thiagopari/fox_rl_model/README.md

# Fox quadruped — RL-ready model

Link-ready model of the Fox quadruped (Fusion design `Fox_Prototype_03_v6`) for reinforcement learning in **MuJoCo** and
**Isaac Sim / Isaac Lab**, with the real leg mechanism: three servos per leg, a 1:1 gear pair, a parallelogram linkage
and a foot four-bar. Generated 2026-10-06 from the design copy `Fox_Prototype_03_v6_RL` (v14). The original design was never
modified. Previous checkpoint (screw-consistent serial model): git tag `checkpoint-screw-links`.

## The leg mechanism (what each servo does)
Per leg, three DS-843MG servos sit in the hip bracket:
* **Hip servo** (servo 3, inboard): turns the whole leg about its own spline axis = abduction. The axes are tilted in the CAD:
  front (0.985, 0, −0.174), rear (0.940, 0, 0.342).
* **Pivot servo** (servo 2, "adjacent"): its spline carries the **femur** (hip axis H); it is not attached to the gear.
* **Gear servo** (servo 1, "outer", the front-most on FL): its spline carries a 12-tooth pinion that drives a 12-tooth gear on the same hip axis H
  (module 1.5 mm, centre distance 18.00 mm, so **1:1, opposite direction**; the CAD names it "15 teeth", the geometry has
  12). The gear's crank arm (H→Q1, 15 mm) moves the **Quad Link** (Q1→Q2, 75 mm) which moves the **tibia** at Q2.
  Hip–crank–Quad Link–knee is an exact **parallelogram** (femur 75.0 mm = Quad Link, crank 15.0 mm = tibia offset), so the
  shin always keeps the crank's angle.
* **Foot**: hangs from the ankle and is steered by a second loop. On the rear legs it is a parallelogram with the
  Calf Link, so the foot stays parallel to the femur. On the front legs, Component77 forms a non-parallel four-bar:
  foot angle relative to the tibia = f(knee) ≈ 0.359·knee − 0.155·knee².

Servo map (pitch angles about +y, zero = CAD stance): **thigh = pivot, knee = −gear − pivot, foot = f(knee)**. So:
* the **gear servo alone** swings the shin (and foot) about the knee, like a pendulum; with the pivot servo unpowered it
  swings the whole leg (that is what Fusion shows when you drag it);
* the **pivot servo alone** turns the femur while the shin keeps its angle: the knee bends, the leg extends/retracts;
* **pivot +a with gear −a** swings the whole leg rigidly about the hip.

| Command (body held, pivot / gear servo) | Femur | Shin | Knee | FL foot: swing / extension | RL foot: swing / extension |
|---|---|---|---|---|---|
| gear servo +0.3 (pivot holds) | -0.00 | -0.30 | -0.30 | -0.183 rad / -15.5 mm | -0.101 rad / +16.1 mm |
| pivot servo +0.3 (gear holds) | +0.30 | -0.00 | -0.30 | +0.117 rad / -15.5 mm | +0.199 rad / +16.1 mm |
| pendulum: pivot +0.3, gear -0.3 | +0.30 | +0.30 | -0.00 | +0.300 rad / -0.0 mm | +0.300 rad / +0.0 mm |

Knee range is limited where a loop would reach a dead point (pins in line, 10° margin): rear knee
[-1.2, 0.74] rad (the rear foot parallelogram folds at +0.92 rad), front ±1.2 rad (placeholder).

## Contents
| Path | What |
|---|---|
| `mjcf/fox.xml`, `mjcf/scene.xml` | **exact mechanism** for MuJoCo: 33 bodies, 32 hinges, the 8 loop pins as `<connect>`, the 4 gear pairs as joint equalities, 12 position servos (`XX_hip`, `XX_pivot`, `XX_gear`), IMU site/sensors; scene with floor |
| `mjcf/fox_reduced.xml`, `scene_reduced.xml` | the same robot as a tree (17 bodies): gear servo on a fixed tendon (−thigh − calf), foot via a four-bar joint equality; matches the exact model |
| `urdf/fox.urdf` | that tree for Isaac (URDF cannot hold loops): 17 links, 16 revolute joints; foot joints are `<mimic>` of the knee |
| `usd/fox.usd` | Isaac Sim 6.0.1 import of the URDF (foot drives zeroed, mimics kept as `NewtonMimicAPI`) |
| `isaaclab/fox_cfg.py` | Isaac Lab `ArticulationCfg` + `FoxServoActuator`: targets on hip/thigh/calf joints are the hip/pivot/gear **servo** angles; `FOX_SERVO_REAL_CFG` adds latency, backlash and the torque-speed line |
| `isaaclab/fox_sim.py` | launches the robots in Isaac Lab (GUI or headless) and drives the servos |
| `isaaclab/fox_tasks.py`, `fox_mdp.py`, `fox_train.py`, `fox_play.py` | RL walking tasks (`Fox-Velocity-Flat`, hardware-ready `Fox-Velocity-Flat-Blind`), PPO training, keyboard driving + eval |
| `deploy/fox_calib.py` | interactive servo calibration over SSH (angles, home, range, direction, channel → `servo_calib.json`) |
| `deploy/fox_pi.py` | runs a policy on the robot: Raspberry Pi + BNO055 + PCA9685, 50 Hz, keyboard over SSH; calibration modes |
| `policies/` | trained policies (`fox_flat_v1`, `fox_flat_blind_v1`…`v4` for the 1:1 robot; `fox_v7_straight_v1` for the 2:1 robot, forward / backward), each with its ONNX export and config (v7: + `policy.json`) |
| `mechanism.json` | servo map, four-bar fits, knee ranges |
| `meshes/visual`, `meshes/collision` | per-part (`XX_femur.stl`…) and per-tree-link (`XX_thigh_reduced.stl`…) meshes, metres |
| `print/FL_gear.stl` | the FL gear (CAD body "Spur Gear (15 teeth):2"), print-ready: mm, crank-arm face flat on the bed, gear centre at x = y = 0 |
| `raw/` | raw Fusion export (per-part STLs + `raw.json` with masses, inertia, 40 joints, motion links) |
| `analysis/` | hole/pin scan of the CAD (`screw_scan.json`) and the part map (`link_map.json`) |
| `tools/` | `screw_graph.py`, `build_robot.py`, MuJoCo + Isaac checks, `check_policy_io.py` (the Pi's policy interface), Fusion add-ins |
| `validation/` | reports + renders |
| `v7/`, `raw_v7/`, `print/v7_*.stl` | the v7 design (see "v7: mechanical improvements"): model folder (URDF, MJCF, meshes, `mechanism.json` with its level stance, validation), raw Fusion export, print-ready new parts |

Fusion documents (cloud, work › Default Project):
* `Fox_Prototype_03_v6` — original, untouched.
* `Fox_Prototype_03_v6_RL` — design copy with the fixes (mirrored front leg, rear gear pair, servos, restored tibias, Component77).
* `Fox_Prototype_03_v6_RL_Mechanism` — **current model**: 33 components (base + per leg hip, pinion, gear, femur, quad,
  tibia, foot, link), 40 as-built revolute joints (per leg `hip_joint`, `femur_joint` = pivot servo, `pinion_joint` = gear
  servo + 7 free pins, two of them closing the loops) and 4 motion links (pinion → gear, 1:1 reversed). Drag `XX_pinion_joint`
  to swing the leg; to see the pivot servo extend the leg, **lock `XX_pinion_joint`** (right-click → Lock) and drag
  `XX_femur_joint` — otherwise Fusion moves both servos together and the leg just swings.
* `Fox_Prototype_03_v7_RL` — **v7 design** (2026-10-08): the `_RL` copy with the mechanical improvements below; awaiting review.
* `Fox_Prototype_03_v7_RL_Mechanism` — v7 jointed model: same 40 joints, motion links pinion → gear **2:1** reversed.
* `Fox_Prototype_03_v6_RL_URDF_v2` — checkpoint: screw-consistent serial model (no gear relation).
* `Fox_Prototype_03_v6_RL_URDF` — first model, superseded; safe to delete.

## Conventions
* Frame: **x forward** (IMU end), **y left**, **z up**; base origin midway between the four hips at hip-axis height.
* Zero = the CAD standing pose for every servo and joint; the base origin is **0.1528 m** above the ground there.
* Legs FL, FR, RL, RR. Total mass **542.6 g** (no battery yet).

## Reduced tree (URDF / Isaac): joints and masses
| Joint | Parent → child | Axis | Origin in parent (m) | Limits (rad) | Effort (N·m) |
|---|---|---|---|---|---|
| FL_hip_joint | base → FL_hip | (0.985, 0, -0.174) | 0.071686 0.024238 0.007390 | -0.50 … 0.50 | 0.470 |
| FL_thigh_joint | FL_hip → FL_thigh | +y | 0.013073 0.017273 -0.002610 | -1.20 … 1.20 | 0.940 |
| FL_calf_joint | FL_thigh → FL_calf | +y | -0.026269 0.000000 -0.070249 | -1.20 … 1.20 | 0.470 |
| FL_foot_joint | FL_calf → FL_foot | +y | 0.005365 0.002750 -0.067459 | -3.14 … 3.14 | 10.000 |
| FR_hip_joint | base → FR_hip | (0.985, 0, -0.174) | 0.071686 -0.024262 0.007390 | -0.50 … 0.50 | 0.470 |
| FR_thigh_joint | FR_hip → FR_thigh | +y | 0.013073 -0.017248 -0.002610 | -1.20 … 1.20 | 0.940 |
| FR_calf_joint | FR_thigh → FR_calf | +y | -0.026269 0.000000 -0.070249 | -1.20 … 1.20 | 0.470 |
| FR_foot_joint | FR_calf → FR_foot | +y | 0.005365 -0.002750 -0.067459 | -3.14 … 3.14 | 10.000 |
| RL_hip_joint | base → RL_hip | (0.940, 0, 0.342) | -0.073606 0.024238 -0.000351 | -0.50 … 0.50 | 0.470 |
| RL_thigh_joint | RL_hip → RL_thigh | +y | -0.012394 0.017273 -0.004429 | -1.20 … 1.20 | 0.940 |
| RL_calf_joint | RL_thigh → RL_calf | +y | 0.038069 0.001750 -0.064620 | -1.20 … 0.74 | 0.470 |
| RL_foot_joint | RL_calf → RL_foot | +y | -0.052566 0.001000 -0.053496 | -3.14 … 3.14 | 10.000 |
| RR_hip_joint | base → RR_hip | (0.940, 0, 0.342) | -0.073382 -0.024238 -0.000188 | -0.50 … 0.50 | 0.470 |
| RR_thigh_joint | RR_hip → RR_thigh | +y | -0.012618 -0.017522 -0.004593 | -1.20 … 1.20 | 0.940 |
| RR_calf_joint | RR_thigh → RR_calf | +y | 0.038069 -0.001500 -0.064620 | -1.20 … 0.74 | 0.470 |
| RR_foot_joint | RR_calf → RR_foot | +y | -0.052566 -0.001000 -0.053496 | -3.14 … 3.14 | 10.000 |

| Link (URDF) | Parts | Mass (g) |
|---|---|---|
| base | base | 330.4 |
| FL_hip | hip, pinion, gear | 34.4 |
| FL_thigh | femur, quad | 7.5 |
| FL_calf | tibia, link | 7.8 |
| FL_foot | foot | 2.5 |
| FR_hip | hip, pinion, gear | 34.4 |
| FR_thigh | femur, quad | 7.5 |
| FR_calf | tibia, link | 8.2 |
| FR_foot | foot | 2.5 |
| RL_hip | hip, pinion, gear | 34.9 |
| RL_thigh | femur, quad | 7.8 |
| RL_calf | tibia, link | 7.4 |
| RL_foot | foot | 3.1 |
| RR_hip | hip, pinion, gear | 36.4 |
| RR_thigh | femur, quad | 7.7 |
| RR_calf | tibia, link | 7.0 |
| RR_foot | foot | 3.0 |

Parts of one leg in the exact model (`mjcf/fox.xml`):

| Part (MJCF body) | Mass (g) |
|---|---|
| base | 330.45 |
| FL_hip | 29.64 |
| FL_pinion | 2.28 |
| FL_gear | 2.52 |
| FL_femur | 4.89 |
| FL_quad | 2.61 |
| FL_tibia | 5.49 |
| FL_foot | 2.52 |
| FL_link | 2.35 |

## How the CAD maps to parts
Membership follows the fasteners (`tools/screw_graph.py` on a scan of every hole, pin and spline): parts that share a
screw line, or sit on a servo's output spline, are one rigid part; leg-linkage pins and spline axes are pivots.
* **base**: both pelvis halves, Pi mount, Raspberry Pi 4, 12-ch PWM board, 2× XL4015, Arduino Nano, BNO055, the bodies of
  the 4 hip servos, and everything screwed to them.
* **XX_hip**: the bracket riding on the hip-servo spline (front `Servo Pelv Upper/Lower(Mirror)`, rear left `Servo Pelv
  Upper`, rear right `Component40/41(Mirror) (1)`), rear caps `Body28`/`Body29` (+ `Body27`, by contact), both servo cases.
* **XX_pinion**: gear-servo spline + `m` gear. **XX_gear**: the 12-tooth gear with its crank arm.
* **XX_femur**: femur + pivot-servo spline + the gear's spacer and washer (clamped by the horn screw `Body4`, rear left).
* **XX_quad**: Quad Link. **XX_tibia**: tibia + knee pin (`Body2` rear left). **XX_foot**: foot + pad.
  **XX_link**: Component77 (front) / Calf Link (rear).
* In the tree model: hip = hip + pinion + gear, thigh = femur + Quad Link, calf = tibia + link, foot = foot.

## Modelling decisions (review)
1. **Abduction axis** = the hip-servo spline axis measured from the CAD (tilted 10° front / 20° rear from +x).
2. **Rear brackets un-joined**: `Combine1`/`Combine2` of `Component41(Mirror) (1)` and `Combine2` of `Servo Pelv Upper` join
   both rear brackets into the pelvis in the design copy; the builders suppress them **in memory only**.
3. **Limits are placeholders**: servos ±1.2 rad (hip ±0.5), knee capped by the loop dead points (above). Measure the real
   servo travel (DS-843MG ~±60°) and mechanical stops.
4. **Actuators**: DS-843MG at 6 V, 0.47 N·m stall, 10.5 rad/s; PD kp 5.0 / kd 0.08 per servo (a hobby servo reaches
   stall within ~5° of error), armature 5e-4 (estimate). The first guess, kp 2.0, was too soft: randomized robots tipped
   over just standing. The robot sags 4.7 mm when standing. Replace with bench-test values (step response) before
   sim-to-real.
5. **Isaac foot mimic** is the linear part of the four-bar: exact on the rear; front error 0.015 rad within ±0.3 rad of
   knee motion, 0.06 rad at ±0.6, 0.27 rad at ±1.2 (the MuJoCo models use the full quartic).
6. **Battery**: hidden in the CAD, not modelled. Add its mass to `base` when known.
7. **No joint damping/friction/armature in the URDF** (Isaac's importer writes URDF damping into the per-degree USD
   field); they live in `isaaclab/fox_cfg.py` and the MJCF defaults. The URDF thigh effort limit is 0.94 N·m (= pivot −
   gear torque) so PhysX does not clip the mapped torque.
8. **Loops in MuJoCo** use near-hard constraints (`solimp 0.999`): with the default the 2–3 g linkage parts let the pins
   gap 2 mm under load.

## Use
* **MuJoCo** (exact): `~/.venvs/fox_rl/bin/python -m mujoco.viewer --mjcf ~/Documents/fox_rl_model/mjcf/scene.xml`.
  Actions = 12 servo targets (`XX_hip`, `XX_pivot`, `XX_gear`), i.e. what the real servos get. Ramp large changes: a
  step on all 12 servos saturates them together and the robot can hop and flip.
* **Isaac Sim** (`~/isaacenv`, 6.0.1): `OMNI_KIT_ACCEPT_EULA=YES ~/isaacenv/bin/python tools/isaacsim_import.py`, then
  `tools/isaacsim_stand_test.py` (servo PD applied with `set_dof_efforts`, two robots: standing + bolted in the air).
* **Isaac Lab** (installed: `~/IsaacLab`, tag `v3.0.0-beta2.patch1` = the release for Isaac Sim 6.0.1, pip-installed
  into `~/isaacenv` with torch 2.11+cu130 kept): `~/isaacenv/bin/python isaaclab/fox_sim.py --viz kit` opens the viewer
  with 4 robots, one servo motion each (crouch, sway, pendulum swing, shin swing); `--headless --duration 10` for a quick
  check. In your own tasks: `from fox_cfg import FOX_CFG`; joint position actions on `.*_hip_joint`, `.*_thigh_joint`,
  `.*_calf_joint` are servo targets (hip, pivot, gear); `FoxServoActuator.servo_angles()` gives the servo angles from
  joint angles for observations. Velocity task: base `base`, feet `.*_foot`, undesired contacts `.*_thigh|.*_calf`,
  small commands (≈0.3 m/s), target height ~0.14 m. Notes for this laptop (8 GB GPU): Isaac Lab 3.0 runs headless
  unless `--viz kit` is given; keep the Kit window small (full screen at 3200x2000 renders ~1.7 s/frame — the script
  defaults to 1280x800); the first GUI launch compiles shaders for minutes; close other GPU apps (Fusion) if RTX runs
  out of memory; PhysX GPU buffers are shrunk in `fox_sim.py` (the defaults reserve ~1 GB); don't switch "Simulation
  Output" to USD in the GUI (deadlocks Isaac Sim 6.0.1).
* Hardware: send pivot = thigh, gear = −thigh − knee (radians from the stance, then your servo's zero/scale/direction).

## RL walking + keyboard teleop (Isaac Lab)
* Task `Fox-Velocity-Flat` (`isaaclab/fox_tasks.py`): Isaac Lab's quadruped velocity task (Go1 recipe) on flat ground,
  re-scaled for this robot: actions = the 12 servo targets (±0.25 rad around the stance), commands vx ±0.3 m/s,
  vy ±0.2 m/s, yaw ±1 rad/s, 50 Hz policy / 200 Hz physics, mass +0.2 kg / COM / friction / push randomization.
  Changes that made it learn: a fall penalty + small alive bonus, a 10× smaller joint-acceleration penalty (the 2–3 g
  links accelerate a lot), initial action noise 0.5 (1.0 knocks the robot over in 0.5 s), stiffer servos (above).
* Train (headless, ~15 min for 1000 iterations on this laptop, 2048 robots):
  `cd ~/Documents/fox_rl_model && ~/isaacenv/bin/python isaaclab/fox_train.py --task Fox-Velocity-Flat --headless`
  → `logs/rsl_rl/fox_flat/<date>/model_*.pt` (TensorBoard: `logs/rsl_rl/fox_flat`).
* Hardware-ready task `Fox-Velocity-Flat-Blind`: the policy sees only what the robot has (IMU gyro + gravity direction,
  the remote's command, its own last servo commands, 5-step history); the critic sees the full state (training only).
  Gait rewards: action-rate penalty, diagonal trot (Spot's `GaitReward`), Spot's `air_time_reward` (each foot phase
  ~0.15 s; zero command = all feet down, even when drifting). `fox_train.py --task Fox-Velocity-Flat-Blind --headless`, ~30 min.
* Since v3 the blind task (training, play and eval) uses realistic servos, `FOX_SERVO_REAL_CFG`, each drawn at random
  per robot and episode:
  * 5–25 ms command latency (Pi → PCA9685 at 50 Hz → servo, sensor lag included);
  * backlash up to 0.02 rad on the hip and pivot servos, and 0.15 rad on the gear servo. On RR, measured 2026-10-08 with
    `deploy/fox_leg_modes.py`, the gear servo turns 10–15° before the shin moves (about ±6° of play, from the gear pair,
    horn and linkage pins). Policies trained before then (v1–v4) saw only 0.04 rad;
  * torque that falls linearly from the stall torque at rest to zero at the no-load speed (DS-843MG: 0.47 N·m, 10.5 rad/s);
  * servo gains off by up to ±20 % (kp) and ±30 % (kd).

  These are estimates: put bench-test values into `fox_cfg.py`. The ideal servo (`FOX_SERVO_CFG`) stays in `Fox-Velocity-Flat`.
* Since v4, forward / backward / standing commands (no sideways, no turning) leave the hips alone: the hip servo targets
  are held at the stance (`fox_mdp.FoxServoAction`; `deploy/fox_pi.py` applies the same rule), and the policy observes
  them as sent. 30 % of training commands are straight (`fox_mdp.FoxVelocityCommand`; uniform sampling never gives
  exact zeros). v4 = v3 fine-tuned under this rule for 1000 iterations (plateaued after ~300).
* Drive: `~/isaacenv/bin/python isaaclab/fox_play.py --checkpoint policies/fox_flat_blind_v4/model_2998.pt` → click the
  viewport, hold W/S (forward/back), A/D (sideways), Q/E (turn), L = stop; the camera follows the robot. For v1 add
  `--task Fox-Velocity-Flat-Play`. `--eval --headless --num_envs 16` prints commanded vs achieved velocities instead.
  It also exports `exported/policy.onnx` next to the checkpoint (for the Pi).
* Policies (`policies/*`: `model_*.pt`, `policy.onnx` for the Pi, `params/` = exact env + agent config), `--eval` results
  (16 robots, 7 commands × 4 s, mean |error| over the last 2 s of each):

  | Policy | Policy sees | Eval servos | Error vx / vy / yaw | Servo-command change | Swing | At zero command |
  |---|---|---|---|---|---|---|
  | `fox_flat_v1` | joint encoders + body velocity | ideal | 0.008 / 0.008 m/s / 0.014 rad/s | 0.082 rad/step | 0.072 s | steps 3.4/s, holds position |
  | `fox_flat_blind_v1` | IMU only | ideal | 0.011 / 0.019 / 0.027 | 0.067 | 0.075 s | marches 7.4/s, drifts 8 cm/s |
  | `fox_flat_blind_v2` | IMU only | ideal | 0.006 / 0.007 / 0.037 (under-turns 12 %) | 0.059 | 0.107 s | stands (1.4 steps/s, 0.2 cm/s) |
  | `fox_flat_blind_v2` | IMU only | realistic | 0.016 / 0.010 / 0.042 (0.3 → 0.26 m/s, 0.8 → 0.68 rad/s) | 0.059 | 0.104 s | stands (2.3 steps/s) |
  | `fox_flat_blind_v3` | IMU only | realistic | 0.008 / 0.006 / 0.025 (0.3 → 0.27 m/s, 0.8 → 0.83 rad/s) | 0.042 | 0.132 s | stands (0.5 steps/s, 0.2 cm/s) |
  | **`fox_flat_blind_v4`** | IMU only | realistic, hips held when straight | 0.023 / 0.006 / 0.026 (0.2 → 0.16, 0.3 → 0.23 m/s; 0.8 → 0.79 rad/s) | 0.040 | 0.137 s | stands (0.7 steps/s) |
  | **`fox_v7_home_v1`** (2:1 robot, around home) | IMU only | realistic, hips always held | 0.020 m/s / – / 0.042 (forward / backward only: 0.2 → 0.203, 0.3 → 0.247, −0.2 → −0.218 m/s) | 0.094 | 0.112 s | shuffles in place (3.1 steps/s) |
  | `fox_v7_straight_v1` (2:1 robot) | IMU only | realistic, hips always held | 0.025 m/s / – / 0.019 (forward / backward only: 0.2 → 0.175, 0.3 → 0.247, −0.2 → −0.219 m/s) | 0.069 | 0.100 s | shuffles in place (2.4 steps/s, 6 mm lifts, ≤ 2 cm drift in 4 s) |

  No policy fell in any eval. `fox_v7_straight_v1` is scored on its four straight commands (`fox_play.py --eval` skips
  what a task does not train). Why each version changed:
  * Blind v1 trotted at 7 Hz. The trot term's timing error is in seconds, so short phases score best, and its
    step-length term was mostly silent (bug below).
  * v2's first try drifted at 0.13 m/s at zero command, just above the 0.1 m/s "moving" threshold, to keep the
    walking rewards. The threshold is now 1.0 m/s.
  * v3 was trained on realistic servos with a tighter yaw term (weight 1.0, std 0.3), for 2000 iterations.
  * v4: when walking straight, the hip target is exactly 0 and the hip joint moves ≤ 0.043 rad (gear play and the
    servo yielding under load). The cost: forward is ~20 % slower than v3. v3 with the hips simply locked made only
    0.09 m/s at 0.2 and fell 9 times.
  * The top speed of about 0.27 m/s is the speed-limited servos: v2 loses 15 % of its speed on them.
* Running a blind policy on the Pi (`policy.onnx`, 105 inputs → 12 outputs, no input normalization):
  * Observation: for each term, its last 5 readings, oldest first, terms in this order:
    * `[0:15]` gyro (rad/s);
    * `[15:30]` gravity direction as a unit vector, (0, 0, −1) standing level. An accelerometer or the BNO055 gravity
      output reads +z when level, so negate and normalise it;
    * `[30:45]` command (vx, vy m/s, yaw rate rad/s);
    * `[45:105]` the policy's own previous 12 outputs.
  * Frames are body frame: x forward, y left, z up (rotate the IMU's axes into it). At start, fill the history with
    the first reading 5 times.
  * Outputs: servo target = 0.25 × output (rad from the CAD stance), in this order: hip FL, FR, RL, RR, then pivot
    FL…RR, then gear FL…RR. Then apply each servo's zero, direction and µs/rad.
  * When the command has no sideways or turn part, the hip outputs are set to 0 (v4 on). That applies both to what is
    sent and to what goes into the observation history.
  * `deploy/fox_pi.py`'s `FoxPolicy` implements exactly this. `tools/check_policy_io.py <model.pt>` runs it closed
    loop in Isaac Lab: the sim supplies the readings and FoxPolicy's outputs drive the robot. For v4: identical
    observation, ONNX = PyTorch within 3.6e-7, and it walks 0.17 m/s (cmd 0.2) and turns 0.59 rad/s (cmd 0.6).
* Isaac Lab 3.0-beta2 bug: `ContactSensor.compute_first_contact` never fires 2–16 s into an episode (float32 sensor time
  vs a 1e-8 tolerance), so the stock `feet_air_time` reward (still in `Fox-Velocity-Flat`) is silent most of each
  episode. The blind task uses `air_time_reward` instead, and `--eval` counts touchdowns from contact-state changes.
* Body names: feet `.*_foot`, undesired contacts `.*_thigh|.*_calf`; the USD's bodies are flattened (Isaac Lab's
  contact sensor only sees direct children of one parent; the Isaac Sim 6 importer nests them).

## On the robot (Raspberry Pi)
Status: verified only against the simulator (`tools/check_policy_io.py`); it has not run on the Pi or the servos yet.
0. **Setup, once:**
   * **OS:** 64-bit Raspberry Pi OS (`uname -m` prints `aarch64`), which has onnxruntime wheels. Without
     onnxruntime the script falls back to `onnx`'s slower reference evaluator.
   * **I2C:** enable it (`sudo raspi-config` → Interface Options → I2C). `i2cdetect -y 1` must show `28` (BNO055)
     and `40` (PCA9685).
   * **Python:** the environment `~/robofox_leg_imu_calibration.py` ran in (Blinka, `adafruit-circuitpython-pca9685`,
     `-bno055`, `-motor`), plus `pip install numpy onnxruntime`. On Bookworm, use a venv:
     `python3 -m venv --system-site-packages ~/fox`.
   * **Power:** the servos get their own 6 V supply into the PCA9685's V+ terminal, never the Pi's 5 V pin. Budget
     about 1 A per servo at peak, and share ground with the Pi. The policy was trained on the 6 V torque and speed;
     brown-outs reset the Pi and the PCA9685.
   * **Copy:** `scp deploy/fox_pi.py policies/fox_flat_blind_v4/policy.onnx policies/fox_flat_blind_v4/policy.onnx.data
     pi@<pi>:~/fox/`. The `.data` file must sit next to the `.onnx`, and so must `policy.json` for policies that have
     one. Give each policy its own folder.
   * **policy.json** (written by `isaaclab/fox_play.py` with the ONNX) is the policy's contract:
     * servo target = offset + scale × output, per servo;
     * the gear ratio it was trained for: `fox_pi.py` refuses to run it on a robot whose `servo_calib.json` says
       otherwise;
     * its command ranges: the keyboard stays inside them, so the forward / backward policy only takes W/S.

     Policies without one (v1–v4) mean 0.25 × output around home, 1:1 gears.
   * **Smoke test:** `python3 fox_pi.py policy.onnx --dry-run` (no hardware) must report 0 steps over the 20 ms budget.
     On the robot it prints the same count. If the servo writes push the loop over budget, the I2C bus is too slow.
   * **v7 (2:1 robot):** `scp policies/fox_v7_home_v1/{policy.onnx,policy.onnx.data,policy.json} fox-wifi:fox/v7_home/` (the
     home-centred policy; `fox_v7_straight_v1` is in `~/fox/v7_straight/`). Re-level the IMU after rebuilding the casing
     (`fox_pi.py <policy> --level-imu 5`, body level and still). A 15° stale reference made the first ground run read
     8.8° nose-up, and the policy then held instead of stepping.
     Run `fox_calib.py --gear-ratio 2` once (done 2026-10-09). Then hold the robot and run
     `ssh -t fox-wifi 'cd ~/fox && venv/bin/python fox_pi.py v7_straight/policy.onnx'`:
     * W / S step the forward command by 0.05 m/s (±0.3), space stops, Ctrl-C goes limp. In the sim, 0.05 / 0.1 /
       0.15 give 0.038 / 0.093 / 0.137 m/s; backward overshoots at low speed (−0.05 gives −0.095). The legs step about 5
       times a second at any speed;
     * at start it waits for steady IMU readings, ramps the servos from home to the v7 stance over 1 s (rear legs ~25°
       back), and waits again;
     * IMU glitches are filtered: a reading that rotates faster than 15 rad/s, or turns gravity more than 30° in one
       step, is replaced by the last good one, at most twice in a row. On the stand the BNO055 gave single 35.6 rad/s
       and upside-down readings amid level ones, likely servo current spikes resetting its fusion. The run's last line
       counts them;
     * `fox_pi.py` refuses a stance a servo can't reach, and warns when a training range runs past 0 / 180°;
     * add `--seconds 20 --log run.csv` for a timed, logged run.
1. **Calibrate** with `fox_calib.py`, an interactive tool: `ssh -t fox-wifi 'cd ~/fox && venv/bin/python fox_calib.py'`.
   * **Moving:** select a servo, then arrows move it ±1° (A/D ±5°) and `g` types an exact angle.
   * **Recording:** `h` sets home (the CAD stance), `<` and `>` the safe range, `r` the direction, `#` the channel.
   * **Saving:** everything goes to `servo_calib.json` next to `fox_pi.py`, which loads it at start.
   * **Safety:** all servos are limp at start and on quit, and a servo's first move goes to its saved home.

   Hips: don't assume 90°. The RL hip's 90° was past its outward stop. The steps below fill in the same values:
   * `--check-imu`: fix `IMU_TO_BODY` until level reads gravity (0, 0, −1), nose down gives x > 0, left side down
     gives y > 0, and turning left gives gyro z > 0. The default assumes the January script's upside-down mount.
     The gyro must read rad/s: about one turn per second by hand should show ~6, not ~360 (old adafruit_bno055
     releases used deg/s). Frequent "no IMU reading" errors mean the BNO055's clock stretching is failing: lower the
     bus speed (`dtparam=i2c_arm_baudrate=50000` in `/boot/firmware/config.txt`).
   * `--wiggle FL_hip` (and the other 11), with the robot held in the air: if the wrong servo moves, fix `CHANNEL`
     (the hip/pivot/gear order inside each leg's block is a guess); if it moves the wrong way, fix `DIRECTION`. The
     script prints which way + should go.
   * `NEUTRAL_DEG`: the servo angle that puts each joint at the CAD stance. Legs in vertical planes; femur (hip pivot
     → knee) −20.5° front / +30.5° rear from straight down (+ = knee forward); shin (knee → ankle) +4.5° front /
     −44.5° rear. Check `DEG_PER_RAD` (servo travel per µs) and `LIMIT_DEG` (safe travel).
2. **Walk**: hold the robot (the servos jump to the stance at start), run `python3 fox_pi.py policy.onnx`, put it
   down. W/S, A/D, Q/E step the command by 0.1 m/s / 0.1 m/s / 0.5 rad/s; space = stop; Ctrl-C = limp. It also
   stops (limp) if tilted past 60°. It prints how many 50 Hz steps ran over budget.
3. **Bench values for the simulator** (then retrain with `fox_train.py --task Fox-Velocity-Flat-Blind --headless`):
   * speed: film `--wiggle FL_gear --amplitude 1.0` at 240 fps; 1 rad ÷ the travel time → `velocity_limit`;
   * backlash: servos holding the stance, rock each leg by hand; play at the knee or foot ÷ 75 mm → `backlash`;
   * latency: keep 5–25 ms unless measured;
   * all three go in `isaaclab/fox_cfg.py` (`FOX_SERVO_CFG` / `FOX_SERVO_REAL_CFG`).

## v7: mechanical improvements (review before use)
The servos stalled when the robot readjusted on the ground. v7 (`Fox_Prototype_03_v7_RL`, made by
`tools/fusion/FoxMakeV7`, which never saves the source) changes three things:
* **2:1 gear-servo drive.** The 12T m1.5 pinion / 12T gear pair becomes a **12T pinion → 24T crank gear**:
  * module 1.0, 20°, profile shift +0.3 / −0.3, so the 12T pinion does not undercut;
  * same 18.00 mm centres, face width 6.7 mm;
  * teeth 0.1 mm thin for print backlash (0.2 mm total), contact ratio 1.46.

  Outlines come from `tools/gear_profile.py` (rack-generated, checked by rolling the pair at 2:1). The crank arm, bores
  and hub are unchanged; the gear teeth start 0.3 mm above the gear plate, like the pinion's, to clear the pinion hub.
  The gear servo now needs 2× the angle for the same shin motion. Its torque on the crank doubles, while the shin's speed
  and range halve: ±90° of servo → ±45° of shin.
* **Rear hips 18.8 mm higher.** The rear module moves 20 mm up the two rear pelvis screws, which are 20° from vertical
  (+18.8 mm up, 6.8 mm back). It sits on a printed **spacer** between the pelvis flange and the plate tab:
  * 25 × 8.9 × 20.2 mm, two Ø3.2 holes;
  * the two screws need to be **20 mm longer**;
  * the rear module is the rear pelvis, rear legs and servos, and the PWM board and XL4015 that sit on it.

  The rear legs reach down to stand level, which shortens their lever arms.
* **Rear hip brackets un-fused.** Three Combine features (the same ones the mechanism build always suppressed in memory)
  are suppressed, because the brackets turn with the hip servos. The rear pinions are turned 14.9° about their own axis
  so the rear gear pairs mesh too.

* **The crank gear turns only with its pinion** (design version 2, `tools/fusion/FoxV7FreeGear`). Each gear runs on a
  **623ZZ ball bearing** (3 × 10 × 4 mm), the "disk" in the gear's centre, now named `623ZZ bearing L/R`. The horn screw
  and washer clamp the bearing's inner ring to the femur hub, so the femur can only drag the gear if that bearing locks or
  is a plain printed disk. v6 allowed both:
  * the hub's Ø6 end face is wider than the inner ring (≈Ø5.2), so tightening the screw also pressed the shield/outer
    ring. v7 keeps a Ø4.4 boss and relieves the ring around it by 0.3 mm (all 4 femurs);
  * the gear's seat was Ø10.2, loose on the Ø10 outer ring. v7 has a Ø10.0 press fit.

  Fusion checks: every gear sits on its bearing without overlap, and no gear comes within 0.7 mm of its femur.

  **Retrofit on the current robot:** fit a real 623ZZ, not a printed disk. Shave the femur hub's end to a Ø4–4.5 boss,
  about 0.3 mm proud, or reprint `print/v7_femur_*.stl`. Press the bearing into the gear.

  In Fusion's mechanism document, dragging a femur still turns the gear unless `XX_pinion_joint` is locked. That is
  Fusion's solver closing the leg loop (a back-drivable, unpowered gear servo), not friction. The models apply servo
  torques only, with no friction coupling.

  The mechanism document and the v7 URDF/MJCF come from design version 1. This change moves no joint and changes masses
  by under 0.02 g, so they stay valid. Re-run `FoxScrewScan` before rebuilding the mechanism: the bearing bodies were
  renamed.

**The sim model `v7/` is the robot as it will be built: without the rear spacer** (no longer screws).
* It is the v6 export (base, legs, every joint) with the 8 v7 gear and pinion parts, the 2:1 motion links and the v7
  pinion range, derived by `tools/raw_v7_without_spacer.py` into `raw_v7_nospacer/`.
* The design `Fox_Prototype_03_v7_RL` has the spacer (its renders are in `v7/validation/cad/`).
* **The as-built CAD is `Fox_Prototype_03_v7b_RL` + `Fox_Prototype_03_v7b_RL_Mechanism`.** It was made by `FoxMakeV7`
  with `tools/fusion/v7b/make.json`: v6 geometry (no spacer), the 2:1 gears, the printed-bushing gear seat (Ø10.4) and
  the femur hub relief, plus the M4 casing holes. The bushings are named `printed bushing L/R` and move with the femur.
  * Checks in `v7/validation/cad_v7b/`: all 43 CAD checks pass, with tooth overlap 0 mm³ and every edit's volume
    exact; 40 joints + 4 motion links.
  * Drive tests: gear = −pinion / 2 and both parallelograms hold (worst 5.5e-5 rad). The model is 543.9 g, against
    544.5 g for the derived sim model.
  * To try it in Fusion, drive `XX_pinion_joint` to see the 2:1 drive. Lock `XX_pinion_joint`, then drive
    `XX_femur_joint`: the gear holds still and the knee bends.
* `tools/build_robot.py --raw raw_v7 --out <dir>` rebuilds the spacer version.

**Stance:** base level, each foot where its worst pitch servo's static load is lowest, with the force where the foot
really stands. A tilted sole stands on its lower edge, a flat one on its whole length (`build_robot.sole_contact`). The
rear foot stays parallel to the femur, so it tilts with the rear pivot servo.

| Leg | foot vs hip | sole | pivot servo | gear servo |
|---|---|---|---|---|
| front | 22.0 mm ahead | heel edge, tilted 6.0° | −9.7° | +13.8° |
| rear | 35.1 mm behind | toe edge, tilted 25.7° | +25.7° | −49.6° |

Set in `v7/mechanism.json`. The servo angles are from the CAD pose (the homes); they are the policy's zero action.
`MAX_FOOT_TILT` (`tools/build_robot.py`) caps the tilt. It costs servo margin: a 25 / 20 / 15° cap gives a worst servo
of 43 / 55 / 66 % (41 % uncapped), so it is left at a sanity bound of 30°.

Servo load (`tools/servo_load.py`; trot: 0.75 kg on 2 feet × 1.5), as a share of the 0.47 N·m stall torque:

| | Worst servo | Front pivot / gear | Rear pivot / gear |
|---|---|---|---|
| v6, CAD pose | 90 % | 43 % / 51 % | 90 % / 62 % |
| v6, best level stance | 75 % | 39 % / 41 % | 75 % / 75 % |
| **v7 without the spacer (the sim model), its stance** | **41 %** | 26 % / 26 % | 41 % / 41 % |
| v7 with the spacer, its stance | 36 % | 26 % / 26 % | 36 % / 36 % |

(Before 2026-10-09 the force sat at the sole's centre fixed in its CAD position, which a tilted foot doesn't stand on:
72 / 40 / 34 %.) Standing still in MuJoCo (0.54 kg, 4 feet), the worst servo goes from 23 % (v6) to 10 % (v7).

**Checks:**
* Fusion, the CAD design with the spacer (`v7/validation/cad/`):
  * tooth overlap 0.0 mm³ on all 4 legs;
  * every rear body moved by exactly the lift and nothing else moved, with no new interference;
  * the spacer is seated on both faces;
  * 40 joints + 4 motion links healthy; the drive tests give gear = −pinion / 2 and keep both parallelograms (worst
    5.5e-5 rad).

  `rear_stack_section.png` shows pelvis, spacer and plate on the screw axis; `v7_*.png` are Fusion renders.
* MuJoCo, the sim model without the spacer (`v7/validation/`):
  * stands level at its stance (upright 1.0000, all feet down);
  * servo roles at 2:1;
  * the reduced tree matches the exact mechanism within 7 µm;
  * pose test and 20 s of random actions pass.

**In Isaac Lab** (approved 2026-10-09):
* `FOX_MODEL=v7 OMNI_KIT_ACCEPT_EULA=YES ~/isaacenv/bin/python tools/isaacsim_import.py` wrote `v7/usd/fox.usd`.
* `Fox-V7-Velocity-Flat-Blind` and `Fox-V7-Velocity-Flat-Blind-Straight` use it (`isaaclab/fox_cfg.py`
  `fox_model_cfg()`): ratio 2, the stance as reset pose, and its servo angles as action offsets.
* The gear servos' actions are scaled 0.5 rad (0.25 × the ratio), so an action moves the shin as much as at 1:1.
* The gear servo's reflected rotor inertia scales with the ratio, as its damping does (`fox_cfg.geared`: thigh
  (1 + N²)·I, calf N²·I).
  * Without that, the explicit servo damping outran the 200 Hz physics: the 2:1 gear servo chattered at 100 Hz, and
    the first v7 training run blew up at iteration 1100.
  * `tools/check_servo_chatter.py` checks it.
  * This is a diagonal approximation: exact for the pendulum and for the gear servo alone, 9× too heavy for the pivot
    servo alone.
* `-Straight` is forward / backward only (vx ±0.3 m/s, no sideways or turning), so the hips always hold the stance. It
  is for the first runs without hip servos.
* `-Home` (2026-10-10) is `-Straight` around home, the CAD pose, instead of the v7 stance. It resets at home, its zero
  output is home, and the stance penalty pulls toward home. On the robot home stands steadier, and the v7 stance did not
  hold under the weight.
  * `fox_v7_home_v1` stands within 3–5° of home on the pivots (body 0.140 m, home 0.152).
  * From a dead-still, level IMU it steps at once: at 0.05 m/s, pivots swing 15–20° and gears 25–59°.
    `fox_v7_straight_v1` commanded only 1–4° on the robot when its IMU read 8.8° nose-up.
* Servo targets are clamped where the robot can follow (`actions.joint_pos.clip`, rad from home): hips ±0.5, pivots
  ±50° (`fox_pi.py`'s default range), gear servos ±90° (their travel with home at 90°). `policy.json` carries the limits
  to the Pi.
* Spot's joint position penalty holds the stance (weight −0.2, 5× when commanded to stand). Without it, the policy
  stood crouched 33 mm low with the rear gear servos parked on their −90° clamp.
* `fox_play.py --eval` reports the standing posture (body height, targets vs the stance) and how often a target sits
  on its clamp. `fox_v7_straight_v1`:
  * stands at 0.143 m (stance 0.151);
  * targets within 2–6° of the stance at the front and 9–15° at the rear;
  * 0.0 % of servo-steps on a clamp.

On the robot:
* print `print/v7_crank_gear_24T.stl` (4) and `v7_rear_hip_spacer.stl` (1). The spacer has M4 clearance holes (Ø4.6);
* print `print/v7_middle_casing.stl`, the Pi casing (`raspberry_pi_mount`). Its 4 pelvis screw holes are M4 clearance
  holes (Ø4.6, along the tilted screw axes: 10° at the front, 20° at the rear). It prints with the Pi deck on the bed.
  * Screw stacks: front 13.5 mm (casing tab, pelvis flange), so M4×16 fits; rear 33.2 mm with the spacer, so M4×35.
  * Both thread into the pelvis flange. Its CAD holes are Ø2.8: open them to ~Ø3.4 for an M4 self-tap, or Ø4.6 for a
    through-bolt with a nut (rear M4×40).
  * `Fox_Prototype_03_v7b_RL` has these holes. The spacer design `Fox_Prototype_03_v7_RL` still has the old Ø2.8 ones.
* print `v7_pinion_12T.stl` (4). It carries Thiago's servo-horn interface (4 hooks and the cross-horn pocket under a 0.3 mm
  plate, from `~/Downloads/Gear modified (1).stl`), so the servo's own cross horn drives it instead of a printed spline. The
  teeth are the new 12T m1.0 ones, with his Ø2 hole and Ø6.4 counterbore. It prints teeth-down;
* print the femurs: `v7_femur_front_1/_2.stl` and `v7_femur_back.stl`, plus `v7_femur_back_mirrored.stl` for the other
  side. These are his modified femurs (horn pocket at the hip, `~/Downloads/Femur modified 1/2.stl`,
  `Femur Back Modified.stl`), unchanged except the 0.3 mm bearing relief on the hip hub. They print pocket face down;
* the gear runs on a 623ZZ (buy 4) or on a printed bushing (no bearings):
  * **623ZZ:** `v7_crank_gear_24T.stl`, whose Ø10.0 seat is a press fit on the bearing's outer ring.
  * **Printed bushing:** `v7_crank_gear_24T_printed_bushing.stl` + `v7_bushing_10x3x4.stl` (4 each).
    * The gear's seat is a Ø10.4 running fit on the Ø10.0 bushing.
    * Its inner lip ends 0.3 mm below the clamped bushing, so the horn screw clamps only the bushing to the femur and can
      never pinch the gear.
    * Print the bushing upright, solid, in PETG/nylon if possible (PLA works).
    * Grease it or use PTFE dry lube. With the screw tight, the gear must spin freely by hand; if not, sand the bushing.
    * A plain bushing still drags a little: about 5 % of a servo's stall torque at full load.
  * Never put a printed bushing in the press-fit gear: that locks the gear to the femur.
* the rear spacer needs M4×35 screws (M4×16 is too short for its 33 mm stack). Without it: v6 geometry + 2:1 gears + the
  min-load stance gives a worst servo of 40 % of stall, against 34 % with the spacer and 72 % for v6 today
  (`tools/servo_load.py`).
* after fitting the 2:1 gears:
  * record them with `fox_calib.py --gear-ratio 2`. `fox_pi.py` refuses a policy trained for another ratio, widens the
    gear servos' default range to ±100°, and its `--stand` / `--balance` leg IK uses the ratio;
  * recalibrate the homes to the CAD pose (`h`). At the v7 stance the rear gear servos sit 49.6° from home, so mesh
    the teeth with that in mind: a gear servo whose home is at 90° stands at 40° / 140°;
  * save a new stand pose (`S`) if `--stand` / `--balance` should use one.

## Regenerate
Each `tools/fusion/*` folder is a one-shot add-in: copy it into Fusion's `API/AddIns`, start Fusion, wait for its result
in `C:\fusion_jobs` (`drive_c/fusion_jobs` in the Wine prefix), then remove the folder again (it runs at every start).
`tools/fusion/run_addin.sh <add-in folder> <result file> [document to wait for]` does all of that. It never closes a Fusion
that has unsaved changes or that someone used in the last 2 minutes.
1. After editing the design copy: `FoxScrewScan` → copy `screw_scan.json` to `analysis/`, run
   `~/.venvs/fox_rl/bin/python tools/screw_graph.py` (fails on a fastener conflict or a non-parallelogram leg) and copy
   `analysis/link_map.json` into `tools/fusion/FoxBuildLinkModel/`.
2. `FoxBuildLinkModel` writes a new `…_RL_Mechanism` document (timestamped if the name exists) and saves it only if the
   drive tests pass. Wait for `Uploaded document` in the Fusion log before closing Fusion.
3. `FoxExportRaw` → copy `C:\fusion_jobs\export` to `raw/`.
4. `~/.venvs/fox_rl/bin/python tools/build_robot.py`, then the checks below.

v7 the same way, with the configs in `tools/fusion/v7/` (`scan.json`, `build.json`, `export.json`) placed next to each
add-in, and `tools/screw_graph.py analysis/screw_scan_v7.json analysis/link_map_v7.json`. The export is `raw_v7/`, which
includes the spacer. Then:
* the sim model (no spacer): `tools/raw_v7_without_spacer.py && tools/build_robot.py --raw raw_v7_nospacer --out v7`;
* the MuJoCo checks with `FOX_MODEL=v7`. `FoxMakeV7` runs once per variant: it refuses to overwrite the name given
  in its `make.json`. Without a `make.json` it builds `Fox_Prototype_03_v7_RL`.

The as-built v7b works the same way. Use `tools/fusion/v7b/make.json` for `FoxMakeV7`, then the `v7b/` scan and build
configs, with `tools/screw_graph.py analysis/screw_scan_v7b.json analysis/link_map_v7b.json`.

## Validation
All checks pass (reports in `validation/`):

| Check | Result |
|---|---|
| Fasteners: every part sharing a screw line or a spline is in the same part | 380 rigid joins, 0 conflicts, 12/12 splines matched |
| Fusion mechanism: 40 joints + 4 motion links healthy; each hip joint turns its leg rigidly | rigid-rotation error 0.0 cm |
| Fusion drive tests (gear servo, held femur, held pinion, knee ±0.3): gear = −pinion, shin ∥ crank, Quad Link ∥ femur, rear foot ∥ femur | worst 7 µrad |
| Four-bar model (`build_robot.py`) vs Fusion's solver, front foot | 0.093 / −0.078 rad at knee +0.3 / −0.2 in both |
| MuJoCo exact model: structure, feet touch at the zero pose | 39 qpos, 12 servos, 12 equalities; all feet at +2 mm |
| MuJoCo exact model: stands 4 s | base 0.1528 → 0.1450 m, upright 0.999, loop gap ≤ 0.03 mm, gear error ≤ 0.0003 rad |
| MuJoCo: servo roles (table above) | gear → shin, pivot → femur/knee, pivot + gear(−) → rigid pendulum |
| MuJoCo: reduced tree vs exact mechanism (6 random servo poses, held) | feet within 0.04 mm; standing heights 0.14501 / 0.14555 m |
| MuJoCo: ramped crouch / abduction | body lowers, stays upright |
| MuJoCo: 20 s random servo targets | always finite |
| Isaac Sim 6.0.1 import → `usd/fox.usd` | 17 bodies, 16 DOFs, 4 foot mimics |
| Isaac Sim: stands 4 s with the servo map (GPU PhysX, 200 Hz) | base 0.155 → 0.14684 m, upright 0.999514 |
| Isaac Sim: servo map in PhysX (held robot) + foot mimics | gear → shin −0.30, pivot → femur +0.30, pendulum; mimic error 0.0015 rad |
| `FoxServoActuator.compute()` vs the servo map | 1e-8 N·m, power balance holds |
| Servo chatter while standing (`tools/check_servo_chatter.py`, 200 Hz physics) | v7: torque sign flips on 2.3 % of steps, mean step change 0.019 N·m (25 % / 0.63 N·m before `fox_cfg.geared`); v6: 0.2 % / 0.008 N·m |
| `FOX_SERVO_REAL_CFG`: latency, backlash, torque-speed line (`tools/test_fox_actuator.py`) | target delayed exactly N steps, no torque within the play, half the stall torque at half the no-load speed |
| Pi code in the loop (`tools/check_policy_io.py`, v4 incl. the hip rule): `deploy/fox_pi.py`'s FoxPolicy + ONNX drive the sim | observation = Isaac Lab's (0 error), actions = PyTorch (3.6e-7), output order = servo joints; walks 0.17 m/s (cmd 0.2), turns 0.59 rad/s (cmd 0.6) |
| Pi code in the loop, `fox_v7_straight_v1` (`--task Fox-V7-Velocity-Flat-Blind-Straight-Play`): FoxPolicy with `policy.json` | observation 0 error, actions 4.8e-7, servo targets = the env's processed actions (6e-8 rad), contract (order, 2:1) matches; walks +0.225 / −0.221 m/s (cmd ±0.2) |
| `fox_v7_straight_v1` on the Pi (`--dry-run`, Thiago's calibration, 2:1) | 150 steps, 0 over budget; servos settle within 10–15° of the planned stance; a 1:1 calibration is refused |
| v4 hips while walking straight (`fox_play.py --eval`) | hip target 0.0000 rad; hip joint ≤ 0.043 rad (play + compliance) |
| `deploy/fox_pi.py --dry-run` (fake hardware, 150 steps at 50 Hz) | 0 steps over the 20 ms budget (ONNX via onnx's reference evaluator) |
| Isaac Lab 3.0.0-beta2 (`isaaclab/fox_sim.py`, 4 robots, servo motions) | runs headless and in the Kit viewer; all upright (≥ 0.945) |

Renders: `validation/mujoco_servo_roles.png` (rows: gear servo, pivot servo, pendulum), `mujoco_hip_abduction.png`,
`mujoco_front_left.png`, `mujoco_poses.png`, `isaacsim_stand.png`.
Re-run: `~/.venvs/fox_rl/bin/python tools/validate_mujoco.py`, `tools/mechanism_mujoco.py`, `tools/pose_test_mujoco.py`,
`tools/random_actions_mujoco.py`; `~/isaacenv/bin/python tools/test_fox_actuator.py`; Isaac Sim as above;
`OMNI_KIT_ACCEPT_EULA=YES ~/isaacenv/bin/python tools/check_policy_io.py policies/fox_flat_blind_v4/model_2998.pt`;
`~/.venvs/fox_rl/bin/python tools/test_fox_pi.py`; `tools/check_servo_chatter.py --task <a -Play task>` (Isaac Lab)
(add `--device cpu` when the GPU is busy); `~/isaacenv/bin/python deploy/fox_pi.py policies/fox_flat_blind_v4/policy.onnx --dry-run`.
