thiagopari/fox_rl_model/print/v7_crank_gear_24T_printed_bushing.stl

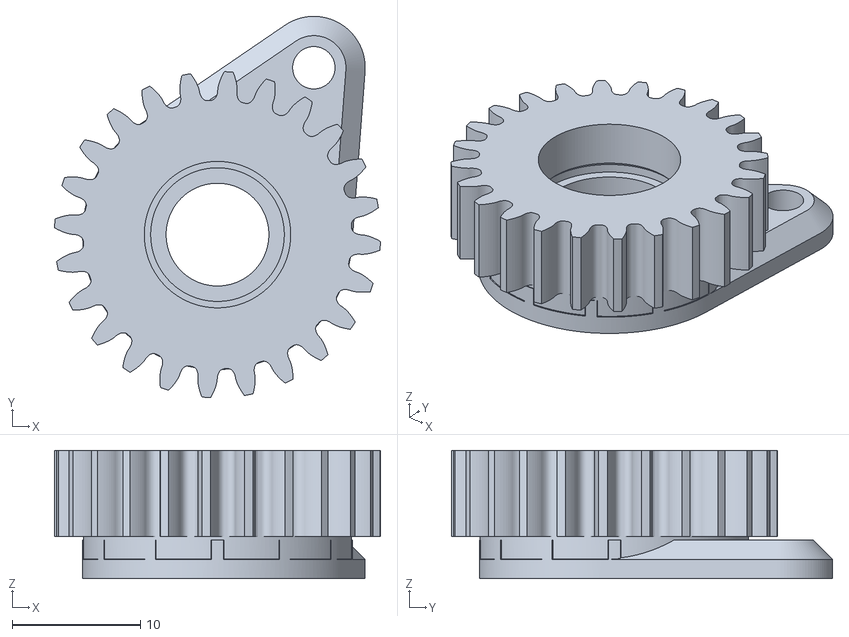
[picture p5: CAD file, 2026-10-08]
print/v7_crank_gear_24T_printed_bushing.stl
25.4 x 29.7 x 10.0
