thiagopari/fox_rl_model/raw_v7_nospacer/meshes/FR_pinion.stl

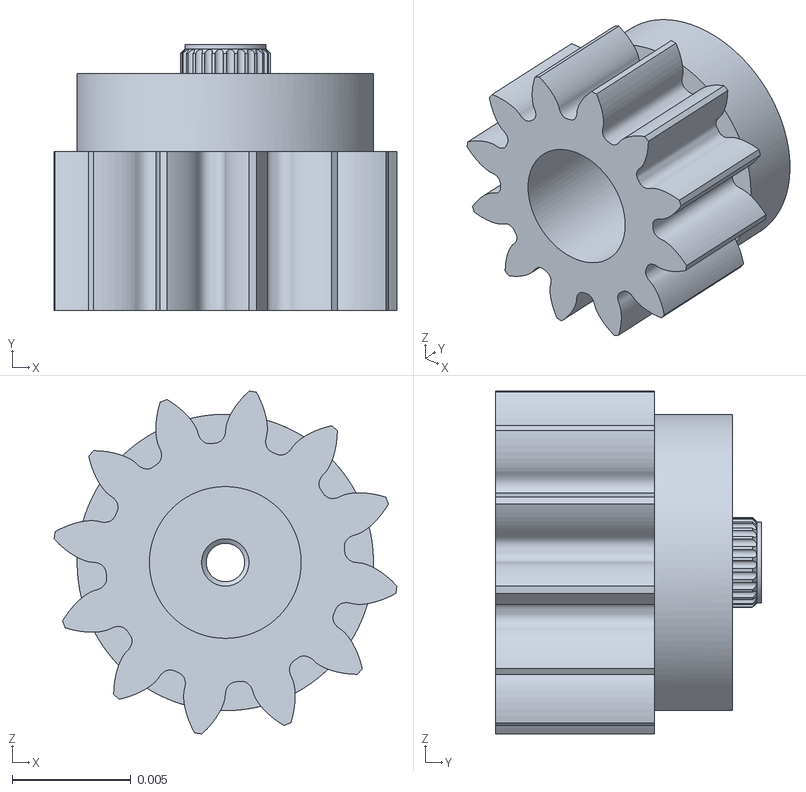
[picture p6: CAD file, 2026-10-08]
raw_v7_nospacer/meshes/FR_pinion.stl
0.0145 x 0.0112 x 0.0145
