thiagopari/fox_rl_model/v7/meshes/collision/FL_hip_reduced.stl

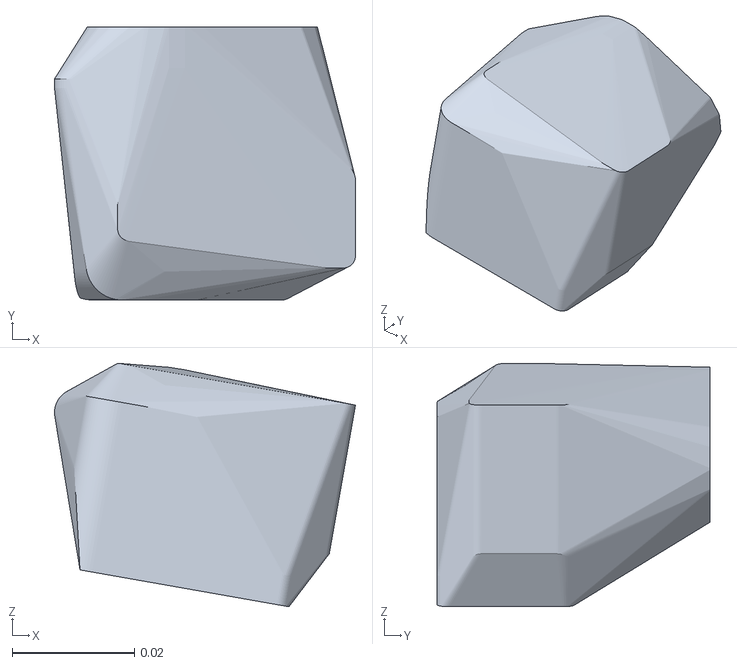
[picture p7: CAD file, 2026-10-08]
v7/meshes/collision/FL_hip_reduced.stl
0.0493 x 0.0447 x 0.0399
