thiagopari/fox_rl_model/v7/meshes/visual/FL_gear.stl

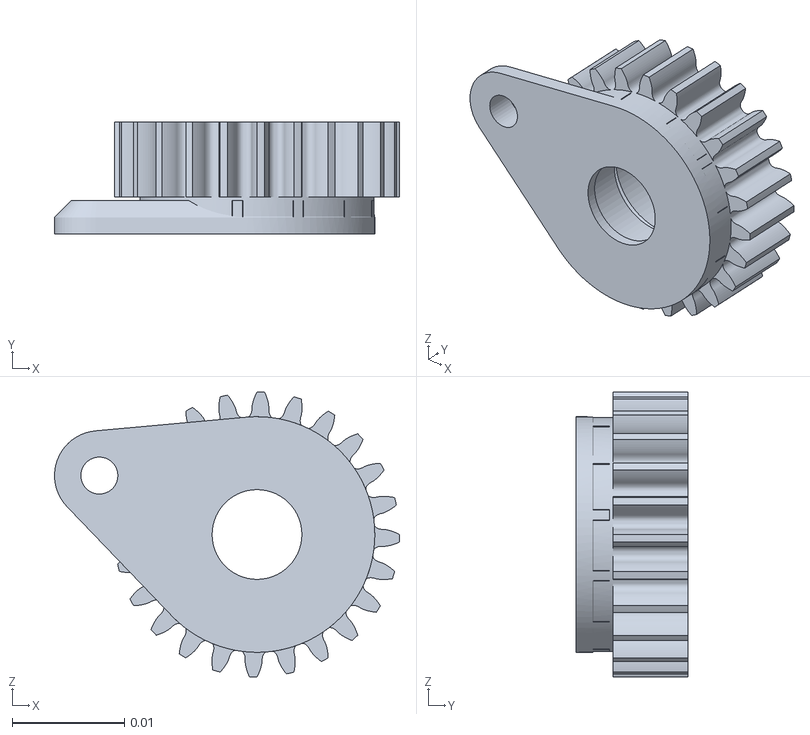
[picture p8: CAD file, 2026-10-08]
v7/meshes/visual/FL_gear.stl
0.0307 x 0.01 x 0.0254
