thiagopari/fox_rl_model/print/v7_bushing_10x3x4.stl

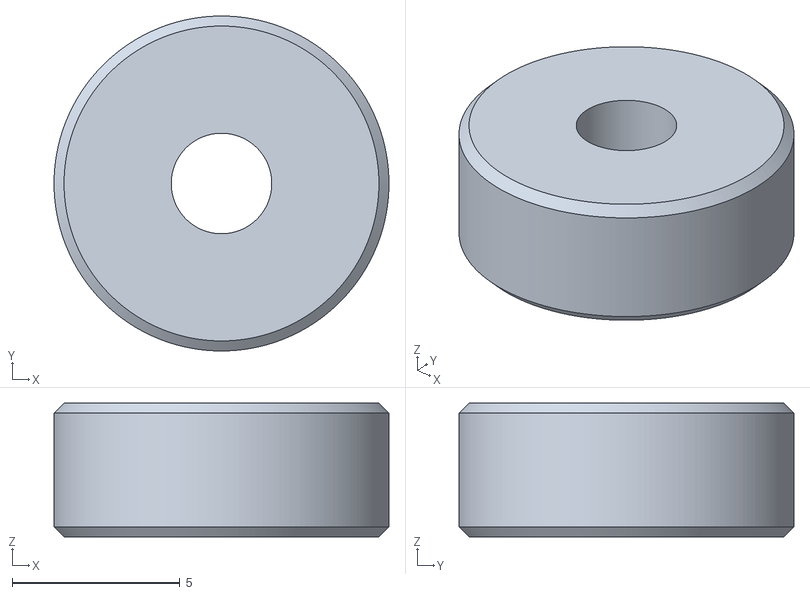
[picture p9: CAD file, 2026-10-08]
print/v7_bushing_10x3x4.stl
10.0 x 10.0 x 4.00
