thiagopari/fox_rl_model/raw_v7_nospacer/meshes/RL_pinion.stl

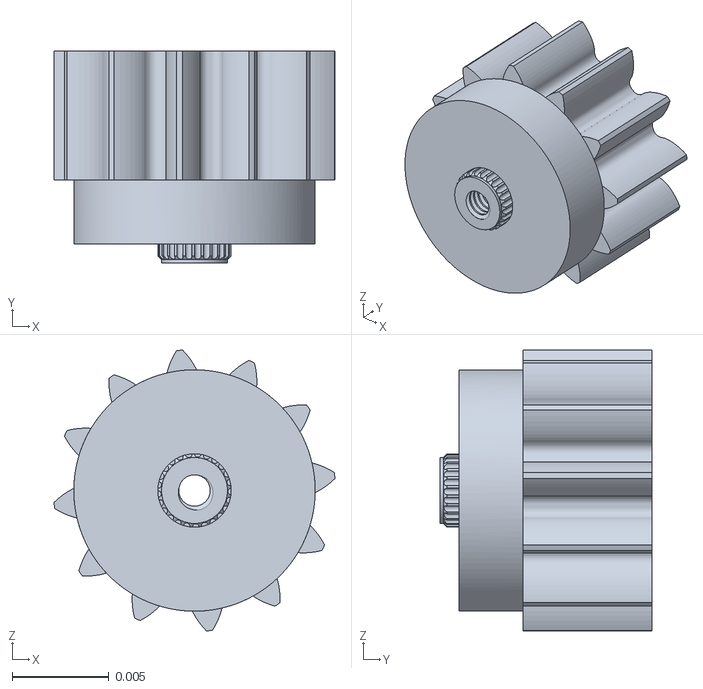
[picture p10: CAD file, 2026-10-08]
raw_v7_nospacer/meshes/RL_pinion.stl
0.0145 x 0.011 x 0.0145
