thiagopari/fox_rl_model/print/v7_middle_casing.stl

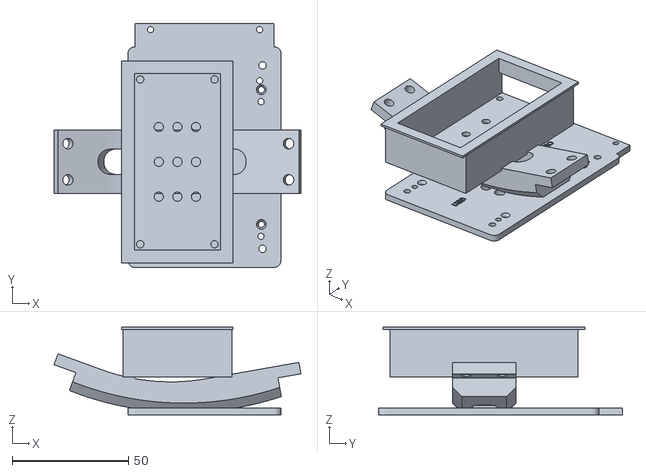
[picture p11: CAD file, 2026-10-08]
print/v7_middle_casing.stl
106.4 x 105.0 x 37.8
