thiagopari/fox_rl_model/raw_v7_nospacer/meshes/RR_gear.stl

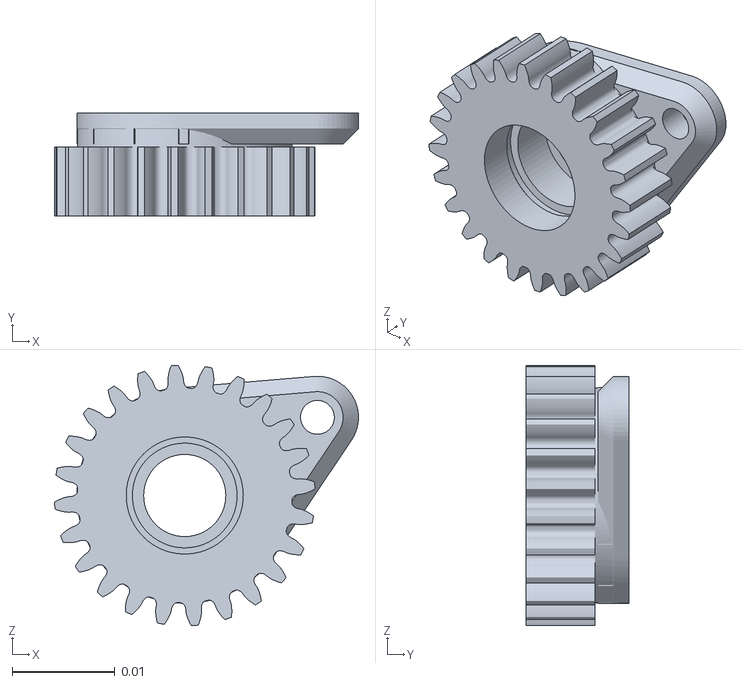
[picture p12: CAD file, 2026-10-08]
raw_v7_nospacer/meshes/RR_gear.stl
0.0296 x 0.01 x 0.0254
