thiagopari/fox_rl_model/print/v7_rear_hip_spacer.stl

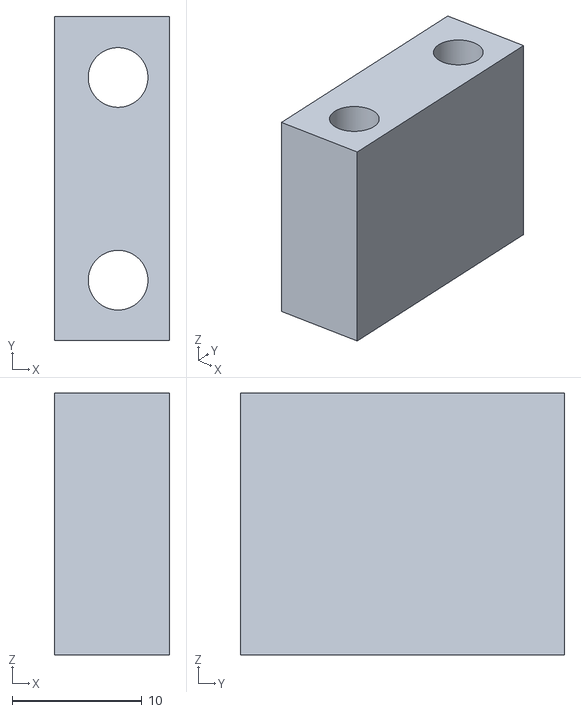
[picture p14: CAD file, 2026-10-08]
print/v7_rear_hip_spacer.stl
8.90 x 25.0 x 20.2
