thiagopari/fox_rl_model/v7/meshes/collision/RR_gear.stl

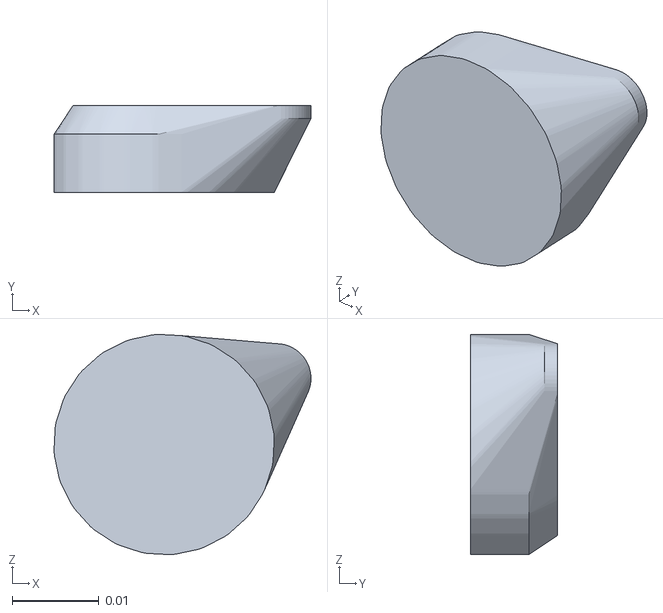
[picture p15: CAD file, 2026-10-08]
v7/meshes/collision/RR_gear.stl
0.0296 x 0.01 x 0.0254
