thiagopari/fox_rl_model/print/v7_pinion_12T.stl

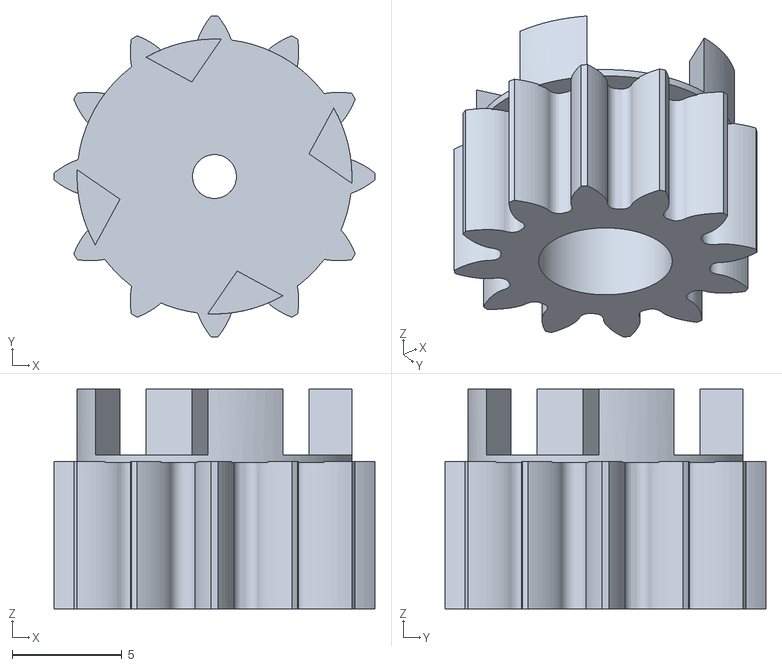
[picture p16: CAD file, 2026-10-08]
print/v7_pinion_12T.stl
14.6 x 14.6 x 10.0
