thiagopari/fox_rl_model/v7/meshes/collision/FR_gear.stl

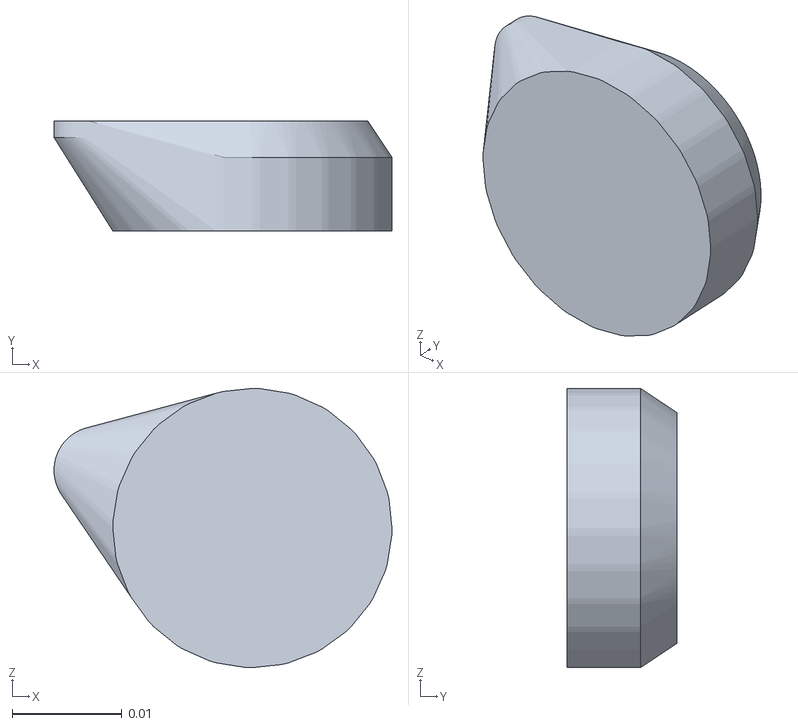
[picture p17: CAD file, 2026-10-08]
v7/meshes/collision/FR_gear.stl
0.0307 x 0.01 x 0.0254
