thiagopari/fox_rl_model/print/v7_femur_front_2.stl

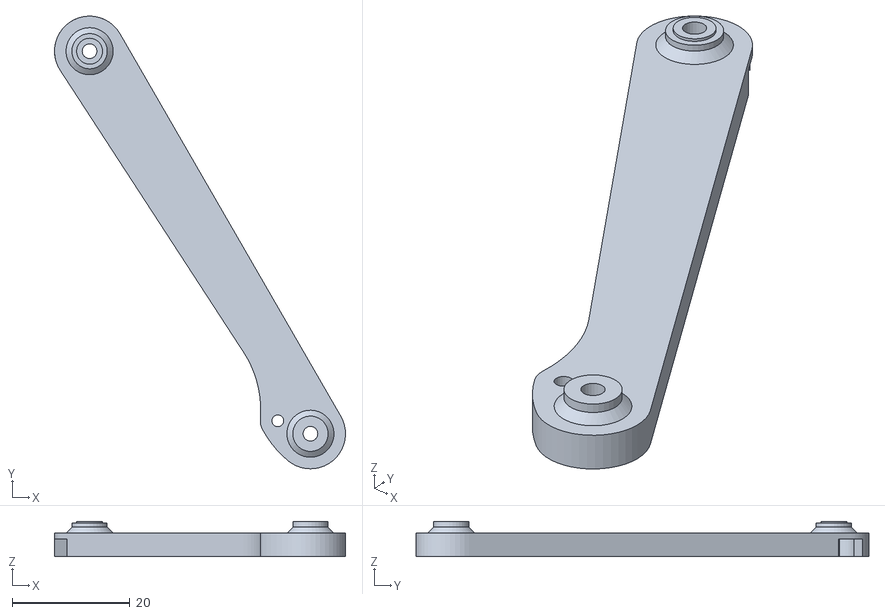
[picture p18: CAD file, 2026-10-08]
print/v7_femur_front_2.stl
49.4 x 76.9 x 6.00
