thiagopari/fox_rl_model/v7/meshes/collision/FL_pinion.stl

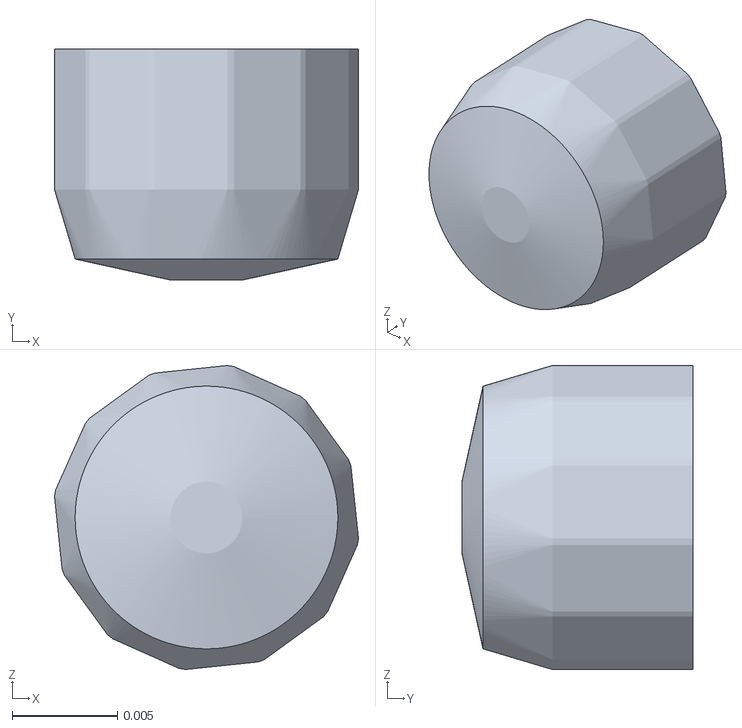
[picture p19: CAD file, 2026-10-08]
v7/meshes/collision/FL_pinion.stl
0.0145 x 0.011 x 0.0145
