thiagopari/fox_rl_model/v7/meshes/visual/FR_hip_reduced.stl

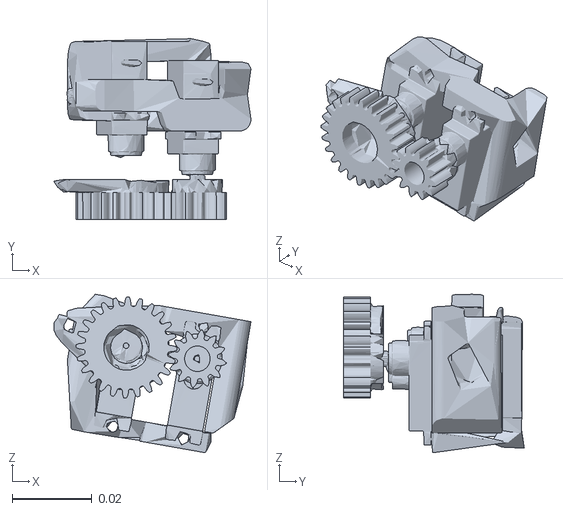
[picture p20: CAD file, 2026-10-08]
v7/meshes/visual/FR_hip_reduced.stl
0.0495 x 0.0454 x 0.0398
