thiagopari/fox_rl_model/print/v7_femur_back.stl

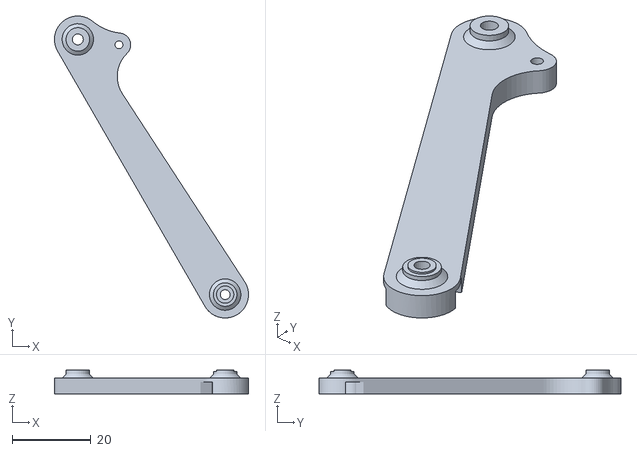
[picture p21: CAD file, 2026-10-08]
print/v7_femur_back.stl
49.4 x 76.9 x 6.00
