thiagopari/fox_rl_model/v7/meshes/visual/FL_hip_reduced.stl

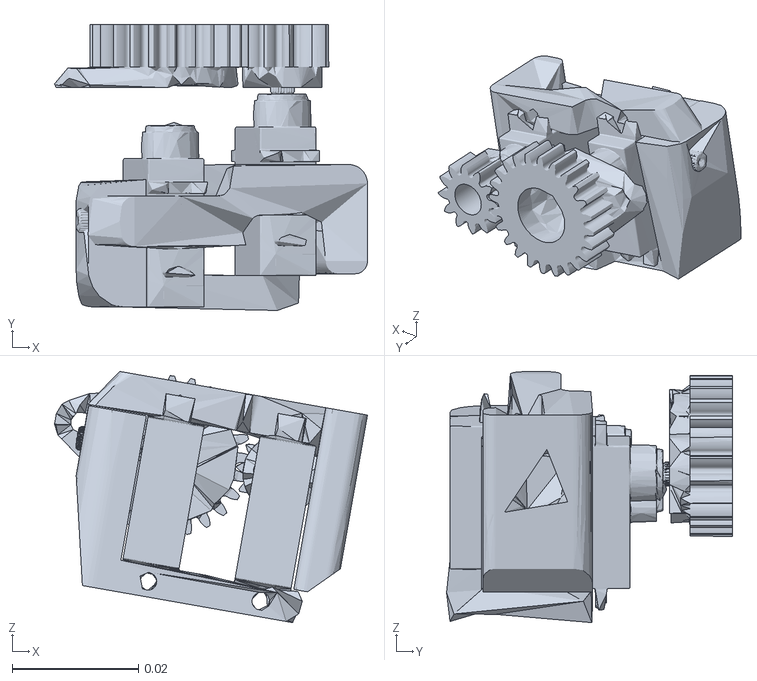
[picture p22: CAD file, 2026-10-08]
v7/meshes/visual/FL_hip_reduced.stl
0.0495 x 0.0452 x 0.0398
