thiagopari/fox_rl_model/v7/meshes/collision/RL_hip_reduced.stl

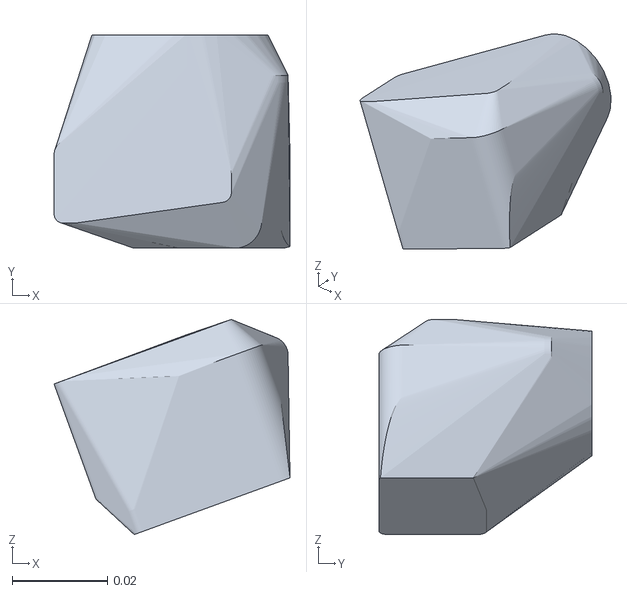
[picture p23: CAD file, 2026-10-08]
v7/meshes/collision/RL_hip_reduced.stl
0.0495 x 0.0447 x 0.0451
