thiagopari/fox_rl_model/v7/meshes/visual/RL_hip_reduced.stl

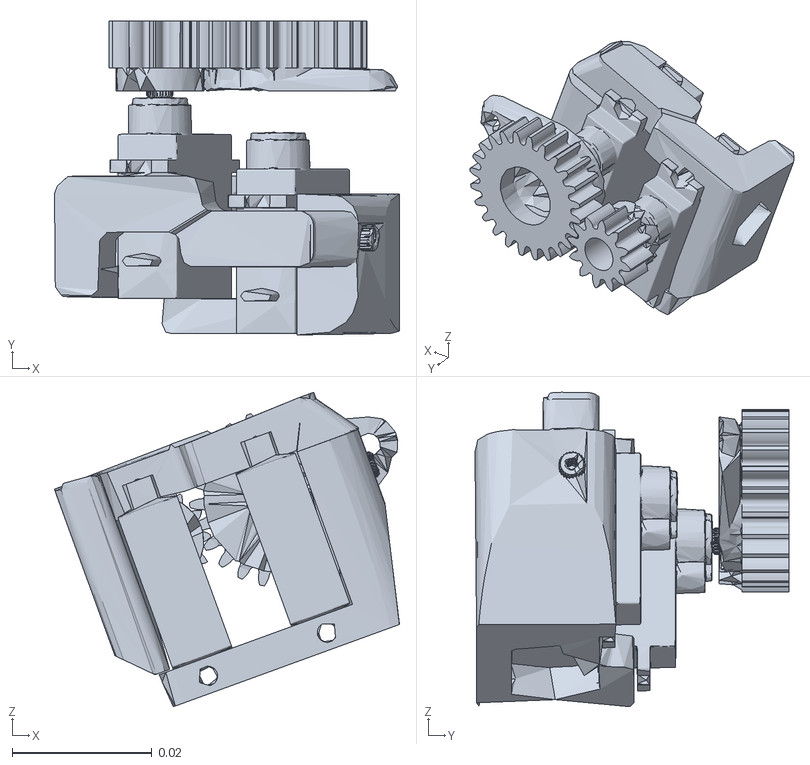
[picture p24: CAD file, 2026-10-08]
v7/meshes/visual/RL_hip_reduced.stl
0.0493 x 0.0449 x 0.045
