thiagopari/fox_rl_model/raw_v7_nospacer/meshes/FR_foot.stl

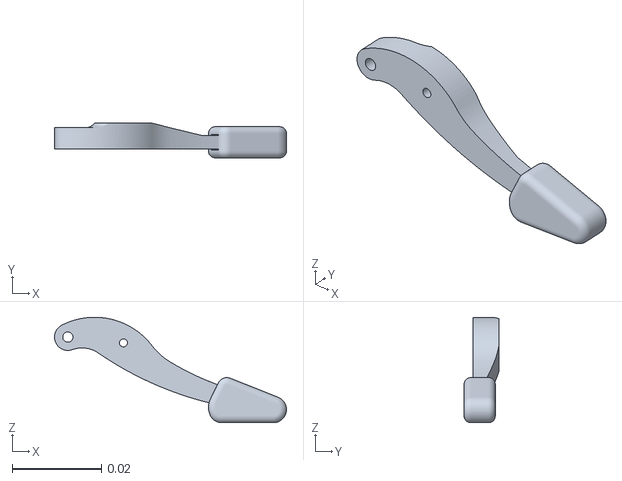
[picture p25: CAD file, 2026-10-06]
raw_v7_nospacer/meshes/FR_foot.stl
0.0521 x 0.0078 x 0.0237
