thiagopari/fox_rl_model/raw_v7_nospacer/meshes/RL_quad.stl

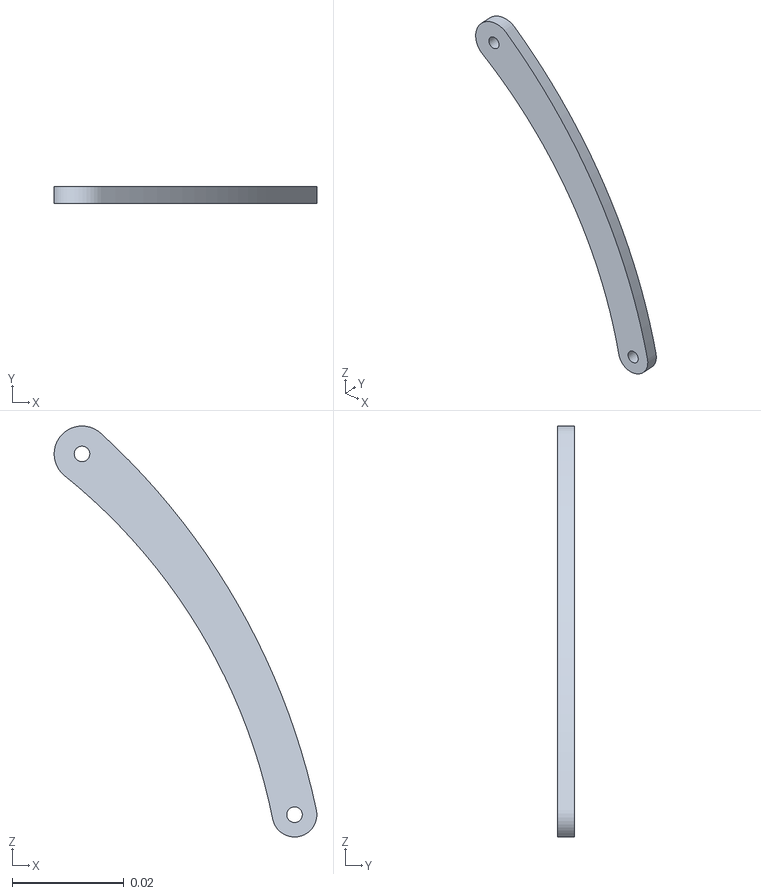
[picture p26: CAD file, 2026-10-06]
raw_v7_nospacer/meshes/RL_quad.stl
0.0471 x 0.003 x 0.0736
