thiagopari/fox_rl_model/v7/meshes/visual/RR_hip_reduced.stl

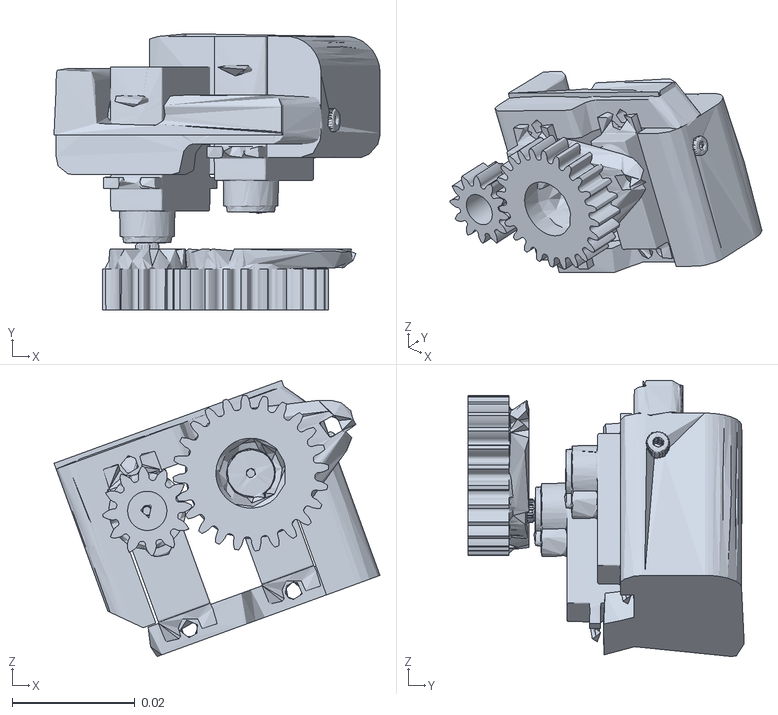
[picture p27: CAD file, 2026-10-08]
v7/meshes/visual/RR_hip_reduced.stl
0.0532 x 0.0451 x 0.0451
