thiagopari/fox_rl_model/print/FL_gear.stl

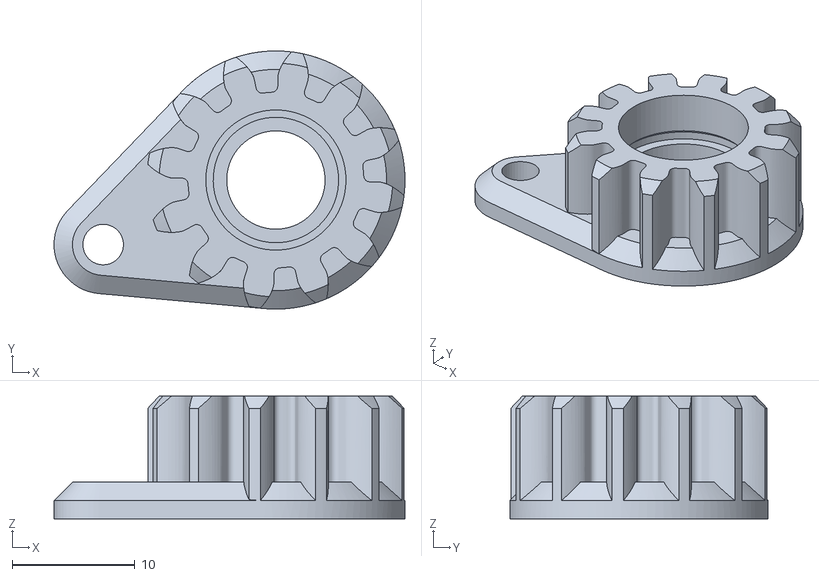
[picture p28: CAD file, 2026-10-06]
print/FL_gear.stl
28.5 x 21.0 x 10.00
