thiagopari/fox_rl_model/raw_v7_nospacer/meshes/RR_femur.stl

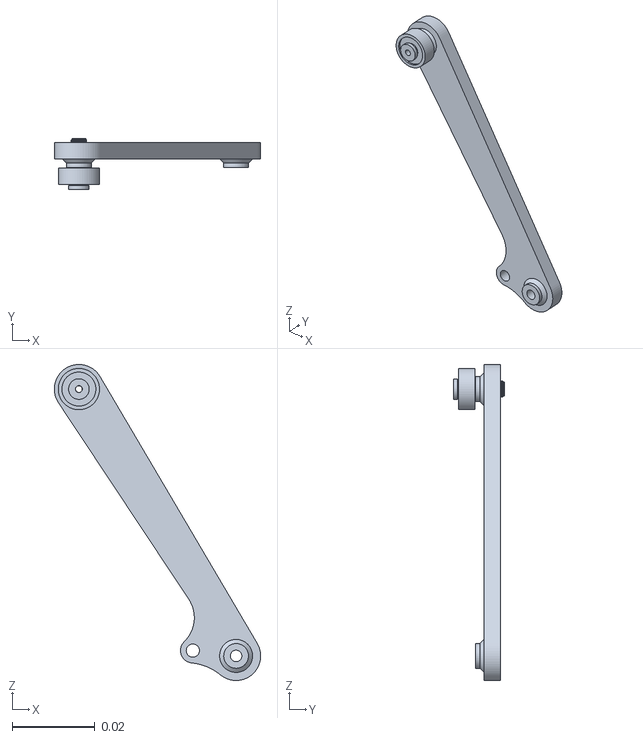
[picture p29: CAD file, 2026-10-06]
raw_v7_nospacer/meshes/RR_femur.stl
0.05 x 0.0124 x 0.0765
