thiagopari/fox_rl_model/v7/meshes/collision/RR_hip_reduced.stl

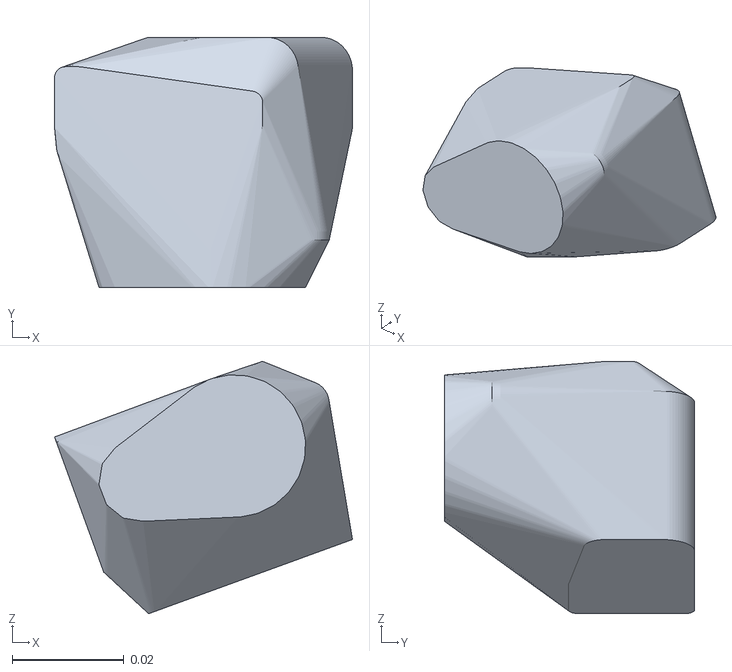
[picture p30: CAD file, 2026-10-08]
v7/meshes/collision/RR_hip_reduced.stl
0.0532 x 0.0447 x 0.0451
