thiagopari/fox_rl_model/raw_v7_nospacer/meshes/FL_hip.stl

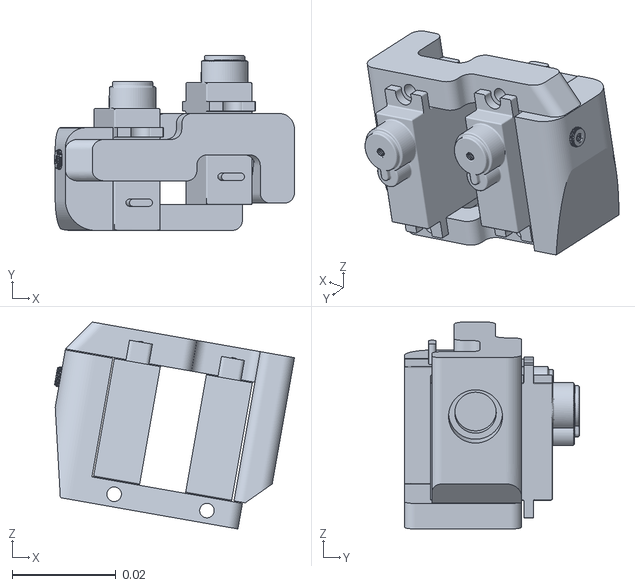
[picture p31: CAD file, 2026-10-06]
raw_v7_nospacer/meshes/FL_hip.stl
0.0462 x 0.0337 x 0.0399
