thiagopari/fox_rl_model/raw_v7_nospacer/meshes/FR_link.stl

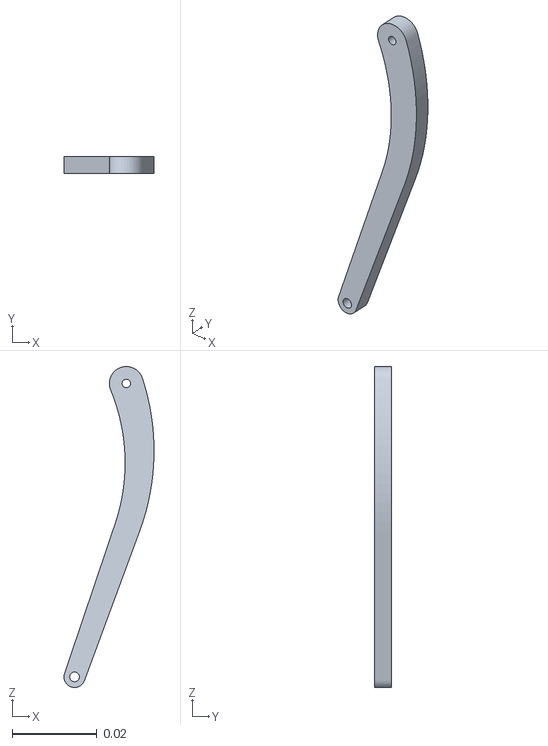
[picture p32: CAD file, 2026-10-06]
raw_v7_nospacer/meshes/FR_link.stl
0.0212 x 0.004 x 0.0757
