thiagopari/fox_rl_model/v7/meshes/collision/RR_tibia.stl

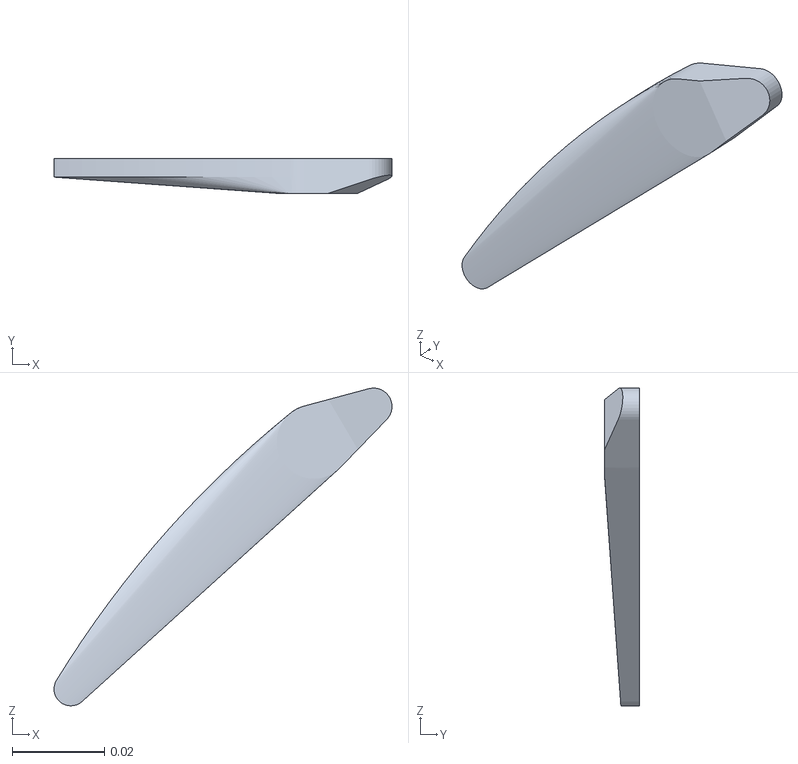
[picture p33: CAD file, 2026-10-06]
v7/meshes/collision/RR_tibia.stl
0.0731 x 0.0075 x 0.0687
