thiagopari/fox_rl_model/raw_v7_nospacer/meshes/RL_foot.stl

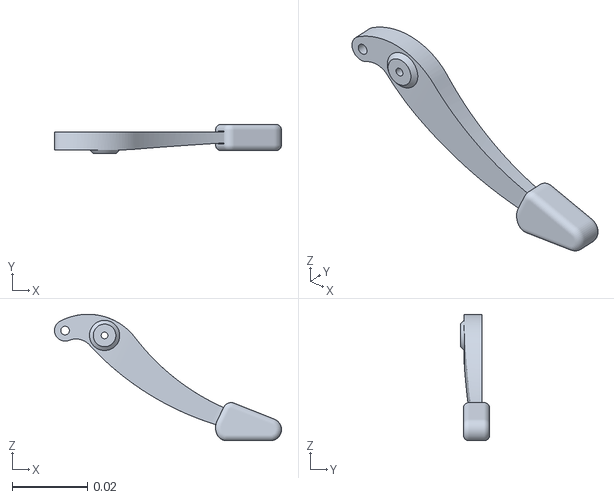
[picture p35: CAD file, 2026-10-06]
raw_v7_nospacer/meshes/RL_foot.stl
0.0602 x 0.0078 x 0.0335
