thiagopari/fox_rl_model/v7/meshes/collision/base.stl

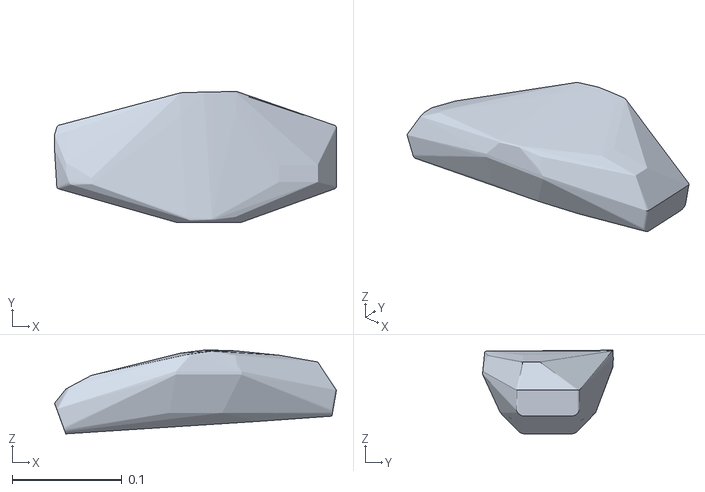
[picture p36: CAD file, 2026-10-06]
v7/meshes/collision/base.stl
0.257 x 0.119 x 0.0764
