thiagopari/fox_rl_model/v7/meshes/collision/FL_foot_reduced.stl

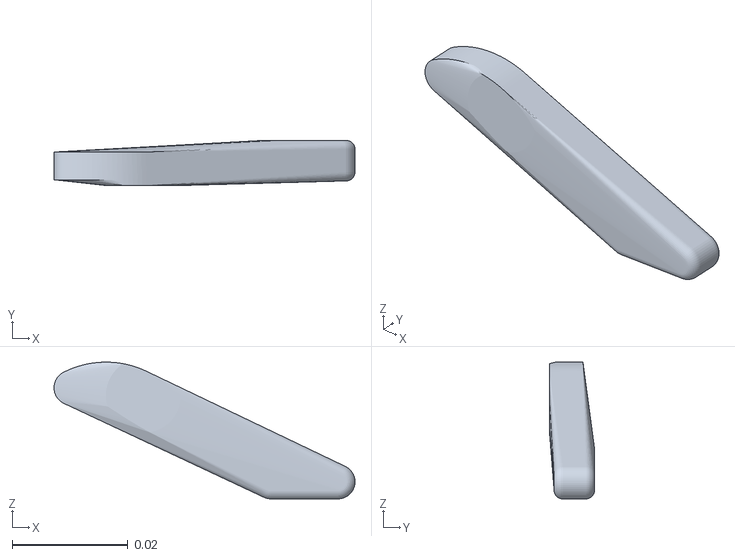
[picture p38: CAD file, 2026-10-06]
v7/meshes/collision/FL_foot_reduced.stl
0.0521 x 0.0078 x 0.0237
