thiagopari/fox_rl_model/v7/meshes/visual/RL_hip.stl

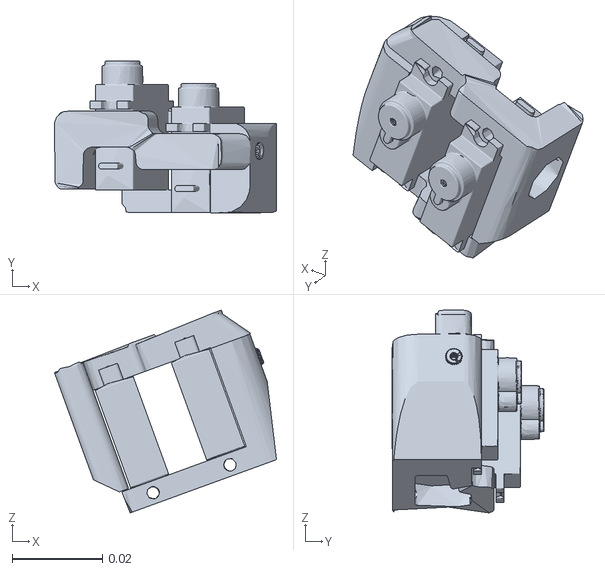
[picture p39: CAD file, 2026-10-06]
v7/meshes/visual/RL_hip.stl
0.0493 x 0.0338 x 0.045
