thiagopari/fox_rl_model/raw_v7_nospacer/meshes/FR_tibia.stl

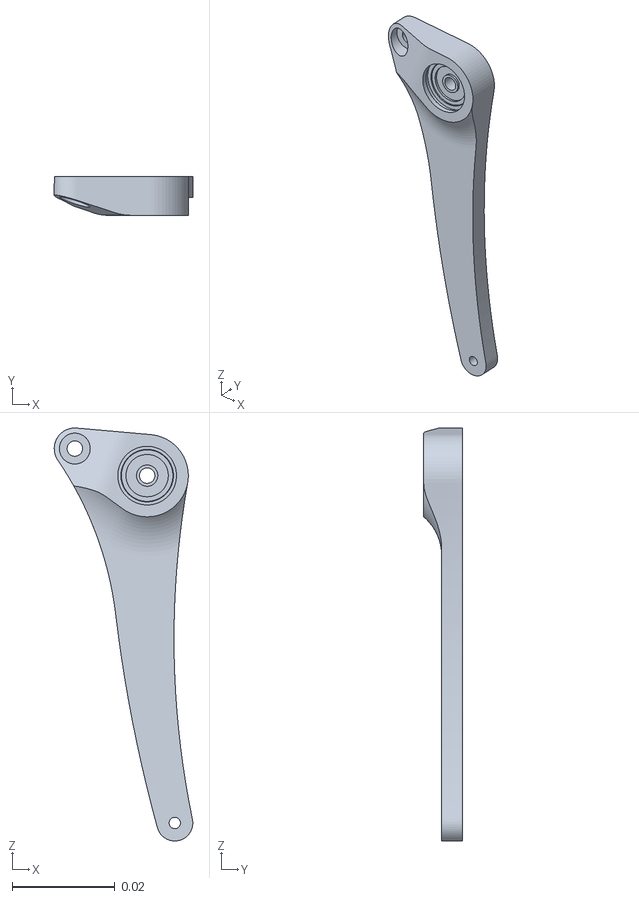
[picture p41: CAD file, 2026-10-06]
raw_v7_nospacer/meshes/FR_tibia.stl
0.0269 x 0.0075 x 0.0802
