thiagopari/fox_rl_model/v7/meshes/collision/RL_link.stl

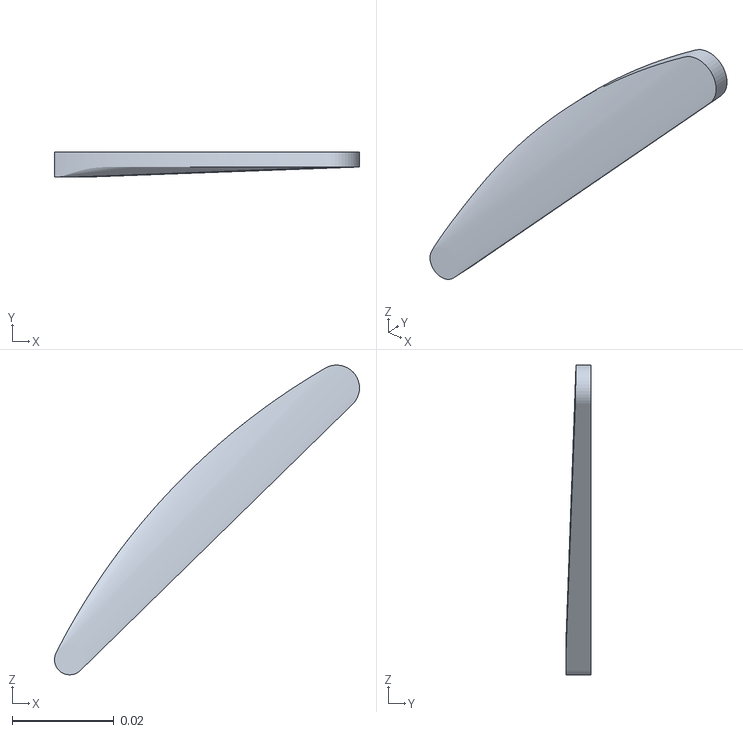
[picture p42: CAD file, 2026-10-06]
v7/meshes/collision/RL_link.stl
0.0601 x 0.005 x 0.061
