thiagopari/fox_rl_model/v7/meshes/collision/RR_calf_reduced.stl

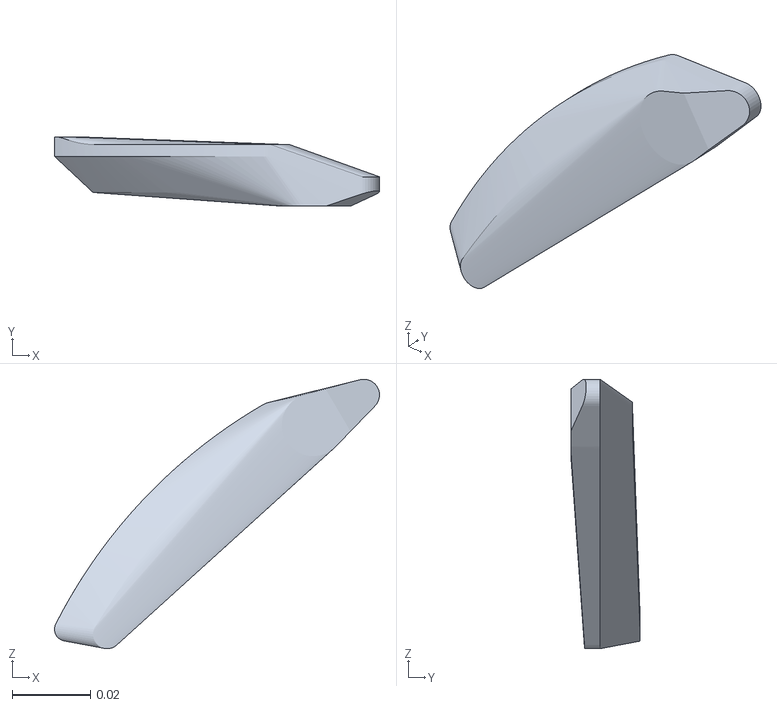
[picture p43: CAD file, 2026-10-06]
v7/meshes/collision/RR_calf_reduced.stl
0.0829 x 0.0177 x 0.0687
