thiagopari/fox_rl_model/v7/meshes/collision/FR_calf_reduced.stl

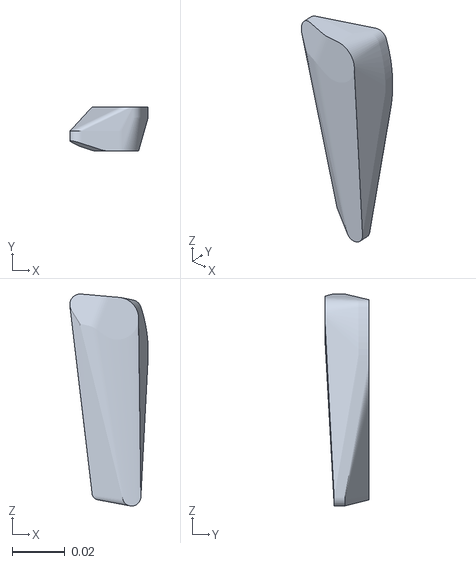
[picture p44: CAD file, 2026-10-06]
v7/meshes/collision/FR_calf_reduced.stl
0.0297 x 0.0167 x 0.0802
