thiagopari/fox_rl_model/v7/meshes/visual/FR_femur.stl

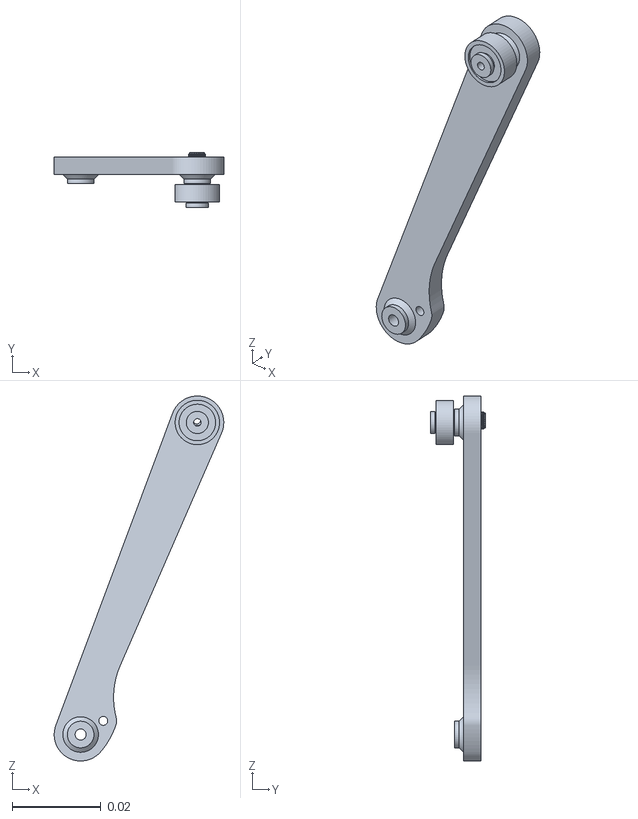
[picture p45: CAD file, 2026-10-06]
v7/meshes/visual/FR_femur.stl
0.0382 x 0.0124 x 0.0822
