thiagopari/fox_rl_model/raw_v7_nospacer/meshes/FR_quad.stl

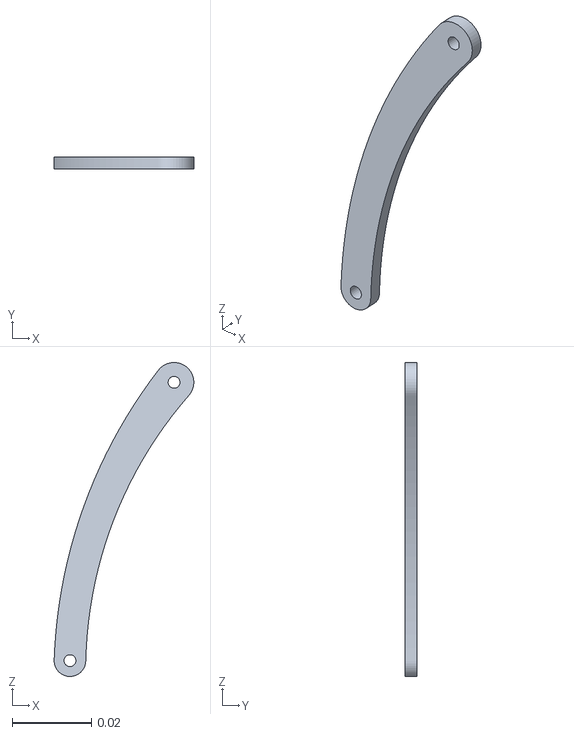
[picture p46: CAD file, 2026-10-06]
raw_v7_nospacer/meshes/FR_quad.stl
0.0353 x 0.003 x 0.0792
