thiagopari/fox_rl_model/v7/meshes/collision/FR_thigh_reduced.stl

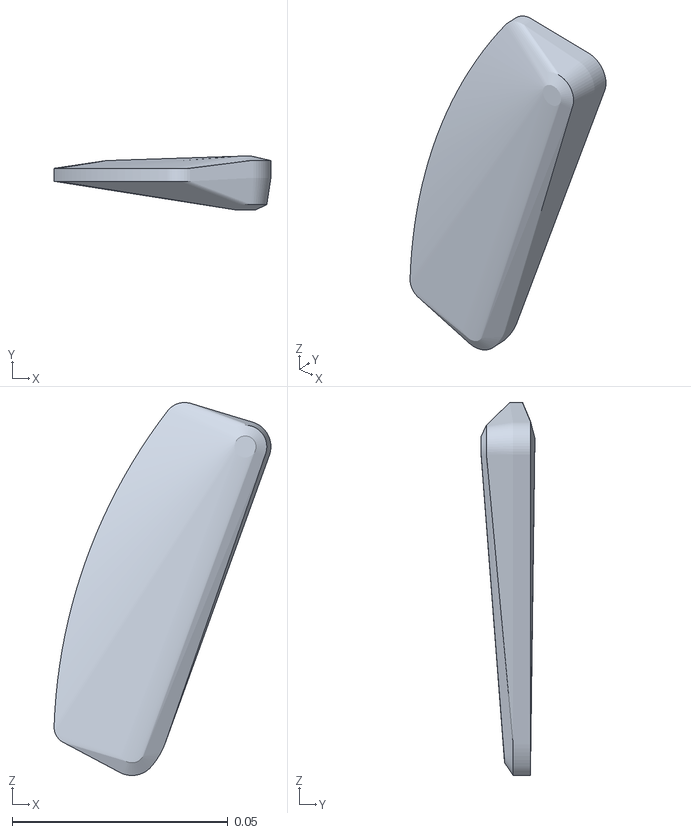
[picture p47: CAD file, 2026-10-06]
v7/meshes/collision/FR_thigh_reduced.stl
0.0503 x 0.0124 x 0.0865
