thiagopari/fox_rl_model/raw_v7_nospacer/meshes/RL_femur.stl

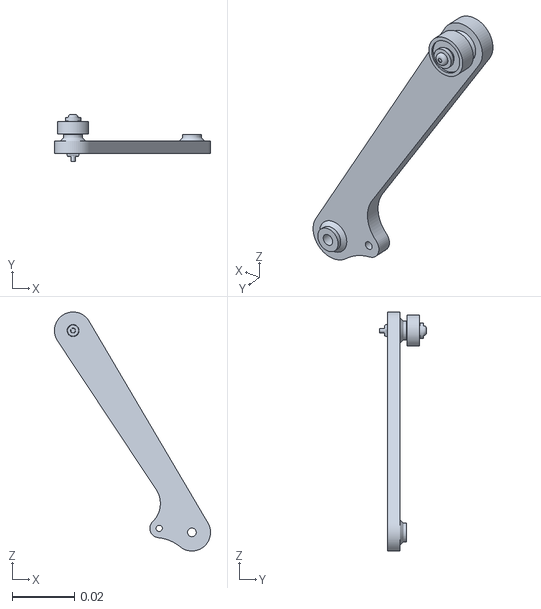
[picture p48: CAD file, 2026-10-06]
raw_v7_nospacer/meshes/RL_femur.stl
0.05 x 0.015 x 0.0765
