thiagopari/fox_rl_model/v7/meshes/collision/RR_quad.stl

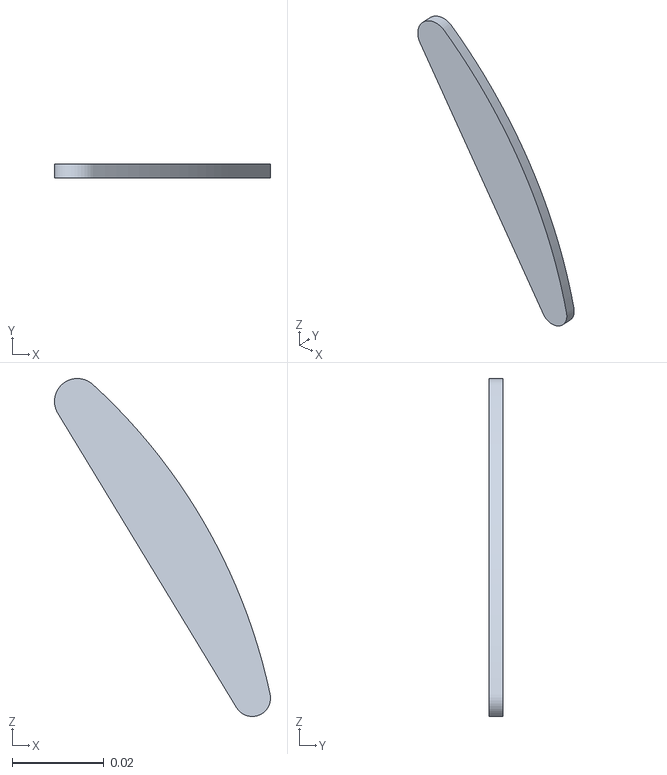
[picture p49: CAD file, 2026-10-06]
v7/meshes/collision/RR_quad.stl
0.0471 x 0.003 x 0.0736
