thiagopari/fox_rl_model/v7/meshes/collision/FR_quad.stl

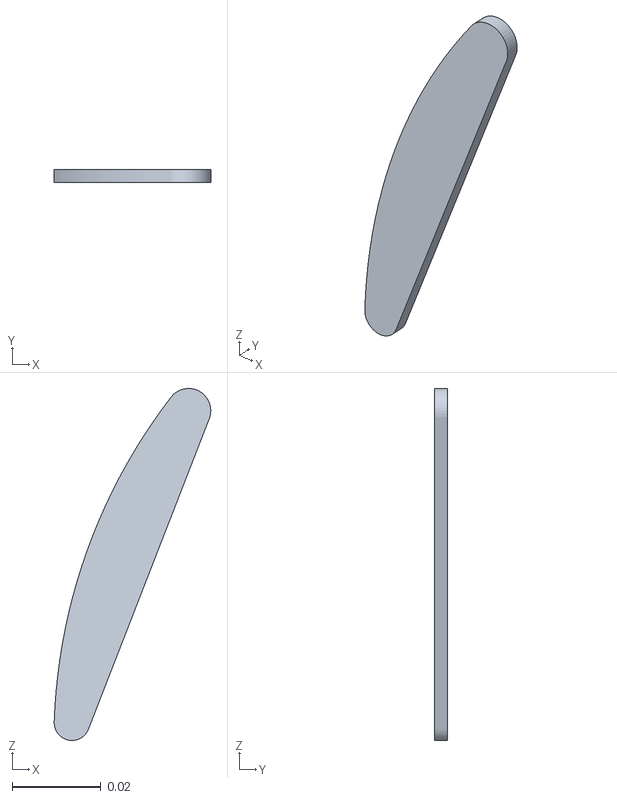
[picture p51: CAD file, 2026-10-06]
v7/meshes/collision/FR_quad.stl
0.0353 x 0.003 x 0.0792
