thiagopari/fox_rl_model/v7/meshes/visual/RR_thigh_reduced.stl

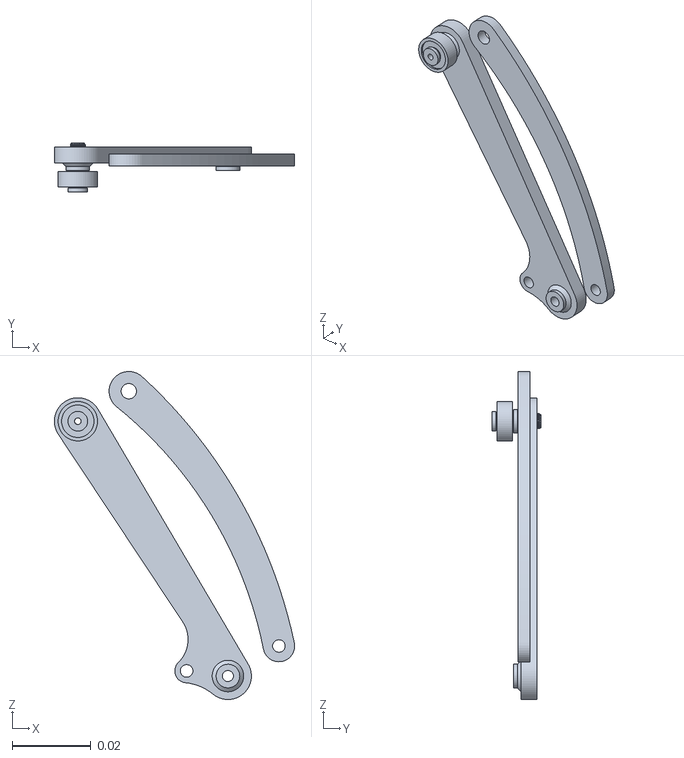
[picture p52: CAD file, 2026-10-06]
v7/meshes/visual/RR_thigh_reduced.stl
0.0609 x 0.0124 x 0.0832
