thiagopari/fox_rl_model/raw_v7_nospacer/meshes/FR_hip.stl

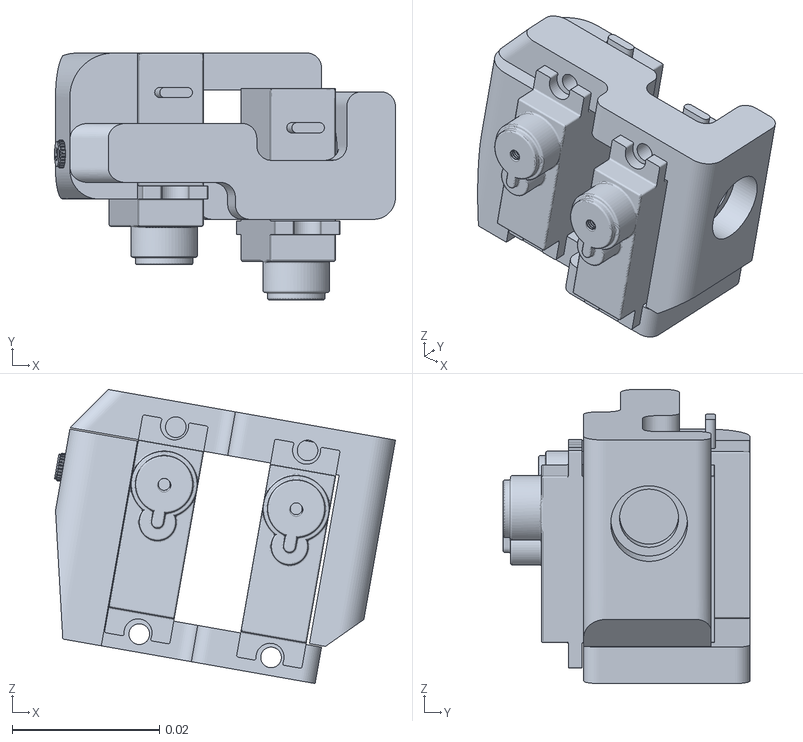
[picture p53: CAD file, 2026-10-06]
raw_v7_nospacer/meshes/FR_hip.stl
0.0462 x 0.0335 x 0.0399
