thiagopari/fox_rl_model/raw_v7_nospacer/meshes/RR_link.stl

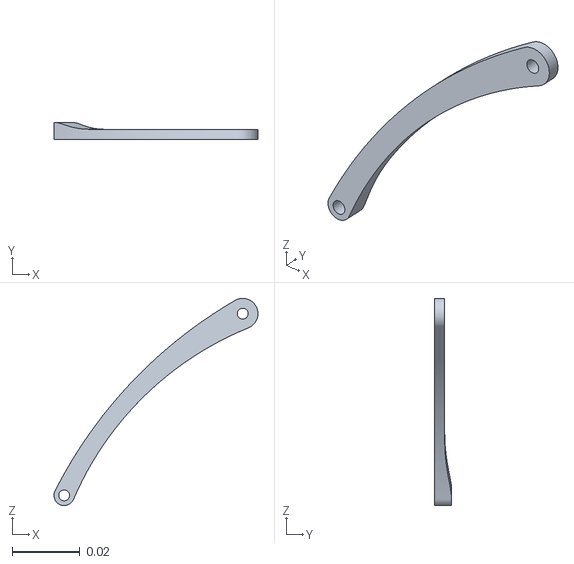
[picture p55: CAD file, 2026-10-06]
raw_v7_nospacer/meshes/RR_link.stl
0.0601 x 0.005 x 0.061
