thiagopari/fox_rl_model/v7/meshes/collision/RL_calf_reduced.stl

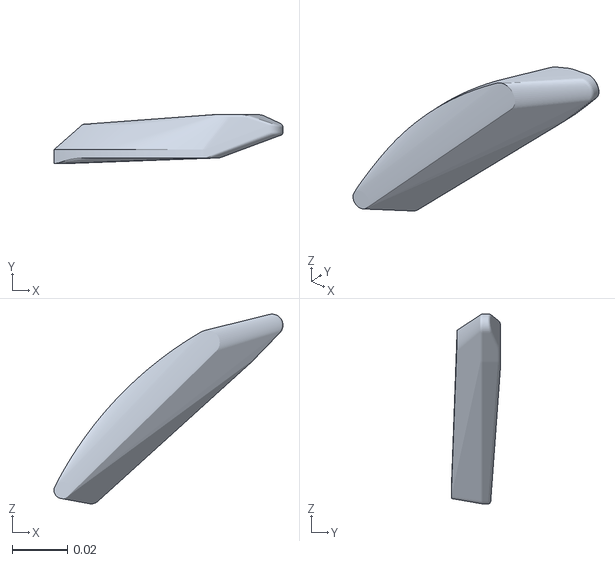
[picture p56: CAD file, 2026-10-06]
v7/meshes/collision/RL_calf_reduced.stl
0.083 x 0.0177 x 0.0687
