thiagopari/fox_rl_model/raw_v7_nospacer/meshes/RR_hip.stl

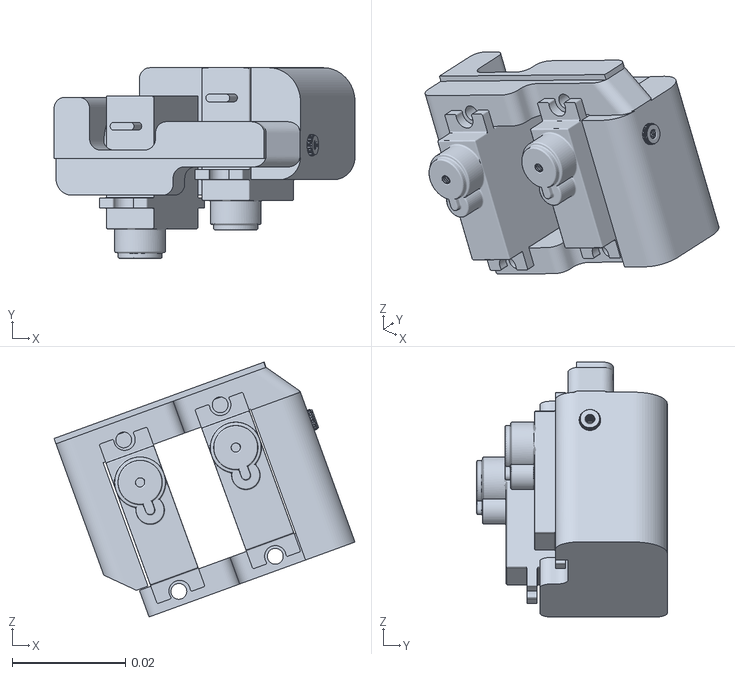
[picture p57: CAD file, 2026-10-06]
raw_v7_nospacer/meshes/RR_hip.stl
0.0532 x 0.0337 x 0.0451
