thiagopari/fox_rl_model/v7/meshes/collision/FL_hip.stl

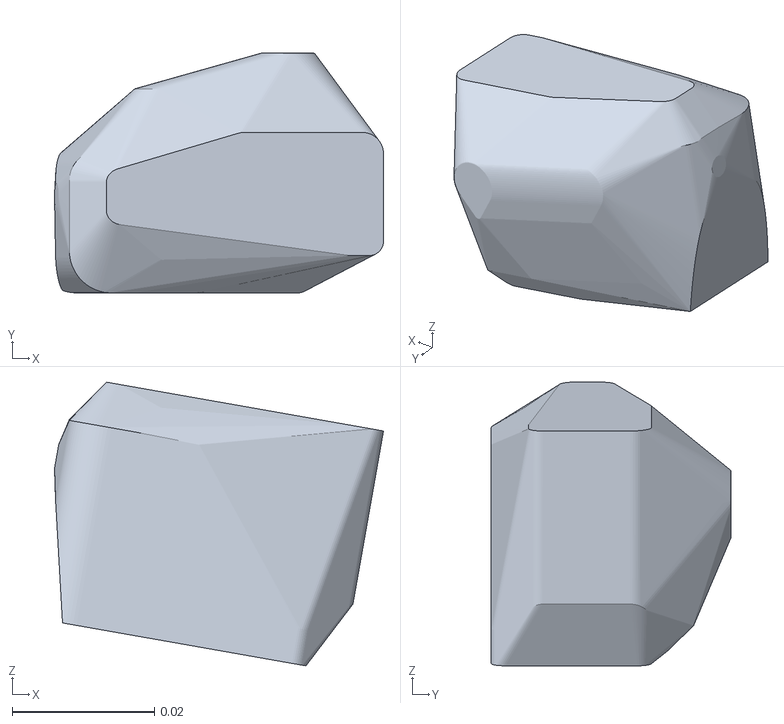
[picture p58: CAD file, 2026-10-06]
v7/meshes/collision/FL_hip.stl
0.0462 x 0.0337 x 0.0399
