thiagopari/fox_rl_model/v7/meshes/collision/FL_link.stl

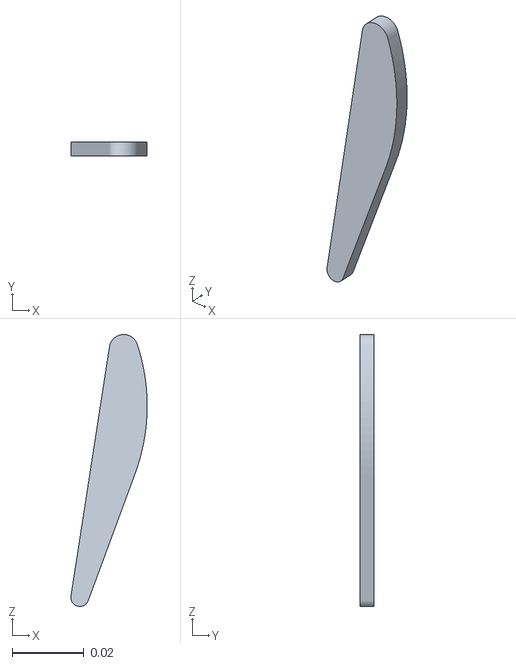
[picture p59: CAD file, 2026-10-06]
v7/meshes/collision/FL_link.stl
0.0212 x 0.004 x 0.0757
