thiagopari/fox_rl_model/v7/meshes/collision/RR_femur.stl

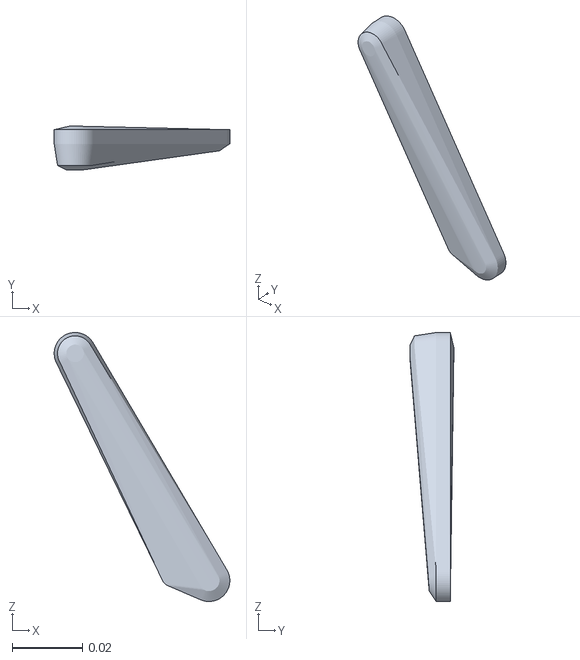
[picture p60: CAD file, 2026-10-06]
v7/meshes/collision/RR_femur.stl
0.05 x 0.0124 x 0.0765
