thiagopari/fox_rl_model/v7/meshes/collision/RL_hip.stl

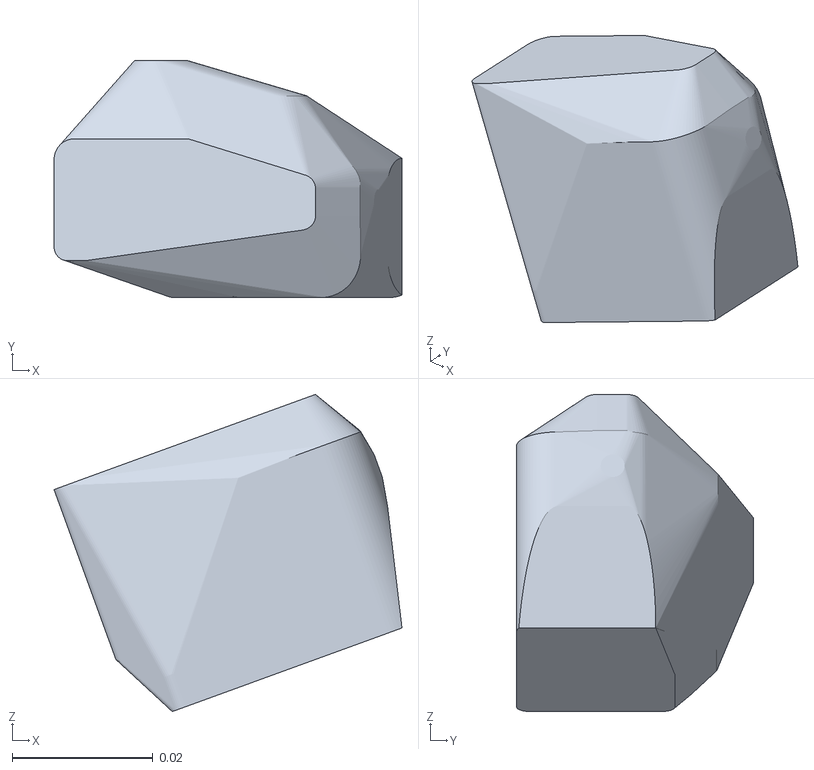
[picture p61: CAD file, 2026-10-06]
v7/meshes/collision/RL_hip.stl
0.0495 x 0.0337 x 0.0451
