thiagopari/fox_rl_model/v7/meshes/collision/FR_hip.stl

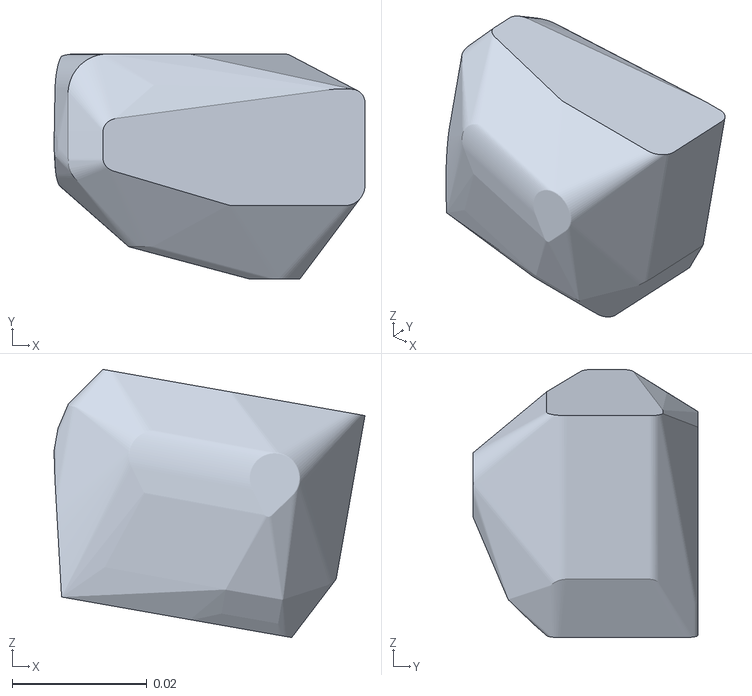
[picture p62: CAD file, 2026-10-06]
v7/meshes/collision/FR_hip.stl
0.0462 x 0.0335 x 0.0399
