thiagopari/fox_rl_model/v7/meshes/visual/base.stl

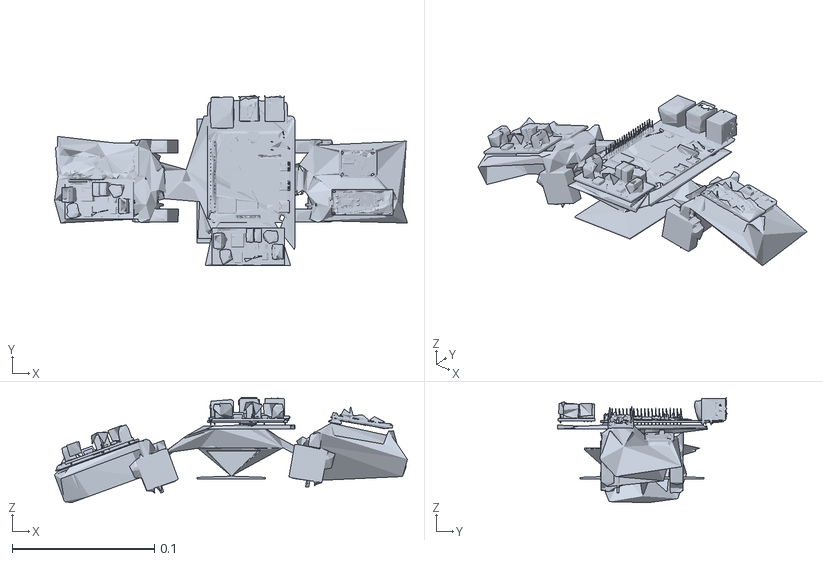
[picture p63: CAD file, 2026-10-06]
v7/meshes/visual/base.stl
0.248 x 0.12 x 0.0739
