thiagopari/fox_rl_model/v7/meshes/collision/FL_tibia.stl

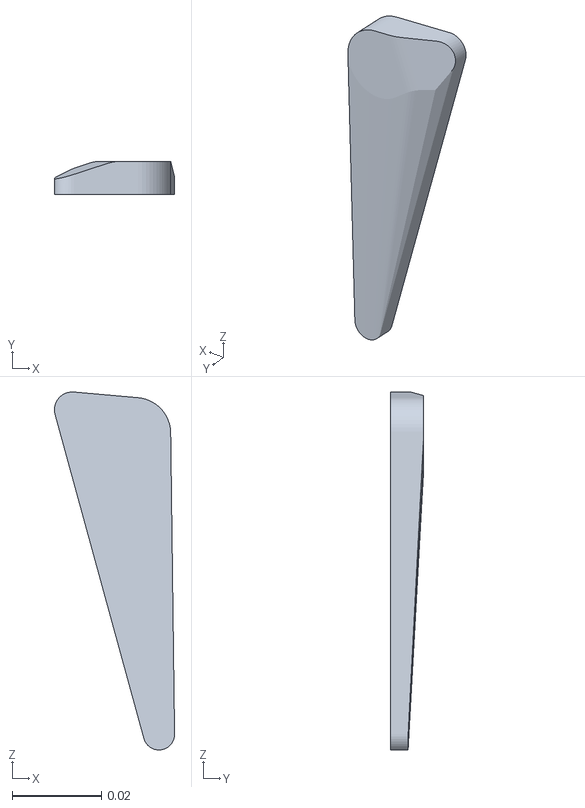
[picture p65: CAD file, 2026-10-06]
v7/meshes/collision/FL_tibia.stl
0.0269 x 0.0075 x 0.0802
