thiagopari/fox_rl_model/v7/meshes/collision/RL_femur.stl

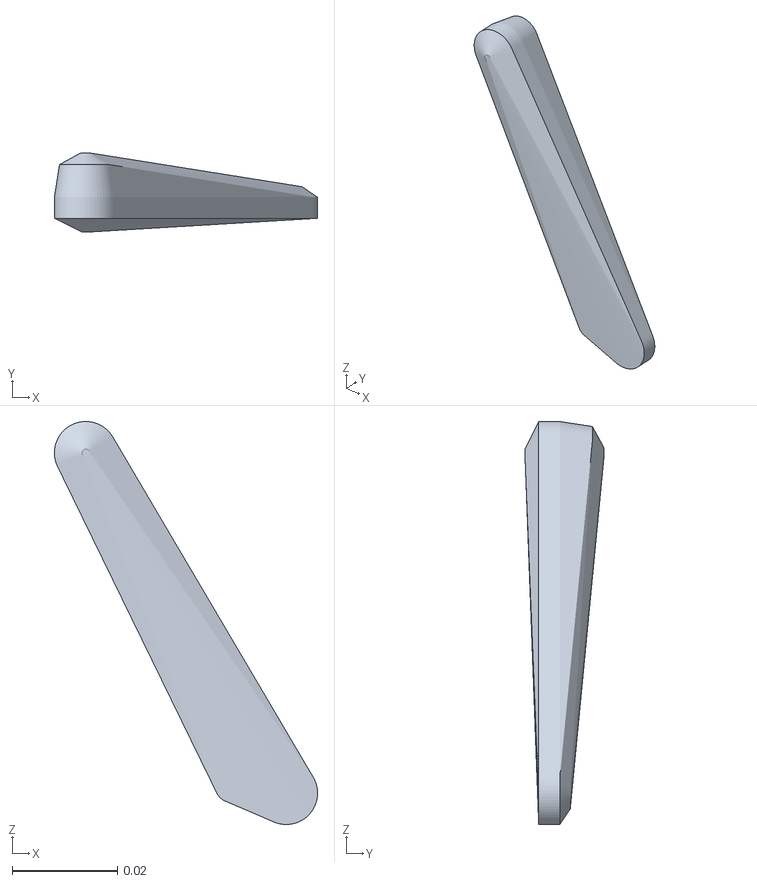
[picture p68: CAD file, 2026-10-06]
v7/meshes/collision/RL_femur.stl
0.05 x 0.015 x 0.0765
