thiagopari/fox_rl_model/v7/meshes/collision/FR_femur.stl

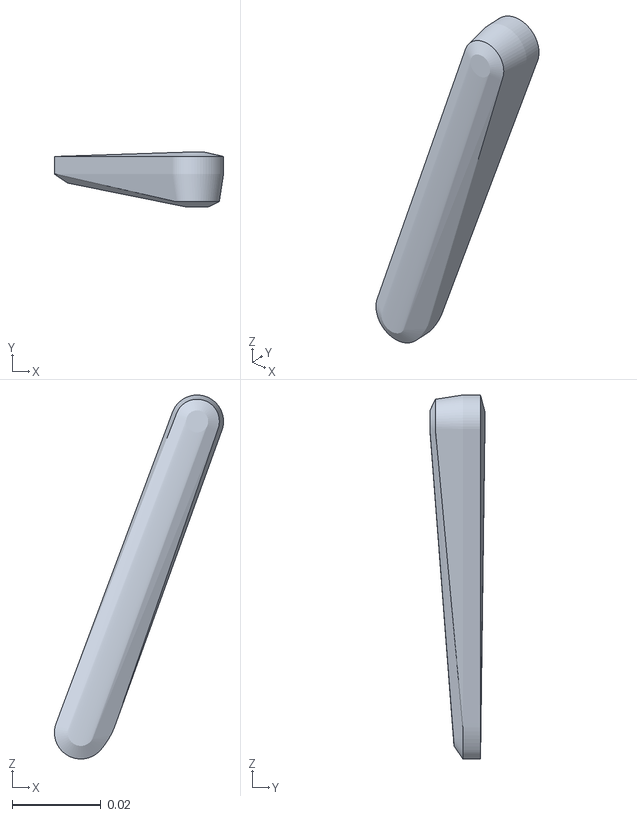
[picture p69: CAD file, 2026-10-06]
v7/meshes/collision/FR_femur.stl
0.0382 x 0.0124 x 0.0822
