thiagopari/fox_rl_model/v7/meshes/collision/RR_hip.stl

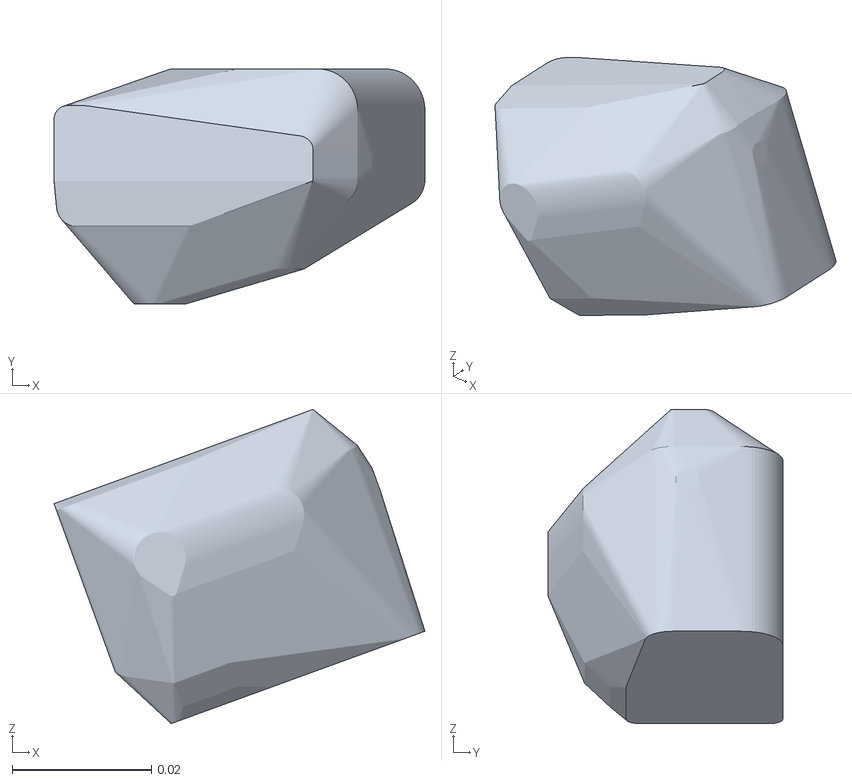
[picture p70: CAD file, 2026-10-06]
v7/meshes/collision/RR_hip.stl
0.0532 x 0.0337 x 0.0451
