thiagopari/fox_rl_model/(list of files, cad)

Other CAD files:
v7/meshes/collision/FR_hip_reduced.stl
v7/meshes/visual/RL_pinion.stl
v7/meshes/visual/RR_gear.stl
raw_v7_nospacer/meshes/FL_pinion.stl
v7/meshes/visual/FR_pinion.stl
raw_v7_nospacer/meshes/FL_gear.stl
v7/meshes/visual/FR_gear.stl
raw_v7_nospacer/meshes/RR_pinion.stl
raw_v7_nospacer/meshes/RL_gear.stl
v7/meshes/collision/RL_gear.stl
print/v7_femur_back_mirrored.stl
raw_v7_nospacer/meshes/FR_gear.stl
print/v7_femur_front_1.stl
v7/meshes/collision/FL_gear.stl
v7/meshes/visual/RR_pinion.stl
print/v7_crank_gear_24T.stl
v7/meshes/collision/RR_pinion.stl
v7/meshes/visual/FL_pinion.stl
v7/meshes/collision/FR_pinion.stl
v7/meshes/visual/RL_gear.stl
raw_v7_nospacer/meshes/RR_foot.stl
raw_v7_nospacer/meshes/FL_link.stl
v7/meshes/collision/RL_foot_reduced.stl
v7/meshes/visual/RL_foot.stl
raw_v7_nospacer/meshes/RR_tibia.stl
v7/meshes/visual/RR_foot.stl
raw_v7_nospacer/meshes/RL_hip.stl
v7/meshes/visual/FL_foot.stl
v7/meshes/visual/FL_femur.stl
v7/meshes/collision/RR_foot_reduced.stl
v7/meshes/visual/FR_link.stl
raw_v7_nospacer/meshes/FR_femur.stl
v7/meshes/visual/FR_foot_reduced.stl
v7/meshes/visual/FL_tibia.stl
v7/meshes/visual/FR_tibia.stl
raw_v7_nospacer/meshes/RR_quad.stl
v7/meshes/visual/RR_quad.stl
raw_v7_nospacer/meshes/RL_link.stl
v7/meshes/visual/RL_femur.stl
raw_v7_nospacer/meshes/FL_foot.stl
v7/meshes/visual/FR_foot.stl
raw_v7_nospacer/meshes/FL_femur.stl
raw_v7_nospacer/meshes/RL_tibia.stl
v7/meshes/collision/RL_foot.stl
raw_v7_nospacer/meshes/FL_quad.stl
v7/meshes/visual/FL_link.stl
v7/meshes/collision/FR_link.stl
v7/meshes/visual/FR_thigh_reduced.stl
v7/meshes/collision/FL_thigh_reduced.stl
v7/meshes/visual/FL_foot_reduced.stl
v7/meshes/collision/FR_tibia.stl
v7/meshes/collision/RR_link.stl
v7/meshes/visual/FR_hip.stl
v7/meshes/visual/RL_tibia.stl
v7/meshes/collision/FL_calf_reduced.stl
v7/meshes/visual/RL_calf_reduced.stl
v7/meshes/visual/RL_foot_reduced.stl
v7/meshes/visual/RR_femur.stl
v7/meshes/collision/FR_foot.stl
v7/meshes/visual/RR_link.stl
v7/meshes/collision/FL_femur.stl
v7/meshes/visual/RR_hip.stl
v7/meshes/collision/FR_foot_reduced.stl
v7/meshes/visual/FR_quad.stl
v7/meshes/collision/FL_quad.stl
v7/meshes/visual/RR_foot_reduced.stl
v7/meshes/collision/RR_foot.stl
v7/meshes/visual/RL_link.stl
v7/meshes/visual/RL_quad.stl
v7/meshes/collision/RL_quad.stl
v7/meshes/visual/FL_quad.stl
v7/meshes/visual/FL_hip.stl
meshes/collision/FL_calf_reduced.stl
meshes/collision/FL_femur.stl
meshes/collision/FL_gear.stl
meshes/collision/FL_hip_reduced.stl
meshes/collision/FL_pinion.stl
meshes/collision/FL_quad.stl
meshes/collision/FL_thigh_reduced.stl
meshes/collision/FR_foot.stl
meshes/collision/FR_foot_reduced.stl
meshes/collision/FR_gear.stl
meshes/collision/FR_hip_reduced.stl
meshes/collision/FR_link.stl
meshes/collision/FR_pinion.stl
meshes/collision/FR_tibia.stl
meshes/collision/RL_foot.stl
meshes/collision/RL_foot_reduced.stl
meshes/collision/RL_gear.stl
meshes/collision/RL_hip_reduced.stl
meshes/collision/RL_pinion.stl
meshes/collision/RL_quad.stl
meshes/collision/RR_foot.stl
meshes/collision/RR_foot_reduced.stl
meshes/collision/RR_gear.stl
meshes/collision/RR_hip_reduced.stl
meshes/collision/RR_link.stl
meshes/collision/RR_pinion.stl
meshes/visual/FL_femur.stl
meshes/visual/FL_foot.stl
meshes/visual/FL_foot_reduced.stl
meshes/visual/FL_gear.stl
meshes/visual/FL_hip.stl
meshes/visual/FL_hip_reduced.stl
meshes/visual/FL_link.stl
meshes/visual/FL_pinion.stl
meshes/visual/FL_quad.stl
meshes/visual/FL_tibia.stl
meshes/visual/FR_foot.stl
meshes/visual/FR_foot_reduced.stl
meshes/visual/FR_gear.stl
meshes/visual/FR_hip.stl
meshes/visual/FR_hip_reduced.stl
meshes/visual/FR_link.stl
meshes/visual/FR_pinion.stl
meshes/visual/FR_quad.stl
meshes/visual/FR_thigh_reduced.stl
meshes/visual/FR_tibia.stl
meshes/visual/RL_calf_reduced.stl
meshes/visual/RL_femur.stl
meshes/visual/RL_foot.stl
meshes/visual/RL_foot_reduced.stl
meshes/visual/RL_gear.stl
meshes/visual/RL_hip_reduced.stl
meshes/visual/RL_link.stl
meshes/visual/RL_pinion.stl
meshes/visual/RL_quad.stl
meshes/visual/RL_tibia.stl
meshes/visual/RR_femur.stl
meshes/visual/RR_foot.stl
meshes/visual/RR_foot_reduced.stl
meshes/visual/RR_gear.stl
meshes/visual/RR_hip.stl
meshes/visual/RR_hip_reduced.stl
meshes/visual/RR_link.stl
meshes/visual/RR_pinion.stl
meshes/visual/RR_quad.stl
raw_v7/meshes/FL_femur.stl
raw_v7/meshes/FL_foot.stl
raw_v7/meshes/FL_gear.stl
raw_v7/meshes/FL_hip.stl
raw_v7/meshes/FL_link.stl
raw_v7/meshes/FL_pinion.stl
raw_v7/meshes/FL_quad.stl
raw_v7/meshes/FL_tibia.stl
raw_v7/meshes/FR_femur.stl
raw_v7/meshes/FR_foot.stl
raw_v7/meshes/FR_gear.stl
raw_v7/meshes/FR_hip.stl
raw_v7/meshes/FR_link.stl
raw_v7/meshes/FR_pinion.stl
raw_v7/meshes/FR_quad.stl
raw_v7/meshes/FR_tibia.stl
raw_v7/meshes/RL_femur.stl
raw_v7/meshes/RL_foot.stl
raw_v7/meshes/RL_gear.stl
raw_v7/meshes/RL_hip.stl
raw_v7/meshes/RL_link.stl
raw_v7/meshes/RL_pinion.stl
raw_v7/meshes/RL_quad.stl
raw_v7/meshes/RL_tibia.stl
raw_v7/meshes/RR_femur.stl
raw_v7/meshes/RR_foot.stl
raw_v7/meshes/RR_gear.stl
raw_v7/meshes/RR_hip.stl
raw_v7/meshes/RR_link.stl
raw_v7/meshes/RR_pinion.stl
raw_v7/meshes/RR_quad.stl
raw_v7/meshes/RR_tibia.stl
