thiagopari/fox_rl_model/vio/results/sweep.csv

panel | level | ate | ate_max | scale | poses | first | vo_ate
baseline | 0 | 0.0152 | 0.0414 | 0.9938 | 1537 | 5.7667
time_offset | 5 | 0.2928 | 0.3897 | 0.8562 | 1537 | 5.7717
time_offset | 10 | 0.5890 | 0.7778 | 0.7474 | 1537 | 5.7767
time_offset | 20 | 1006.8356 | 2255.3388 | 0.0013 | 1538 | 5.7533
time_offset | 40 | 3325.0124 | 7232.6509 | 0.0004 | 1537 | 5.7733
time_offset+calib | 40 | 0.0618 | 0.2971 | 0.9767 | 1538 | 5.7608
extrinsic | 1 | 0.0140 | 0.0422 | 0.9968 | 1537 | 5.7667
extrinsic | 2 | 0.0170 | 0.0399 | 1.0031 | 1537 | 5.7667
extrinsic | 5 | 0.0730 | 0.1186 | 1.0391 | 1537 | 5.7667
extrinsic+calib | 5 | 0.0276 | 0.0556 | 0.9858 | 1537 | 5.7667
vibration | 2 | 0.0250 | 0.0410 | 0.9881 | 1537 | 5.7667
vibration | 5 | 5.6721 | 24.8903 | 0.1708 | 1537 | 5.7667
vibration | 10 | 720.1647 | 1671.5672 | 0.0018 | 1537 | 5.7667
bias_rw | 10 | 0.0205 | 0.0577 | 0.9928 | 1537 | 5.7667
noise | 0.2500 | 0.0199 | 0.0558 | 0.9996 | 1537 | 5.7667 | 0.0280
noise | 1 | 0.0289 | 0.0876 | 1.0027 | 1537 | 5.7667 | 0.0290
noise | 4 | 0.0285 | 0.0433 | 0.9908 | 1535 | 5.8333 | 0.0390
blur | 5 | 0.0160 | 0.0383 | 0.9941 | 1537 | 5.7667 | 0.0290
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
