thiagopari/fox_rl_model/v7/validation/cad/rear_stack_section.png

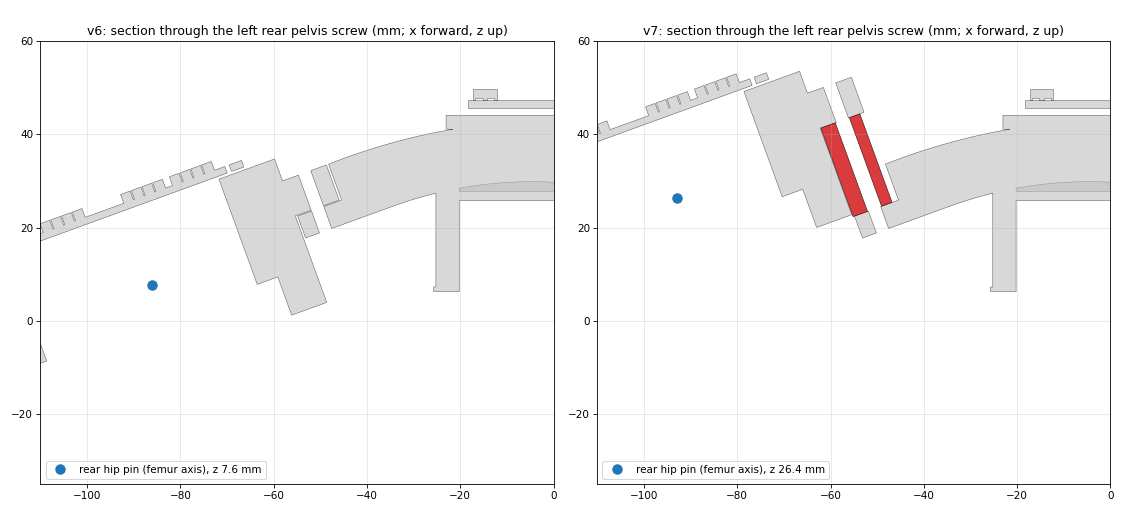
v7/validation/cad/rear_stack_section.png
