thiagopari/fox_rl_model/v7/validation/cad/v7_FL_gears.png

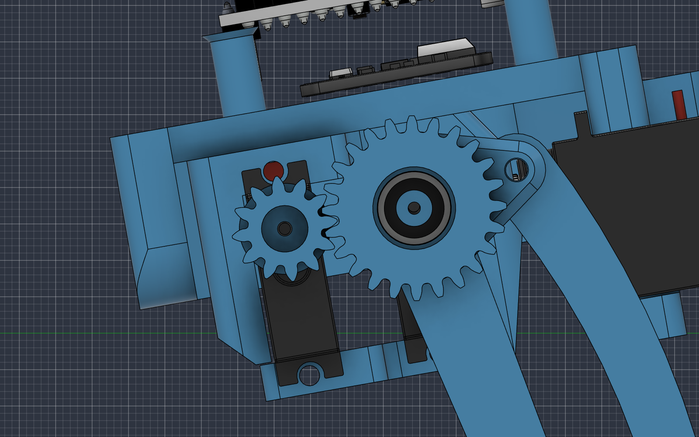
v7/validation/cad/v7_FL_gears.png
