thiagopari/fox_rl_model/v7/validation/cad/v7_iso.png

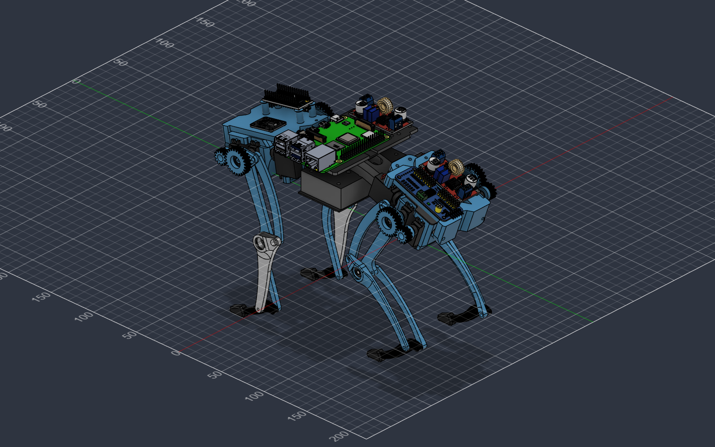
v7/validation/cad/v7_iso.png
