thiagopari/fox_rl_model/v7/validation/cad/v7_left.png

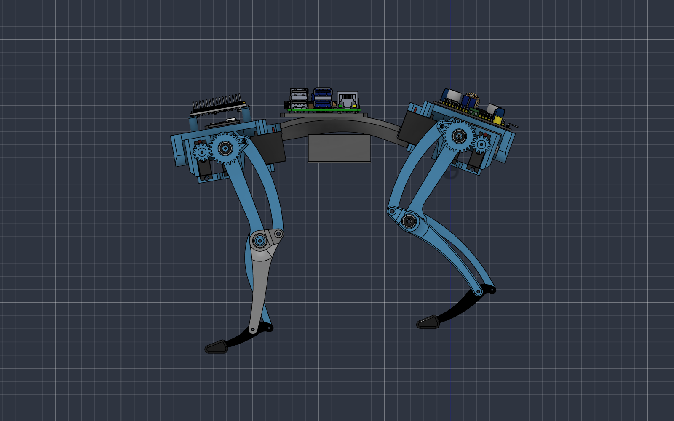
v7/validation/cad/v7_left.png
