thiagopari/fox_rl_model/v7/validation/cad/v7_rear_side.png

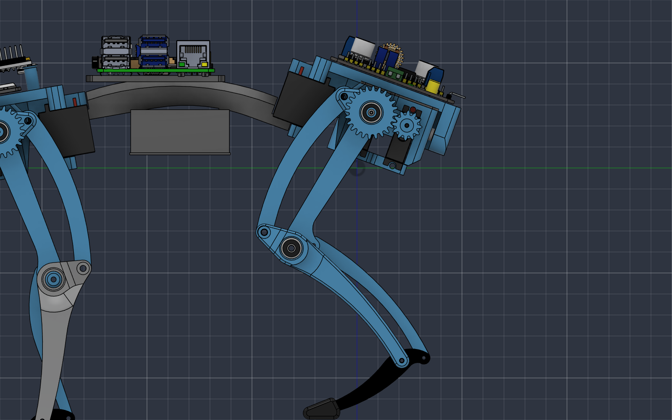
v7/validation/cad/v7_rear_side.png
