thiagopari/fox_rl_model/v7/validation/cad/v7_spacer.png

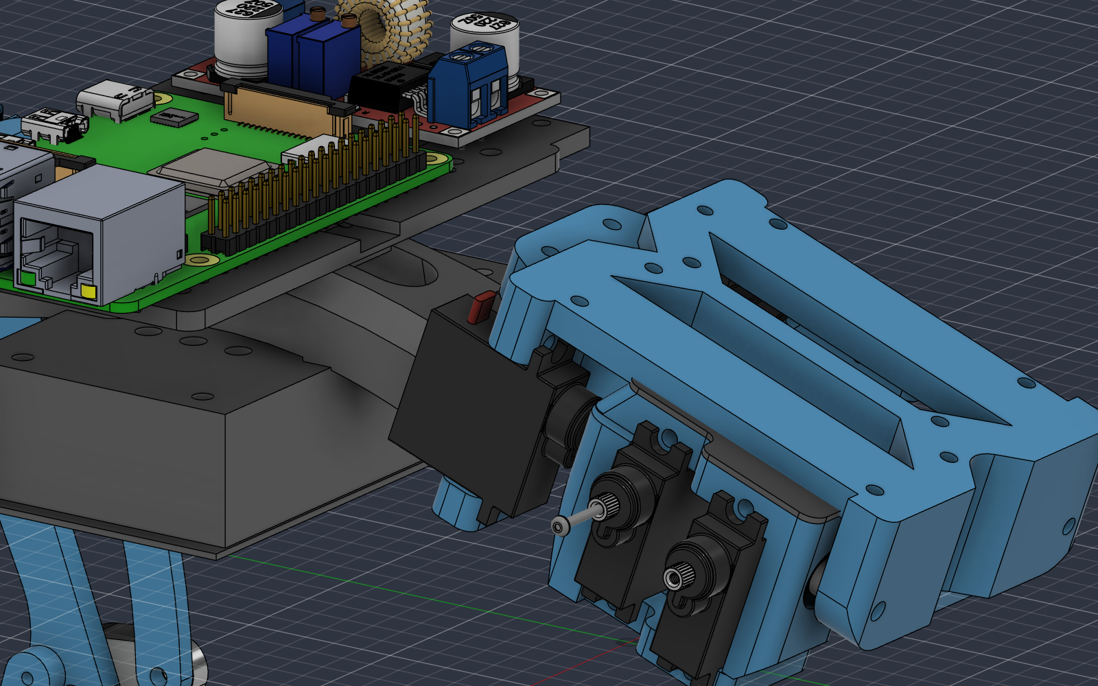
v7/validation/cad/v7_spacer.png
