thiagopari/fox_rl_model/v7/validation/cad_v7b/v7b_left.png

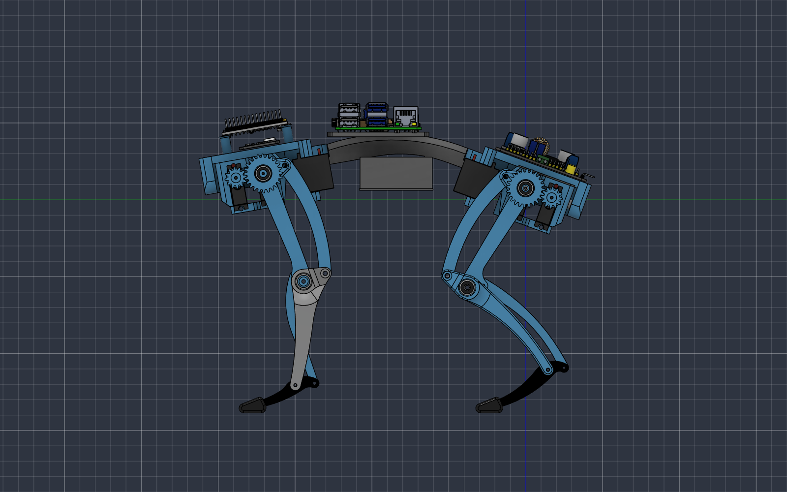
v7/validation/cad_v7b/v7b_left.png
