thiagopari/fox_rl_model/v7/validation/cad_v7b/v7b_rear_side.png

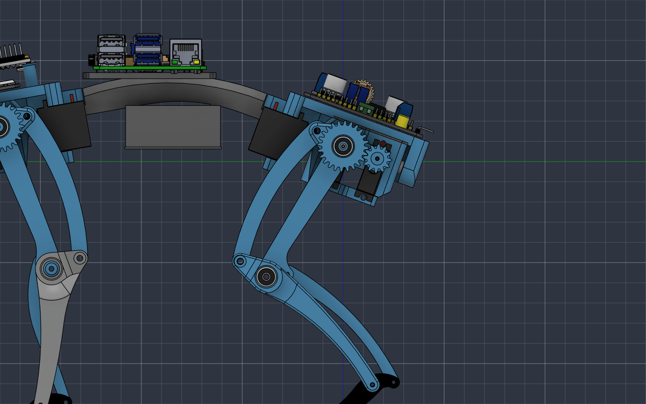
v7/validation/cad_v7b/v7b_rear_side.png
