thiagopari/fox_rl_model/v7/validation/mujoco_front_left.png

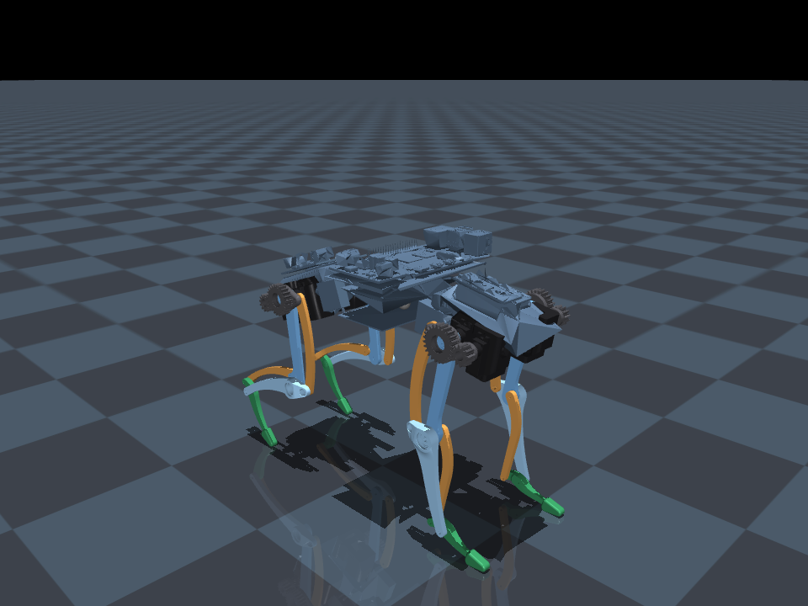
v7/validation/mujoco_front_left.png
