thiagopari/fox_rl_model/v7/validation/mujoco_poses.png

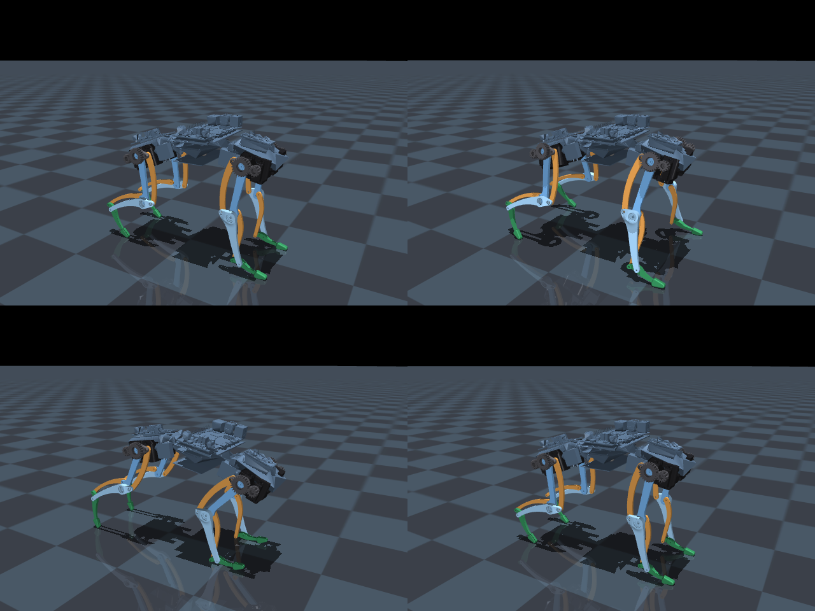
v7/validation/mujoco_poses.png
