thiagopari/fox_rl_model/v7/validation/mujoco_rear_right.png

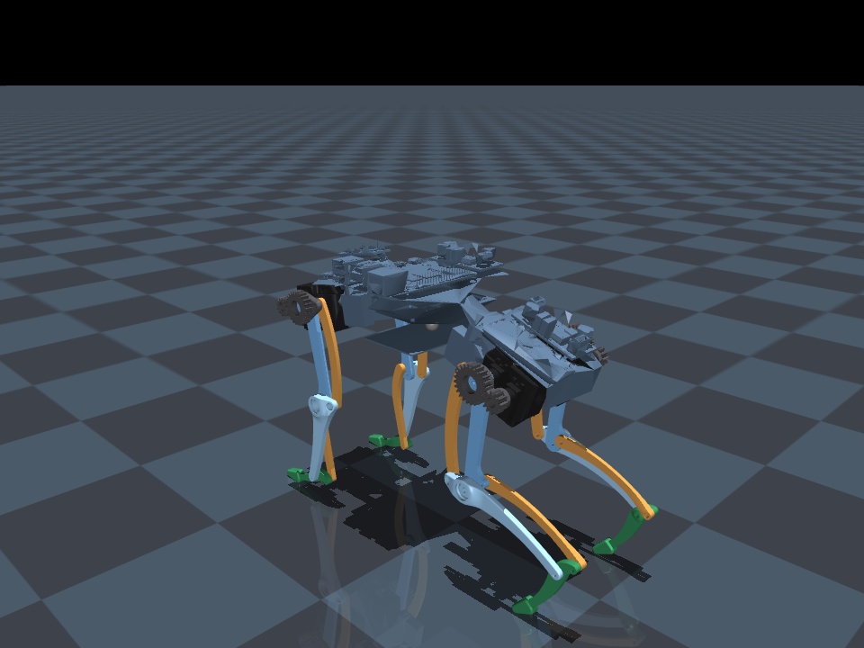
v7/validation/mujoco_rear_right.png
