thiagopari/fox_rl_model/v7/validation/mujoco_servo_roles.png

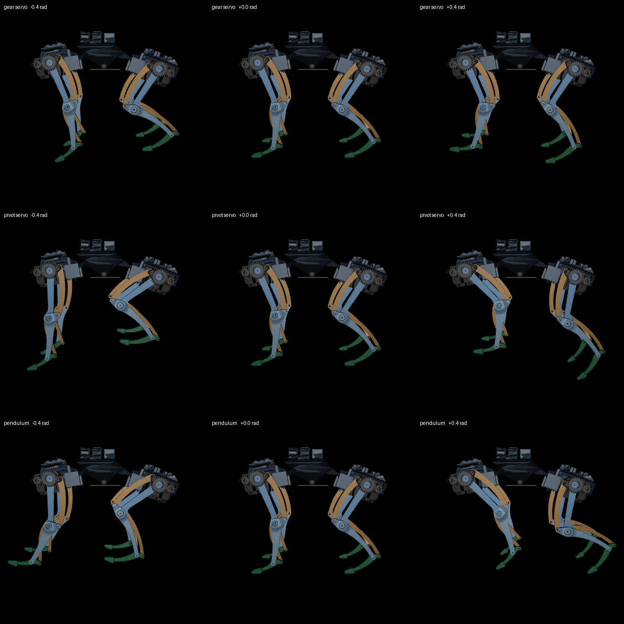
v7/validation/mujoco_servo_roles.png
