thiagopari/fox_rl_model/v7/validation/on_stand_servos.png

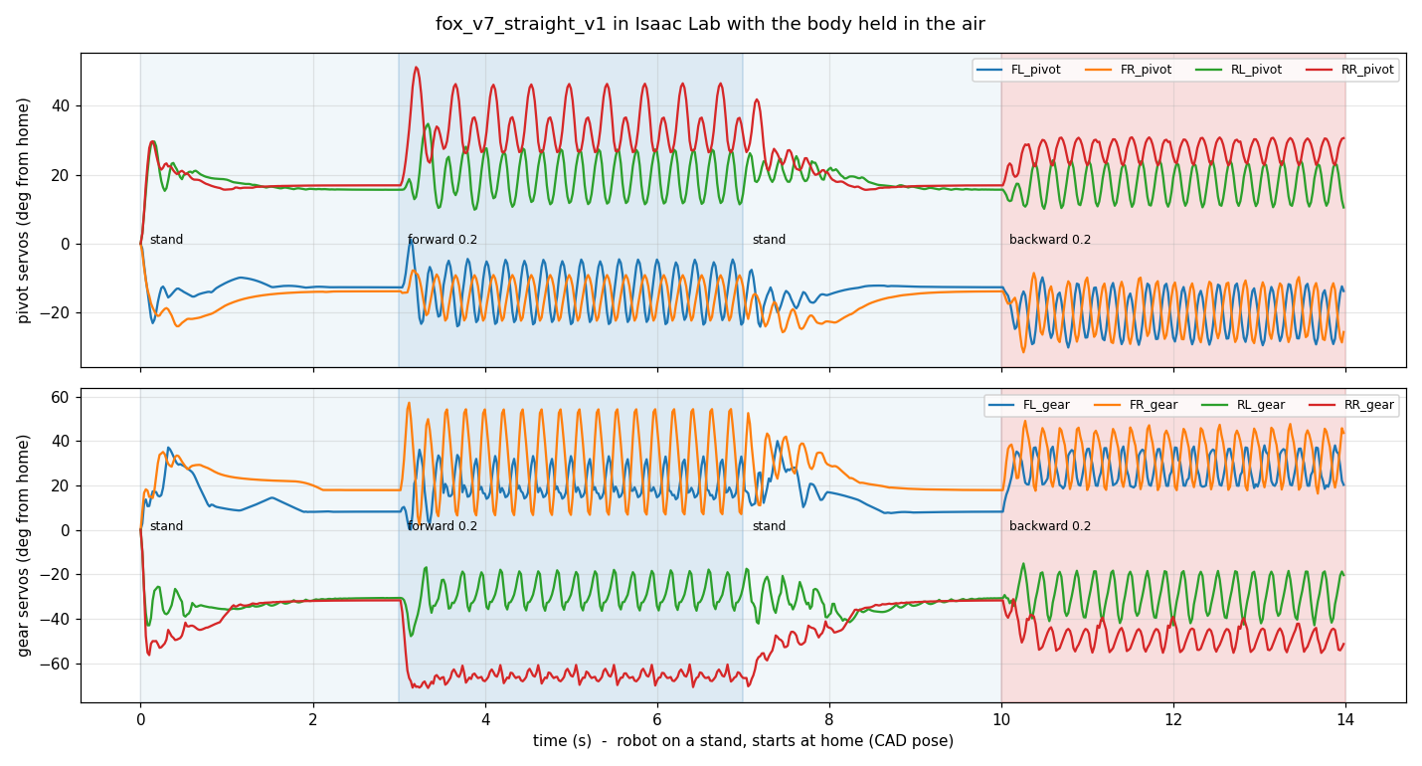
v7/validation/on_stand_servos.png
