thiagopari/fox_rl_model/v7/validation/policy_start_pose.png

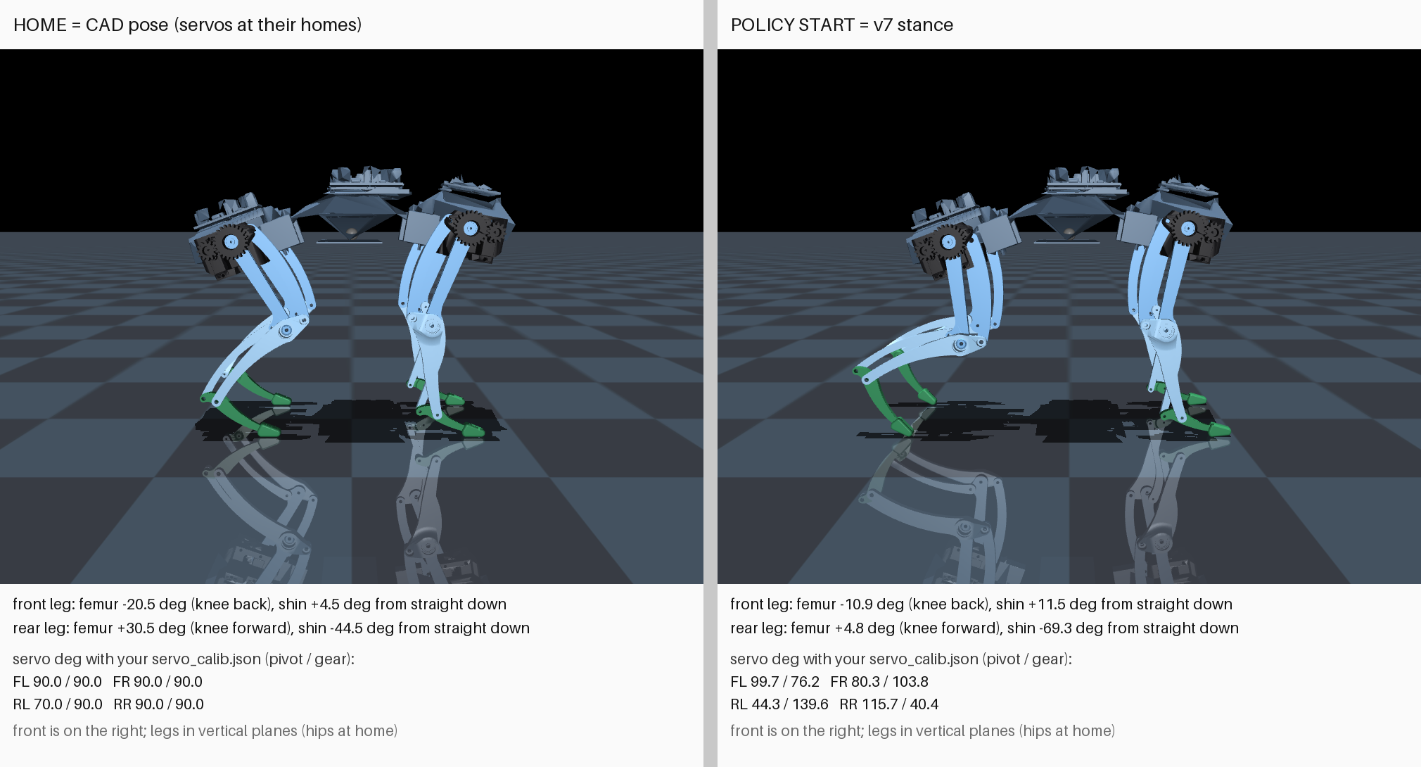
v7/validation/policy_start_pose.png
