thiagopari/fox_rl_model/validation/isaacsim_stand.png

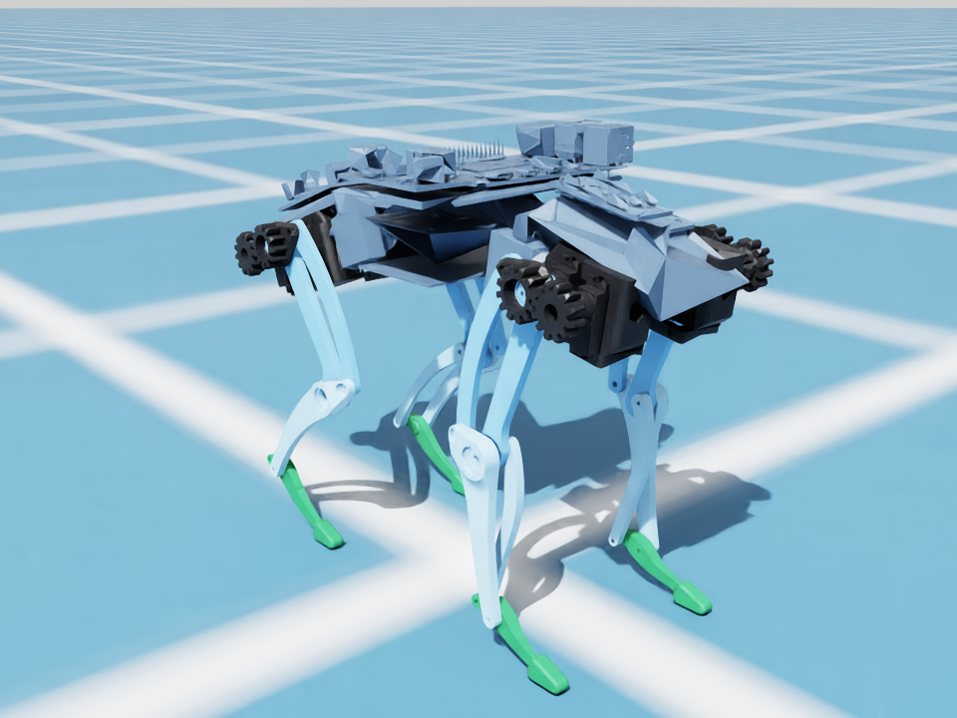
validation/isaacsim_stand.png
