thiagopari/fox_rl_model/validation/mujoco_hip_abduction.png

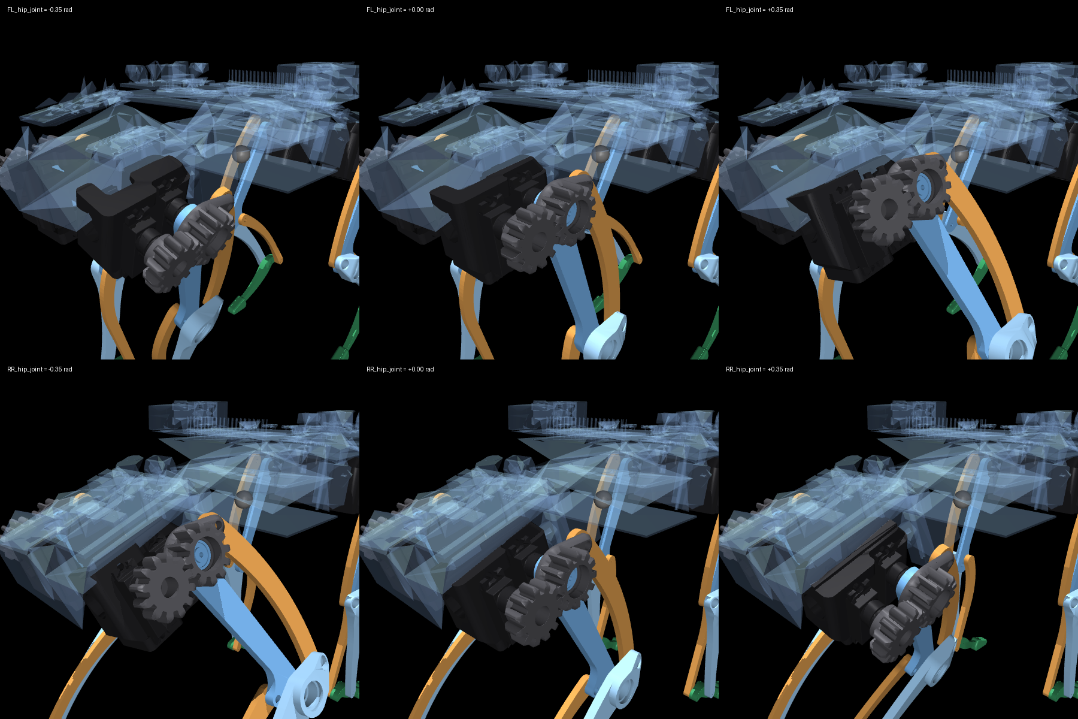
validation/mujoco_hip_abduction.png
