thiagopari/fox_rl_model/v7/mjcf/fox.xml

<mujoco model="fox">
  <compiler angle="radian" meshdir="../meshes" autolimits="true"/>
  <option timestep="0.002" integrator="implicitfast"/>
  <default>
    <joint armature="0.0005" damping="0.01" frictionloss="0.002"/>
    <default class="pin"><joint armature="1e-06" damping="0.0001" frictionloss="0"/></default>
    <position kp="5" kv="0.08" forcerange="-0.47 0.47" inheritrange="1"/>
    <equality solref="0.004 1" solimp="0.999 0.9999 0.0005 0.5 2"/>
    <default class="visual"><geom type="mesh" contype="0" conaffinity="0" group="2" density="0"/></default>
    <default class="collision"><geom type="mesh" contype="1" conaffinity="0" group="3" density="0" friction="1.0 0.02 0.01" condim="3"/></default>
  </default>
  <asset>
    <mesh name="base_vis" file="visual/base.stl"/>
    <mesh name="base_col" file="collision/base.stl"/>
    <mesh name="FL_hip_vis" file="visual/FL_hip.stl"/>
    <mesh name="FL_hip_col" file="collision/FL_hip.stl"/>
    <mesh name="FL_pinion_vis" file="visual/FL_pinion.stl"/>
    <mesh name="FL_pinion_col" file="collision/FL_pinion.stl"/>
    <mesh name="FL_gear_vis" file="visual/FL_gear.stl"/>
    <mesh name="FL_gear_col" file="collision/FL_gear.stl"/>
    <mesh name="FL_femur_vis" file="visual/FL_femur.stl"/>
    <mesh name="FL_femur_col" file="collision/FL_femur.stl"/>
    <mesh name="FL_quad_vis" file="visual/FL_quad.stl"/>
    <mesh name="FL_quad_col" file="collision/FL_quad.stl"/>
    <mesh name="FL_tibia_vis" file="visual/FL_tibia.stl"/>
    <mesh name="FL_tibia_col" file="collision/FL_tibia.stl"/>
    <mesh name="FL_foot_vis" file="visual/FL_foot.stl"/>
    <mesh name="FL_foot_col" file="collision/FL_foot.stl"/>
    <mesh name="FL_link_vis" file="visual/FL_link.stl"/>
    <mesh name="FL_link_col" file="collision/FL_link.stl"/>
    <mesh name="FR_hip_vis" file="visual/FR_hip.stl"/>
    <mesh name="FR_hip_col" file="collision/FR_hip.stl"/>
    <mesh name="FR_pinion_vis" file="visual/FR_pinion.stl"/>
    <mesh name="FR_pinion_col" file="collision/FR_pinion.stl"/>
    <mesh name="FR_gear_vis" file="visual/FR_gear.stl"/>
    <mesh name="FR_gear_col" file="collision/FR_gear.stl"/>
    <mesh name="FR_femur_vis" file="visual/FR_femur.stl"/>
    <mesh name="FR_femur_col" file="collision/FR_femur.stl"/>
    <mesh name="FR_quad_vis" file="visual/FR_quad.stl"/>
    <mesh name="FR_quad_col" file="collision/FR_quad.stl"/>
    <mesh name="FR_tibia_vis" file="visual/FR_tibia.stl"/>
    <mesh name="FR_tibia_col" file="collision/FR_tibia.stl"/>
    <mesh name="FR_foot_vis" file="visual/FR_foot.stl"/>
    <mesh name="FR_foot_col" file="collision/FR_foot.stl"/>
    <mesh name="FR_link_vis" file="visual/FR_link.stl"/>
    <mesh name="FR_link_col" file="collision/FR_link.stl"/>
    <mesh name="RL_hip_vis" file="visual/RL_hip.stl"/>
    <mesh name="RL_hip_col" file="collision/RL_hip.stl"/>
    <mesh name="RL_pinion_vis" file="visual/RL_pinion.stl"/>
    <mesh name="RL_pinion_col" file="collision/RL_pinion.stl"/>
    <mesh name="RL_gear_vis" file="visual/RL_gear.stl"/>
    <mesh name="RL_gear_col" file="collision/RL_gear.stl"/>
    <mesh name="RL_femur_vis" file="visual/RL_femur.stl"/>
    <mesh name="RL_femur_col" file="collision/RL_femur.stl"/>
    <mesh name="RL_quad_vis" file="visual/RL_quad.stl"/>
    <mesh name="RL_quad_col" file="collision/RL_quad.stl"/>
    <mesh name="RL_tibia_vis" file="visual/RL_tibia.stl"/>
    <mesh name="RL_tibia_col" file="collision/RL_tibia.stl"/>
    <mesh name="RL_foot_vis" file="visual/RL_foot.stl"/>
    <mesh name="RL_foot_col" file="collision/RL_foot.stl"/>
    <mesh name="RL_link_vis" file="visual/RL_link.stl"/>
    <mesh name="RL_link_col" file="collision/RL_link.stl"/>
    <mesh name="RR_hip_vis" file="visual/RR_hip.stl"/>
    <mesh name="RR_hip_col" file="collision/RR_hip.stl"/>
    <mesh name="RR_pinion_vis" file="visual/RR_pinion.stl"/>
    <mesh name="RR_pinion_col" file="collision/RR_pinion.stl"/>
    <mesh name="RR_gear_vis" file="visual/RR_gear.stl"/>
    <mesh name="RR_gear_col" file="collision/RR_gear.stl"/>
    <mesh name="RR_femur_vis" file="visual/RR_femur.stl"/>
    <mesh name="RR_femur_col" file="collision/RR_femur.stl"/>
    <mesh name="RR_quad_vis" file="visual/RR_quad.stl"/>
    <mesh name="RR_quad_col" file="collision/RR_quad.stl"/>
    <mesh name="RR_tibia_vis" file="visual/RR_tibia.stl"/>
    <mesh name="RR_tibia_col" file="collision/RR_tibia.stl"/>
    <mesh name="RR_foot_vis" file="visual/RR_foot.stl"/>
    <mesh name="RR_foot_col" file="collision/RR_foot.stl"/>
    <mesh name="RR_link_vis" file="visual/RR_link.stl"/>
    <mesh name="RR_link_col" file="collision/RR_link.stl"/>
  </asset>
  <worldbody>
    <body name="base" pos="0.000000 0.000000 0.152840">
      <freejoint name="root"/>
      <inertial pos="-0.000626 0.000923 0.016196" mass="0.330454" fullinertia="2.7830e-04 1.4975e-03 1.6114e-03 -4.0202e-06 -9.4188e-05 -9.4332e-06"/>
      <geom class="visual" mesh="base_vis" rgba="0.33 0.42 0.52 1"/>
      <geom class="collision" mesh="base_col"/>
      <site name="imu" pos="0 0 0"/>
      <body name="FL_hip" pos="0.071686 0.024238 0.007390">
        <joint name="FL_hip_joint" axis="0.984808 0 -0.173648" range="-0.5000 0.5000"/>
        <inertial pos="0.019700 0.000171 -0.009614" mass="0.029637" fullinertia="3.9041e-06 6.8017e-06 6.0682e-06 -8.1673e-07 1.8878e-07 -1.3949e-07"/>
        <geom class="visual" mesh="FL_hip_vis" rgba="0.12 0.12 0.13 1"/>
        <geom class="collision" mesh="FL_hip_col"/>
        <body name="FL_femur" pos="0.013073 0.017273 -0.002610">
          <joint name="FL_femur_joint" axis="0 1 0" range="-1.2000 1.2000"/>
          <inertial pos="-0.012342 0.001294 -0.031474" mass="0.004892" fullinertia="2.9926e-06 3.4422e-06 4.9069e-07 -2.7059e-08 -1.1146e-06 -6.8278e-08"/>
          <geom class="visual" mesh="FL_femur_vis" rgba="0.45 0.68 0.9 1"/>
          <geom class="collision" mesh="FL_femur_col"/>
          <body name="FL_tibia" pos="-0.026269 0.000000 -0.070249">
            <joint name="FL_knee_joint" axis="0 1 0" class="pin" range="-1.2000 1.2000"/>
            <inertial pos="-0.001466 0.006306 -0.020112" mass="0.005495" fullinertia="2.6534e-06 2.8151e-06 1.9387e-07 3.8980e-09 3.4710e-07 -5.8545e-08"/>
            <geom class="visual" mesh="FL_tibia_vis" rgba="0.62 0.8 0.95 1"/>
            <geom class="collision" mesh="FL_tibia_col"/>
            <body name="FL_foot" pos="0.005365 0.002750 -0.067459">
              <joint name="FL_ankle_joint" axis="-0 1 0" class="pin"/>
              <inertial pos="0.010962 -0.001369 -0.006584" mass="0.002518" fullinertia="1.2566e-07 6.3852e-07 5.2978e-07 -1.9020e-08 2.2656e-07 9.0232e-09"/>
              <geom class="visual" mesh="FL_foot_vis" rgba="0.2 0.55 0.35 1"/>
              <geom class="collision" mesh="FL_foot_col"/>
            </body>
          </body>
          <body name="FL_link" pos="-0.021174 -0.001350 -0.067174">
            <joint name="FL_link_pin_joint" axis="0 1 -0" class="pin"/>
            <inertial pos="-0.001602 -0.002100 -0.031180" mass="0.002351" fullinertia="1.0619e-06 1.1189e-06 6.3295e-08 6.9389e-22 -2.0390e-07 -2.7756e-21"/>
            <geom class="visual" mesh="FL_link_vis" rgba="0.85 0.6 0.3 1"/>
            <geom class="collision" mesh="FL_link_col"/>
          </body>
        </body>
        <body name="FL_pinion" pos="0.030851 0.021574 -0.005440">
          <joint name="FL_pinion_joint" axis="0 1 0" range="-1.5000 1.5000"/>
          <inertial pos="-0.000000 0.003991 0.000000" mass="0.001242" fullinertia="2.4968e-08 2.8457e-08 2.4968e-08 4.7115e-15 -4.5171e-15 1.3147e-13"/>
          <geom class="visual" mesh="FL_pinion_vis" rgba="0.3 0.3 0.32 1"/>
          <geom class="collision" mesh="FL_pinion_col"/>
        </body>
        <body name="FL_gear" pos="0.013073 0.017273 -0.002610">
          <joint name="FL_gear_joint" axis="0 1 0" class="pin"/>
          <inertial pos="-0.000793 0.008634 0.000296" mass="0.004045" fullinertia="1.9190e-07 3.4494e-07 2.2208e-07 -1.1349e-08 1.3114e-08 4.2423e-09"/>
          <geom class="visual" mesh="FL_gear_vis" rgba="0.3 0.3 0.32 1"/>
          <geom class="collision" mesh="FL_gear_col"/>
          <body name="FL_quad" pos="-0.014050 0.003650 0.005252">
            <joint name="FL_crank_pin_joint" axis="-0 1 -0" class="pin"/>
            <inertial pos="-0.015922 -0.001600 -0.031734" mass="0.002608" fullinertia="1.2810e-06 1.4922e-06 2.1513e-07 -9.7145e-21 -4.8116e-07 1.0755e-20"/>
            <geom class="visual" mesh="FL_quad_vis" rgba="0.85 0.6 0.3 1"/>
            <geom class="collision" mesh="FL_quad_col"/>
          </body>
        </body>
      </body>
      <body name="FR_hip" pos="0.071686 -0.024262 0.007390">
        <joint name="FR_hip_joint" axis="0.984808 0 -0.173648" range="-0.5000 0.5000"/>
        <inertial pos="0.019655 -0.000085 -0.009564" mass="0.029637" fullinertia="3.8948e-06 6.8294e-06 6.0767e-06 7.9968e-07 2.0276e-07 1.4076e-07"/>
        <geom class="visual" mesh="FR_hip_vis" rgba="0.12 0.12 0.13 1"/>
        <geom class="collision" mesh="FR_hip_col"/>
        <body name="FR_femur" pos="0.013073 -0.017248 -0.002610">
          <joint name="FR_femur_joint" axis="0 1 0" range="-1.2000 1.2000"/>
          <inertial pos="-0.012344 -0.001294 -0.031473" mass="0.004892" fullinertia="2.9930e-06 3.4425e-06 4.9053e-07 2.7070e-08 -1.1144e-06 6.8262e-08"/>
          <geom class="visual" mesh="FR_femur_vis" rgba="0.45 0.68 0.9 1"/>
          <geom class="collision" mesh="FR_femur_col"/>
          <body name="FR_tibia" pos="-0.026269 0.000000 -0.070249">
            <joint name="FR_knee_joint" axis="0 1 0" class="pin" range="-1.2000 1.2000"/>
            <inertial pos="-0.001384 -0.006335 -0.018973" mass="0.005825" fullinertia="2.7820e-06 2.9461e-06 1.9727e-07 -3.6641e-09 3.3799e-07 6.1768e-08"/>
            <geom class="visual" mesh="FR_tibia_vis" rgba="0.62 0.8 0.95 1"/>
            <geom class="collision" mesh="FR_tibia_col"/>
            <body name="FR_foot" pos="0.005365 -0.002750 -0.067459">
              <joint name="FR_ankle_joint" axis="-0 1 0" class="pin"/>
              <inertial pos="0.010962 0.001369 -0.006584" mass="0.002518" fullinertia="1.2566e-07 6.3852e-07 5.2978e-07 1.9020e-08 2.2656e-07 -9.0234e-09"/>
              <geom class="visual" mesh="FR_foot_vis" rgba="0.2 0.55 0.35 1"/>
              <geom class="collision" mesh="FR_foot_col"/>
            </body>
          </body>
          <body name="FR_link" pos="-0.021174 0.001350 -0.067174">
            <joint name="FR_link_pin_joint" axis="0 1 -0" class="pin"/>
            <inertial pos="-0.001602 0.002100 -0.031180" mass="0.002351" fullinertia="1.0619e-06 1.1189e-06 6.3295e-08 -6.9389e-22 -2.0390e-07 8.3267e-21"/>
            <geom class="visual" mesh="FR_link_vis" rgba="0.85 0.6 0.3 1"/>
            <geom class="collision" mesh="FR_link_col"/>
          </body>
        </body>
        <body name="FR_pinion" pos="0.030860 -0.021331 -0.005441">
          <joint name="FR_pinion_joint" axis="0 1 0" range="-1.5000 1.5000"/>
          <inertial pos="-0.000001 -0.004202 0.000000" mass="0.001242" fullinertia="2.5036e-08 2.8457e-08 2.5036e-08 1.5650e-11 -5.3224e-15 -2.9780e-12"/>
          <geom class="visual" mesh="FR_pinion_vis" rgba="0.3 0.3 0.32 1"/>
          <geom class="collision" mesh="FR_pinion_col"/>
        </body>
        <body name="FR_gear" pos="0.013073 -0.017248 -0.002610">
          <joint name="FR_gear_joint" axis="0 1 0" class="pin"/>
          <inertial pos="-0.000793 -0.008635 0.000296" mass="0.004045" fullinertia="1.9190e-07 3.4494e-07 2.2208e-07 1.1349e-08 1.3114e-08 -4.2423e-09"/>
          <geom class="visual" mesh="FR_gear_vis" rgba="0.3 0.3 0.32 1"/>
          <geom class="collision" mesh="FR_gear_col"/>
          <body name="FR_quad" pos="-0.014050 -0.003650 0.005252">
            <joint name="FR_crank_pin_joint" axis="-0 1 -0" class="pin"/>
            <inertial pos="-0.015922 0.001600 -0.031734" mass="0.002608" fullinertia="1.2810e-06 1.4922e-06 2.1513e-07 1.3184e-20 -4.8116e-07 -3.4694e-21"/>
            <geom class="visual" mesh="FR_quad_vis" rgba="0.85 0.6 0.3 1"/>
            <geom class="collision" mesh="FR_quad_col"/>
          </body>
        </body>
      </body>
      <body name="RL_hip" pos="-0.073606 0.024238 -0.000351">
        <joint name="RL_hip_joint" axis="0.939693 0 0.34202" range="-0.5000 0.5000"/>
        <inertial pos="-0.017765 0.000192 -0.012504" mass="0.030137" fullinertia="4.1667e-06 7.0408e-06 6.0618e-06 8.3795e-07 -4.9538e-07 -4.1078e-09"/>
        <geom class="visual" mesh="RL_hip_vis" rgba="0.12 0.12 0.13 1"/>
        <geom class="collision" mesh="RL_hip_col"/>
        <body name="RL_femur" pos="-0.012394 0.017273 -0.004429">
          <joint name="RL_femur_joint" axis="-0 1 -0" range="-1.2000 1.2000"/>
          <inertial pos="0.017979 0.001290 -0.030090" mass="0.005150" fullinertia="2.8108e-06 3.7559e-06 9.8944e-07 4.2601e-08 1.5752e-06 -7.1122e-08"/>
          <geom class="visual" mesh="RL_femur_vis" rgba="0.45 0.68 0.9 1"/>
          <geom class="collision" mesh="RL_femur_col"/>
          <body name="RL_tibia" pos="0.038069 0.001750 -0.064620">
            <joint name="RL_knee_joint" axis="0 1 0" class="pin" range="-1.2000 0.7400"/>
            <inertial pos="-0.015755 0.004603 -0.013635" mass="0.005301" fullinertia="1.6361e-06 3.5704e-06 1.9640e-06 -5.2016e-08 -1.6942e-06 -4.4316e-08"/>
            <geom class="visual" mesh="RL_tibia_vis" rgba="0.62 0.8 0.95 1"/>
            <geom class="collision" mesh="RL_tibia_col"/>
            <body name="RL_foot" pos="-0.052566 0.001000 -0.053496">
              <joint name="RL_ankle_joint" axis="-0 1 0" class="pin"/>
              <inertial pos="0.017232 -0.001193 -0.012323" mass="0.003072" fullinertia="3.3629e-07 1.2058e-06 8.8582e-07 -2.1672e-08 5.0888e-07 1.3432e-08"/>
              <geom class="visual" mesh="RL_foot_vis" rgba="0.2 0.55 0.35 1"/>
              <geom class="collision" mesh="RL_foot_col"/>
            </body>
          </body>
          <body name="RL_link" pos="0.027590 -0.000850 -0.063328">
            <joint name="RL_link_pin_joint" axis="0 1 0" class="pin"/>
            <inertial pos="-0.027939 -0.002270 -0.023343" mass="0.002056" fullinertia="6.7350e-07 1.3233e-06 6.5421e-07 -8.0513e-09 -6.4372e-07 -9.4510e-09"/>
            <geom class="visual" mesh="RL_link_vis" rgba="0.85 0.6 0.3 1"/>
            <geom class="collision" mesh="RL_link_col"/>
          </body>
        </body>
        <body name="RL_pinion" pos="-0.029309 0.021574 -0.010585">
          <joint name="RL_pinion_joint" axis="-0 1 0" range="-1.5000 1.5000"/>
          <inertial pos="0.000000 0.003991 -0.000001" mass="0.001242" fullinertia="2.4967e-08 2.8456e-08 2.4967e-08 1.7687e-13 9.7104e-15 2.1886e-13"/>
          <geom class="visual" mesh="RL_pinion_vis" rgba="0.3 0.3 0.32 1"/>
          <geom class="collision" mesh="RL_pinion_col"/>
        </body>
        <body name="RL_gear" pos="-0.012394 0.017273 -0.004429">
          <joint name="RL_gear_joint" axis="-0 1 -0" class="pin"/>
          <inertial pos="0.000730 0.008634 0.000430" mass="0.004045" fullinertia="1.9729e-07 3.4494e-07 2.1668e-07 1.0439e-08 -1.7486e-08 6.1494e-09"/>
          <geom class="visual" mesh="RL_gear_vis" rgba="0.3 0.3 0.32 1"/>
          <geom class="collision" mesh="RL_gear_col"/>
          <body name="RL_quad" pos="0.012924 0.003650 0.007614">
            <joint name="RL_crank_pin_joint" axis="0 1 0" class="pin"/>
            <inertial pos="0.021186 -0.001600 -0.028498" mass="0.002615" fullinertia="1.0914e-06 1.5019e-06 4.1433e-07 -6.9389e-22 6.3852e-07 2.4286e-21"/>
            <geom class="visual" mesh="RL_quad_vis" rgba="0.85 0.6 0.3 1"/>
            <geom class="collision" mesh="RL_quad_col"/>
          </body>
        </body>
      </body>
      <body name="RR_hip" pos="-0.073382 -0.024238 -0.000188">
        <joint name="RR_hip_joint" axis="0.939693 0 0.34202" range="-0.5000 0.5000"/>
        <inertial pos="-0.017248 0.000038 -0.013309" mass="0.031628" fullinertia="4.4267e-06 7.5621e-06 6.4034e-06 -8.8515e-07 -4.6400e-07 5.1350e-08"/>
        <geom class="visual" mesh="RR_hip_vis" rgba="0.12 0.12 0.13 1"/>
        <geom class="collision" mesh="RR_hip_col"/>
        <body name="RR_femur" pos="-0.012618 -0.017522 -0.004593">
          <joint name="RR_femur_joint" axis="-0 1 -0" range="-1.2000 1.2000"/>
          <inertial pos="0.018067 -0.001017 -0.030156" mass="0.005087" fullinertia="2.7482e-06 3.6800e-06 9.7355e-07 -4.0090e-08 1.5469e-06 6.6705e-08"/>
          <geom class="visual" mesh="RR_femur_vis" rgba="0.45 0.68 0.9 1"/>
          <geom class="collision" mesh="RR_femur_col"/>
          <body name="RR_tibia" pos="0.038069 -0.001500 -0.064620">
            <joint name="RR_knee_joint" axis="0 1 0" class="pin" range="-1.2000 0.7400"/>
            <inertial pos="-0.016914 -0.004472 -0.014685" mass="0.004954" fullinertia="1.5834e-06 3.4634e-06 1.9080e-06 4.5120e-08 -1.6434e-06 3.7620e-08"/>
            <geom class="visual" mesh="RR_tibia_vis" rgba="0.62 0.8 0.95 1"/>
            <geom class="collision" mesh="RR_tibia_col"/>
            <body name="RR_foot" pos="-0.052566 -0.001000 -0.053496">
              <joint name="RR_ankle_joint" axis="-0 1 0" class="pin"/>
              <inertial pos="0.017673 0.001177 -0.012590" mass="0.003009" fullinertia="3.2552e-07 1.1650e-06 8.5545e-07 2.0770e-08 4.9138e-07 -1.2848e-08"/>
              <geom class="visual" mesh="RR_foot_vis" rgba="0.2 0.55 0.35 1"/>
              <geom class="collision" mesh="RR_foot_col"/>
            </body>
          </body>
          <body name="RR_link" pos="0.027590 0.001100 -0.063328">
            <joint name="RR_link_pin_joint" axis="0 1 0" class="pin"/>
            <inertial pos="-0.027692 0.002257 -0.022978" mass="0.002011" fullinertia="6.3638e-07 1.2567e-06 6.2457e-07 7.3076e-09 -6.1112e-07 8.5611e-09"/>
            <geom class="visual" mesh="RR_link_vis" rgba="0.85 0.6 0.3 1"/>
            <geom class="collision" mesh="RR_link_col"/>
          </body>
        </body>
        <body name="RR_pinion" pos="-0.029532 -0.021572 -0.010749">
          <joint name="RR_pinion_joint" axis="-0 1 0" range="-1.5000 1.5000"/>
          <inertial pos="0.000006 -0.003996 -0.000003" mass="0.001240" fullinertia="2.4955e-08 2.8452e-08 2.4955e-08 1.5662e-11 1.5301e-14 -7.6251e-12"/>
          <geom class="visual" mesh="RR_pinion_vis" rgba="0.3 0.3 0.32 1"/>
          <geom class="collision" mesh="RR_pinion_col"/>
        </body>
        <body name="RR_gear" pos="-0.012618 -0.017522 -0.004593">
          <joint name="RR_gear_joint" axis="-0 1 -0" class="pin"/>
          <inertial pos="0.000730 -0.008385 0.000430" mass="0.004045" fullinertia="1.9729e-07 3.4494e-07 2.1668e-07 -1.0439e-08 -1.7486e-08 -6.1494e-09"/>
          <geom class="visual" mesh="RR_gear_vis" rgba="0.3 0.3 0.32 1"/>
          <geom class="collision" mesh="RR_gear_col"/>
          <body name="RR_quad" pos="0.012924 -0.003400 0.007614">
            <joint name="RR_crank_pin_joint" axis="0 1 0" class="pin"/>
            <inertial pos="0.021316 0.001600 -0.028638" mass="0.002586" fullinertia="1.0647e-06 1.4634e-06 4.0257e-07 6.2450e-21 6.2120e-07 4.1633e-21"/>
            <geom class="visual" mesh="RR_quad_vis" rgba="0.85 0.6 0.3 1"/>
            <geom class="collision" mesh="RR_quad_col"/>
          </body>
        </body>
      </body>
    </body>
  </worldbody>
  <equality>
    <connect name="FL_quad_pin" body1="FL_quad" body2="FL_tibia" anchor="-0.026268 -0.000500 -0.070248"/>
    <connect name="FL_foot_pin" body1="FL_link" body2="FL_foot" anchor="-0.012209 0.000400 -0.069223"/>
    <connect name="FR_quad_pin" body1="FR_quad" body2="FR_tibia" anchor="-0.026269 0.000500 -0.070248"/>
    <connect name="FR_foot_pin" body1="FR_link" body2="FR_foot" anchor="-0.012209 -0.000400 -0.069223"/>
    <connect name="RL_quad_pin" body1="RL_quad" body2="RL_tibia" anchor="0.038068 -0.000500 -0.064620"/>
    <connect name="RL_foot_pin" body1="RL_link" body2="RL_foot" anchor="-0.052566 -0.000600 -0.053496"/>
    <connect name="RR_quad_pin" body1="RR_quad" body2="RR_tibia" anchor="0.038068 0.000500 -0.064620"/>
    <connect name="RR_foot_pin" body1="RR_link" body2="RR_foot" anchor="-0.052566 0.000600 -0.053496"/>
    <joint name="FL_gear_mesh" joint1="FL_gear_joint" joint2="FL_pinion_joint" polycoef="0 -0.5 0 0 0"/>
    <joint name="FR_gear_mesh" joint1="FR_gear_joint" joint2="FR_pinion_joint" polycoef="0 -0.5 0 0 0"/>
    <joint name="RL_gear_mesh" joint1="RL_gear_joint" joint2="RL_pinion_joint" polycoef="0 -0.5 0 0 0"/>
    <joint name="RR_gear_mesh" joint1="RR_gear_joint" joint2="RR_pinion_joint" polycoef="0 -0.5 0 0 0"/>
  </equality>
  <actuator>
    <position name="FL_hip" joint="FL_hip_joint"/>
    <position name="FL_pivot" joint="FL_femur_joint"/>
    <position name="FL_gear" joint="FL_pinion_joint"/>
    <position name="FR_hip" joint="FR_hip_joint"/>
    <position name="FR_pivot" joint="FR_femur_joint"/>
    <position name="FR_gear" joint="FR_pinion_joint"/>
    <position name="RL_hip" joint="RL_hip_joint"/>
    <position name="RL_pivot" joint="RL_femur_joint"/>
    <position name="RL_gear" joint="RL_pinion_joint"/>
    <position name="RR_hip" joint="RR_hip_joint"/>
    <position name="RR_pivot" joint="RR_femur_joint"/>
    <position name="RR_gear" joint="RR_pinion_joint"/>
  </actuator>
  <sensor>
    <framequat name="imu_quat" objtype="site" objname="imu"/>
    <gyro name="imu_gyro" site="imu"/>
    <accelerometer name="imu_acc" site="imu"/>
  </sensor>
</mujoco>
