thiagopari/fox_rl_model/v7/mjcf/fox_reduced.xml

<mujoco model="fox_reduced">
  <compiler angle="radian" meshdir="../meshes" autolimits="true"/>
  <option timestep="0.002" integrator="implicitfast"/>
  <default>
    <joint armature="0.0005" damping="0.01" frictionloss="0.002"/>
    <default class="pin"><joint armature="1e-06" damping="0.0001" frictionloss="0"/></default>
    <position kp="5" kv="0.08" forcerange="-0.47 0.47" inheritrange="1"/>
    <equality solref="0.004 1" solimp="0.999 0.9999 0.0005 0.5 2"/>
    <default class="visual"><geom type="mesh" contype="0" conaffinity="0" group="2" density="0"/></default>
    <default class="collision"><geom type="mesh" contype="1" conaffinity="0" group="3" density="0" friction="1.0 0.02 0.01" condim="3"/></default>
  </default>
  <asset>
    <mesh name="base_vis" file="visual/base.stl"/>
    <mesh name="base_col" file="collision/base.stl"/>
    <mesh name="FL_hip_vis" file="visual/FL_hip_reduced.stl"/>
    <mesh name="FL_hip_col" file="collision/FL_hip_reduced.stl"/>
    <mesh name="FL_thigh_vis" file="visual/FL_thigh_reduced.stl"/>
    <mesh name="FL_thigh_col" file="collision/FL_thigh_reduced.stl"/>
    <mesh name="FL_calf_vis" file="visual/FL_calf_reduced.stl"/>
    <mesh name="FL_calf_col" file="collision/FL_calf_reduced.stl"/>
    <mesh name="FL_foot_vis" file="visual/FL_foot_reduced.stl"/>
    <mesh name="FL_foot_col" file="collision/FL_foot_reduced.stl"/>
    <mesh name="FR_hip_vis" file="visual/FR_hip_reduced.stl"/>
    <mesh name="FR_hip_col" file="collision/FR_hip_reduced.stl"/>
    <mesh name="FR_thigh_vis" file="visual/FR_thigh_reduced.stl"/>
    <mesh name="FR_thigh_col" file="collision/FR_thigh_reduced.stl"/>
    <mesh name="FR_calf_vis" file="visual/FR_calf_reduced.stl"/>
    <mesh name="FR_calf_col" file="collision/FR_calf_reduced.stl"/>
    <mesh name="FR_foot_vis" file="visual/FR_foot_reduced.stl"/>
    <mesh name="FR_foot_col" file="collision/FR_foot_reduced.stl"/>
    <mesh name="RL_hip_vis" file="visual/RL_hip_reduced.stl"/>
    <mesh name="RL_hip_col" file="collision/RL_hip_reduced.stl"/>
    <mesh name="RL_thigh_vis" file="visual/RL_thigh_reduced.stl"/>
    <mesh name="RL_thigh_col" file="collision/RL_thigh_reduced.stl"/>
    <mesh name="RL_calf_vis" file="visual/RL_calf_reduced.stl"/>
    <mesh name="RL_calf_col" file="collision/RL_calf_reduced.stl"/>
    <mesh name="RL_foot_vis" file="visual/RL_foot_reduced.stl"/>
    <mesh name="RL_foot_col" file="collision/RL_foot_reduced.stl"/>
    <mesh name="RR_hip_vis" file="visual/RR_hip_reduced.stl"/>
    <mesh name="RR_hip_col" file="collision/RR_hip_reduced.stl"/>
    <mesh name="RR_thigh_vis" file="visual/RR_thigh_reduced.stl"/>
    <mesh name="RR_thigh_col" file="collision/RR_thigh_reduced.stl"/>
    <mesh name="RR_calf_vis" file="visual/RR_calf_reduced.stl"/>
    <mesh name="RR_calf_col" file="collision/RR_calf_reduced.stl"/>
    <mesh name="RR_foot_vis" file="visual/RR_foot_reduced.stl"/>
    <mesh name="RR_foot_col" file="collision/RR_foot_reduced.stl"/>
  </asset>
  <worldbody>
    <body name="base" pos="0.000000 0.000000 0.152840">
      <freejoint name="root"/>
      <inertial pos="-0.000626 0.000923 0.016196" mass="0.330454" fullinertia="2.7830e-04 1.4975e-03 1.6114e-03 -4.0202e-06 -9.4188e-05 -9.4332e-06"/>
      <geom class="visual" mesh="base_vis" rgba="0.33 0.42 0.52 1"/>
      <geom class="collision" mesh="base_col"/>
      <site name="imu" pos="0 0 0"/>
      <body name="FL_hip" pos="0.071686 0.024238 0.007390">
        <joint name="FL_hip_joint" axis="0.984808 0 -0.173648" range="-0.5000 0.5000"/>
        <inertial pos="0.019238 0.004055 -0.008620" mass="0.034924" fullinertia="7.2768e-06 7.7475e-06 9.6381e-06 -4.7010e-07 3.4715e-07 -8.9204e-07"/>
        <geom class="visual" mesh="FL_hip_vis" rgba="0.12 0.12 0.13 1"/>
        <geom class="collision" mesh="FL_hip_col"/>
        <body name="FL_thigh" pos="0.013073 0.017273 -0.002610">
          <joint name="FL_thigh_joint" axis="0 1 0" range="-1.2000 1.2000"/>
          <inertial pos="-0.018473 0.001557 -0.029738" mass="0.007500" fullinertia="4.3169e-06 5.5055e-06 1.2355e-06 -4.3816e-09 -1.4460e-06 -7.4701e-08"/>
          <geom class="visual" mesh="FL_thigh_vis" rgba="0.45 0.68 0.9 1"/>
          <geom class="collision" mesh="FL_thigh_col"/>
          <body name="FL_calf" pos="-0.026269 0.000000 -0.070249">
            <joint name="FL_calf_joint" axis="0 1 0" range="-1.2000 1.2000"/>
            <inertial pos="0.000020 0.003382 -0.022507" mass="0.007846" fullinertia="3.9772e-06 4.0797e-06 4.5436e-07 8.3551e-08 2.0847e-07 -1.8694e-07"/>
            <geom class="visual" mesh="FL_calf_vis" rgba="0.62 0.8 0.95 1"/>
            <geom class="collision" mesh="FL_calf_col"/>
            <body name="FL_foot" pos="0.005365 0.002750 -0.067459">
              <joint name="FL_foot_joint" axis="-0 1 0" class="pin"/>
              <inertial pos="0.010962 -0.001369 -0.006584" mass="0.002518" fullinertia="1.2566e-07 6.3852e-07 5.2978e-07 -1.9020e-08 2.2656e-07 9.0232e-09"/>
              <geom class="visual" mesh="FL_foot_vis" rgba="0.2 0.55 0.35 1"/>
              <geom class="collision" mesh="FL_foot_col"/>
            </body>
          </body>
        </body>
      </body>
      <body name="FR_hip" pos="0.071686 -0.024262 0.007390">
        <joint name="FR_hip_joint" axis="0.984808 0 -0.173648" range="-0.5000 0.5000"/>
        <inertial pos="0.019199 -0.003978 -0.008578" mass="0.034924" fullinertia="7.2788e-06 7.7713e-06 9.6598e-06 4.5755e-07 3.5910e-07 8.8935e-07"/>
        <geom class="visual" mesh="FR_hip_vis" rgba="0.12 0.12 0.13 1"/>
        <geom class="collision" mesh="FR_hip_col"/>
        <body name="FR_thigh" pos="0.013073 -0.017248 -0.002610">
          <joint name="FR_thigh_joint" axis="0 1 0" range="-1.2000 1.2000"/>
          <inertial pos="-0.018474 -0.001557 -0.029737" mass="0.007500" fullinertia="4.3174e-06 5.5057e-06 1.2353e-06 4.3939e-09 -1.4459e-06 7.4683e-08"/>
          <geom class="visual" mesh="FR_thigh_vis" rgba="0.45 0.68 0.9 1"/>
          <geom class="collision" mesh="FR_thigh_col"/>
          <body name="FR_calf" pos="-0.026269 0.000000 -0.070249">
            <joint name="FR_calf_joint" axis="0 1 0" range="-1.2000 1.2000"/>
            <inertial pos="0.000019 -0.003522 -0.021599" mass="0.008175" fullinertia="4.1440e-06 4.2445e-06 4.6076e-07 -8.3586e-08 2.0868e-07 2.1144e-07"/>
            <geom class="visual" mesh="FR_calf_vis" rgba="0.62 0.8 0.95 1"/>
            <geom class="collision" mesh="FR_calf_col"/>
            <body name="FR_foot" pos="0.005365 -0.002750 -0.067459">
              <joint name="FR_foot_joint" axis="-0 1 0" class="pin"/>
              <inertial pos="0.010962 0.001369 -0.006584" mass="0.002518" fullinertia="1.2566e-07 6.3852e-07 5.2978e-07 1.9020e-08 2.2656e-07 -9.0234e-09"/>
              <geom class="visual" mesh="FR_foot_vis" rgba="0.2 0.55 0.35 1"/>
              <geom class="collision" mesh="FR_foot_col"/>
            </body>
          </body>
        </body>
      </body>
      <body name="RL_hip" pos="-0.073606 0.024238 -0.000351">
        <joint name="RL_hip_joint" axis="0.939693 0 0.34202" range="-0.5000 0.5000"/>
        <inertial pos="-0.017473 0.004018 -0.011466" mass="0.035424" fullinertia="7.6036e-06 7.9862e-06 9.5722e-06 6.1728e-07 -6.8448e-07 -8.0232e-07"/>
        <geom class="visual" mesh="RL_hip_vis" rgba="0.12 0.12 0.13 1"/>
        <geom class="collision" mesh="RL_hip_col"/>
        <body name="RL_thigh" pos="-0.012394 0.017273 -0.004429">
          <joint name="RL_thigh_joint" axis="-0 1 -0" range="-1.2000 1.2000"/>
          <inertial pos="0.023411 0.001546 -0.026990" mass="0.007764" fullinertia="4.0502e-06 5.8560e-06 1.8560e-06 2.1345e-08 1.9562e-06 -8.3252e-08"/>
          <geom class="visual" mesh="RL_thigh_vis" rgba="0.45 0.68 0.9 1"/>
          <geom class="collision" mesh="RL_thigh_col"/>
          <body name="RL_calf" pos="0.038069 0.001750 -0.064620">
            <joint name="RL_calf_joint" axis="0 1 0" range="-1.2000 0.7400"/>
            <inertial pos="-0.022089 0.001955 -0.015987" mass="0.007357" fullinertia="2.5474e-06 5.7595e-06 3.5120e-06 -3.7810e-07 -2.6205e-06 -1.7188e-07"/>
            <geom class="visual" mesh="RL_calf_vis" rgba="0.62 0.8 0.95 1"/>
            <geom class="collision" mesh="RL_calf_col"/>
            <body name="RL_foot" pos="-0.052566 0.001000 -0.053496">
              <joint name="RL_foot_joint" axis="-0 1 0" class="pin"/>
              <inertial pos="0.017232 -0.001193 -0.012323" mass="0.003072" fullinertia="3.3629e-07 1.2058e-06 8.8582e-07 -2.1672e-08 5.0888e-07 1.3432e-08"/>
              <geom class="visual" mesh="RL_foot_vis" rgba="0.2 0.55 0.35 1"/>
              <geom class="collision" mesh="RL_foot_col"/>
            </body>
          </body>
        </body>
      </body>
      <body name="RR_hip" pos="-0.073382 -0.024238 -0.000188">
        <joint name="RR_hip_joint" axis="0.939693 0 0.34202" range="-0.5000 0.5000"/>
        <inertial pos="-0.017073 -0.003665 -0.012221" mass="0.036913" fullinertia="7.9814e-06 8.5404e-06 9.9767e-06 -7.4692e-07 -6.3382e-07 9.3749e-07"/>
        <geom class="visual" mesh="RR_hip_vis" rgba="0.12 0.12 0.13 1"/>
        <geom class="collision" mesh="RR_hip_col"/>
        <body name="RR_thigh" pos="-0.012618 -0.017522 -0.004593">
          <joint name="RR_thigh_joint" axis="-0 1 -0" range="-1.2000 1.2000"/>
          <inertial pos="0.023518 -0.001281 -0.027078" mass="0.007674" fullinertia="3.9569e-06 5.7349e-06 1.8257e-06 -1.8372e-08 1.9148e-06 7.8968e-08"/>
          <geom class="visual" mesh="RR_thigh_vis" rgba="0.45 0.68 0.9 1"/>
          <geom class="collision" mesh="RR_thigh_col"/>
          <body name="RR_calf" pos="0.038069 -0.001500 -0.064620">
            <joint name="RR_calf_joint" axis="0 1 0" range="-1.2000 0.7400"/>
            <inertial pos="-0.023052 -0.001779 -0.016706" mass="0.006965" fullinertia="2.4144e-06 5.4365e-06 3.3034e-06 3.3609e-07 -2.4674e-06 1.3960e-07"/>
            <geom class="visual" mesh="RR_calf_vis" rgba="0.62 0.8 0.95 1"/>
            <geom class="collision" mesh="RR_calf_col"/>
            <body name="RR_foot" pos="-0.052566 -0.001000 -0.053496">
              <joint name="RR_foot_joint" axis="-0 1 0" class="pin"/>
              <inertial pos="0.017673 0.001177 -0.012590" mass="0.003009" fullinertia="3.2552e-07 1.1650e-06 8.5545e-07 2.0770e-08 4.9138e-07 -1.2848e-08"/>
              <geom class="visual" mesh="RR_foot_vis" rgba="0.2 0.55 0.35 1"/>
              <geom class="collision" mesh="RR_foot_col"/>
            </body>
          </body>
        </body>
      </body>
    </body>
  </worldbody>
  <tendon>
    <fixed name="FL_gear_servo"><joint joint="FL_thigh_joint" coef="-2"/><joint joint="FL_calf_joint" coef="-2"/></fixed>
    <fixed name="FR_gear_servo"><joint joint="FR_thigh_joint" coef="-2"/><joint joint="FR_calf_joint" coef="-2"/></fixed>
    <fixed name="RL_gear_servo"><joint joint="RL_thigh_joint" coef="-2"/><joint joint="RL_calf_joint" coef="-2"/></fixed>
    <fixed name="RR_gear_servo"><joint joint="RR_thigh_joint" coef="-2"/><joint joint="RR_calf_joint" coef="-2"/></fixed>
  </tendon>
  <equality>
    <joint name="FL_four_bar" joint1="FL_foot_joint" joint2="FL_calf_joint" polycoef="0.000117 0.358775 -0.155189 -0.037049 0.007424"/>
    <joint name="FR_four_bar" joint1="FR_foot_joint" joint2="FR_calf_joint" polycoef="0.000117 0.358775 -0.155189 -0.037049 0.007424"/>
    <joint name="RL_four_bar" joint1="RL_foot_joint" joint2="RL_calf_joint" polycoef="0 -1 0 0 -0"/>
    <joint name="RR_four_bar" joint1="RR_foot_joint" joint2="RR_calf_joint" polycoef="0 -1 0 -0 -0"/>
  </equality>
  <actuator>
    <position name="FL_hip" joint="FL_hip_joint"/>
    <position name="FL_pivot" joint="FL_thigh_joint"/>
    <position name="FL_gear" tendon="FL_gear_servo" inheritrange="0" ctrlrange="-1.5000 1.5000"/>
    <position name="FR_hip" joint="FR_hip_joint"/>
    <position name="FR_pivot" joint="FR_thigh_joint"/>
    <position name="FR_gear" tendon="FR_gear_servo" inheritrange="0" ctrlrange="-1.5000 1.5000"/>
    <position name="RL_hip" joint="RL_hip_joint"/>
    <position name="RL_pivot" joint="RL_thigh_joint"/>
    <position name="RL_gear" tendon="RL_gear_servo" inheritrange="0" ctrlrange="-1.5000 1.5000"/>
    <position name="RR_hip" joint="RR_hip_joint"/>
    <position name="RR_pivot" joint="RR_thigh_joint"/>
    <position name="RR_gear" tendon="RR_gear_servo" inheritrange="0" ctrlrange="-1.5000 1.5000"/>
  </actuator>
  <sensor>
    <framequat name="imu_quat" objtype="site" objname="imu"/>
    <gyro name="imu_gyro" site="imu"/>
    <accelerometer name="imu_acc" site="imu"/>
  </sensor>
</mujoco>
