thiagopari/fox_rl_model/deploy/fox_pi.py

#!/usr/bin/env python3
"""Run a trained Fox policy (policy.onnx, e.g. policies/fox_flat_blind_v3) on the robot.

Raspberry Pi + BNO055 + PCA9685 (0x40) on I2C, the stack of ~/robofox_leg_imu_calibration.py. 50 Hz loop:
IMU -> the policy's observation -> policy.onnx -> 12 servo angles -> PCA9685.

    pip install numpy onnxruntime adafruit-circuitpython-pca9685 adafruit-circuitpython-bno055 adafruit-circuitpython-motor
    python3 fox_pi.py policy.onnx --check-imu       # 1. IMU axes: tilt / turn the robot, compare with the printout
    python3 fox_pi.py policy.onnx --wiggle FL_hip   # 2. robot held in the air: which channel, which way is + (only that
                                                    #    servo is powered: centre, +10 deg, centre, -10 deg, centre, x2)
    python3 fox_pi.py policy.onnx                   # 3. walk. W/S A/D Q/E step the command, space = stop, Ctrl-C = limp
    python3 fox_pi.py policy.onnx --dry-run         # anywhere: fake hardware, 3 s, prints the servo angles

Calibrate CHANNEL / NEUTRAL_DEG / DIRECTION / IMU_TO_BODY below first. Servo target 0 is the CAD stance: legs in vertical
planes, femur (hip pivot -> knee) -20.5 deg front / +30.5 deg rear from straight down (+ = knee forward), shin (knee ->
ankle) +4.5 deg front / -44.5 deg rear. The servos jump to the stance at start: hold the robot or use a stand.
FoxPolicy (no hardware) is the input/output contract; tools/check_policy_io.py runs it in Isaac Lab against the sim.
"""
import argparse
import collections
import json
import math
import os
import select
import sys
import termios
import time
import tty

import numpy as np

# ---------------------------------------------------------------------------- calibration (measure on the robot)
LEGS = ("FL", "FR", "RL", "RR")
SERVOS = ["%s_%s" % (leg, s) for s in ("hip", "pivot", "gear") for leg in LEGS]     # the policy's output order
# PCA9685 channels: leg blocks RL 0-2, RR 3-5, FR 6-8, FL 9-11 (~/robofox_fourbar_kinematics.py), hip last. Checked on the
# robot 2026-10-07: front legs gear then pivot, rear legs pivot then gear. servo_calib.json (fox_calib.py) overrides
CHANNEL = {"RL_pivot": 0, "RL_gear": 1, "RL_hip": 2, "RR_pivot": 3, "RR_gear": 4, "RR_hip": 5,
           "FR_gear": 6, "FR_pivot": 7, "FR_hip": 8, "FL_gear": 9, "FL_pivot": 10, "FL_hip": 11}
NEUTRAL_DEG = {name: 90.0 for name in SERVOS}   # adafruit servo angle (0..180) that puts the joint at the CAD stance
DIRECTION = {name: 1 for name in SERVOS}        # -1 where a larger servo angle turns the joint against the policy's +
DEG_PER_RAD = 180.0 / math.pi                   # 500-2500 us = 180 deg (adafruit_motor); correct if the travel differs
LIMIT_DEG = {name: (NEUTRAL_DEG[name] - 50.0, NEUTRAL_DEG[name] + 50.0) for name in SERVOS}   # never command beyond
HEIGHT_TRIM_MM = {leg: 0.0 for leg in LEGS}   # + = leg longer at the stance (--stand / --balance); "height_trim_mm"
STAND_DEG = {}   # the robot's standing pose in servo degrees ("stand_deg"): --stand / --balance start from it, not home
GEAR_RATIO = 1.0   # gear servo turns per crank turn ("gear_ratio"): 1 = 12T:12T gears, 2 = v7 12T:24T (fox_calib.py --gear-ratio)
CALIB_FILE = os.path.join(os.path.dirname(os.path.abspath(__file__)), "servo_calib.json")   # written by fox_calib.py
IMU_LEVEL = np.eye(3)   # mount tilt correction, from --level-imu (servo_calib.json "imu_level_gravity")


def level_rotation(g0):
    """Rotation taking g0, the gravity direction the IMU reports with the body level, onto (0, 0, -1): corrects a tilted
    IMU mount (pitch and roll; a yaw offset does not show in gravity)."""
    a, b = np.asarray(g0, float) / np.linalg.norm(g0), np.array([0.0, 0.0, -1.0])
    v, c = np.cross(a, b), float(a @ b)
    k = np.array([[0.0, -v[2], v[1]], [v[2], 0.0, -v[0]], [-v[1], v[0], 0.0]])
    return np.eye(3) + k + k @ k / (1.0 + c)


def load_calib(path=CALIB_FILE):
    """Measured values from fox_calib.py override the guesses above: channel, home (deg), direction, limits (deg), gear
    ratio. A gear servo's default range is home +-50 deg times the ratio (the same shin range at 2:1)."""
    global GEAR_RATIO
    if not os.path.exists(path):
        return
    with open(path) as f:
        c = json.load(f)
    known = lambda d: {k: v for k, v in d.items() if k in SERVOS}  # noqa: E731
    GEAR_RATIO = float(c.get("gear_ratio", 1.0))
    CHANNEL.update({k: int(v) for k, v in known(c.get("channel", {})).items()})
    NEUTRAL_DEG.update({k: float(v) for k, v in known(c.get("home_deg", {})).items()})
    DIRECTION.update({k: 1 if v >= 0 else -1 for k, v in known(c.get("direction", {})).items()})
    span = lambda n: 50.0 * (GEAR_RATIO if n.endswith("_gear") else 1.0)  # noqa: E731
    LIMIT_DEG.update({n: (NEUTRAL_DEG[n] - span(n), NEUTRAL_DEG[n] + span(n)) for n in SERVOS})
    LIMIT_DEG.update({k: (float(v[0]), float(v[1])) for k, v in known(c.get("limit_deg", {})).items()})
    if "imu_level_gravity" in c:
        IMU_LEVEL[:] = level_rotation(c["imu_level_gravity"])
    HEIGHT_TRIM_MM.update({k: float(v) for k, v in c.get("height_trim_mm", {}).items() if k in LEGS})
    STAND_DEG.update({k: float(v) for k, v in known(c.get("stand_deg", {})).items()})


load_calib()
IMU_TO_BODY = [[1, 0, 0], [0, -1, 0], [0, 0, -1]]   # BNO055 axes -> body (x fwd, y left, z up): upside-down mount,
#   verified with --check-imu 2026-10-07 (nose down x +0.99, left side down y +1.00, CCW turn +93 deg, gyro in rad/s)
PLUS = {"hip": "the foot moves to the robot's LEFT", "pivot": "the femur turns, knee moving BACK; the shin keeps its angle",
        "gear": "the shin turns, foot moving FORWARD; the femur stays"}   # policy + for each servo (fox_cfg.py servo map)

DT, MAX_TARGET = 0.02, 0.8   # 50 Hz like training; |target - stance| clamp in rad at action scale 0.25 (training stays
# well inside); a servo with a larger scale gets a proportionally wider clamp

# Sagittal leg geometry at the CAD stance (urdf/fox.urdf): femur hip pivot -> knee, shin knee -> ankle, in mm, and their
# angles from straight down (+ = toward the front). --balance / --stand lengthen or shorten legs with it (2-link IK).
LEG_GEOM = {"F": (75.0, 67.7, math.radians(-20.5), math.radians(4.5)), "R": (75.0, 75.0, math.radians(30.5), math.radians(-44.5))}


def leg_fk(leg, pivot, gear):
    """Ankle position (x fwd, z up; mm from the hip pivot) for pivot / gear servo targets (rad from home)."""
    l1, l2, a1, a2 = LEG_GEOM[leg[0]]
    b1, b2 = a1 - pivot, a2 + gear / GEAR_RATIO   # pivot + turns the knee back; gear + swings the foot forward
    return l1 * math.sin(b1) + l2 * math.sin(b2), -l1 * math.cos(b1) - l2 * math.cos(b2)


def leg_reach(leg, pivot0=0.0, gear0=0.0):
    """How much longer than in the base pose (pivot0, gear0) a leg can get (mm) while keeping 15 deg of knee bend."""
    l1, l2, a1, a2 = LEG_GEOM[leg[0]]
    x0, z0 = leg_fk(leg, pivot0, gear0)
    return math.sqrt(l1 * l1 + l2 * l2 + 2 * l1 * l2 * math.cos(math.radians(15.0))) - math.hypot(x0, z0)


def leg_ik(leg, dh, pivot0=0.0, gear0=0.0, radial=False):
    """Pivot and gear targets (rad from home) that make a leg dh mm longer than in the base pose (pivot0, gear0; the
    CAD stance by default), its ankle staying above the same point, or with radial=True on the same line from the hip
    (the leg keeps its angle)."""
    l1, l2, a1, a2 = LEG_GEOM[leg[0]]
    x, z = leg_fk(leg, pivot0, gear0)
    if radial:
        s = 1.0 + dh / math.hypot(x, z)
        x, z = x * s, z * s
    else:
        z -= dh
    d = math.hypot(x, z)
    a = (l1 * l1 - l2 * l2 + d * d) / (2.0 * d)               # knee: where the circles |K| = l1 and |K - ankle| = l2 meet,
    h = math.sqrt(max(l1 * l1 - a * a, 0.0))                  # on the side the base pose's knee is on
    mx, mz = a * x / d, a * z / d
    k0 = (l1 * math.sin(a1 - pivot0), -l1 * math.cos(a1 - pivot0))
    kx, kz = min(((mx + h * z / d, mz - h * x / d), (mx - h * z / d, mz + h * x / d)),
                 key=lambda k: (k[0] - k0[0]) ** 2 + (k[1] - k0[1]) ** 2)
    return a1 - math.atan2(kx, -kz), (math.atan2(x - kx, -(z - kz)) - a2) * GEAR_RATIO


def stand_targets():
    """The stand pose (STAND_DEG) as targets in rad from home; home for servos it doesn't list."""
    return np.array([(STAND_DEG[n] - NEUTRAL_DEG[n]) / (DIRECTION[n] * DEG_PER_RAD) if n in STAND_DEG else 0.0 for n in SERVOS])


def stance(dh):
    """12 targets: the stand pose (or home) with every leg made HEIGHT_TRIM_MM[leg] + dh[leg] mm longer."""
    t = stand_targets()
    for i, leg in enumerate(LEGS):
        t[4 + i], t[8 + i] = leg_ik(leg, HEIGHT_TRIM_MM[leg] + dh[leg], t[4 + i], t[8 + i])
    return t


def level_offsets(p, r, low=-40.0):
    """Leg length changes (mm) for pitch / roll corrections p, r (mm: front up, left up). The common height is free, so
    when a leg can't get longer (the front legs are nearly straight at the stance) the whole robot is lowered."""
    raw = {leg: (p if leg[0] == "F" else -p) + (r if leg[1] == "L" else -r) for leg in LEGS}
    base = stand_targets()
    common = min(0.0, min(leg_reach(leg, base[4 + i], base[8 + i]) - HEIGHT_TRIM_MM[leg] - raw[leg] for i, leg in enumerate(LEGS)))
    return {leg: max(low, raw[leg] + common) for leg in LEGS}


def attitude(down):
    """(pitch, roll) in deg from a gravity direction: nose down +, left side down +."""
    return tuple(math.degrees(math.asin(float(np.clip(v, -1.0, 1.0)))) for v in down[:2])


def balance(robot, capture=10.0, tol=1.0, gain=1.0, seconds=None, log=None):
    """--balance: stand; average the IMU attitude for the first `capture` s (hold the robot steady the way it should
    stay) as the target; then keep pitch and roll within +-tol deg of it by lengthening / shortening the legs (integral
    control, `gain` mm per deg per s). Ends limp on Ctrl-C or a fall; after `seconds` it keeps holding its last pose."""
    p = r = 0.0
    robot.write(stance(level_offsets(p, r)))
    print("capturing the target for %.1f s: hold the robot steady in the attitude it should keep" % capture, flush=True)
    samples, end = [], time.perf_counter() + capture
    while time.perf_counter() < end:
        samples.append(attitude(read_retry(robot)[1]))
        time.sleep(DT)
    ref = np.mean(samples, axis=0)
    print("target pitch %+.1f deg, roll %+.1f deg (+-%.1f); balancing%s" % (ref[0], ref[1], tol,
          " for %.0f s" % seconds if seconds else " until Ctrl-C (limp)"), flush=True)
    out = open(log, "w") if log else None
    if out:
        out.write("t,pitch,roll,err_pitch,err_roll," + ",".join("dh_" + leg for leg in LEGS) + "," + ",".join(SERVOS) + "\n")
    k, tilted, finished, tick = 0, 0, False, time.perf_counter()
    try:
        while seconds is None or k * DT < seconds:
            down = read_retry(robot)[1]
            tilted = tilted + 1 if down[2] > -0.5 else 0
            if tilted >= 3:
                print("tilted over: stopping")
                break
            e = np.array(attitude(down)) - ref
            u = np.where(np.abs(e) > tol, gain * e * DT, 0.0)
            p, r = float(np.clip(p + u[0], -30.0, 30.0)), float(np.clip(r + u[1], -30.0, 30.0))
            dh = level_offsets(p, r)
            span = np.array([MAX_TARGET * (GEAR_RATIO if n.endswith("_gear") else 1.0) for n in SERVOS])   # 2:1: twice the angle
            targets = np.clip(stance(dh), -span, span)
            robot.write(targets)
            if out:
                out.write("%.4f,%.2f,%.2f,%.2f,%.2f,%s,%s\n" % (time.perf_counter(), *attitude(down), *e,
                          ",".join("%.1f" % dh[leg] for leg in LEGS), ",".join("%.1f" % servo_deg(n, t) for n, t in zip(SERVOS, targets))))
            if k % 25 == 0:
                print("  error pitch %+5.1f roll %+5.1f deg | legs %s mm" % (*e, " ".join("%s %+5.1f" % (leg, dh[leg]) for leg in LEGS)),
                      flush=True)
            k += 1
            tick += DT
            time.sleep(max(0.0, tick - time.perf_counter()))
        finished = seconds is not None and k * DT >= seconds
    finally:
        if not finished:
            robot.limp()
        if out:
            out.close()
        print("%d steps%s" % (k, "; holding the last pose" if finished else "; limp"), flush=True)


class FoxPolicy:
    """policy.onnx's contract, checked in Isaac Lab by tools/check_policy_io.py. Observation (105 floats): per term the
    last 5 readings, oldest first: gyro (rad/s, body), gravity direction (unit, (0, 0, -1) level), command (vx, vy m/s,
    yaw rad/s), its own previous output as sent (12), and for a walk (gait_hz in policy.json) its clock (sin, cos of
    2 pi gait_hz t, t = steps since reset x DT; 115 floats). Output: servo targets = offset + scale * output (rad from home),
    clamped to the training limits (or, for v1-v4, a safety span), SERVOS order; scale / offset / limits come from the policy.json
    exported with the ONNX (policy_contract), 0.25 / 0 / none for the v1-v4 policies. For straight commands (no sideways, no turning) the hip outputs are set to 0: the hips hold the
    stance."""

    H = 5

    def __init__(self, infer, scale=0.25, offset=0.0, limits=None, gait_hz=None):
        self.infer, self.gait_hz = infer, gait_hz
        self.scale, self.offset = np.broadcast_to(np.asarray(scale, float), (12,)), np.broadcast_to(np.asarray(offset, float), (12,))
        if limits is not None:                          # the limits the env clamped targets to in training: the same clamp
            lim = np.asarray(limits, float)
            self.lo, self.hi = lim[:, 0].copy(), lim[:, 1].copy()
        else:                                           # v1-v4: a safety clamp around the stance
            span = MAX_TARGET * self.scale / 0.25
            self.lo, self.hi = self.offset - span, self.offset + span

    def reset(self, gyro, gravity, command):
        self.k = 0
        self.hist = [collections.deque([np.array(x, np.float32)] * self.H, maxlen=self.H)    # copies: callers may
                     for x in (gyro, gravity, command, np.zeros(12)) + self._clock()]              # reuse their buffers
        return self._act(command)

    def step(self, gyro, gravity, command):
        self.k += 1
        for h, x in zip(self.hist, (gyro, gravity, command, self.action) + self._clock()):
            h.append(np.array(x, np.float32))
        return self._act(command)

    def _clock(self):
        """The walk's clock as the last observation term (= isaaclab/fox_tasks.gait_phase), or nothing."""
        if self.gait_hz is None:
            return ()
        a = 2.0 * math.pi * ((self.gait_hz * self.k * DT) % 1.0)
        return ((math.sin(a), math.cos(a)),)

    def _act(self, command):
        self.obs = np.concatenate([np.concatenate(h) for h in self.hist])[None]
        self.action = np.array(self.infer(self.obs), np.float32).reshape(12)     # as sent: what the policy observes next
        if not hips_free(command):
            self.action[:4] = 0.0
        return self.clip(self.offset + self.scale * self.action)

    def clip(self, targets):
        return np.clip(targets, self.lo, self.hi)


def policy_contract(path):
    """policy.json next to policy.onnx (written by isaaclab/fox_play.py): servo order, per-servo scale and offset (rad
    from home), target limits (if the task clamped them), the gear ratio it was trained for and its command ranges.
    Without one: the v1-v4 contract."""
    meta = os.path.join(os.path.dirname(os.path.abspath(path)), "policy.json")
    c = {"servos": SERVOS, "scale": [0.25] * 12, "offset_rad": [0.0] * 12, "gear_ratio": 1.0,
         "command_ranges": {"lin_vel_x": [-0.3, 0.3], "lin_vel_y": [-0.2, 0.2], "ang_vel_z": [-1.0, 1.0]}}
    if os.path.exists(meta):
        with open(meta) as f:
            c.update(json.load(f))
    return c


def reach(contract):
    """Each servo's stance and training target limits in servo degrees with this calibration. Returns (problems, notes):
    a stance outside the servo's 0-180 travel (refuse), and the part of a training range past it (gets clamped: a
    servo there sits pinned at its end). One pinion tooth moves a gear servo's home 30 deg."""
    problems, notes = [], []
    lim = contract.get("target_limits_rad")
    for i, n in enumerate(SERVOS):
        h, d = NEUTRAL_DEG[n], DIRECTION[n]
        st = h + d * DEG_PER_RAD * contract["offset_rad"][i]
        if not 0.0 <= st <= 180.0:
            problems.append("%s: the stance needs %.0f deg (home %.0f), past the servo's 0-180" % (n, st, h))
        if lim and not n.endswith("_hip"):
            lo, hi = sorted(h + d * DEG_PER_RAD * v for v in lim[i])
            if lo < -0.5 or hi > 180.5:                 # (1.5708 rad is 90.0002 deg: no alarm for a home at 90)
                notes.append("%s: training range %.0f..%.0f deg, the servo stops at %s (home %.0f)" % (
                    n, lo, hi, "0" if lo < -0.5 else "180", h))
    return problems, notes


def hips_free(command):
    """Sideways or turning asked for; otherwise the hips hold the stance (= isaaclab/fox_mdp.py hips_free)."""
    return abs(command[1]) > 1e-3 or abs(command[2]) > 1e-3


def onnx_infer(path):
    """policy.onnx as obs (1, 105) -> action (12,): onnxruntime on the Pi, onnx's reference evaluator elsewhere."""
    try:
        import onnxruntime as ort
        session = ort.InferenceSession(path)
        name = session.get_inputs()[0].name
        return lambda obs: session.run(None, {name: obs})[0][0]
    except ImportError:
        import onnx
        from onnx.reference import ReferenceEvaluator
        model = onnx.load(path)
        evaluator, name = ReferenceEvaluator(model), model.graph.input[0].name
        return lambda obs: evaluator.run(None, {name: obs})[0][0]


def servo_deg(name, rad):
    lo, hi = LIMIT_DEG[name]                         # and the servo's own 0-180 (adafruit_motor raises outside it)
    return min(hi, 180.0, max(lo, 0.0, NEUTRAL_DEG[name] + DIRECTION[name] * DEG_PER_RAD * rad))


class Imu:
    """The BNO055 alone (--check-imu, --level-imu): never touches the PCA9685, so servos held by another program stay.
    Readings pass a glitch filter: on the stand (2026-10-09) the BNO055 gave single readings of 35.6 rad/s (its full
    scale) and of exactly (0, 0, +9.81) in its own frame (its fusion's default after a reset), amid level ones."""

    GYRO_MAX, JUMP_DEG, HOLD_MAX = 15.0, 30.0, 2   # rad/s; deg of gravity direction per reading; readings held at most

    def __init__(self, i2c=None):
        import adafruit_bno055
        import board
        import busio
        self.i2c = i2c or busio.I2C(board.SCL, board.SDA)
        self.imu = adafruit_bno055.BNO055_I2C(self.i2c)
        if self.imu.mode != adafruit_bno055.IMUPLUS_MODE:   # gyro + accelerometer fusion: no magnetometer near the servo
            self.imu.mode = adafruit_bno055.IMUPLUS_MODE    # motors. A mode write restarts the fusion (zeros, ~0.1 s): skip
                                                            # it when set, so a second program can't upset a running one
        self.rot = IMU_LEVEL @ np.array(IMU_TO_BODY, float)
        self.last, self.held, self.glitches = None, 0, 0

    def filter(self, gyro, down):
        """A reading that rotates faster than GYRO_MAX or turns gravity more than JUMP_DEG since the last good reading
        (1500 deg/s) is a glitch: the last good reading stands in, at most HOLD_MAX times in a row, so a real fall
        still shows within 60 ms."""
        if self.last is not None and self.held < self.HOLD_MAX and (
                np.abs(gyro).max() > self.GYRO_MAX or float(down @ self.last[1]) < math.cos(math.radians(self.JUMP_DEG))):
            self.held += 1
            self.glitches += 1
            return self.last
        self.held, self.last = 0, (gyro, down)
        return self.last

    def read(self):
        """(gyro rad/s, gravity unit vector pointing down), body frame; None when the BNO055 drops a reading."""
        try:
            gyro, grav = self.imu.gyro, self.imu.gravity
        except OSError:                                 # BNO055 clock stretching vs the Pi's I2C: retry
            return None
        if None in gyro or None in grav or not any(grav):
            return None
        down = -(self.rot @ np.array(grav, float))      # the BNO055 reports gravity pointing up (+z when level)
        return self.filter(self.rot @ np.array(gyro, float), down / np.linalg.norm(down))


class Robot(Imu):
    """BNO055 + PCA9685 through Adafruit Blinka, as in ~/robofox_leg_imu_calibration.py."""

    def __init__(self):
        super().__init__()
        from adafruit_motor import servo
        from adafruit_pca9685 import PCA9685
        self.pca = PCA9685(self.i2c, address=0x40)
        self.pca.frequency = 50
        self.servos = [servo.Servo(self.pca.channels[CHANNEL[n]], min_pulse=500, max_pulse=2500) for n in SERVOS]

    def write(self, targets):
        # ponytail: 12 single-channel I2C writes (~1 ms each); batch them if the loop overruns
        for s, name, t in zip(self.servos, SERVOS, targets):
            s.angle = servo_deg(name, t)

    def write_one(self, name, target):
        """Drive one servo; the others get no pulses (limp)."""
        self.servos[SERVOS.index(name)].angle = servo_deg(name, target)

    def limp(self):
        for s in self.servos:
            s.fraction = None
        self.pca.deinit()


class FakeRobot:
    """--dry-run: level and still, prints the servo angles once a second."""

    def __init__(self):
        self.k = 0

    def read(self):
        return np.zeros(3), np.array([0.0, 0.0, -1.0])

    def write(self, targets):
        self.k += 1
        if self.k % 50 == 0:
            print("servo deg:", " ".join("%s %.1f" % (n, servo_deg(n, t)) for n, t in zip(SERVOS, targets)))

    def write_one(self, name, target):
        print("  (fake) %s -> %.1f deg" % (name, servo_deg(name, target)))

    def limp(self):
        pass


class Keys:
    """Keyboard over SSH: W/S, A/D, Q/E step the command (the sim's keys), space or L = stop."""

    STEP = {"w": (0.05, 0, 0), "s": (-0.05, 0, 0), "a": (0, 0.1, 0), "d": (0, -0.1, 0), "q": (0, 0, 0.5), "e": (0, 0, -0.5)}

    def __init__(self, ranges):
        """ranges: the policy's training command ranges (policy_contract): commands are kept inside them."""
        self.lo, self.hi = (np.array([ranges[k][i] for k in ("lin_vel_x", "lin_vel_y", "ang_vel_z")]) for i in (0, 1))
        self.cmd, self.saved = np.zeros(3), None
        if sys.stdin.isatty():
            self.saved = termios.tcgetattr(sys.stdin)
            tty.setcbreak(sys.stdin)

    def poll(self):
        while self.saved and select.select([sys.stdin], [], [], 0)[0]:
            c = sys.stdin.read(1).lower()
            if c in " l":
                self.cmd[:] = 0.0
            elif c in self.STEP:
                self.cmd = np.clip(self.cmd + self.STEP[c], self.lo, self.hi)
            print("command vx %+.2f m/s  vy %+.2f m/s  yaw %+.2f rad/s" % tuple(self.cmd), flush=True)
        return self.cmd

    def close(self):
        if self.saved:
            termios.tcsetattr(sys.stdin, termios.TCSADRAIN, self.saved)


def read_retry(robot):
    for _ in range(25):                  # the BNO055 reads zeros for ~0.1 s after a mode change; I2C glitches
        r = robot.read()
        if r is not None:
            return r
        time.sleep(0.02)
    raise RuntimeError("no IMU reading for 0.5 s")


def settle(robot, n=10, tol_deg=3.0, timeout=2.0):
    """Wait for n readings in a row whose gravity directions agree within tol_deg (the BNO055 can give junk for a
    moment after start or a supply dip); returns the last one."""
    good, end = [], time.perf_counter() + timeout
    while time.perf_counter() < end:
        r = read_retry(robot)
        good = [g for g in good if float(g[1] @ r[1]) > math.cos(math.radians(tol_deg))] + [r]
        if len(good) >= n:
            return r
        time.sleep(DT)
    raise RuntimeError("IMU readings did not settle within %.0f s" % timeout)


def ramp(robot, target, seconds=1.0):
    """Move all servos from home to target (rad from home) over `seconds` instead of jumping there."""
    k_max = max(1, int(seconds / DT))
    for k in range(1, k_max + 1):
        robot.write(np.asarray(target) * k / k_max)
        time.sleep(DT)


def walk(robot, policy, ranges, steps=None, hold_at_end=False, log=None):
    """50 Hz policy loop. Ends limp (Ctrl-C, tilt, errors); with hold_at_end a run that reaches `steps` instead ends
    at the policy's stance and leaves the servos holding (the PCA9685 keeps pulsing after the program exits). log: CSV
    path, one row per step (time, gyro, gravity, command, servo targets in deg). ranges: the policy's command ranges."""
    keys, overruns, k, finished, tilted = Keys(ranges), 0, 0, False, 0
    out = open(log, "w") if log else None
    if out:
        out.write("t,gyro_x,gyro_y,gyro_z,grav_x,grav_y,grav_z,cmd_vx,cmd_vy,cmd_yaw," + ",".join(SERVOS) + "\n")
    try:
        settle(robot)
        ramp(robot, policy.offset)                     # home -> the policy's stance in 1 s, not a 12-servo jump
        targets = policy.reset(*settle(robot), keys.cmd)
        tick = time.perf_counter()
        while steps is None or k < steps:
            robot.write(targets)
            tick += DT
            late = tick - time.perf_counter()
            if late > 0:
                time.sleep(late)
            else:
                overruns += 1
            gyro, down = read_retry(robot)
            tilted = tilted + 1 if down[2] > -0.5 else 0
            if tilted >= 3:                             # past 60 deg for 3 readings (60 ms): fallen over, not a glitch
                print("tilted over: stopping")
                break
            cmd = keys.poll()
            targets = policy.step(gyro, down, cmd)
            if out:
                out.write("%.4f,%s,%s,%s,%s\n" % (time.perf_counter(), ",".join("%.4f" % v for v in gyro),
                          ",".join("%.4f" % v for v in down), ",".join("%.2f" % v for v in cmd),
                          ",".join("%.1f" % servo_deg(n, t) for n, t in zip(SERVOS, targets))))
            k += 1
        finished = steps is not None and k >= steps
    finally:
        keys.close()
        if finished and hold_at_end:
            robot.write(policy.offset)
            print("time up: servos back at the stance and still holding (limp them with fox_calib.py L, or power)")
        else:
            robot.limp()
        print("%d steps, %d over the 20 ms budget, %d IMU glitches held%s" % (k, overruns, getattr(robot, "glitches", 0),
              "; log: " + log if log else ""))
        if out:
            out.close()


def main():
    p = argparse.ArgumentParser(description=__doc__, formatter_class=argparse.RawDescriptionHelpFormatter)
    p.add_argument("policy", help="policy.onnx (its .onnx.data next to it)")
    p.add_argument("--dry-run", action="store_true", help="fake hardware, 3 s")
    p.add_argument("--check-imu", action="store_true", help="print body-frame gyro and gravity")
    p.add_argument("--wiggle", choices=SERVOS, help="move one servo +/- around its centre (the others stay limp)")
    p.add_argument("--amplitude", type=float, default=10.0, help="--wiggle size in deg (57 for timing a servo on video)")
    p.add_argument("--set", metavar="SERVO=DEG", help="move one servo straight to DEG from its centre, hold 2 s, limp")
    p.add_argument("--seconds", type=float, help="run the policy (or --balance) this long, then keep holding")
    p.add_argument("--balance", action="store_true", help="no policy: hold the attitude captured in the first --capture s "
                   "(hold the robot steady meanwhile) within +-tol deg by changing leg lengths")
    p.add_argument("--capture", type=float, default=10.0, help="--balance: seconds to capture the target attitude")
    p.add_argument("--tol", type=float, default=1.0, help="--balance: allowed pitch / roll error, deg")
    p.add_argument("--log", metavar="CSV", help="policy run: write time, IMU, command and servo targets every step")
    p.add_argument("--stand", type=float, metavar="SECONDS", help="all servos to home (no policy), print the body tilt, limp")
    p.add_argument("--level-imu", type=float, metavar="SECONDS", help="stand at home, robot level and untouched: average the "
                   "IMU and save that reading as level (corrects a tilted IMU mount)")
    a = p.parse_args()
    if a.set and (a.set.split("=")[0] not in SERVOS or a.set.count("=") != 1):
        p.error("--set needs SERVO=DEG with SERVO one of %s" % ", ".join(SERVOS))
    robot = FakeRobot() if a.dry_run else Imu() if (a.check_imu or a.level_imu) else Robot()
    try:
        if a.check_imu:
            print("expect: level -> gravity (0, 0, -1); nose down -> x > 0; left side down -> y > 0; turn left -> gyro z > 0")
            while True:
                gyro, down = read_retry(robot)
                print("gyro %+.2f %+.2f %+.2f rad/s   gravity %+.2f %+.2f %+.2f" % (*gyro, *down), flush=True)
                time.sleep(0.2)
        if a.level_imu:
            print("IMU only (servos untouched): keep the robot standing level at home and untouched for %.0f s" % a.level_imu,
                  flush=True)
            robot.rot = np.array(IMU_TO_BODY, float)          # measure in the mount frame, without an old correction
            g, end = [], time.perf_counter() + a.level_imu
            while time.perf_counter() < end:
                g.append(read_retry(robot)[1])
                time.sleep(0.05)
            g0 = np.mean(g, axis=0)
            g0 /= np.linalg.norm(g0)
            spread = np.degrees(np.arcsin(np.clip(np.std(np.array(g)[:, :2], axis=0), 0.0, 1.0))).max()
            c = json.load(open(CALIB_FILE)) if os.path.exists(CALIB_FILE) else {}
            c["imu_level_gravity"] = [round(float(x), 5) for x in g0]
            with open(CALIB_FILE + ".tmp", "w") as f:
                json.dump(c, f, indent=1)
            os.replace(CALIB_FILE + ".tmp", CALIB_FILE)
            print("level reading: pitch %+.1f deg, roll %+.1f deg (wobble %.2f deg, %d samples) -> saved in %s"
                  % (math.degrees(math.asin(g0[0])), math.degrees(math.asin(g0[1])), spread, len(g), CALIB_FILE), flush=True)
            return
        if a.stand:
            print("all servos to the %s for %.0f s (no policy); body tilt from the IMU, level = 0 / 0"
                  % ("stand pose" if STAND_DEG else "home", a.stand), flush=True)
            robot.write(stance({leg: 0.0 for leg in LEGS}))
            end = time.perf_counter() + a.stand
            while time.perf_counter() < end:
                down = read_retry(robot)[1]
                print("  pitch %+5.1f deg (nose down +)   roll %+5.1f deg (left side down +)"
                      % tuple(math.degrees(math.asin(np.clip(v, -1.0, 1.0))) for v in down[:2]), flush=True)
                time.sleep(0.5)
            return
        if a.set:
            name, deg = a.set.split("=")
            print("%s on channel %d -> %.1f deg (centre %.1f %+.0f), hold 2 s, then limp"
                  % (name, CHANNEL[name], servo_deg(name, math.radians(float(deg))), NEUTRAL_DEG[name], float(deg)), flush=True)
            robot.write_one(name, math.radians(float(deg)))
            time.sleep(2.0)
            return
        if a.wiggle:
            amp = math.radians(a.amplitude)
            print("%s on channel %d, centre %.1f deg, +/-%.0f deg; + means: %s"
                  % (a.wiggle, CHANNEL[a.wiggle], NEUTRAL_DEG[a.wiggle], a.amplitude, PLUS[a.wiggle.split("_")[1]]), flush=True)
            for t in (0.0, amp, 0.0, -amp) * 2 + (0.0,):
                print("  %-6s %.1f deg  (t = %.3f s)" % ({0.0: "centre"}.get(t, "+" if t > 0 else "-"), servo_deg(a.wiggle, t),
                                                          time.perf_counter()), flush=True)
                robot.write_one(a.wiggle, t)
                time.sleep(1.0)
            return
    except KeyboardInterrupt:
        return
    finally:
        if a.wiggle or a.set or a.stand or (a.dry_run and (a.check_imu or a.level_imu)):
            robot.limp()
    if a.balance:
        try:
            balance(robot, capture=a.capture, tol=a.tol, seconds=a.seconds or (3.0 if a.dry_run else None), log=a.log)
        except KeyboardInterrupt:
            pass
        return
    c = policy_contract(a.policy)
    if list(c["servos"]) != SERVOS:
        raise SystemExit("policy.json lists the servos in another order than fox_pi.SERVOS")
    if float(c["gear_ratio"]) != GEAR_RATIO:
        raise SystemExit("%s was trained for %g:1 gears, but servo_calib.json says the robot has %g:1 (fox_calib.py --gear-ratio)"
                         % (a.policy, float(c["gear_ratio"]), GEAR_RATIO))
    print("policy %s: gears %g:1, commands vx %s vy %s yaw %s" % (a.policy, GEAR_RATIO, *(c["command_ranges"][k] for k in
          ("lin_vel_x", "lin_vel_y", "ang_vel_z"))), flush=True)
    problems, notes = reach(c)
    for line in notes:
        print("WARNING " + line + ": targets past it are clamped (re-mesh a tooth to centre it)", flush=True)
    if problems:
        raise SystemExit("can't reach the policy's stance: " + "; ".join(problems))
    steps = int(a.seconds / DT) if a.seconds else 150 if a.dry_run else None
    walk(robot, FoxPolicy(onnx_infer(a.policy), c["scale"], c["offset_rad"], c.get("target_limits_rad"), c.get("gait_hz")),
         c["command_ranges"], steps=steps,
         hold_at_end=bool(a.seconds), log=a.log)


if __name__ == "__main__":
    main()
