thiagopari/fox_rl_model/policies/fox_v7_home_v1/params/env.yaml

viewer:
  eye: !!python/tuple
  - 7.5
  - 7.5
  - 7.5
  lookat: !!python/tuple
  - 0.0
  - 0.0
  - 0.0
  cam_prim_path: /OmniverseKit_Persp
  resolution: !!python/tuple
  - 1280
  - 720
  origin_type: world
  env_index: 0
  asset_name: null
  body_name: null
sim:
  device: cuda:0
  dt: 0.005
  gravity: !!python/tuple
  - 0.0
  - 0.0
  - -9.81
  physics_prim_path: /physicsScene
  physics_material:
    func: isaaclab.sim.spawners.materials.physics_materials:spawn_rigid_body_material
    static_friction: 1.0
    dynamic_friction: 1.0
    restitution: 0.0
    compliant_contact_stiffness: null
    compliant_contact_damping: null
    friction_combine_mode: multiply
    restitution_combine_mode: multiply
    _usd_applied_schema: PhysxMaterialAPI
    _usd_field_exceptions: {}
    _usd_namespace: physxMaterial
  use_fabric: true
  render_interval: 4
  enable_scene_query_support: false
  use_newton_actuators: false
  physics:
    class_type: isaaclab_physx.physics.physx_manager:PhysxManager
    solver_type: 1
    solve_articulation_contact_last: false
    min_position_iteration_count: 1
    max_position_iteration_count: 255
    min_velocity_iteration_count: 0
    max_velocity_iteration_count: 255
    enable_scene_query_support: false
    enable_ccd: false
    enable_stabilization: false
    enable_external_forces_every_iteration: false
    enable_enhanced_determinism: false
    bounce_threshold_velocity: 0.5
    friction_offset_threshold: 0.04
    friction_correlation_distance: 0.025
    gpu_max_rigid_contact_count: 1048576
    gpu_max_rigid_patch_count: 262144
    gpu_found_lost_pairs_capacity: 1048576
    gpu_found_lost_aggregate_pairs_capacity: 4194304
    gpu_total_aggregate_pairs_capacity: 1048576
    gpu_collision_stack_size: 67108864
    gpu_heap_capacity: 67108864
    gpu_temp_buffer_capacity: 16777216
    gpu_max_num_partitions: 8
    gpu_max_soft_body_contacts: 1048576
    gpu_max_particle_contacts: 1048576
  render:
    enable_translucency: null
    enable_reflections: null
    enable_global_illumination: null
    antialiasing_mode: null
    enable_dlssg: null
    enable_dl_denoiser: null
    dlss_mode: null
    enable_direct_lighting: null
    samples_per_pixel: null
    enable_shadows: null
    enable_ambient_occlusion: null
    dome_light_upper_lower_strategy: null
    max_bounces: null
    split_glass: null
    split_clearcoat: null
    split_rough_reflection: null
    ambient_light_intensity: null
    ambient_occlusion_denoiser_mode: null
    view_tile_limit: null
    carb_settings: null
    rendering_mode: null
  create_stage_in_memory: false
  logging_level: WARNING
  save_logs_to_file: true
  log_dir: null
  visualizer_cfgs: []
ui_window_class_type: isaaclab.envs.ui.manager_based_rl_env_window:ManagerBasedRLEnvWindow
seed: 42
decimation: 4
scene:
  num_envs: 2048
  env_spacing: 1.0
  lazy_sensor_update: true
  replicate_physics: true
  filter_collisions: true
  clone_in_fabric: false
  robot:
    class_type: isaaclab.assets.articulation.articulation:Articulation
    prim_path: /World/envs/env_.*/Robot
    spawn:
      func: isaaclab.sim.spawners.from_files.from_files:spawn_from_usd
      visible: true
      semantic_tags: null
      copy_from_source: true
      spawn_path: /World/envs/env_0/Robot
      mass_props: null
      deformable_props: null
      rigid_props:
        rigid_body_enabled: null
        kinematic_enabled: null
        disable_gravity: false
        linear_damping: 0.0
        angular_damping: 0.0
        max_linear_velocity: 1000.0
        max_angular_velocity: 1000.0
        max_depenetration_velocity: 1.0
        max_contact_impulse: null
        enable_gyroscopic_forces: null
        retain_accelerations: false
        solver_position_iteration_count: null
        solver_velocity_iteration_count: null
        sleep_threshold: null
        stabilization_threshold: null
        _usd_applied_schema: PhysxRigidBodyAPI
        _usd_field_exceptions:
          PhysxRigidBodyAPI: !!python/tuple
          - physxRigidBody
          - - disable_gravity
        _usd_namespace: physxRigidBody
      collision_props: null
      activate_contact_sensors: true
      scale: null
      articulation_props:
        articulation_enabled: null
        fix_root_link: null
        enabled_self_collisions: false
        solver_position_iteration_count: 4
        solver_velocity_iteration_count: 0
        sleep_threshold: null
        stabilization_threshold: null
        _usd_applied_schema: PhysxArticulationAPI
        _usd_field_exceptions:
          PhysxArticulationAPI: !!python/tuple
          - physxArticulation
          - - articulation_enabled
        _usd_namespace: physxArticulation
      fixed_tendons_props: null
      spatial_tendons_props: null
      joint_drive_props: null
      visual_material_path: material
      visual_material: null
      physics_material_path: material
      physics_material: null
      usd_path: /home/thiago/Documents/fox_rl_model/v7/usd/fox.usd
      variants: null
    init_state:
      pos: !!python/tuple
      - 0.0
      - 0.0
      - 0.16
      rot: !!python/tuple
      - 0.0
      - 0.0
      - 0.0
      - 1.0
      lin_vel: !!python/tuple
      - 0.0
      - 0.0
      - 0.0
      ang_vel: !!python/tuple
      - 0.0
      - 0.0
      - 0.0
      joint_pos:
        .*: 0.0
      joint_vel:
        .*: 0.0
    collision_group: 0
    debug_vis: false
    disable_shape_checks: null
    articulation_root_prim_path: null
    soft_joint_pos_limit_factor: 0.9
    actuators:
      servos:
        class_type: fox_cfg:FoxServoActuator
        joint_names_expr:
        - .*_hip_joint
        - .*_thigh_joint
        - .*_calf_joint
        effort_limit: 0.47
        velocity_limit: 10.5
        effort_limit_sim: 2.0
        velocity_limit_sim: null
        stiffness: 5.0
        damping: 0.08
        armature:
          .*_hip_joint: 0.0005
          .*_thigh_joint: 0.0025
          .*_calf_joint: 0.002
        friction: 0.0
        dynamic_friction: null
        viscous_friction: null
        min_delay: 1
        max_delay: 5
        backlash: !!python/tuple
        - 0.02
        - 0.02
        - 0.15
        backlash_min: !!python/tuple
        - 0.0
        - 0.0
        - 0.0
        stiction: !!python/tuple
        - 0.0
        - 0.0
        - 0.0
        torque_speed: true
        gear_ratio: 2.0
    actuator_value_resolution_debug_print: false
  terrain:
    class_type: isaaclab.terrains.terrain_importer:TerrainImporter
    collision_group: -1
    prim_path: /World/ground
    num_envs: 2048
    terrain_type: plane
    terrain_generator: null
    usd_path: null
    env_spacing: 1.0
    use_terrain_origins: true
    visual_material:
      func: isaaclab.sim.spawners.materials.visual_materials:spawn_from_mdl_file
      mdl_path: https://omniverse-content-production.s3-us-west-2.amazonaws.com/Assets/Isaac/6.0/Isaac/IsaacLab/Materials/TilesMarbleSpiderWhiteBrickBondHoned/TilesMarbleSpiderWhite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
      project_uvw: true
      albedo_brightness: null
      texture_scale: !!python/tuple
      - 0.25
      - 0.25
    physics_material:
      func: isaaclab.sim.spawners.materials.physics_materials:spawn_rigid_body_material
      static_friction: 1.0
      dynamic_friction: 1.0
      restitution: 0.0
      compliant_contact_stiffness: null
      compliant_contact_damping: null
      friction_combine_mode: multiply
      restitution_combine_mode: multiply
      _usd_applied_schema: PhysxMaterialAPI
      _usd_field_exceptions: {}
      _usd_namespace: physxMaterial
    max_init_terrain_level: 5
    debug_vis: false
  height_scanner: null
  contact_forces:
    class_type: isaaclab_physx.sensors.contact_sensor.contact_sensor:ContactSensor
    prim_path: /World/envs/env_.*/Robot/.*
    update_period: 0.0
    debug_vis: false
    track_pose: false
    track_contact_points: false
    track_friction_forces: false
    max_contact_data_count_per_prim: null
    track_air_time: true
    force_threshold: null
    history_length: 3
    filter_prim_paths_expr: []
    visualizer_cfg:
      prim_path: /Visuals/ContactSensor
      markers:
        contact:
          func: isaaclab.sim.spawners.shapes.shapes:spawn_sphere
          visible: true
          semantic_tags: null
          copy_from_source: true
          spawn_path: null
          mass_props: null
          rigid_props: null
          collision_props: null
          activate_contact_sensors: false
          visual_material_path: material
          visual_material:
            func: isaaclab.sim.spawners.materials.visual_materials:spawn_preview_surface
            diffuse_color: !!python/tuple
            - 1.0
            - 0.0
            - 0.0
            emissive_color: !!python/tuple
            - 0.0
            - 0.0
            - 0.0
            roughness: 0.5
            metallic: 0.0
            opacity: 1.0
          physics_material_path: material
          physics_material: null
          radius: 0.02
        no_contact:
          func: isaaclab.sim.spawners.shapes.shapes:spawn_sphere
          visible: false
          semantic_tags: null
          copy_from_source: true
          spawn_path: null
          mass_props: null
          rigid_props: null
          collision_props: null
          activate_contact_sensors: false
          visual_material_path: material
          visual_material:
            func: isaaclab.sim.spawners.materials.visual_materials:spawn_preview_surface
            diffuse_color: !!python/tuple
            - 0.0
            - 1.0
            - 0.0
            emissive_color: !!python/tuple
            - 0.0
            - 0.0
            - 0.0
            roughness: 0.5
            metallic: 0.0
            opacity: 1.0
          physics_material_path: material
          physics_material: null
          radius: 0.02
  sky_light:
    class_type: null
    prim_path: /World/skyLight
    spawn:
      func: isaaclab.sim.spawners.lights.lights:spawn_light
      visible: true
      semantic_tags: null
      copy_from_source: true
      spawn_path: /World/skyLight
      prim_type: DomeLight
      color: !!python/tuple
      - 1.0
      - 1.0
      - 1.0
      enable_color_temperature: false
      color_temperature: 6500.0
      normalize: false
      exposure: 0.0
      intensity: 750.0
      texture_file: https://omniverse-content-production.s3-us-west-2.amazonaws.com/Assets/Isaac/6.0/Isaac/Materials/Textures/Skies/PolyHaven/kloofendal_43d_clear_puresky_4k.hdr
      texture_format: automatic
      visible_in_primary_ray: true
    init_state:
      pos: !!python/tuple
      - 0.0
      - 0.0
      - 0.0
      rot: !!python/tuple
      - 0.0
      - 0.0
      - 0.0
      - 1.0
    collision_group: 0
    debug_vis: false
    disable_shape_checks: null
recorders:
  dataset_file_handler_class_type: isaaclab.utils.datasets.hdf5_dataset_file_handler:HDF5DatasetFileHandler
  dataset_export_dir_path: /tmp/isaaclab/logs
  dataset_filename: dataset
  dataset_export_mode:
    _value_: 1
    _name_: EXPORT_ALL
    _sort_order_: 1
  export_in_record_pre_reset: true
  export_in_close: false
  dataset_compression: true
observations:
  policy:
    concatenate_terms: true
    concatenate_dim: -1
    enable_corruption: true
    history_length: 5
    flatten_history_dim: true
    base_ang_vel:
      func: isaaclab.envs.mdp.observations:base_ang_vel
      params: {}
      modifiers: null
      noise:
        func: isaaclab.utils.noise.noise_model:uniform_noise
        operation: add
        n_min: -0.2
        n_max: 0.2
      clip: null
      scale: null
      history_length: 0
      flatten_history_dim: true
    projected_gravity:
      func: isaaclab.envs.mdp.observations:projected_gravity
      params: {}
      modifiers: null
      noise:
        func: isaaclab.utils.noise.noise_model:uniform_noise
        operation: add
        n_min: -0.05
        n_max: 0.05
      clip: null
      scale: null
      history_length: 0
      flatten_history_dim: true
    velocity_commands:
      func: isaaclab.envs.mdp.observations:generated_commands
      params:
        command_name: base_velocity
      modifiers: null
      noise: null
      clip: null
      scale: null
      history_length: 0
      flatten_history_dim: true
    actions:
      func: isaaclab.envs.mdp.observations:last_action
      params:
        action_name: joint_pos
      modifiers: null
      noise: null
      clip: null
      scale: null
      history_length: 0
      flatten_history_dim: true
    height_scan: null
  critic:
    concatenate_terms: true
    concatenate_dim: -1
    enable_corruption: false
    history_length: null
    flatten_history_dim: true
    base_lin_vel:
      func: isaaclab.envs.mdp.observations:base_lin_vel
      params: {}
      modifiers: null
      noise: null
      clip: null
      scale: null
      history_length: 0
      flatten_history_dim: true
    base_ang_vel:
      func: isaaclab.envs.mdp.observations:base_ang_vel
      params: {}
      modifiers: null
      noise: null
      clip: null
      scale: null
      history_length: 0
      flatten_history_dim: true
    projected_gravity:
      func: isaaclab.envs.mdp.observations:projected_gravity
      params: {}
      modifiers: null
      noise: null
      clip: null
      scale: null
      history_length: 0
      flatten_history_dim: true
    velocity_commands:
      func: isaaclab.envs.mdp.observations:generated_commands
      params:
        command_name: base_velocity
      modifiers: null
      noise: null
      clip: null
      scale: null
      history_length: 0
      flatten_history_dim: true
    joint_pos:
      func: isaaclab.envs.mdp.observations:joint_pos_rel
      params: {}
      modifiers: null
      noise: null
      clip: null
      scale: null
      history_length: 0
      flatten_history_dim: true
    joint_vel:
      func: isaaclab.envs.mdp.observations:joint_vel_rel
      params: {}
      modifiers: null
      noise: null
      clip: null
      scale: null
      history_length: 0
      flatten_history_dim: true
    actions:
      func: isaaclab.envs.mdp.observations:last_action
      params:
        action_name: joint_pos
      modifiers: null
      noise: null
      clip: null
      scale: null
      history_length: 0
      flatten_history_dim: true
actions:
  joint_pos:
    class_type: fox_mdp:FoxServoAction
    asset_name: robot
    debug_vis: false
    clip:
      .*_hip_joint: !!python/tuple
      - -0.5
      - 0.5
      .*_thigh_joint: !!python/tuple
      - -0.8727
      - 0.8727
      .*_calf_joint: !!python/tuple
      - -1.5708
      - 1.5708
    joint_names:
    - .*_hip_joint
    - .*_thigh_joint
    - .*_calf_joint
    scale:
      .*_hip_joint: 0.25
      .*_thigh_joint: 0.25
      .*_calf_joint: 0.5
    offset: 0.0
    preserve_order: false
    use_default_offset: false
events:
  physics_material:
    func: isaaclab.envs.mdp.events:randomize_rigid_body_material
    params:
      asset_cfg:
        name: robot
        joint_names: null
        joint_ids: !!python/object/apply:builtins.slice
        - null
        - null
        - null
        fixed_tendon_names: null
        fixed_tendon_ids: !!python/object/apply:builtins.slice
        - null
        - null
        - null
        body_names: .*
        body_ids: !!python/object/apply:builtins.slice
        - null
        - null
        - null
        object_collection_names: null
        object_collection_ids: !!python/object/apply:builtins.slice
        - null
        - null
        - null
        preserve_order: false
      static_friction_range: !!python/tuple
      - 0.8
      - 0.8
      dynamic_friction_range: !!python/tuple
      - 0.6
      - 0.6
      restitution_range: !!python/tuple
      - 0.0
      - 0.0
      num_buckets: 64
    mode: startup
    interval_range_s: null
    is_global_time: false
    min_step_count_between_reset: 0
  add_base_mass:
    func: isaaclab.envs.mdp.events:randomize_rigid_body_mass
    params:
      asset_cfg:
        name: robot
        joint_names: null
        joint_ids: !!python/object/apply:builtins.slice
        - null
        - null
        - null
        fixed_tendon_names: null
        fixed_tendon_ids: !!python/object/apply:builtins.slice
        - null
        - null
        - null
        body_names: base
        body_ids: !!python/object/apply:builtins.slice
        - null
        - null
        - null
        object_collection_names: null
        object_collection_ids: !!python/object/apply:builtins.slice
        - null
        - null
        - null
        preserve_order: false
      mass_distribution_params: !!python/tuple
      - -0.03
      - 0.2
      operation: add
      distribution: uniform
    mode: startup
    interval_range_s: null
    is_global_time: false
    min_step_count_between_reset: 0
  base_com:
    func: isaaclab.envs.mdp.events:randomize_rigid_body_com
    params:
      asset_cfg:
        name: robot
        joint_names: null
        joint_ids: !!python/object/apply:builtins.slice
        - null
        - null
        - null
        fixed_tendon_names: null
        fixed_tendon_ids: !!python/object/apply:builtins.slice
        - null
        - null
        - null
        body_names: base
        body_ids: !!python/object/apply:builtins.slice
        - null
        - null
        - null
        object_collection_names: null
        object_collection_ids: !!python/object/apply:builtins.slice
        - null
        - null
        - null
        preserve_order: false
      com_range:
        x: !!python/tuple
        - -0.01
        - 0.01
        y: !!python/tuple
        - -0.01
        - 0.01
        z: !!python/tuple
        - -0.005
        - 0.005
    mode: startup
    interval_range_s: null
    is_global_time: false
    min_step_count_between_reset: 0
  base_external_force_torque:
    func: isaaclab.envs.mdp.events:apply_external_force_torque
    params:
      asset_cfg:
        name: robot
        joint_names: null
        joint_ids: !!python/object/apply:builtins.slice
        - null
        - null
        - null
        fixed_tendon_names: null
        fixed_tendon_ids: !!python/object/apply:builtins.slice
        - null
        - null
        - null
        body_names: base
        body_ids: !!python/object/apply:builtins.slice
        - null
        - null
        - null
        object_collection_names: null
        object_collection_ids: !!python/object/apply:builtins.slice
        - null
        - null
        - null
        preserve_order: false
      force_range: !!python/tuple
      - 0.0
      - 0.0
      torque_range: !!python/tuple
      - -0.0
      - 0.0
    mode: reset
    interval_range_s: null
    is_global_time: false
    min_step_count_between_reset: 0
  reset_base:
    func: isaaclab.envs.mdp.events:reset_root_state_uniform
    params:
      pose_range:
        x: !!python/tuple
        - -0.25
        - 0.25
        y: !!python/tuple
        - -0.25
        - 0.25
        yaw: !!python/tuple
        - -3.14
        - 3.14
      velocity_range:
        x: !!python/tuple
        - -0.1
        - 0.1
        y: !!python/tuple
        - -0.1
        - 0.1
        z: !!python/tuple
        - -0.1
        - 0.1
        roll: !!python/tuple
        - -0.1
        - 0.1
        pitch: !!python/tuple
        - -0.1
        - 0.1
        yaw: !!python/tuple
        - -0.1
        - 0.1
    mode: reset
    interval_range_s: null
    is_global_time: false
    min_step_count_between_reset: 0
  reset_robot_joints:
    func: isaaclab.envs.mdp.events:reset_joints_by_scale
    params:
      position_range: !!python/tuple
      - 0.5
      - 1.5
      velocity_range: !!python/tuple
      - 0.0
      - 0.0
    mode: reset
    interval_range_s: null
    is_global_time: false
    min_step_count_between_reset: 0
  push_robot:
    func: isaaclab.envs.mdp.events:push_by_setting_velocity
    params:
      velocity_range:
        x: !!python/tuple
        - -0.15
        - 0.15
        y: !!python/tuple
        - -0.15
        - 0.15
    mode: interval
    interval_range_s: !!python/tuple
    - 8.0
    - 12.0
    is_global_time: false
    min_step_count_between_reset: 0
  servo_gains:
    func: isaaclab.envs.mdp.events:randomize_actuator_gains
    params:
      asset_cfg:
        name: robot
        joint_names:
        - .*_hip_joint
        - .*_thigh_joint
        - .*_calf_joint
        joint_ids: !!python/object/apply:builtins.slice
        - null
        - null
        - null
        fixed_tendon_names: null
        fixed_tendon_ids: !!python/object/apply:builtins.slice
        - null
        - null
        - null
        body_names: null
        body_ids: !!python/object/apply:builtins.slice
        - null
        - null
        - null
        object_collection_names: null
        object_collection_ids: !!python/object/apply:builtins.slice
        - null
        - null
        - null
        preserve_order: false
      operation: scale
      distribution: uniform
      stiffness_distribution_params: !!python/tuple
      - 0.8
      - 1.2
      damping_distribution_params: !!python/tuple
      - 0.7
      - 1.3
    mode: reset
    interval_range_s: null
    is_global_time: false
    min_step_count_between_reset: 0
rerender_on_reset: false
num_rerenders_on_reset: 0
wait_for_textures: true
xr: null
teleop_devices:
  devices: {}
isaac_teleop: null
export_io_descriptors: false
log_dir: /home/thiago/Documents/fox_rl_model/logs/rsl_rl/fox_flat_blind_v7_home/2026-10-10_11-10-19
video_recorder:
  class_type: isaaclab.envs.utils.video_recorder:VideoRecorder
  env_render_mode: null
  eye: !!python/tuple
  - 7.5
  - 7.5
  - 7.5
  lookat: !!python/tuple
  - 0.0
  - 0.0
  - 0.0
  backend_source: visualizer
  window_width: 1280
  window_height: 720
is_finite_horizon: false
episode_length_s: 20.0
rewards:
  track_lin_vel_xy_exp:
    func: isaaclab.envs.mdp.rewards:track_lin_vel_xy_exp
    params:
      command_name: base_velocity
      std: 0.25
    weight: 1.5
  track_ang_vel_z_exp:
    func: isaaclab.envs.mdp.rewards:track_ang_vel_z_exp
    params:
      command_name: base_velocity
      std: 0.3
    weight: 1.0
  lin_vel_z_l2:
    func: isaaclab.envs.mdp.rewards:lin_vel_z_l2
    params: {}
    weight: -2.0
  ang_vel_xy_l2:
    func: isaaclab.envs.mdp.rewards:ang_vel_xy_l2
    params: {}
    weight: -0.05
  dof_torques_l2:
    func: isaaclab.envs.mdp.rewards:joint_torques_l2
    params: {}
    weight: -0.01
  dof_acc_l2:
    func: isaaclab.envs.mdp.rewards:joint_acc_l2
    params: {}
    weight: -1.0e-07
  action_rate_l2:
    func: isaaclab.envs.mdp.rewards:action_rate_l2
    params: {}
    weight: -0.05
  feet_air_time: null
  undesired_contacts:
    func: isaaclab.envs.mdp.rewards:undesired_contacts
    params:
      sensor_cfg:
        name: contact_forces
        joint_names: null
        joint_ids: !!python/object/apply:builtins.slice
        - null
        - null
        - null
        fixed_tendon_names: null
        fixed_tendon_ids: !!python/object/apply:builtins.slice
        - null
        - null
        - null
        body_names:
        - .*_thigh
        - .*_calf
        body_ids: !!python/object/apply:builtins.slice
        - null
        - null
        - null
        object_collection_names: null
        object_collection_ids: !!python/object/apply:builtins.slice
        - null
        - null
        - null
        preserve_order: false
      threshold: 1.0
    weight: -1.0
  flat_orientation_l2:
    func: isaaclab.envs.mdp.rewards:flat_orientation_l2
    params: {}
    weight: -2.5
  dof_pos_limits:
    func: isaaclab.envs.mdp.rewards:joint_pos_limits
    params: {}
    weight: 0.0
  termination_penalty:
    func: isaaclab.envs.mdp.rewards:is_terminated
    params: {}
    weight: -200.0
  alive:
    func: isaaclab.envs.mdp.rewards:is_alive
    params: {}
    weight: 0.5
  air_time:
    func: isaaclab_tasks.manager_based.locomotion.velocity.config.spot.mdp.rewards:air_time_reward
    params:
      mode_time: 0.15
      velocity_threshold: 1.0
      asset_cfg:
        name: robot
        joint_names: null
        joint_ids: !!python/object/apply:builtins.slice
        - null
        - null
        - null
        fixed_tendon_names: null
        fixed_tendon_ids: !!python/object/apply:builtins.slice
        - null
        - null
        - null
        body_names: null
        body_ids: !!python/object/apply:builtins.slice
        - null
        - null
        - null
        object_collection_names: null
        object_collection_ids: !!python/object/apply:builtins.slice
        - null
        - null
        - null
        preserve_order: false
      sensor_cfg:
        name: contact_forces
        joint_names: null
        joint_ids: !!python/object/apply:builtins.slice
        - null
        - null
        - null
        fixed_tendon_names: null
        fixed_tendon_ids: !!python/object/apply:builtins.slice
        - null
        - null
        - null
        body_names: .*_foot
        body_ids: !!python/object/apply:builtins.slice
        - null
        - null
        - null
        object_collection_names: null
        object_collection_ids: !!python/object/apply:builtins.slice
        - null
        - null
        - null
        preserve_order: false
    weight: 3.0
  gait:
    func: isaaclab_tasks.manager_based.locomotion.velocity.config.spot.mdp.rewards:GaitReward
    params:
      std: 0.1
      max_err: 0.2
      velocity_threshold: 1.0
      synced_feet_pair_names: !!python/tuple
      - !!python/tuple
        - FL_foot
        - RR_foot
      - !!python/tuple
        - FR_foot
        - RL_foot
      asset_cfg:
        name: robot
        joint_names: null
        joint_ids: !!python/object/apply:builtins.slice
        - null
        - null
        - null
        fixed_tendon_names: null
        fixed_tendon_ids: !!python/object/apply:builtins.slice
        - null
        - null
        - null
        body_names: null
        body_ids: !!python/object/apply:builtins.slice
        - null
        - null
        - null
        object_collection_names: null
        object_collection_ids: !!python/object/apply:builtins.slice
        - null
        - null
        - null
        preserve_order: false
      sensor_cfg:
        name: contact_forces
        joint_names: null
        joint_ids: !!python/object/apply:builtins.slice
        - null
        - null
        - null
        fixed_tendon_names: null
        fixed_tendon_ids: !!python/object/apply:builtins.slice
        - null
        - null
        - null
        body_names: null
        body_ids: !!python/object/apply:builtins.slice
        - null
        - null
        - null
        object_collection_names: null
        object_collection_ids: !!python/object/apply:builtins.slice
        - null
        - null
        - null
        preserve_order: false
    weight: 1.0
  joint_pos:
    func: isaaclab_tasks.manager_based.locomotion.velocity.config.spot.mdp.rewards:joint_position_penalty
    params:
      asset_cfg:
        name: robot
        joint_names: null
        joint_ids: !!python/object/apply:builtins.slice
        - null
        - null
        - null
        fixed_tendon_names: null
        fixed_tendon_ids: !!python/object/apply:builtins.slice
        - null
        - null
        - null
        body_names: null
        body_ids: !!python/object/apply:builtins.slice
        - null
        - null
        - null
        object_collection_names: null
        object_collection_ids: !!python/object/apply:builtins.slice
        - null
        - null
        - null
        preserve_order: false
      stand_still_scale: 5.0
      velocity_threshold: 0.1
    weight: -0.2
terminations:
  time_out:
    func: isaaclab.envs.mdp.terminations:time_out
    params: {}
    time_out: true
  base_contact:
    func: isaaclab.envs.mdp.terminations:illegal_contact
    params:
      sensor_cfg:
        name: contact_forces
        joint_names: null
        joint_ids: !!python/object/apply:builtins.slice
        - null
        - null
        - null
        fixed_tendon_names: null
        fixed_tendon_ids: !!python/object/apply:builtins.slice
        - null
        - null
        - null
        body_names: base
        body_ids: !!python/object/apply:builtins.slice
        - null
        - null
        - null
        object_collection_names: null
        object_collection_ids: !!python/object/apply:builtins.slice
        - null
        - null
        - null
        preserve_order: false
      threshold: 1.0
    time_out: false
curriculum:
  terrain_levels: null
commands:
  base_velocity:
    class_type: fox_mdp:FoxVelocityCommand
    resampling_time_range: !!python/tuple
    - 10.0
    - 10.0
    debug_vis: true
    cmd_kind: null
    element_names: null
    asset_name: robot
    heading_command: false
    heading_control_stiffness: 0.5
    rel_standing_envs: 0.2
    rel_heading_envs: 0.0
    ranges:
      lin_vel_x: !!python/tuple
      - -0.3
      - 0.3
      lin_vel_y: !!python/tuple
      - 0.0
      - 0.0
      ang_vel_z: !!python/tuple
      - 0.0
      - 0.0
      heading: !!python/tuple
      - -3.141592653589793
      - 3.141592653589793
    vel_xy_success_threshold: 0.5
    vel_yaw_success_threshold: 0.4
    goal_vel_visualizer_cfg:
      prim_path: /Visuals/Command/velocity_goal
      markers:
        arrow:
          func: isaaclab.sim.spawners.from_files.from_files:spawn_from_usd
          visible: true
          semantic_tags: null
          copy_from_source: true
          spawn_path: null
          mass_props: null
          deformable_props: null
          rigid_props: null
          collision_props: null
          activate_contact_sensors: false
          scale: !!python/tuple
          - 0.5
          - 0.5
          - 0.5
          articulation_props: null
          fixed_tendons_props: null
          spatial_tendons_props: null
          joint_drive_props: null
          visual_material_path: material
          visual_material:
            func: isaaclab.sim.spawners.materials.visual_materials:spawn_preview_surface
            diffuse_color: !!python/tuple
            - 0.0
            - 1.0
            - 0.0
            emissive_color: !!python/tuple
            - 0.0
            - 0.0
            - 0.0
            roughness: 0.5
            metallic: 0.0
            opacity: 1.0
          physics_material_path: material
          physics_material: null
          usd_path: https://omniverse-content-production.s3-us-west-2.amazonaws.com/Assets/Isaac/6.0/Isaac/Props/UIElements/arrow_x.usd
          variants: null
    current_vel_visualizer_cfg:
      prim_path: /Visuals/Command/velocity_current
      markers:
        arrow:
          func: isaaclab.sim.spawners.from_files.from_files:spawn_from_usd
          visible: true
          semantic_tags: null
          copy_from_source: true
          spawn_path: null
          mass_props: null
          deformable_props: null
          rigid_props: null
          collision_props: null
          activate_contact_sensors: false
          scale: !!python/tuple
          - 0.5
          - 0.5
          - 0.5
          articulation_props: null
          fixed_tendons_props: null
          spatial_tendons_props: null
          joint_drive_props: null
          visual_material_path: material
          visual_material:
            func: isaaclab.sim.spawners.materials.visual_materials:spawn_preview_surface
            diffuse_color: !!python/tuple
            - 0.0
            - 0.0
            - 1.0
            emissive_color: !!python/tuple
            - 0.0
            - 0.0
            - 0.0
            roughness: 0.5
            metallic: 0.0
            opacity: 1.0
          physics_material_path: material
          physics_material: null
          usd_path: https://omniverse-content-production.s3-us-west-2.amazonaws.com/Assets/Isaac/6.0/Isaac/Props/UIElements/arrow_x.usd
          variants: null
