thiagopari/fox_rl_model/isaaclab/fox_tasks.py

"""Fox walking task for Isaac Lab 3.0-beta2: flat ground, track a (vx, vy, yaw-rate) command.

Registers  Fox-Velocity-Flat             training (2048 robots, randomized); policy sees joint states + body velocity
           Fox-Velocity-Flat-Blind       hardware-ready: the policy sees only the IMU (gyro, gravity), the command and
                                         its own last servo commands (5-step history); realistic servos (latency,
                                         backlash, torque-speed line, gain spread); smooth trot, stands at zero command
           Fox-V7-Velocity-Flat-Blind    the same on the v7 robot (2:1 gear servo drive, no spacer): model in v7/
                                         (tools/build_robot.py --out v7; its USD from tools/isaacsim_import.py)
           Fox-V7-...-Blind-Straight     v7, forward / backward only, hips held at the stance (no hip servos needed)
           Fox-V7-...-Blind-Home         the same, but around home (the CAD pose) instead of the v7 stance
           Fox-...-Play variants         driving / evaluation (few robots, no pushes or noise)
Built on Isaac Lab's quadruped velocity task (the Go1 recipe), re-scaled for a 0.54 kg, 15 cm tall robot. The policy
outputs the 12 SERVO targets (hip, pivot, gear servo angles around the stance, scale 0.25 rad; v7 gear 0.5) that FoxServoActuator
(fox_cfg.py) turns into joint torques through the leg mechanism. 50 Hz policy, 200 Hz physics.
Train with isaaclab/fox_train.py, drive with isaaclab/fox_play.py.
"""
import gymnasium as gym
import torch

from isaaclab.managers import CurriculumTermCfg as CurrTerm
from isaaclab.managers import EventTermCfg as EventTerm
from isaaclab.managers import ObservationGroupCfg as ObsGroup
from isaaclab.managers import ObservationTermCfg as ObsTerm
from isaaclab.managers import RewardTermCfg as RewTerm
from isaaclab.managers import SceneEntityCfg
from isaaclab.sim import SimulationCfg
from isaaclab.utils.configclass import configclass
from isaaclab.utils.noise import UniformNoiseCfg as Unoise
from isaaclab.utils.string import ResolvableString
from isaaclab_physx.physics import PhysxCfg
from isaaclab_rl.rsl_rl import RslRlMLPModelCfg, RslRlOnPolicyRunnerCfg, RslRlPpoAlgorithmCfg, RslRlSymmetryCfg
import isaaclab_tasks.manager_based.locomotion.velocity.config.spot.mdp as spot_mdp
import isaaclab_tasks.manager_based.locomotion.velocity.mdp as mdp
from isaaclab_tasks.manager_based.locomotion.velocity.velocity_env_cfg import LocomotionVelocityRoughEnvCfg

import math
import os

from fox_cfg import FOX_CFG, FOX_DIR, FOX_SERVO_REAL_CFG, fox_model_cfg, geared
from fox_symmetry import compute_symmetric_states

SERVO_JOINTS = [".*_hip_joint", ".*_thigh_joint", ".*_calf_joint"]   # = hip / pivot / gear servo targets


@configclass
class FoxFlatEnvCfg(LocomotionVelocityRoughEnvCfg):
    sim: SimulationCfg = SimulationCfg(physics=PhysxCfg(  # sized for ~2k small robots on an 8 GB GPU
        gpu_max_rigid_contact_count=2**20, gpu_max_rigid_patch_count=2**18, gpu_found_lost_pairs_capacity=2**20,
        gpu_found_lost_aggregate_pairs_capacity=2**22, gpu_total_aggregate_pairs_capacity=2**20))

    def __post_init__(self):
        super().__post_init__()
        self.scene.num_envs, self.scene.env_spacing = 2048, 1.0
        self.scene.robot = FOX_CFG.replace(prim_path="{ENV_REGEX_NS}/Robot")
        # flat ground, no height scan, no terrain curriculum
        self.scene.terrain.terrain_type = "plane"
        self.scene.terrain.terrain_generator = None
        self.scene.height_scanner = None
        self.observations.policy.height_scan = None
        self.curriculum.terrain_levels = None
        # actions: servo targets around the stance
        self.actions.joint_pos.joint_names = SERVO_JOINTS
        self.actions.joint_pos.scale = 0.25
        # commands sized for the robot; yaw rate is commanded directly (what a remote sends)
        cmd = self.commands.base_velocity
        cmd.ranges.lin_vel_x, cmd.ranges.lin_vel_y, cmd.ranges.ang_vel_z = (-0.3, 0.3), (-0.2, 0.2), (-1.0, 1.0)
        cmd.heading_command, cmd.rel_heading_envs, cmd.rel_standing_envs = False, 0.0, 0.1
        # randomization scaled to a 0.54 kg robot (+0.2 kg covers the battery that is not modelled yet)
        self.events.add_base_mass.params.update({"mass_distribution_params": (-0.03, 0.2), "operation": "add", "distribution": "uniform"})
        self.events.base_com.default.params["com_range"] = {"x": (-0.01, 0.01), "y": (-0.01, 0.01), "z": (-0.005, 0.005)}  # a backend preset
        self.events.reset_base.params["pose_range"] = {"x": (-0.25, 0.25), "y": (-0.25, 0.25), "yaw": (-3.14, 3.14)}
        self.events.reset_base.params["velocity_range"] = {k: (-0.1, 0.1) for k in ("x", "y", "z", "roll", "pitch", "yaw")}
        self.events.push_robot.params["velocity_range"] = {"x": (-0.15, 0.15), "y": (-0.15, 0.15)}
        self.events.push_robot.interval_range_s = (8.0, 12.0)
        # rewards: tracking tolerance matched to +-0.3 m/s commands; small servo torques. A fall costs a lot: with only
        # penalties early on, the first run learned to fall within 0.3 s to end the episode
        self.rewards.track_lin_vel_xy_exp.weight, self.rewards.track_lin_vel_xy_exp.params["std"] = 1.5, 0.25
        self.rewards.track_ang_vel_z_exp.weight, self.rewards.track_ang_vel_z_exp.params["std"] = 0.75, 0.4
        self.rewards.termination_penalty = RewTerm(func=mdp.is_terminated, weight=-200.0)
        self.rewards.alive = RewTerm(func=mdp.is_alive, weight=0.5)
        # the Go1 joint-acceleration weight dominated everything here: 2-3 g links accelerate a lot (-0.02/step)
        self.rewards.dof_acc_l2.weight = -2.5e-8
        self.rewards.dof_torques_l2.weight = -0.01
        self.rewards.flat_orientation_l2.weight = -2.5
        self.rewards.feet_air_time.weight = 0.25
        self.rewards.feet_air_time.params["sensor_cfg"].body_names = ".*_foot"
        self.rewards.feet_air_time.params["threshold"] = 0.2           # short legs, short steps
        self.rewards.undesired_contacts.params["sensor_cfg"].body_names = [".*_thigh", ".*_calf"]
        # terminations: body touching the ground (default body name "base" already matches)


@configclass
class FoxFlatEnvCfg_PLAY(FoxFlatEnvCfg):
    def __post_init__(self):
        super().__post_init__()
        self.scene.num_envs, self.scene.env_spacing = 4, 1.0
        self.episode_length_s = 1.0e6                                   # drive as long as you like
        self.observations.policy.enable_corruption = False
        self.events.push_robot = None
        self.events.base_external_force_torque = None
        self.events.reset_base.params["pose_range"] = {"x": (0.0, 0.0), "y": (0.0, 0.0), "yaw": (0.0, 0.0)}


@configclass
class FoxFlatPPORunnerCfg(RslRlOnPolicyRunnerCfg):
    num_steps_per_env = 24
    max_iterations = 1000
    save_interval = 50
    experiment_name = "fox_flat"
    actor = RslRlMLPModelCfg(hidden_dims=[128, 128, 128], activation="elu", obs_normalization=False,
                             distribution_cfg=RslRlMLPModelCfg.GaussianDistributionCfg(init_std=0.5))   # 1.0 knocks the light robot over in 0.5 s
    critic = RslRlMLPModelCfg(hidden_dims=[128, 128, 128], activation="elu", obs_normalization=False)
    algorithm = RslRlPpoAlgorithmCfg(value_loss_coef=1.0, use_clipped_value_loss=True, clip_param=0.2, entropy_coef=0.01,
                                     num_learning_epochs=5, num_mini_batches=4, learning_rate=1.0e-3, schedule="adaptive",
                                     gamma=0.99, lam=0.95, desired_kl=0.01, max_grad_norm=1.0)


@configclass
class FoxBlindObsCfg:
    @configclass
    class PolicyCfg(ObsGroup):
        """What the real robot has: the BNO055 IMU, the remote's command and the servo commands it sent itself."""
        base_ang_vel = ObsTerm(func=mdp.base_ang_vel, noise=Unoise(n_min=-0.2, n_max=0.2))
        projected_gravity = ObsTerm(func=mdp.projected_gravity, noise=Unoise(n_min=-0.05, n_max=0.05))
        velocity_commands = ObsTerm(func=mdp.generated_commands, params={"command_name": "base_velocity"})
        actions = ObsTerm(func=mdp.last_action, params={"action_name": "joint_pos"})   # as sent: hips 0 when held

        def __post_init__(self):
            self.enable_corruption, self.concatenate_terms = True, True
            self.history_length = 5      # 0.1 s of past readings stands in for the missing joint encoders

    @configclass
    class CriticCfg(ObsGroup):
        """Privileged (training only): the full state helps the critic judge a blind actor."""
        base_lin_vel = ObsTerm(func=mdp.base_lin_vel)
        base_ang_vel = ObsTerm(func=mdp.base_ang_vel)
        projected_gravity = ObsTerm(func=mdp.projected_gravity)
        velocity_commands = ObsTerm(func=mdp.generated_commands, params={"command_name": "base_velocity"})
        joint_pos = ObsTerm(func=mdp.joint_pos_rel)
        joint_vel = ObsTerm(func=mdp.joint_vel_rel)
        actions = ObsTerm(func=mdp.last_action, params={"action_name": "joint_pos"})

        def __post_init__(self):
            self.enable_corruption, self.concatenate_terms = False, True

    policy: PolicyCfg = PolicyCfg()
    critic: CriticCfg = CriticCfg()


@configclass
class FoxBlindEnvCfg(FoxFlatEnvCfg):
    observations: FoxBlindObsCfg = FoxBlindObsCfg()

    def __post_init__(self):
        super().__post_init__()
        # smooth, servo-friendly commands and a clean trot (v1 shuffled: steps < 0.2 s, jittery targets)
        self.rewards.action_rate_l2.weight = -0.05
        self.rewards.dof_acc_l2.weight = -1.0e-7
        # Spot's air-time term instead of feet_air_time: each foot phase should last ~0.15 s (a ~3 Hz trot), and at zero
        # command all feet stay down. Blind v1 (policies/fox_flat_blind_v1) trotted at 7 Hz, 0.06 s swings, because the gait
        # term's error is in seconds so short phases score best, and it marched in place when told to stop (drift 7 cm/s).
        # (Isaac Lab's feet_air_time also goes silent 2-16 s into each episode: float32 sensor time.) velocity_threshold
        # 1.0 m/s, beyond the Fox's speed: zero command always means stand; at 0.1 the policy drifted at 0.13 m/s to keep
        # collecting the walking rewards
        self.rewards.feet_air_time = None
        self.rewards.air_time = RewTerm(func=spot_mdp.air_time_reward, weight=3.0, params={
            "mode_time": 0.15, "velocity_threshold": 1.0,
            "asset_cfg": SceneEntityCfg("robot"), "sensor_cfg": SceneEntityCfg("contact_forces", body_names=".*_foot")})
        self.rewards.gait = RewTerm(func=spot_mdp.GaitReward, weight=1.0, params={
            "std": 0.1, "max_err": 0.2, "velocity_threshold": 1.0,
            "synced_feet_pair_names": (("FL_foot", "RR_foot"), ("FR_foot", "RL_foot")),   # diagonal pairs = trot
            "asset_cfg": SceneEntityCfg("robot"), "sensor_cfg": SceneEntityCfg("contact_forces")})
        self.commands.base_velocity.rel_standing_envs = 0.2                                # more practice standing still
        # the servos as the hardware has them (fox_cfg.FOX_SERVO_REAL_CFG): 5-25 ms latency, gear backlash, torque falling
        # with speed, and each servo's gains off by up to 20-30 % (unknown internal controller), redrawn every episode
        self.scene.robot.actuators = {"servos": FOX_SERVO_REAL_CFG}
        self.events.servo_gains = EventTerm(func=mdp.randomize_actuator_gains, mode="reset", params={
            "asset_cfg": SceneEntityCfg("robot", joint_names=SERVO_JOINTS), "operation": "scale", "distribution": "uniform",
            "stiffness_distribution_params": (0.8, 1.2), "damping_distribution_params": (0.7, 1.3)})
        # v2 under-turned by 12 % (0.8 -> 0.71 rad/s): a 0.1 rad/s yaw error cost only 6 % of a lenient term
        # v4: forward / backward / standing without moving the hips (FoxServoAction), trained on 30 % straight commands
        # (fox_mdp.py is imported by name when the env is built: subclassing Isaac Lab's action / command terms imports
        # USD, which must not load before the simulator starts, and fox_train.py imports this file before that)
        self.actions.joint_pos.class_type = ResolvableString("fox_mdp:FoxServoAction")
        self.commands.base_velocity.class_type = ResolvableString("fox_mdp:FoxVelocityCommand")
        self.rewards.track_ang_vel_z_exp.weight, self.rewards.track_ang_vel_z_exp.params["std"] = 1.0, 0.3


@configclass
class FoxBlindV7EnvCfg(FoxBlindEnvCfg):
    """Blind task on the v7 model: its gear ratio, and its level stance as reset pose and as the servo targets' zero.
    The gear servos' actions are scaled by N (0.5 rad at 2:1): N times the servo angle moves the shin as one did at 1:1."""

    def __post_init__(self):
        super().__post_init__()
        robot, offsets = fox_model_cfg(os.path.join(FOX_DIR, "v7"))
        n = robot.actuators["servos"].gear_ratio
        self.scene.robot = robot.replace(prim_path="{ENV_REGEX_NS}/Robot")
        self.scene.robot.actuators = {"servos": geared(FOX_SERVO_REAL_CFG, n)}
        self.actions.joint_pos.use_default_offset = False
        self.actions.joint_pos.offset = offsets
        self.actions.joint_pos.scale = {".*_hip_joint": 0.25, ".*_thigh_joint": 0.25, ".*_calf_joint": 0.25 * n}
        # servo targets stay where the robot can follow (rad from home; policy.json carries them to deploy/fox_pi.py):
        # hips their joint range, pivots fox_pi's +-50 deg default, gear servos +-90 deg (their travel, home at 90)
        self.actions.joint_pos.clip = {".*_hip_joint": (-0.5, 0.5), ".*_thigh_joint": (-0.8727, 0.8727),
                                       ".*_calf_joint": (-1.5708, 1.5708)}
        # hold the stance: without this the v7 policy stood 33 mm crouched with the rear gear servos parked on their -90 deg
        # clamp and stepped in place (2.8 steps/foot/s). Spot's joint position penalty: joint-angle distance from the
        # stance (the default joint pos), 5x when commanded to stand
        self.rewards.joint_pos = RewTerm(func=spot_mdp.joint_position_penalty, weight=-0.2, params={
            "asset_cfg": SceneEntityCfg("robot"), "stand_still_scale": 5.0, "velocity_threshold": 0.1})


@configclass
class FoxBlindV7StraightEnvCfg(FoxBlindV7EnvCfg):
    """v7, forward / backward only: sideways and turning commands are 0, so FoxServoAction holds the hips at the stance
    on every step. For the first runs on the robot, without working hip servos."""

    def __post_init__(self):
        super().__post_init__()
        self.commands.base_velocity.ranges.lin_vel_y = (0.0, 0.0)
        self.commands.base_velocity.ranges.ang_vel_z = (0.0, 0.0)


def _blind_play(cfg):
    cfg.scene.num_envs, cfg.scene.env_spacing = 4, 1.0
    cfg.episode_length_s = 1.0e6
    cfg.observations.policy.enable_corruption = False
    cfg.events.push_robot = None
    cfg.events.base_external_force_torque = None
    cfg.events.reset_base.params["pose_range"] = {"x": (0.0, 0.0), "y": (0.0, 0.0), "yaw": (0.0, 0.0)}


@configclass
class FoxBlindEnvCfg_PLAY(FoxBlindEnvCfg):
    def __post_init__(self):
        super().__post_init__()
        _blind_play(self)


@configclass
class FoxBlindV7EnvCfg_PLAY(FoxBlindV7EnvCfg):
    def __post_init__(self):
        super().__post_init__()
        _blind_play(self)


@configclass
class FoxBlindV7StraightEnvCfg_PLAY(FoxBlindV7StraightEnvCfg):
    def __post_init__(self):
        super().__post_init__()
        _blind_play(self)


@configclass
class FoxBlindV7HomeEnvCfg(FoxBlindV7StraightEnvCfg):
    """v7, forward / backward from home (the CAD pose): it resets there, the servo targets' zero is there and the stance
    penalty pulls toward it. On the robot home stands steadier than the load-optimal v7 stance, whose start did not
    hold under the weight (Thiago, 2026-10-10)."""

    def __post_init__(self):
        super().__post_init__()
        r = self.scene.robot
        self.scene.robot = r.replace(init_state=r.init_state.replace(pos=(0.0, 0.0, 0.16), joint_pos={".*": 0.0}))
        self.actions.joint_pos.offset = 0.0


@configclass
class FoxBlindV7HomeEnvCfg_PLAY(FoxBlindV7HomeEnvCfg):
    def __post_init__(self):
        super().__post_init__()
        _blind_play(self)


FOOT_Z0 = {"F": 0.0179, "R": 0.0279}   # foot body origin height (m) standing at home, front / rear (v7 MuJoCo model)


def foot_lift_reward(env, asset_cfg, lift, std, tanh_mult):
    """Spot's foot_clearance_reward with a target per foot (its standing height + lift): exp(-sum((z - target)^2 *
    tanh(tanh_mult * |v_xy|)) / std), so only feet moving horizontally (swinging) are asked to be up."""
    asset = env.scene[asset_cfg.name]
    z0 = torch.tensor([FOOT_Z0[asset.body_names[i][0]] for i in asset_cfg.body_ids], device=env.device)
    err = torch.square(asset.data.body_pos_w.torch[:, asset_cfg.body_ids, 2] - (z0 + lift))
    swing = torch.tanh(tanh_mult * torch.norm(asset.data.body_lin_vel_w.torch[:, asset_cfg.body_ids, :2], dim=2))
    return torch.exp(-torch.sum(err * swing, dim=1) / std)


@configclass
class FoxBlindV7NaturalEnvCfg(FoxBlindV7HomeEnvCfg):
    """-Home with a natural walk (fox_v7_home_v1 skated: 5 steps/s, feet lifted 5-8 mm and sliding 130-180 mm/s, a
    lopsided left / right, body 19 mm low): a slower trot (each phase ~0.25 s), feet lifted 25 mm, planted feet that do
    not slide, smooth joints, the body at home height, tight speed and heading tracking. The runner adds left-right
    symmetry. Speeds +-0.15 m/s: the legs' stride at home height (the front legs are ~97 % straight there); asked for
    +-0.3, the first runs crouched 20-27 mm to lengthen it, still topped out at 0.09-0.12 m/s, and slid their planted
    feet at 40-110 mm/s (slip weight -1, height -100: ~1 % of the reward each), drifting ~3 deg/s in heading."""

    def __post_init__(self):
        super().__post_init__()
        self.commands.base_velocity.ranges.lin_vel_x = (-0.15, 0.15)
        self.rewards.air_time.params["mode_time"] = 0.25
        self.rewards.gait.weight = 2.0
        # two widths: 0.15 pulls from afar (the +-0.3 runs learned to walk on it), 0.05 makes accuracy pay. 0.1 alone over
        # +-0.15 m/s left standing still worth ~2/3 of the term, and the robot stood (run c1, 600 iterations)
        self.rewards.track_lin_vel_xy_exp.params["std"] = 0.15
        self.rewards.track_lin_fine = RewTerm(func=mdp.track_lin_vel_xy_exp, weight=1.0,
                                              params={"command_name": "base_velocity", "std": 0.05})
        self.rewards.track_ang_vel_z_exp.params["std"] = 0.15
        feet = SceneEntityCfg("robot", body_names=".*_foot")
        # tanh_mult 10: a swinging foot here moves at 0.1-0.3 m/s (Spot's 2 counted it at 20-50 %)
        self.rewards.foot_lift = RewTerm(func=foot_lift_reward, weight=1.0, params={
            "lift": 0.025, "std": 0.001, "tanh_mult": 10.0, "asset_cfg": feet})
        # slip in m/s at 0.1 m/s walking: Spot's -0.5 against its 5.0 tracking at 2 m/s is ~-4 at this speed and weight
        self.rewards.foot_slip = RewTerm(func=spot_mdp.foot_slip_penalty, weight=-5.0, params={
            "asset_cfg": feet, "sensor_cfg": SceneEntityCfg("contact_forces", body_names=".*_foot"), "threshold": 1.0})
        self.rewards.joint_vel = RewTerm(func=spot_mdp.joint_velocity_penalty, weight=-0.01, params={
            "asset_cfg": SceneEntityCfg("robot", joint_names=SERVO_JOINTS)})
        # a level body: the runs walked 6-10 deg nose-up on crouched rear legs (a sitting dog) and stood 6 deg nose-up;
        # flat_orientation_l2 squares the tilt (10 deg cost 0.07/s). Spot's term is the tilt itself: 10 deg, 0.5/s
        self.rewards.flat_orientation_l2 = None
        self.rewards.base_orientation = RewTerm(func=spot_mdp.base_orientation_penalty, weight=-3.0,
                                                params={"asset_cfg": SceneEntityCfg("robot")})
        # 10 mm low costs 0.15/s (the actor can't sense its height: this shapes its average targets)
        self.rewards.base_height = RewTerm(func=mdp.base_height_l2, weight=-1500.0, params={"target_height": 0.1508})
        # both come in once it walks: from the start they kept it standing still (runs c1, d1 at 300-600 iterations).
        # The +-0.3 runs, at slip -1 and height -100, began walking between iterations 300 and 600 (24 env steps each)
        for term, start in (("foot_slip", -1.0), ("base_height", -100.0)):
            final = getattr(self.rewards, term).weight
            getattr(self.rewards, term).weight = start
            setattr(self.curriculum, term, CurrTerm(func=mdp.modify_reward_weight,
                                                    params={"term_name": term, "weight": final, "num_steps": 700 * 24}))


@configclass
class FoxBlindV7NaturalEnvCfg_PLAY(FoxBlindV7NaturalEnvCfg):
    def __post_init__(self):
        super().__post_init__()
        _blind_play(self)


WALK_OFFSETS = {"RL": 0.0, "FL": 0.25, "RR": 0.5, "FR": 0.75}   # lateral-sequence walk: each foot a quarter cycle later


def gait_phase(env, hz):
    """The walk's clock: (sin, cos) of 2 pi hz t, t = time since the episode began (deploy/fox_pi.py counts its steps)."""
    a = 2.0 * math.pi * torch.frac(hz * env.episode_length_buf.float() * env.step_dt)
    return torch.stack([torch.sin(a), torch.cos(a)], dim=1)


def _schedule(env, names, hz, swing):
    """Per foot: is it the walk's swing foot now (only while walking) and how far through its swing (0-1)."""
    off = torch.tensor([WALK_OFFSETS[n[:2]] for n in names], device=env.device)
    t = torch.frac(hz * env.episode_length_buf.float() * env.step_dt).unsqueeze(1)
    s = torch.remainder(t - off, 1.0) / swing
    moving = (torch.norm(env.command_manager.get_command("base_velocity")[:, :2], dim=1) > 0.0).unsqueeze(1)
    return (s < 1.0) & moving, s.clamp(max=1.0)


def walk_contact_reward(env, sensor_cfg, hz, swing):
    """+1 while the scheduled swing foot is off the ground, -1 for each other foot off it (at zero command: all down)."""
    cs = env.scene.sensors[sensor_cfg.name]
    up = cs.data.current_air_time.torch[:, sensor_cfg.body_ids] > 0
    sw, _ = _schedule(env, [cs.body_names[i] for i in sensor_cfg.body_ids], hz, swing)
    return (up & sw).float().sum(dim=1) - (up & ~sw).float().sum(dim=1)


def walk_swing_height_reward(env, asset_cfg, hz, swing, lift, std):
    """The swing foot follows a lift * sin(pi progress) arc above its standing height: exp(-err^2 / std^2)."""
    asset = env.scene[asset_cfg.name]
    names = [asset.body_names[i] for i in asset_cfg.body_ids]
    sw, s = _schedule(env, names, hz, swing)
    z0 = torch.tensor([FOOT_Z0[n[0]] for n in names], device=env.device)
    err = asset.data.body_pos_w.torch[:, asset_cfg.body_ids, 2] - z0 - lift * torch.sin(math.pi * s)
    return (torch.exp(-torch.square(err) / std ** 2) * sw).sum(dim=1)


@configclass
class FoxBlindV7WalkEnvCfg(FoxBlindV7NaturalEnvCfg):
    """-Natural with a walk instead of a trot, +-0.1 m/s. Trotting at home the rear pivot servos sat on their torque
    limit 40-48 % of the time at 0.1 m/s (mean 55-62 % of stall) even with the rear legs crouched 20 mm, which the policy
    did to unload them, walking 9 deg nose-up whatever the posture penalties. A walk keeps three feet down (each leg
    carries about a third less), and it is what animals use at these speeds.
    The policy gets the walk's clock (gait_phase, 1.5 Hz) and is rewarded for the schedule: one foot in the air at a
    time, rear left, front left, rear right, front right, a quarter cycle each (0.17 s swing, 0.5 s stance), on a 20 mm
    arc. Without a clock (air-time and one-foot-up terms only) every run stood still: imperfect steps cost more than
    standing, from scratch and from a trot."""

    def __post_init__(self):
        super().__post_init__()
        self.commands.base_velocity.ranges.lin_vel_x = (-0.1, 0.1)
        hz, swing = 1.5, 0.25
        self.observations.policy.gait_phase = ObsTerm(func=gait_phase, params={"hz": hz})
        self.observations.critic.gait_phase = ObsTerm(func=gait_phase, params={"hz": hz})
        self.rewards.gait = self.rewards.air_time = self.rewards.foot_lift = None
        self.rewards.walk_contact = RewTerm(func=walk_contact_reward, weight=2.0, params={
            "sensor_cfg": SceneEntityCfg("contact_forces", body_names=".*_foot"), "hz": hz, "swing": swing})
        self.rewards.walk_height = RewTerm(func=walk_swing_height_reward, weight=2.0, params={
            "asset_cfg": SceneEntityCfg("robot", body_names=".*_foot"), "hz": hz, "swing": swing, "lift": 0.02, "std": 0.01})


@configclass
class FoxBlindV7WalkEnvCfg_PLAY(FoxBlindV7WalkEnvCfg):
    def __post_init__(self):
        super().__post_init__()
        _blind_play(self)


@configclass
class FoxBlindPPORunnerCfg(FoxFlatPPORunnerCfg):
    max_iterations = 2000                    # the realistic servos take longer to learn
    experiment_name = "fox_flat_blind"
    obs_groups = {"actor": ["policy"], "critic": ["critic"]}


@configclass
class FoxBlindV7PPORunnerCfg(FoxBlindPPORunnerCfg):
    experiment_name = "fox_flat_blind_v7"


@configclass
class FoxBlindV7StraightPPORunnerCfg(FoxBlindPPORunnerCfg):
    experiment_name = "fox_flat_blind_v7_straight"


@configclass
class FoxBlindV7HomePPORunnerCfg(FoxBlindPPORunnerCfg):
    experiment_name = "fox_flat_blind_v7_home"


@configclass
class FoxBlindV7NaturalPPORunnerCfg(FoxBlindPPORunnerCfg):
    experiment_name = "fox_flat_blind_v7_natural"

    def __post_init__(self):
        super().__post_init__()
        self.algorithm.symmetry_cfg = RslRlSymmetryCfg(use_data_augmentation=True, data_augmentation_func=compute_symmetric_states)


@configclass
class FoxBlindV7WalkPPORunnerCfg(FoxBlindV7NaturalPPORunnerCfg):
    experiment_name = "fox_flat_blind_v7_walk"


for _id, _cfg, _agent in (("Fox-Velocity-Flat", "FoxFlatEnvCfg", "FoxFlatPPORunnerCfg"),
                          ("Fox-Velocity-Flat-Play", "FoxFlatEnvCfg_PLAY", "FoxFlatPPORunnerCfg"),
                          ("Fox-Velocity-Flat-Blind", "FoxBlindEnvCfg", "FoxBlindPPORunnerCfg"),
                          ("Fox-Velocity-Flat-Blind-Play", "FoxBlindEnvCfg_PLAY", "FoxBlindPPORunnerCfg"),
                          ("Fox-V7-Velocity-Flat-Blind", "FoxBlindV7EnvCfg", "FoxBlindV7PPORunnerCfg"),
                          ("Fox-V7-Velocity-Flat-Blind-Play", "FoxBlindV7EnvCfg_PLAY", "FoxBlindV7PPORunnerCfg"),
                          ("Fox-V7-Velocity-Flat-Blind-Straight", "FoxBlindV7StraightEnvCfg", "FoxBlindV7StraightPPORunnerCfg"),
                          ("Fox-V7-Velocity-Flat-Blind-Straight-Play", "FoxBlindV7StraightEnvCfg_PLAY", "FoxBlindV7StraightPPORunnerCfg"),
                          ("Fox-V7-Velocity-Flat-Blind-Home", "FoxBlindV7HomeEnvCfg", "FoxBlindV7HomePPORunnerCfg"),
                          ("Fox-V7-Velocity-Flat-Blind-Home-Play", "FoxBlindV7HomeEnvCfg_PLAY", "FoxBlindV7HomePPORunnerCfg"),
                          ("Fox-V7-Velocity-Flat-Blind-Natural", "FoxBlindV7NaturalEnvCfg", "FoxBlindV7NaturalPPORunnerCfg"),
                          ("Fox-V7-Velocity-Flat-Blind-Natural-Play", "FoxBlindV7NaturalEnvCfg_PLAY", "FoxBlindV7NaturalPPORunnerCfg"),
                          ("Fox-V7-Velocity-Flat-Blind-Walk", "FoxBlindV7WalkEnvCfg", "FoxBlindV7WalkPPORunnerCfg"),
                          ("Fox-V7-Velocity-Flat-Blind-Walk-Play", "FoxBlindV7WalkEnvCfg_PLAY", "FoxBlindV7WalkPPORunnerCfg")):
    if _id not in gym.registry:
        gym.register(id=_id, entry_point="isaaclab.envs:ManagerBasedRLEnv", disable_env_checker=True,
                     kwargs={"env_cfg_entry_point": f"{__name__}:{_cfg}", "rsl_rl_cfg_entry_point": f"{__name__}:{_agent}"})
