thiagopari/fox_rl_model/isaaclab/fox_play.py

"""Drive the trained Fox walking policy with the keyboard in Isaac Lab (Kit viewer).

    cd ~/Documents/fox_rl_model && ~/isaacenv/bin/python isaaclab/fox_play.py [--checkpoint path/to/model.pt]
Default: the hardware-ready policy (--task Fox-Velocity-Flat-Blind-Play, IMU-only observations). The first policy:
    --task Fox-Velocity-Flat-Play --checkpoint policies/fox_flat_v1/model_999.pt

Click into the viewport first (the window needs keyboard focus), then hold:
    W / S  or  Up / Down      forward / backward   (0.3 m/s)
    A / D  or  Left / Right   sideways             (0.2 m/s)
    Q / E  or  Z / X          turn left / right    (1 rad/s)
    L                         stop (zero command)
Keys add up while held. The camera follows robot 0; green/blue arrows show commanded vs actual velocity.
Check without a keyboard: add --eval --headless --num_envs 16 (scripted commands, prints achieved velocities).
Watch without a keyboard: add --demo (loops stand / forward 0.05, 0.1 / stop / backward 0.05, 0.1 m/s in the viewer). --on-stand holds the body
35 cm up with the legs free and starts from home (the CAD pose): what the robot does on its test stand. Commands stay inside the
task's training ranges, as on the robot (deploy/fox_pi.py).
Default checkpoint: the newest model_*.pt under logs/rsl_rl/<the task's experiment>. Also writes exported/policy.onnx next to it
(the file the Raspberry Pi would run) and exported/policy.json, how deploy/fox_pi.py turns its output into servo targets.
"""
import argparse
import glob
import json
import os
import sys

from isaaclab.app import AppLauncher

HERE = os.path.dirname(os.path.abspath(__file__))
parser = argparse.ArgumentParser(description="Keyboard teleop of the Fox walking policy.")
parser.add_argument("--task", default="Fox-Velocity-Flat-Blind-Play", help="a Fox-...-Play task (fox_tasks.py)")
parser.add_argument("--checkpoint", default=None, help="model_*.pt (default: newest for the task's experiment)")
parser.add_argument("--num_envs", type=int, default=1, help="robots in the scene (robot 0 is the one the camera follows)")
parser.add_argument("--eval", action="store_true", help="no keyboard: run scripted commands and print commanded vs achieved velocity")
parser.add_argument("--demo", action="store_true", help="no keyboard: loop stand / forward 0.05, 0.1 / stand / backward 0.05, 0.1")
parser.add_argument("--on-stand", action="store_true", help="the robot held in the air by its body (legs free), starting from home "
                    "(the CAD pose), as on a test stand")
AppLauncher.add_app_launcher_args(parser)
args = parser.parse_args()
if not args.headless and not args.visualizer:
    args.visualizer = ["kit"]                       # Isaac Lab 3.0 stays headless without a visualizer
if not args.kit_args:                               # small window: full screen on the 3200x2000 panel renders slowly
    args.kit_args = "--/app/window/width=1280 --/app/window/height=800"
simulation_app = AppLauncher(args).app

import gymnasium as gym  # noqa: E402
import numpy as np  # noqa: E402
import torch  # noqa: E402
from rsl_rl.runners import OnPolicyRunner  # noqa: E402

from isaaclab.devices import Se2Keyboard, Se2KeyboardCfg  # noqa: E402
import importlib.metadata as metadata  # noqa: E402

from isaaclab_rl.rsl_rl import RslRlVecEnvWrapper, handle_deprecated_rsl_rl_cfg  # noqa: E402
from isaaclab_tasks.utils import load_cfg_from_registry, parse_env_cfg  # noqa: E402

sys.path.insert(0, HERE)
import fox_tasks  # noqa: E402,F401  (registers the Fox tasks)

TASK = args.task


class FoxKeyboard(Se2Keyboard):
    """Isaac Lab's SE(2) keyboard (arrows, Z/X, L) plus W/A/S/D and Q/E."""

    def _create_key_bindings(self):
        super()._create_key_bindings()
        m = self._INPUT_KEY_MAPPING
        m.update({"W": m["UP"], "S": m["DOWN"], "A": m["LEFT"], "D": m["RIGHT"], "Q": m["Z"], "E": m["X"]})


def newest_checkpoint(experiment: str) -> str:
    runs = sorted(glob.glob(os.path.join(os.getcwd(), "logs", "rsl_rl", experiment, "*", "model_*.pt")), key=os.path.getmtime)
    if not runs:
        raise SystemExit("No checkpoint under logs/rsl_rl/%s - train first (isaaclab/fox_train.py) or pass --checkpoint" % experiment)
    return runs[-1]


def main():
    env_cfg = parse_env_cfg(TASK, device=args.device, num_envs=args.num_envs)
    cmd = env_cfg.commands.base_velocity
    cmd.resampling_time_range, cmd.rel_standing_envs, cmd.debug_vis = (1.0e9, 1.0e9), 0.0, True   # the keyboard owns it
    env_cfg.viewer.origin_type, env_cfg.viewer.asset_name = "asset_root", "robot"
    env_cfg.viewer.eye, env_cfg.viewer.lookat = (-0.55, -0.55, 0.35), (0.0, 0.0, 0.0)
    if args.on_stand:                                       # body held in the air, legs free, starting at home
        robot = env_cfg.scene.robot
        robot.spawn.articulation_props = robot.spawn.articulation_props.replace(fix_root_link=True)
        robot.articulation_root_prim_path = "/Geometry"     # fix_root_link moves the articulation root to the base's parent
        robot.init_state = robot.init_state.replace(pos=(0.0, 0.0, 0.35), joint_pos={".*": 0.0})
    agent_cfg = handle_deprecated_rsl_rl_cfg(load_cfg_from_registry(TASK, "rsl_rl_cfg_entry_point"), metadata.version("rsl-rl-lib"))
    env = RslRlVecEnvWrapper(gym.make(TASK, cfg=env_cfg), clip_actions=agent_cfg.clip_actions)
    path = args.checkpoint or newest_checkpoint(agent_cfg.experiment_name)
    runner = OnPolicyRunner(env, agent_cfg.to_dict(), log_dir=None, device=agent_cfg.device)
    runner.load(path)
    policy = runner.get_inference_policy(device=env.unwrapped.device)
    try:
        runner.export_policy_to_onnx(path=os.path.join(os.path.dirname(path), "exported"), filename="policy.onnx")
        export_contract(env, os.path.join(os.path.dirname(path), "exported", "policy.json"))
    except Exception as e:  # export is a convenience for the hardware step; driving does not need it
        print("[WARN] ONNX export skipped:", e)
    term = env.unwrapped.command_manager.get_term("base_velocity")
    if args.eval:
        return evaluate(env, policy, term)
    r = env_cfg.commands.base_velocity.ranges              # the robot's remote stays inside these too
    lo, hi = (torch.tensor([getattr(r, k)[i] for k in ("lin_vel_x", "lin_vel_y", "ang_vel_z")], device=env.unwrapped.device)
              for i in (0, 1))
    demo = [((0.0, 0.0, 0.0), 3.0), ((0.05, 0.0, 0.0), 3.0), ((0.1, 0.0, 0.0), 5.0), ((0.0, 0.0, 0.0), 3.0),   # the robot's
            ((-0.05, 0.0, 0.0), 3.0), ((-0.1, 0.0, 0.0), 3.0)]                                                 # W/S steps
    if args.demo:
        print("[INFO] %s with %s: looping %s" % (TASK, path, " / ".join("vx %+.2f for %.0f s" % (c[0], t) for c, t in demo)))
    else:
        keyboard = FoxKeyboard(Se2KeyboardCfg(v_x_sensitivity=0.3, v_y_sensitivity=0.2, omega_z_sensitivity=1.0, sim_device=env.unwrapped.device))
        print("[INFO] Driving %s with %s. Click the viewport, then W/A/S/D, Q/E (L = stop)." % (TASK, path))
    obs = env.get_observations()
    last, k, period = None, 0, sum(t for _, t in demo)
    while simulation_app.is_running():
        with torch.inference_mode():
            if args.demo:
                t, i = (k * env.unwrapped.step_dt) % period, 0
                while t >= demo[i][1]:
                    t -= demo[i][1]
                    i += 1
                command = torch.tensor(demo[i][0], device=env.unwrapped.device)
                k += 1
            else:
                command = keyboard.advance()
            command = torch.maximum(torch.minimum(command, hi), lo)
            term.vel_command_b[:] = command                 # read by the policy's velocity_commands observation
            obs, _, _, _ = env.step(policy(obs))
        now = tuple(np.round(command.cpu().numpy(), 2))
        if now != last:
            print("[INFO] command vx %.2f m/s  vy %.2f m/s  yaw %.2f rad/s" % now, flush=True)
            last = now
    env.close()


def export_contract(env, path):
    """policy.json (deploy/fox_pi.py policy_contract): the servo order, each servo's action scale and offset (rad from
    the CAD pose: servo target = offset + scale * output, clamped to target_limits_rad when the task clips), the gear
    ratio and the command ranges it was trained on, and a walk's clock frequency (gait_hz)."""
    u = env.unwrapped
    act = u.action_manager.get_term("joint_pos")
    row = lambda v: v[0].tolist() if torch.is_tensor(v) else [float(v)] * act.action_dim   # noqa: E731
    servo = {"hip": "hip", "thigh": "pivot", "calf": "gear"}
    r = u.cfg.commands.base_velocity.ranges
    c = {"task": TASK, "servos": ["%s_%s" % (j[:2], servo[j[3:-6]]) for j in act._joint_names],
         "scale": row(act._scale), "offset_rad": row(act._offset), "gear_ratio": float(u.cfg.scene.robot.actuators["servos"].gear_ratio),
         "command_ranges": {k: list(getattr(r, k)) for k in ("lin_vel_x", "lin_vel_y", "ang_vel_z")}}
    if act.cfg.clip is not None:                            # the targets' limits (rad from home), as the env clamps them
        c["target_limits_rad"] = act._clip[0].tolist()
    clock = getattr(u.cfg.observations.policy, "gait_phase", None)
    if clock is not None:                                   # the walk's clock (fox_tasks.gait_phase), last observation term
        c["gait_hz"] = float(clock.params["hz"])
    with open(path, "w") as f:
        json.dump(c, f, indent=1)
    print("[INFO] wrote %s: gears %g:1, commands %s" % (path, c["gear_ratio"], c["command_ranges"]))


def evaluate(env, policy, term):
    """Hold each command 4 s; report the mean achieved base velocity (body frame) over the last 2 s, all robots,
    plus smoothness: mean servo-command change per policy step (rad), mean foot swing (air) time at touchdown, and
    touchdowns per foot per second while commanded to stand (0 = stands still)."""
    u = env.unwrapped
    robot, obs, errs, total_falls = u.scene["robot"], env.get_observations(), [], 0
    cs = u.scene["contact_forces"]
    feet, _ = cs.find_bodies(".*_foot")
    steps, swings, taps = [], [], 0
    down = cs.data.current_contact_time.torch[:, feet] > 0
    act = u.action_manager.get_term("joint_pos")
    hip_a, hip_j = [i for i, n in enumerate(act._joint_names) if n.endswith("_hip_joint")], robot.find_joints(".*_hip_joint")[0]
    hip_target = hip_angle = 0.0
    t_lo = t_hi = None                                      # servo targets (rad from home) the policy sends
    stand_t, stand_z, pinned, n_t = [], [], 0, 0             # standing posture; targets sitting on the clamp
    r = u.cfg.commands.base_velocity.ranges                 # only what the task trains (a straight task: no turns)
    inside = lambda c: all(lo - 1e-6 <= v <= hi + 1e-6 for v, (lo, hi) in zip(c, (r.lin_vel_x, r.lin_vel_y, r.ang_vel_z)))  # noqa: E731
    for c in filter(inside, ((0.0, 0.0, 0.0), (0.2, 0.0, 0.0), (0.3, 0.0, 0.0), (-0.2, 0.0, 0.0), (0.0, 0.15, 0.0),
                             (0.0, 0.0, 0.8), (0.2, 0.0, 0.5))):
        acc, falls = [], 0
        for k in range(200):
            with torch.inference_mode():
                term.vel_command_b[:] = torch.tensor(c, device=env.unwrapped.device)
                obs, _, dones, _ = env.step(policy(obs))
            falls += int(dones.sum())
            now = cs.data.current_contact_time.torch[:, feet] > 0
            first, down = now & ~down, now   # touchdowns; compute_first_contact misses all of them 2-16 s into an episode
            if k >= 100 and any(c):          # (Isaac Lab 3.0-beta2: float32 sensor time vs a 1e-8 tolerance)
                steps.append(float(((u.action_manager.action - u.action_manager.prev_action) * act._scale).abs().mean()))  # rad
                swings += cs.data.last_air_time.torch[:, feet][first].tolist()
            if k >= 100 and not any(c):                      # standing still = no steps
                taps += int(first.sum())
            if k >= 100 and any(c) and not any(c[1:]):       # forward / backward: the hips should not move
                hip_target = max(hip_target, float(act.processed_actions[:, hip_a].abs().max()))
                hip_angle = max(hip_angle, float(robot.data.joint_pos.torch[:, hip_j].abs().max()))
            if k >= 100:
                t = act.processed_actions
                t_lo = t.min(0).values if t_lo is None else torch.minimum(t_lo, t.min(0).values)
                t_hi = t.max(0).values if t_hi is None else torch.maximum(t_hi, t.max(0).values)
                if act.cfg.clip is not None:
                    pinned += int(((t - act._clip[:, :, 0]).abs() < 1e-4).logical_or((t - act._clip[:, :, 1]).abs() < 1e-4).sum())
                n_t += t.numel()
                if not any(c):
                    stand_t.append((t - act._offset).abs().mean(0))
                    stand_z.append(float(robot.data.root_pos_w.torch[:, 2].mean()))
                acc.append(torch.cat([robot.data.root_lin_vel_b.torch[:, :2], robot.data.root_ang_vel_b.torch[:, 2:]], 1).mean(0))
        got = torch.stack(acc).mean(0).cpu().numpy()
        errs.append(np.abs(got - np.array(c)))
        total_falls += falls
        print("[EVAL] command vx %+.2f vy %+.2f yaw %+.2f  ->  achieved vx %+.3f vy %+.3f yaw %+.3f  (falls %d)" % (*c, *got, falls), flush=True)
    e = np.mean(errs, axis=0)
    print("[EVAL] SCORE mean |error|: vx %.3f m/s  vy %.3f m/s  yaw %.3f rad/s  | falls %d" % (*e, total_falls), flush=True)
    print("[EVAL] SMOOTH mean servo-command change %.4f rad/step | mean foot swing %.3f s (%d steps) | at zero command %.1f steps/foot/s"
          % (np.mean(steps), np.mean(swings) if swings else 0.0, len(swings), taps / (u.num_envs * len(feet) * 100 * u.step_dt)), flush=True)
    print("[EVAL] HIPS forward/backward: max hip target %.4f rad | max hip joint angle %.4f rad" % (hip_target, hip_angle), flush=True)
    servo = {"hip": "hip", "thigh": "pivot", "calf": "gear"}
    if stand_t:
        dev = np.degrees(torch.stack(stand_t).mean(0).cpu().numpy())
        print("[EVAL] STAND body height %.3f m (stance %.3f) | mean |target - stance| deg: %s" % (
            np.mean(stand_z), u.cfg.scene.robot.init_state.pos[2] - 0.008, ", ".join(
                "%s_%s %.0f" % (j[:2], servo[j[3:-6]], v) for j, v in zip(act._joint_names, dev) if not j.endswith("_hip_joint"))), flush=True)
    print("[EVAL] CLAMP targets sitting on a limit: %.1f %% of servo-steps" % (100.0 * pinned / max(n_t, 1)), flush=True)
    print("[EVAL] TARGETS servo deg from home (min / max, all commands): %s" % ", ".join(
        "%s_%s %+.0f/%+.0f" % (j[:2], servo[j[3:-6]], np.degrees(float(a)), np.degrees(float(b)))
        for j, a, b in zip(act._joint_names, t_lo, t_hi) if not j.endswith("_hip_joint")), flush=True)
    env.close()


if __name__ == "__main__":
    main()
    simulation_app.close()
