thiagopari/fox_rl_model/tools/build_robot.py

#!/usr/bin/env python3
"""Build the Fox quadruped RL package from the Fusion mechanism export in raw/.

raw/raw.json + raw/meshes/*.stl come from tools/fusion/FoxExportRaw run on 'Fox_Prototype_03_v6_RL_Mechanism'
(frame: x forward, y left, z up; origin between the hips; cm / kg in raw.json, metres in the STLs). Each leg is the real
mechanism: hip servo -> abduction; pivot servo -> femur; gear servo -> pinion -> gear with crank (N:1, N from the
exported motion link: v6 12:12 = 1, v7 12:24 = 2) -> Quad Link -> tibia. hip-crank-Quad Link-knee is a parallelogram (the tibia keeps the crank's angle); the foot hangs from a second
four-bar (Component77 front, Calf Link rear - a parallelogram on the rear legs). Outputs:
  mjcf/fox.xml (+ scene.xml)   exact mechanism: loops closed with <connect>, the gear pair with a joint equality,
                               position servos on the 12 servo joints (hip, pivot = femur, gear = pinion)
  mjcf/fox_reduced.xml         the same robot as a tree (base + per leg hip, thigh, calf, foot): the gear servo acts on
                               a fixed tendon (-thigh - calf), the foot follows the four-bar through a joint equality
  urdf/fox.urdf                that tree for Isaac (URDF cannot hold loops); foot joint as <mimic> of the calf joint
  mechanism.json               servo <-> joint map + four-bar fits + the level standing pose, used by isaaclab/fox_cfg.py
Servo map (all pitch angles about +y, zero = CAD pose):  thigh = pivot,  calf = -gear_servo / N - pivot,  foot = f(calf).
Stance: base level, soles at the front feet's CAD height (v7: the raised rear legs reach down), each foot fore-aft where
its worst pitch servo's static load is lowest (1:1 -> under the hip).
Usage:  ~/.venvs/fox_rl/bin/python tools/build_robot.py [--raw raw] [--out .]     (v7: --raw raw_v7 --out v7)
"""
import argparse, json, os, sys
import numpy as np
import trimesh
import fast_simplification

ROOT = os.path.dirname(os.path.dirname(os.path.abspath(__file__)))
RAW = os.path.join(ROOT, 'raw')
CM = 0.01
# DS-843MG at 6 V (servodatabase): 0.47 N m stall, 0.10 s/60 deg = 10.5 rad/s. The gear pair multiplies the gear
# servo's torque by N on the crank (reversed).
EFFORT, VELOCITY = 0.47, 10.5
ARMATURE, DAMPING, FRICTIONLOSS = 0.0005, 0.01, 0.002   # servo joints (estimates; reflected rotor inertia dominates)
PIN_ARMATURE, PIN_DAMPING = 1e-6, 1e-4                  # free pins of the linkages
KP, KV = 5.0, 0.08                                      # position-servo gains (N m / rad, N m s / rad): stall at ~5 deg error
VIS_FACES, VIS_DEFAULT = {'base': 60000}, 20000         # decimation targets for visual meshes
LEGS = ('FL', 'FR', 'RL', 'RR')
RGBA = {'base': (0.33, 0.42, 0.52, 1), 'hip': (0.12, 0.12, 0.13, 1), 'pinion': (0.3, 0.3, 0.32, 1), 'gear': (0.3, 0.3, 0.32, 1),
        'femur': (0.45, 0.68, 0.9, 1), 'quad': (0.85, 0.6, 0.3, 1), 'tibia': (0.62, 0.8, 0.95, 1), 'link': (0.85, 0.6, 0.3, 1),
        'foot': (0.2, 0.55, 0.35, 1), 'thigh': (0.45, 0.68, 0.9, 1), 'calf': (0.62, 0.8, 0.95, 1)}
REDUCED = {'hip': ('hip', 'pinion', 'gear'), 'thigh': ('femur', 'quad'), 'calf': ('tibia', 'link'), 'foot': ('foot',)}
REDUCED_JOINT = {'hip': 'hip_joint', 'thigh': 'femur_joint', 'calf': 'knee_joint', 'foot': 'ankle_joint'}
SERVOS = (('hip', 'hip_joint'), ('pivot', 'femur_joint'), ('gear', 'pinion_joint'))   # actuator name -> servo joint


def rgba(n):
    return RGBA['base'] if n == 'base' else RGBA[n.split('_')[1]]


def axis_of(j):
    """Rotation axis measured in Fusion, signed so abduction turns about ~+x (forward) and every pitch pin about +y."""
    a = np.array(j['axis_measured'] or j['primary'], dtype=float)
    a /= np.linalg.norm(a)
    return np.round(a if a[0 if j['name'].endswith('_hip_joint') else 1] > 0 else -a, 6)


def inertia_about_com(I_origin, com, m):
    """Fusion getXYZMomentsOfInertia (about world origin, [xx,yy,zz,xy,yz,xz], kg cm^2) -> about COM (fusion2urdf rule)."""
    x, y, z = com
    shift = [y * y + z * z, x * x + z * z, x * x + y * y, -x * y, -y * z, -x * z]
    xx, yy, zz, xy, yz, xz = [i - m * s for i, s in zip(I_origin, shift)]
    return np.array([[xx, xy, xz], [xy, yy, yz], [xz, yz, zz]]) * 1e-4  # kg m^2


def rot_y_angle(u, v):
    """Angle about +y that turns x-z vector u into v (x' = x cos + z sin, z' = -x sin + z cos)."""
    return np.arctan2(u[1] * v[0] - u[0] * v[1], u[0] * v[0] + u[1] * v[1])


MIN_TRANSMISSION = np.radians(10.0)   # linkage dead-point margin: the knee range stops where a loop's pins line up


def four_bar(K, C, A, Cp, q):
    """Foot angle relative to the tibia when the knee (tibia relative to femur, about +y) is at q, and the sine of the
    transmission angle at the foot pin (0 = dead point, where the loop can flip). Points are x-z coordinates at the
    zero pose: K knee, C femur-link pin, A ankle, Cp link-foot pin."""
    l1, l2 = np.linalg.norm(Cp - C), np.linalg.norm(Cp - A)
    out, mu, prev = [], [], Cp.copy()
    for qq in q:                                   # march outwards from 0 so the branch stays continuous
        c, s = np.cos(qq), np.sin(qq)
        a = K + np.array([[c, s], [-s, c]]) @ (A - K)
        d = np.linalg.norm(a - C)
        if d > l1 + l2 or d < abs(l1 - l2):
            out.append(np.nan)
            mu.append(0.0)
            continue
        t = (l1 ** 2 - l2 ** 2 + d ** 2) / (2 * d)
        h = np.sqrt(max(l1 ** 2 - t ** 2, 0.0))
        e = (a - C) / d
        sols = [C + t * e + h * np.array([-e[1], e[0]]), C + t * e - h * np.array([-e[1], e[0]])]
        prev = min(sols, key=lambda p: np.linalg.norm(p - prev))
        out.append(rot_y_angle(Cp - A, prev - a) - qq)
        u, w = prev - C, prev - a
        mu.append(abs(u[0] * w[1] - u[1] * w[0]) / (np.linalg.norm(u) * np.linalg.norm(w)))
    return np.array(out), np.array(mu)


def foot_fit(K, C, A, Cp, span=1.2):
    """Knee range around 0 where the foot four-bar stays clear of its dead point, and a quartic fit (MuJoCo's
    joint-equality polynomial) of the foot angle over that range."""
    side = []
    for sgn in (-1, 1):
        q = np.linspace(0, sgn * span, 241)
        f, mu = four_bar(K, C, A, Cp, q)
        n = next((i for i in range(len(q)) if not (np.isfinite(f[i]) and mu[i] >= np.sin(MIN_TRANSMISSION))), len(q))
        side.append((q[:n], f[:n]))
    q = np.concatenate([side[0][0][::-1], side[1][0][1:]])
    f = np.concatenate([side[0][1][::-1], side[1][1][1:]])
    coef = np.polynomial.polynomial.polyfit(q, f, 4)
    err = np.abs(np.polynomial.polynomial.polyval(q, coef) - f).max()
    return coef, float(err), [float(q.min()), float(q.max())]


def parallelogram_range(H, Q1, K):
    """Knee range keeping the crank (H->Q1) and femur (H->K) at least MIN_TRANSMISSION from lining up."""
    a = abs(rot_y_angle(Q1 - H, K - H))
    return [-(a - MIN_TRANSMISSION), np.pi - a - MIN_TRANSMISSION]


def gear_ratio(J):
    """N = pinion turns per crank-gear turn, from the exported motion links (older exports: 1:1)."""
    ns = []
    for leg in LEGS:
        ml = J[leg + '_pinion_joint']['motion_links'][0]
        if len(ml) < 5 or not ml[3] or not ml[4]:
            ns.append(1.0)
        else:
            ns.append(ml[3] / ml[4] if ml[0] == leg + '_pinion_joint' else ml[4] / ml[3])
    assert max(ns) - min(ns) < 1e-6, ns
    return float(ns[0])


MAX_FOOT_TILT = np.radians(30.0)   # sole tilt from its flat CAD pose (a tilted sole stands on an edge). v7 rear feet:
# 15 / 20 / 25 deg cap -> worst servo 66 / 55 / 43 %; uncapped it settles at 25.7 deg (41 %), so 30 is a sanity bound


def foot_collision_geom(m, leg):
    return next(i for i in range(m.ngeom) if m.geom_bodyid[i] == m.body(leg + '_foot').id and m.geom_contype[i])


def sole_edges(m, d, g):
    """The flat sole's two end edges (midpoints across its width) in geom g's frame, from a pose with the sole flat."""
    mid = m.geom_dataid[g]
    R = d.geom_xmat[g].reshape(3, 3)
    w = d.geom_xpos[g] + m.mesh_vert[m.mesh_vertadr[mid]:m.mesh_vertadr[mid] + m.mesh_vertnum[mid]] @ R.T
    flat = w[w[:, 2] < w[:, 2].min() + 0.0005]                  # the flat bottom: its lowest 0.5 mm
    out = []
    for end in (flat[flat[:, 0] < flat[:, 0].min() + 0.0005], flat[flat[:, 0] > flat[:, 0].max() - 0.0005]):
        c = end.mean(axis=0)
        c[2] = w[:, 2].min()
        out.append(R.T @ (c - d.geom_xpos[g]))
    return out


FLAT_SOLE = 0.0001   # m: a sole whose edges' heights differ by less stands flat (~0.4 deg), else on its lower edge


def sole_contact(d, g, edges):
    """Where a foot stands (world): its sole's lower edge, or the sole's centre while it is flat (FLAT_SOLE)."""
    a, b = (d.geom_xpos[g] + d.geom_xmat[g].reshape(3, 3) @ e for e in edges)
    return (a + b) / 2 if abs(a[2] - b[2]) < FLAT_SOLE else min(a, b, key=lambda p: p[2])


def level_stance(xml, legs, mech, n):
    """Standing pose of the reduced model: base level, every foot standing (sole_contact: on a sole edge, or on the
    whole sole while flat) at the front feet's CAD height with its sole tilted < MAX_FOOT_TILT, and placed fore-aft where
    the larger of its pitch servos' static loads (vertical force at the contact, through the servo map) is smallest.
    With 1:1 gears that is the foot under the hip; with N:1 the foot moves so the pivot servo takes a share of the load
    the geared servo no longer needs. Returns joint angles, the base origin height above the contacts and per leg the
    foot offset, tilt, contact and both servos' levers (m of torque per N of foot force)."""
    import mujoco
    from scipy.optimize import least_squares
    m = mujoco.MjModel.from_xml_path(xml)
    d = mujoco.MjData(m)
    jid = lambda n_: m.joint(n_).id                          # noqa: E731
    qadr = lambda n_: m.jnt_qposadr[jid(n_)]                 # noqa: E731
    dof = lambda n_: m.jnt_dofadr[jid(n_)]                   # noqa: E731
    P = np.polynomial.polynomial

    def set_leg(leg, th, ca):
        d.qpos[qadr(leg + '_thigh_joint')], d.qpos[qadr(leg + '_calf_joint')] = th, ca
        d.qpos[qadr(leg + '_foot_joint')] = P.polyval(ca, mech['legs'][leg]['foot_poly'])
        mujoco.mj_kinematics(m, d)
        mujoco.mj_comPos(m, d)

    sole, foot_geom = {}, {}
    for leg in legs:                                         # sole edges, in the foot geom's mesh frame (CAD pose: flat)
        g = foot_geom[leg] = foot_collision_geom(m, leg)
        set_leg(leg, 0.0, 0.0)
        sole[leg] = sole_edges(m, d, g)

    def at(leg, local):                                      # a point of the foot geom (its frame) in the world
        g = foot_geom[leg]
        return d.geom_xpos[g] + d.geom_xmat[g].reshape(3, 3) @ local

    def candidate(leg, k):                                   # where the foot may stand: heel edge, toe edge, whole sole
        return sole[leg][k] if k < 2 else (sole[leg][0] + sole[leg][1]) / 2

    def stands_on(leg, k):                                   # candidate k is where the foot really stands (sole_contact)
        za, zb = (at(leg, e)[2] for e in sole[leg])
        return abs(za - zb) < FLAT_SOLE if k == 2 else abs(za - zb) >= FLAT_SOLE and (za < zb) == (k == 0)

    def foot_tilt(leg, th, ca):                              # sole pitch from the CAD pose: all pitch axes are parallel
        return th + ca + P.polyval(ca, mech['legs'][leg]['foot_poly'])

    def levers(leg, p):                                      # pivot / gear servo torque per N of vertical force at p
        jp = np.zeros((3, m.nv))
        mujoco.mj_jac(m, d, jp, None, p, m.body(leg + '_foot').id)
        slope = P.polyval(d.qpos[qadr(leg + '_calf_joint')], P.polyder(mech['legs'][leg]['foot_poly']))
        t_th = jp[2, dof(leg + '_thigh_joint')]
        t_ca = jp[2, dof(leg + '_calf_joint')] + slope * jp[2, dof(leg + '_foot_joint')]
        return abs(t_th - t_ca), abs(t_ca) / n
    z_feet = np.mean([at(leg, candidate(leg, 2))[2] for leg in legs if leg[0] == 'F'])   # CAD pose: soles flat
    out, info = {}, {}
    for leg in legs:
        hx = d.xanchor[jid(leg + '_thigh_joint')][0]
        lo, hi = mech['legs'][leg]['knee_range_rad']

        def solve(dx, q0, k):                                # put candidate k at (hx + dx, z_feet)
            pt = candidate(leg, k)

            def err(q):
                set_leg(leg, *q)
                p = at(leg, pt)
                return [p[0] - hx - dx, p[2] - z_feet]
            r = least_squares(err, q0, xtol=1e-12, ftol=1e-12)
            set_leg(leg, *r.x)
            ok = (np.abs(r.fun).max() < 1e-6 and lo + 0.05 < r.x[1] < hi - 0.05 and abs(r.x[0]) < 1.15
                  and abs(foot_tilt(leg, *r.x)) < MAX_FOOT_TILT and stands_on(leg, k))
            return r.x, ok, max(levers(leg, at(leg, pt))), float(np.abs(r.fun).max())
        best = None                                          # (worst lever, dx, q, candidate)
        for k in range(3):                                   # each contact point is its own smooth problem
            for sgn in (1.0, -1.0):                          # walk the foot out from under the hip both ways
                q = np.zeros(2)
                for dx in sgn * np.arange(0.0, 0.0401, 0.001):
                    q1, ok, worst, res = solve(dx, q, k)
                    if not ok:                               # past a limit, or not standing there: skip, keep the start
                        continue
                    q = q1
                    if best is None or worst < best[0]:
                        best = (worst, dx, q.copy(), k)
        if best is None:
            raise ValueError('%s: no foot position within the knee range and MAX_FOOT_TILT (%.0f deg)' % (leg, np.degrees(MAX_FOOT_TILT)))
        k = best[3]
        for dx in best[1] + np.arange(-0.001, 0.00101, 0.0001):   # refine around the best millimetre
            q, ok, worst, res = solve(dx, best[2], k)
            if ok and worst < best[0]:
                best = (worst, dx, q.copy(), k)
        q, ok, worst, res = solve(best[1], best[2], k)
        th, ca = q
        out.update({leg + '_thigh_joint': float(th), leg + '_calf_joint': float(ca),
                    leg + '_foot_joint': float(P.polyval(ca, mech['legs'][leg]['foot_poly']))})
        lp, lg = levers(leg, at(leg, candidate(leg, k)))
        info[leg] = {'foot_ahead_of_hip_mm': round(1000 * best[1], 2), 'pivot_lever_mm': round(1000 * lp, 2),
                     'gear_lever_mm': round(1000 * lg, 2), 'foot_tilt_deg': round(float(np.degrees(foot_tilt(leg, th, ca))), 2),
                     'stands_on': ('heel edge', 'toe edge', 'whole sole')[k], 'residual_m': res}
    for leg in legs:
        set_leg(leg, out[leg + '_thigh_joint'], out[leg + '_calf_joint'])
    return out, float(d.xpos[m.body('base').id][2] - z_feet), info


def main():
    ap = argparse.ArgumentParser(description=__doc__, formatter_class=argparse.RawDescriptionHelpFormatter)
    ap.add_argument('--raw', default=RAW, help='FoxExportRaw output folder (raw.json + meshes/)')
    ap.add_argument('--out', default=ROOT, help='where meshes/, urdf/, mjcf/, mechanism.json, build_report.json go')
    a = ap.parse_args()
    raw_dir, out_dir = os.path.abspath(a.raw), os.path.abspath(a.out)
    raw = json.load(open(os.path.join(raw_dir, 'raw.json')))
    links, joints = raw['links'], raw['joints']
    J = {j['name']: j for j in joints}
    N = gear_ratio(J)
    parent, tree, loops = {'base': None}, [], []
    for j in joints:                                  # first joint that reaches a part is its tree joint; later ones close loops
        (loops if j['child'] in parent else tree).append(j)
        parent.setdefault(j['child'], j['parent'])
    assert set(parent) == set(links) and len(loops) == 2 * len(LEGS), (len(loops), set(links) - set(parent))
    tj = {j['child']: j for j in tree}
    frame = {n: (np.array(tj[n]['origin_cm']) * CM if n in tj else np.zeros(3)) for n in links}
    world = {n: np.array(j['origin_cm']) * CM for n, j in J.items()}
    for d in ('meshes/visual', 'meshes/collision', 'urdf', 'mjcf'):
        os.makedirs(os.path.join(out_dir, d), exist_ok=True)
    raw_mesh = {n: trimesh.load(os.path.join(raw_dir, 'meshes', L['stl']), force='mesh') for n, L in links.items()}
    report = {'links': {}, 'joints': {}, 'reduced': {}}

    def write_meshes(n, mesh, origin):              # visual (decimated) + collision (convex hull) in the link frame
        mesh = mesh.copy()
        mesh.apply_translation(-origin)
        tgt = VIS_FACES.get(n, VIS_DEFAULT)
        vis = mesh
        if len(mesh.faces) > tgt:
            v, f = fast_simplification.simplify(mesh.vertices, mesh.faces, 1.0 - tgt / len(mesh.faces))
            vis = trimesh.Trimesh(v, f, process=True)
        vis.export(os.path.join(out_dir, 'meshes', 'visual', n + '.stl'))
        mesh.convex_hull.export(os.path.join(out_dir, 'meshes', 'collision', n + '.stl'))
        return len(mesh.faces), len(vis.faces)

    def inertial(names, origin):                    # merged mass properties of parts, COM in the link frame
        m = sum(links[n]['mass_kg'] for n in names)
        com = sum(links[n]['mass_kg'] * np.array(links[n]['com_cm']) for n in names) / m
        I = inertia_about_com(np.sum([links[n]['inertia_origin_kgcm2'] for n in names], axis=0), com, m)
        ev = np.linalg.eigvalsh(I)
        valid = ev.min() > 0 and all(ev[i] + ev[j] >= ev[k] - 1e-12 for i, j, k in ((0, 1, 2), (0, 2, 1), (1, 2, 0)))
        return m, com * CM - origin, I, bool(valid)

    # ---------------- four-bar foot + servo map ----------------
    mech = {'servo_map': {'thigh': 'pivot', 'calf': '-gear / %g - pivot' % N, 'foot': 'f(calf)', 'gear_ratio': -1.0 / N,
                          'pinion_per_gear': N, 'note': 'pitch angles about +y from the CAD pose; gear: external mesh, '
                          'the crank turns -1/N of the gear servo'}, 'legs': {}}
    for leg in LEGS:
        P = {k: world[leg + n][[0, 2]] for k, n in (('K', '_knee_joint'), ('C', '_link_pin_joint'), ('A', '_ankle_joint'), ('Cp', '_foot_pin_joint'))}
        coef, err, rng = foot_fit(P['K'], P['C'], P['A'], P['Cp'])
        H, Q1, Q2, K = (world[leg + n][[0, 2]] for n in ('_femur_joint', '_crank_pin_joint', '_quad_pin_joint', '_knee_joint'))
        up = sorted(parallelogram_range(H, Q1, K))
        knee = [round(max(rng[0], up[0], -1.2), 4), round(min(rng[1], up[1], 1.2), 4)]   # also capped at the +-1.2 placeholder
        mech['legs'][leg] = {'foot_poly': coef.round(6).tolist(), 'foot_fit_err_rad': err, 'knee_range_rad': knee,
                             'foot_loop_range_rad': np.round(rng, 4).tolist(), 'upper_loop_range_rad': np.round(up, 4).tolist(),
                             'parallelogram_err_m': float(np.linalg.norm((Q1 - H) - (Q2 - K)) + np.linalg.norm((K - H) - (Q2 - Q1)))}

    # ---------------- exact mechanism MJCF ----------------
    inert = {}
    for n in links:
        full, vis = write_meshes(n, raw_mesh[n], frame[n])
        inert[n] = inertial([n], frame[n])
        report['links'][n] = {'mass_g': round(inert[n][0] * 1000, 2), 'com_link_m': np.round(inert[n][1], 5).tolist(),
                              'physically_valid': inert[n][3], 'mesh_faces_full': full, 'visual_faces': vis,
                              'mesh_z_min_world_m': float(raw_mesh[n].bounds[0][2])}
    feet_z = min(r['mesh_z_min_world_m'] for r in report['links'].values())
    kids = {}
    for j in tree:
        kids.setdefault(j['parent'], []).append(j)

    def body(n, indent, joint=None):
        m, c, I, _ = inert[n]
        sp = '  ' * indent
        pos = (0.0, 0.0, -feet_z + 0.002) if joint is None else frame[n] - frame[joint['parent']]
        out = ['%s<body name="%s" pos="%.6f %.6f %.6f">' % (sp, n, *pos)]
        if joint is None:
            out.append('%s  <freejoint name="root"/>' % sp)
        else:
            servo, leg = joint['lower'] is not None, joint['name'][:2]
            rng = ' range="%.4f %.4f"' % ((joint['lower'], joint['upper']) if servo else tuple(mech['legs'][leg]['knee_range_rad']))
            out.append('%s  <joint name="%s" axis="%g %g %g"%s/>' % (sp, joint['name'], *axis_of(joint),
                       rng if servo else ' class="pin"' + (rng if joint['name'].endswith('_knee_joint') else '')))
        out.append('%s  <inertial pos="%.6f %.6f %.6f" mass="%.6f" fullinertia="%.4e %.4e %.4e %.4e %.4e %.4e"/>' %
                   (sp, *c, m, I[0, 0], I[1, 1], I[2, 2], I[0, 1], I[0, 2], I[1, 2]))
        out.append('%s  <geom class="visual" mesh="%s_vis" rgba="%g %g %g %g"/>' % ((sp, n) + rgba(n)))
        out.append('%s  <geom class="collision" mesh="%s_col"/>' % (sp, n))
        if n == 'base':
            out.append('%s  <site name="imu" pos="0 0 0"/>' % sp)
        for cj in kids.get(n, []):
            out += body(cj['child'], indent + 1, cj)
        out.append('%s</body>' % sp)
        return out

    def header(name, names, stem=lambda n: n):
        X = ['<mujoco model="%s">' % name,
             '  <compiler angle="radian" meshdir="../meshes" autolimits="true"/>',
             '  <option timestep="0.002" integrator="implicitfast"/>',
             '  <default>',
             '    <joint armature="%g" damping="%g" frictionloss="%g"/>' % (ARMATURE, DAMPING, FRICTIONLOSS),
             '    <default class="pin"><joint armature="%g" damping="%g" frictionloss="0"/></default>' % (PIN_ARMATURE, PIN_DAMPING),
             '    <position kp="%g" kv="%g" forcerange="%g %g" inheritrange="1"/>' % (KP, KV, -EFFORT, EFFORT),
             # near-hard loops: with the default solimp (0.9) the 2-3 g linkage parts let the pins gap ~2 mm under load
             '    <equality solref="0.004 1" solimp="0.999 0.9999 0.0005 0.5 2"/>',
             '    <default class="visual"><geom type="mesh" contype="0" conaffinity="0" group="2" density="0"/></default>',
             '    <default class="collision"><geom type="mesh" contype="1" conaffinity="0" group="3" density="0" friction="1.0 0.02 0.01" condim="3"/></default>',
             '  </default>', '  <asset>']
        for n in names:
            X += ['    <mesh name="%s_vis" file="visual/%s.stl"/>' % (n, stem(n)), '    <mesh name="%s_col" file="collision/%s.stl"/>' % (n, stem(n))]
        return X + ['  </asset>', '  <worldbody>']
    sensors = ['  <sensor>', '    <framequat name="imu_quat" objtype="site" objname="imu"/>',
               '    <gyro name="imu_gyro" site="imu"/>', '    <accelerometer name="imu_acc" site="imu"/>', '  </sensor>', '</mujoco>']
    X = header('fox', links) + body('base', 2) + ['  </worldbody>', '  <equality>']
    for j in loops:                                   # anchor in the parent part's frame (both coincide at qpos0)
        a = world[j['name']] - frame[j['parent']]
        X.append('    <connect name="%s" body1="%s" body2="%s" anchor="%.6f %.6f %.6f"/>' % (j['name'].replace('_joint', ''), j['parent'], j['child'], *a))
    for leg in LEGS:
        ml = J[leg + '_pinion_joint'].get('motion_links') or J[leg + '_gear_joint'].get('motion_links')
        assert ml and ml[0][2], 'gear motion link missing or not reversed: %s' % ml
        X.append('    <joint name="%s_gear_mesh" joint1="%s_gear_joint" joint2="%s_pinion_joint" polycoef="0 %.8g 0 0 0"/>' % (leg, leg, leg, -1.0 / N))
    X += ['  </equality>', '  <actuator>']
    X += ['    <position name="%s_%s" joint="%s_%s"/>' % (leg, a, leg, sj) for leg in LEGS for a, sj in SERVOS]
    X += ['  </actuator>'] + sensors
    open(os.path.join(out_dir, 'mjcf', 'fox.xml'), 'w').write('\n'.join(X) + '\n')
    open(os.path.join(out_dir, 'mjcf', 'scene.xml'), 'w').write(SCENE % 'fox.xml')
    for j in joints:
        report['joints'][j['name']] = {'parent': j['parent'], 'child': j['child'], 'origin_world_m': np.round(world[j['name']], 5).tolist(),
                                       'axis': axis_of(j).tolist(), 'servo': j['lower'] is not None, 'closes_loop': j in loops,
                                       'limits_rad': [j['lower'], j['upper']] if j['lower'] is not None else None}

    # ---------------- reduced tree: URDF + MJCF ----------------
    red = ['base'] + ['%s_%s' % (leg, k) for leg in LEGS for k in REDUCED]
    parts = {'base': ['base'], **{'%s_%s' % (leg, k): ['%s_%s' % (leg, p) for p in v] for leg in LEGS for k, v in REDUCED.items()}}
    rjoint = {'%s_%s' % (leg, k): J[leg + '_' + REDUCED_JOINT[k]] for leg in LEGS for k in REDUCED}
    rframe = {n: (world[rjoint[n]['name']] if n in rjoint else np.zeros(3)) for n in red}
    rparent = {n: ('base' if n.endswith('_hip') else n[:3] + {'thigh': 'hip', 'calf': 'thigh', 'foot': 'calf'}[n[3:]]) for n in red if n != 'base'}
    rin, stem = {}, (lambda n: n if n == 'base' else n + '_reduced')   # own files: XX_hip/XX_foot exist in the exact model too
    for n in red:
        if n != 'base':
            write_meshes(stem(n), trimesh.util.concatenate([raw_mesh[p] for p in parts[n]]), rframe[n])
        rin[n] = inertial(parts[n], rframe[n])
        report['reduced'][n] = {'parts': parts[n], 'mass_g': round(rin[n][0] * 1000, 2), 'physically_valid': rin[n][3]}
    rlim = {'hip': (J['FL_hip_joint']['lower'], J['FL_hip_joint']['upper']), 'thigh': (J['FL_femur_joint']['lower'], J['FL_femur_joint']['upper']),
            'foot': (-np.pi, np.pi)}   # calf (knee): per leg, from the linkage dead points (mechanism.json knee_range_rad)

    def origin(xyz):
        return '<origin xyz="%.6f %.6f %.6f" rpy="0 0 0"/>' % tuple(xyz)
    U = ['<?xml version="1.0"?>', '<robot name="fox">']
    for n in red:
        m, c, I, _ = rin[n]
        U += ['  <link name="%s">' % n, '    <inertial>', '      ' + origin(c), '      <mass value="%.6f"/>' % m,
              '      <inertia ixx="%.4e" ixy="%.4e" ixz="%.4e" iyy="%.4e" iyz="%.4e" izz="%.4e"/>' % (I[0, 0], I[0, 1], I[0, 2], I[1, 1], I[1, 2], I[2, 2]),
              '    </inertial>',
              '    <visual>', '      ' + origin((0, 0, 0)), '      <geometry><mesh filename="../meshes/visual/%s.stl"/></geometry>' % stem(n),
              '      <material name="%s_mat"><color rgba="%g %g %g %g"/></material>' % ((n,) + rgba(n)), '    </visual>',
              '    <collision>', '      ' + origin((0, 0, 0)), '      <geometry><mesh filename="../meshes/collision/%s.stl"/></geometry>' % stem(n), '    </collision>',
              '  </link>']
    for n in red[1:]:
        k, leg = n[3:], n[:2]
        lo, hi = mech['legs'][leg]['knee_range_rad'] if k == 'calf' else rlim[k]
        U += ['  <joint name="%s_joint" type="revolute">' % n, '    ' + origin(rframe[n] - rframe[rparent[n]]),
              '    <parent link="%s"/>' % rparent[n], '    <child link="%s"/>' % n, '    <axis xyz="%g %g %g"/>' % tuple(axis_of(rjoint[n])),
              # thigh torque = pivot - N gear servo torques, calf = -N gear (up to (1+N) / N x stall); PhysX clips at these
              '    <limit lower="%.4f" upper="%.4f" effort="%.3f" velocity="%.2f"/>' % (lo, hi, {'thigh': (1 + N) * EFFORT, 'calf': N * EFFORT, 'foot': 10.0}.get(k, EFFORT),
                                                                                       VELOCITY if k != 'foot' else 50.0),
              # damping/friction 0 on purpose: Isaac's URDF importer writes URDF damping into the per-degree USD field;
              # joint damping/armature belong in the actuator config (isaaclab/fox_cfg.py) and the MJCF defaults.
              '    <dynamics damping="0" friction="0"/>']
        if k == 'foot':   # linear part of the four-bar (exact for the rear parallelogram); fox_cfg.py can apply the full fit
            U.append('    <mimic joint="%s_calf_joint" multiplier="%.6f" offset="0"/>' % (leg, mech['legs'][leg]['foot_poly'][1]))
        U.append('  </joint>')
    U.append('</robot>')
    open(os.path.join(out_dir, 'urdf', 'fox.urdf'), 'w').write('\n'.join(U) + '\n')
    rkids = {}
    for n in red[1:]:
        rkids.setdefault(rparent[n], []).append(n)

    def rbody(n, indent):
        m, c, I, _ = rin[n]
        sp = '  ' * indent
        pos = (0.0, 0.0, -feet_z + 0.002) if n == 'base' else rframe[n] - rframe[rparent[n]]
        out = ['%s<body name="%s" pos="%.6f %.6f %.6f">' % (sp, n, *pos)]
        if n == 'base':
            out.append('%s  <freejoint name="root"/>' % sp)
        else:
            k = n[3:]
            lim = tuple(mech['legs'][n[:2]]['knee_range_rad']) if k == 'calf' else rlim.get(k)
            out.append('%s  <joint name="%s_joint" axis="%g %g %g"%s/>' % (sp, n, *axis_of(rjoint[n]),
                       ' class="pin"' if k == 'foot' else ' range="%.4f %.4f"' % lim))
        out.append('%s  <inertial pos="%.6f %.6f %.6f" mass="%.6f" fullinertia="%.4e %.4e %.4e %.4e %.4e %.4e"/>' %
                   (sp, *c, m, I[0, 0], I[1, 1], I[2, 2], I[0, 1], I[0, 2], I[1, 2]))
        out.append('%s  <geom class="visual" mesh="%s_vis" rgba="%g %g %g %g"/>' % ((sp, n) + rgba(n)))
        out.append('%s  <geom class="collision" mesh="%s_col"/>' % (sp, n))
        if n == 'base':
            out.append('%s  <site name="imu" pos="0 0 0"/>' % sp)
        for cn in rkids.get(n, []):
            out += rbody(cn, indent + 1)
        out.append('%s</body>' % sp)
        return out
    R = header('fox_reduced', red, stem) + rbody('base', 2) + ['  </worldbody>', '  <tendon>']
    R += ['    <fixed name="%s_gear_servo"><joint joint="%s_thigh_joint" coef="%g"/><joint joint="%s_calf_joint" coef="%g"/></fixed>' % (l, l, -N, l, -N) for l in LEGS]
    R += ['  </tendon>', '  <equality>']
    R += ['    <joint name="%s_four_bar" joint1="%s_foot_joint" joint2="%s_calf_joint" polycoef="%s"/>' % (l, l, l, ' '.join('%.6g' % c for c in mech['legs'][l]['foot_poly'])) for l in LEGS]
    R += ['  </equality>', '  <actuator>']
    for l in LEGS:
        R += ['    <position name="%s_hip" joint="%s_hip_joint"/>' % (l, l), '    <position name="%s_pivot" joint="%s_thigh_joint"/>' % (l, l),
              '    <position name="%s_gear" tendon="%s_gear_servo" inheritrange="0" ctrlrange="%.4f %.4f"/>' % (l, l, J[l + '_pinion_joint']['lower'], J[l + '_pinion_joint']['upper'])]
    R += ['  </actuator>'] + sensors
    open(os.path.join(out_dir, 'mjcf', 'fox_reduced.xml'), 'w').write('\n'.join(R) + '\n')
    open(os.path.join(out_dir, 'mjcf', 'scene_reduced.xml'), 'w').write(SCENE % 'fox_reduced.xml')
    stance, height, info = level_stance(os.path.join(out_dir, 'mjcf', 'fox_reduced.xml'), LEGS, mech, N)
    mech['stance'] = {'joints_rad': {k: round(v, 6) for k, v in stance.items()}, 'base_height_m': round(height, 5),
                      'servo_deg_from_cad': {'%s_%s' % (l, s_): round(float(np.degrees(v)), 2) for l in LEGS for s_, v in
                                             (('hip', 0.0), ('pivot', stance[l + '_thigh_joint']),
                                              ('gear', -N * (stance[l + '_thigh_joint'] + stance[l + '_calf_joint'])))},
                      'legs': info, 'note': 'base level, soles at the front feet CAD height, feet where the worst pitch servo '
                      'load is lowest (levers: servo N m per N of vertical foot force)'}
    json.dump(mech, open(os.path.join(out_dir, 'mechanism.json'), 'w'), indent=1)
    report['standing_height_base_origin_m'] = -feet_z + 0.002
    report['total_mass_g'] = round(sum(l['mass_kg'] for l in links.values()) * 1000, 1)
    report['mechanism'] = mech
    json.dump(report, open(os.path.join(out_dir, 'build_report.json'), 'w'), indent=1)
    bad = [n for n, r in report['links'].items() if not r['physically_valid']] + [n for n, r in report['reduced'].items() if not r['physically_valid']]
    print('parts %d  joints %d (tree %d, loops %d)  reduced links %d  mass %.1f g  base height %.4f m  invalid inertias %s'
          % (len(links), len(joints), len(tree), len(loops), len(red), report['total_mass_g'], report['standing_height_base_origin_m'], bad))
    print('  gear servo -> crank %g:1 | level stance: base %.4f m above the soles, servo deg from CAD %s'
          % (N, height, mech['stance']['servo_deg_from_cad']))
    for leg, v in info.items():
        print('    %s foot %+.1f mm ahead of the hip: levers pivot %.1f mm, gear %.1f mm (residual %.0e m)'
              % (leg, v['foot_ahead_of_hip_mm'], v['pivot_lever_mm'], v['gear_lever_mm'], v['residual_m']))
    for leg, v in mech['legs'].items():
        print('  %s foot = f(calf): poly %s  fit err %.1e rad | knee range %s (foot loop %s, upper loop %s) | parallelogram err %.1e m'
              % (leg, np.round(v['foot_poly'], 4).tolist(), v['foot_fit_err_rad'], v['knee_range_rad'], v['foot_loop_range_rad'],
                 v['upper_loop_range_rad'], v['parallelogram_err_m']))
    return 0 if not bad else 1


SCENE = '''<mujoco model="fox scene">
  <include file="%s"/>
  <visual><headlight diffuse="0.6 0.6 0.6" ambient="0.3 0.3 0.3"/><global azimuth="135" elevation="-20" offwidth="1280" offheight="960"/></visual>
  <asset><texture type="2d" name="grid" builtin="checker" rgb1="0.25 0.3 0.35" rgb2="0.2 0.22 0.25" width="300" height="300"/>
    <material name="grid" texture="grid" texrepeat="8 8" reflectance="0.1"/></asset>
  <worldbody><light pos="0 0 1.5" dir="0 0 -1" directional="true"/>
    <geom name="floor" size="0 0 0.05" type="plane" material="grid" contype="0" conaffinity="1" friction="1.0 0.02 0.01"/></worldbody>
</mujoco>
'''

if __name__ == '__main__':
    sys.exit(main())
