thiagopari/fox_rl_model/tools/validate_mujoco.py

#!/usr/bin/env python3
"""Validate the exact Fox mechanism MJCF in MuJoCo: structure, foot contact at the zero pose, 4 s standing test with the
12 servos holding the stance, linkage loops and gear pair staying closed, renders. FOX_MODEL=v7 checks another model
folder; if its mechanism.json has a level stance away from the CAD pose (v7: raised rear hips), the servos ramp to it
first and the feet are checked there."""
import json, os, sys
os.environ.setdefault('MUJOCO_GL', 'egl')
import numpy as np
import mujoco

ROOT = os.path.abspath(os.environ.get('FOX_MODEL', os.path.dirname(os.path.dirname(os.path.abspath(__file__)))))
m = mujoco.MjModel.from_xml_path(os.path.join(ROOT, 'mjcf', 'scene.xml'))
d = mujoco.MjData(m)
stance = json.load(open(os.path.join(ROOT, 'mechanism.json'))).get('stance', {}).get('servo_deg_from_cad', {})
u_stance = np.zeros(m.nu)
for k, v in stance.items():
    u_stance[m.actuator(k).id] = np.radians(v)
use_stance = np.abs(u_stance).max() > np.radians(1.0)
rep = {'nq': m.nq, 'nv': m.nv, 'nu': m.nu, 'njnt': m.njnt, 'nbody': m.nbody,
       'total_mass_kg': float(m.body_subtreemass[1]),
       'joints': [mujoco.mj_id2name(m, mujoco.mjtObj.mjOBJ_JOINT, i) for i in range(m.njnt)]}
ok = {'structure (free base + 32 hinges, 12 servos, 8 loop pins + 4 gear meshes)': m.nq == 39 and m.nv == 38 and m.nu == 12
      and m.neq == 12 and sorted(m.eq_type.tolist()) == [int(mujoco.mjtEq.mjEQ_CONNECT)] * 8 + [int(mujoco.mjtEq.mjEQ_JOINT)] * 4}


def closure():   # worst loop-pin gap (m) and worst gear-mesh error (rad) right now
    gap = gear = 0.0
    for i in range(m.neq):
        if m.eq_type[i] == int(mujoco.mjtEq.mjEQ_CONNECT):
            b1, b2 = m.eq_obj1id[i], m.eq_obj2id[i]
            p1 = d.xpos[b1] + d.xmat[b1].reshape(3, 3) @ m.eq_data[i, 0:3]
            p2 = d.xpos[b2] + d.xmat[b2].reshape(3, 3) @ m.eq_data[i, 3:6]
            gap = max(gap, float(np.linalg.norm(p1 - p2)))
        else:
            j1, j2 = m.eq_obj1id[i], m.eq_obj2id[i]                     # q1 = polycoef(q2)
            q2 = float(d.qpos[m.jnt_qposadr[j2]])
            gear = max(gear, abs(float(d.qpos[m.jnt_qposadr[j1]]) - sum(c * q2 ** n for n, c in enumerate(m.eq_data[i, :5]))))
    return gap, gear
mujoco.mj_forward(m, d)


def foot_heights():   # lowest collision point of each foot
    feet = {}
    for g in range(m.ngeom):
        b = mujoco.mj_id2name(m, mujoco.mjtObj.mjOBJ_BODY, m.geom_bodyid[g])
        if b and b.endswith('_foot') and m.geom_group[g] == 3:
            mid = m.geom_dataid[g]
            v = m.mesh_vert[m.mesh_vertadr[mid]:m.mesh_vertadr[mid] + m.mesh_vertnum[mid]]
            w = (d.geom_xmat[g].reshape(3, 3) @ v.T).T + d.geom_xpos[g]
            feet[b] = float(w[:, 2].min())
    return feet
feet = foot_heights()
rep['foot_heights_at_zero_pose_m'] = feet
if not use_stance:   # the CAD pose is the stance: all feet touch there
    ok['all four feet within 5 mm of the floor'] = max(feet.values()) - min(feet.values()) < 0.005 and min(feet.values()) > -0.001
# standing test: hold the zero pose with the position servos for 4 s
z0 = float(d.qpos[2])
trace, worst_gap, worst_gear = [], 0.0, 0.0
for k in range(int(4.0 / m.opt.timestep)):
    d.ctrl[:] = u_stance * min(1.0, d.time / 0.5)                     # ramp to the stance (zero when it is the CAD pose)
    mujoco.mj_step(m, d)
    g1, g2 = closure()
    worst_gap, worst_gear = max(worst_gap, g1), max(worst_gear, g2)
    if k % 100 == 0:
        up = d.xmat[1].reshape(3, 3)[:, 2]
        trace.append([round(d.time, 2), round(float(d.qpos[2]), 4), round(float(up[2]), 4)])
up = d.xmat[1].reshape(3, 3)[:, 2]
rep['standing'] = {'base_z_start_m': z0, 'base_z_end_m': float(d.qpos[2]), 'upright_cos': float(up[2]),
                   'max_servo_err_rad': float(np.abs(d.actuator_length).max()), 'contacts_end': int(d.ncon),
                   'max_loop_pin_gap_m': worst_gap, 'max_gear_mesh_err_rad': worst_gear,
                   'finite': bool(np.isfinite(d.qpos).all()), 'trace': trace[::5]}
ok['stands for 4 s (upright, <15 mm sag, finite)'] = rep['standing']['finite'] and up[2] > 0.98 and z0 - d.qpos[2] < 0.015
if use_stance:       # the stance (feet under the hips, rear legs reaching down) must put every foot on the floor
    rep['foot_heights_at_stance_m'] = feet = foot_heights()
    ok['all four feet on the floor at the stance (within 3 mm)'] = max(feet.values()) < 0.003 and min(feet.values()) > -0.002
    ok['stance is level (upright > 0.999)'] = up[2] > 0.999
ok['servo torque stays within 0.47 N m'] = bool(np.abs(d.actuator_force).max() <= 0.4701)
rep['servo_torque_end_pct_of_stall'] = {mujoco.mj_id2name(m, mujoco.mjtObj.mjOBJ_ACTUATOR, i): round(100 * abs(float(d.actuator_force[i])) / 0.47, 1)
                                        for i in range(m.nu)}
ok['linkage loops stay closed (< 0.5 mm) and gears meshed (< 0.01 rad)'] = worst_gap < 5e-4 and worst_gear < 0.01
rep['actuator_force_end_Nm'] = np.round(d.actuator_force, 4).tolist()
# renders
try:
    r = mujoco.Renderer(m, 720, 960)
    cam = mujoco.MjvCamera()
    cam.lookat[:] = d.qpos[:3]
    cam.distance, cam.elevation = 0.55, -18
    for az, name in ((135, 'mujoco_front_left.png'), (-45, 'mujoco_rear_right.png')):
        cam.azimuth = az
        r.update_scene(d, cam)
        import PIL.Image as Image  # noqa
        Image.fromarray(r.render()).save(os.path.join(ROOT, 'validation', name))
    rep['renders'] = True
except Exception as e:
    rep['renders'] = 'failed: %s' % e
rep['checks'] = ok = {k: bool(v) for k, v in ok.items()}
os.makedirs(os.path.join(ROOT, 'validation'), exist_ok=True)
json.dump(rep, open(os.path.join(ROOT, 'validation', 'mujoco_report.json'), 'w'), indent=1)
for k, v in ok.items():
    print('%-50s %s' % (k, 'PASS' if v else 'FAIL'))
print('mass %.4f kg | base z %.4f -> %.4f | upright %.4f | feet %s' % (rep['total_mass_kg'], z0, d.qpos[2], up[2], {k: round(v, 4) for k, v in feet.items()}))
sys.exit(0 if all(ok.values()) else 1)
