thiagopari/fox_rl_model/(commit log)

2026-10-06 Checkpoint: screw-consistent link model (Fusion Fox_Prototype_03_v6_RL_URDF_v2)
    Links follow the fastener graph (tools/screw_graph.py -> analysis/link_map.json):
    hip brackets, caps and servo splines move with the joint they are screwed to;
    abduction axes are the real tilted hip-servo spline axes. URDF/MJCF/USD rebuilt,
    MuJoCo + Isaac Sim checks pass. Knee still a direct joint (gear servo not modelled).
    [FL_calf.stl, FL_hip.stl, FL_thigh.stl, FR_calf.stl, FR_hip.stl, FR_thigh.stl, RL_calf.stl, RL_hip.stl]
2026-10-06 Model the real leg mechanism: 3 servos, 1:1 gear, parallelogram, foot four-bar
    Fusion Fox_Prototype_03_v6_RL_Mechanism: 33 parts, 40 joints (hip / pivot / gear servo +
    7 pins per leg, two closing loops), 4 pinion->gear motion links (12:12, reversed); saved
    only after drive tests (gear = -pinion, shin || crank, Quad Link || femur, rear foot || femur).
    MJCF fox.xml is the exact mechanism with 12 servo actuators; fox_reduced.xml and the URDF
    are the tree with the servo map thigh = pivot, knee = -gear - pivot (foot = four-bar /
    <mimic>). Knee limited at the loops' dead points. Isaac Lab FoxServoActuator takes servo
    targets. MuJoCo + Isaac Sim checks pass; reduced tree matches the exact model to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
    [FL_calf.stl, FL_calf_reduced.stl, FL_femur.stl, FL_foot.stl, FL_foot_reduced.stl, FL_gear.stl, FL_hip.stl, FL_hip_reduced.stl]
2026-10-06 Isaac Lab: fox_sim.py launches the robots with servo motions (Isaac Lab 3.0.0-beta2)
    Kit viewer (--viz kit) or headless; small PhysX GPU buffers and a 1280x800 window for the
    8 GB laptop GPU; renders every 4th physics step. FoxServoActuator verified under Isaac Lab.
2026-10-06 RL walking policy with keyboard teleop (Isaac Lab 3.0)
    fox_tasks.py: Fox-Velocity-Flat task (Go1 velocity recipe re-scaled: servo-target actions,
    +-0.3/0.2 m/s and 1 rad/s commands, fall penalty + alive bonus, 10x smaller joint-acc
    penalty, init noise 0.5). fox_train.py runs Isaac Lab's rsl_rl PPO (1000 it, 13 min);
    fox_play.py drives it with W/A/S/D + Q/E (or --eval). Policy v1 tracks 0.2/0.3/-0.2 m/s,
    0.15 m/s sideways and 0.8 rad/s turns with no falls; ONNX export in policies/fox_flat_v1.
    Servo gains kp 5 / kd 0.08 everywhere (kp 2 let randomized robots tip over). USD bodies
    flattened so Isaac Lab's contact sensor sees the feet.
    [fox.xml, fox_reduced.xml]
2026-10-06 Hardware-ready blind policy: IMU-only observations, stands still, slower servo-friendly trot
    Fox-Velocity-Flat-Blind: actor sees gyro, gravity, command and its own last
    servo commands (5-step history); privileged critic. Spot air_time_reward
    (0.15 s phases, all feet down at zero command, velocity threshold 1.0 m/s)
    replaces feet_air_time, which Isaac Lab 3.0-beta2 silences 2-16 s into each
    episode (float32 sensor time vs a 1e-8 tolerance in compute_first_contact).
    fox_play --eval counts touchdowns from contact-state changes and reports
    servo-command smoothness, swing time and stepping at zero command.
    Policies: fox_flat_blind_v1 (7 Hz trot, drifts 8 cm/s standing) and
    fox_flat_blind_v2 (0.10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
    [env.yaml, fox_play.py, fox_tasks.py]
2026-10-06 Realistic servos for the blind task; policy v3 trained on them; Pi interface check
    FOX_SERVO_REAL_CFG: 5-25 ms command latency (DelayBuffer), per-servo backlash
    (free play, up to 0.02/0.02/0.04 rad hip/pivot/gear), DC-motor torque-speed line
    (stall 0.47 N m at rest, 0 at 10.5 rad/s), all drawn per episode; servo gains
    +-20/30 % via randomize_actuator_gains. Yaw term weight 1.0, std 0.3.
    fox_flat_blind_v3 on realistic servos: error vx/vy/yaw 0.008/0.006/0.025
    (v2 on the same servos: 0.016/0.010/0.042), servo-command change 0.042 rad/step,
    0.132 s swings, stands still, 0 falls.
    tools/check_policy_io.py rebuilds the 105-float observation from raw signals
    (= Isaac Lab's) and runs policy.onnx aga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
    [check_policy_io.py, env.yaml, fox_cfg.py, fox_tasks.py, test_fox_actuator.py]
2026-10-06 Pi runtime for the blind policy, verified closed loop in Isaac Lab
    deploy/fox_pi.py runs policy.onnx on the robot: BNO055 + PCA9685 over Blinka
    (the stack of ~/robofox_leg_imu_calibration.py), 50 Hz, keyboard over SSH,
    limp on Ctrl-C or when tilted past 60 deg, --dry-run without hardware.
    Calibration modes: --check-imu (IMU_TO_BODY), --wiggle (CHANNEL, DIRECTION),
    plus the CAD stance angles for NEUTRAL_DEG. FoxPolicy is the observation /
    output contract; tools/check_policy_io.py now drives the sim with it:
    observation = Isaac Lab's, ONNX = PyTorch (2.4e-7), output order = servo
    joints, walks 0.18 m/s (cmd 0.2) and turns 0.62 rad/s (cmd 0.6). The check
    caught FoxPolicy storing views of reused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
2026-10-06 Servo numbering from the robot: 1 = gear (shin), 2 = pivot (femur), 3 = hip
    fox_pi.py's channel guess now puts the gear servo first in each leg's block
    (the January script's gear1/gear2 pair is servos 1 and 2); still to be
    checked with --wiggle. README names the servos by their numbers.
2026-10-06 Policy v4: hips held at the stance for forward/backward/standing
    fox_mdp.FoxServoAction zeroes the hip servo targets when a command has no
    sideways or turn part, and the policy observes the actions as sent
    (last_action of the joint_pos term); fox_mdp.FoxVelocityCommand makes 30 % of
    training commands straight. fox_mdp.py is named by string (ResolvableString):
    subclassing the action/command terms imports USD, which crashed fox_train.py
    (free(): invalid pointer) when loaded before the simulator.
    deploy/fox_pi.py applies the same hip rule. check_policy_io.py starts on its
    first command (consistent gating from step 0) and checks walking as a sanity
    bound; v4: observation identical, ONNX = PyTorc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
    [check_policy_io.py, env.yaml, fox_mdp.py, fox_pi.py, fox_play.py, fox_tasks.py]
2026-10-06 fox_pi.py: retry I2C read errors, BNO055 in IMUPLUS mode; README Pi setup checklist
    The BNO055's clock stretching makes the Pi's I2C fail now and then (OSError);
    read() now returns None so read_retry() tries again, as the January script's
    try/except did. IMUPLUS (gyro + accelerometer) keeps the servo motors' fields
    out of the orientation. Checked with a fake upside-down IMU that fails twice:
    gravity (0, 0, -1), left turn +z. README: OS, I2C, Python env, servo power,
    copy, smoke test, gyro units, bus speed; status: not yet run on hardware.
    [fox_pi.py]
2026-10-06 print/FL_gear.stl: the FL gear, print-ready
    From raw/meshes/FL_gear.stl (CAD body Spur Gear (15 teeth):2, Fusion Medium
    mesh): metres -> mm, gear axis vertical, the crank-arm face (378 mm2) on the
    bed, gear centre at the origin; rotation only, so the FL part keeps its
    handedness. Checked: watertight, 12 teeth, tip diameter 21.08 mm, flank facets
    <= 0.61 mm (~0.016 mm off the involute).
    [FL_gear.stl]
2026-10-07 fox_pi.py: pause 20 ms between IMU read retries (up to 0.5 s)
    On the Pi, the BNO055 returned gravity (0, 0, 0) for ~0.1 s after switching
    to IMUPLUS mode, and the 10 back-to-back retries gave up within milliseconds.
2026-10-07 fox_pi.py: IMU_TO_BODY verified on the robot with --check-imu
    Nose down -> gravity x +0.99, left side down -> y +1.00, counter-clockwise
    quarter turn -> gyro z integrates to +93 deg; gyro reads rad/s.
2026-10-07 fox_pi.py --wiggle: drive only the named servo, +/- amplitude in degrees
    The other 11 servos get no pulses: their 90 deg centres are uncalibrated and
    must not be commanded yet. Sequence: centre, +A, centre, -A, centre (x2),
    1 s each, then limp. --amplitude defaults to 10 deg.
2026-10-07 fox_pi.py --set SERVO=DEG: one servo straight to an angle, hold 2 s, limp
    For probing a joint whose 90 deg centre is past a mechanical stop (RL hip):
    no detour through the centre.
2026-10-07 deploy/fox_calib.py: interactive servo calibration; fox_pi.py loads servo_calib.json
    Over SSH: select any of the 12 servos, move it (arrows +/-1, A/D +/-5 deg,
    g = exact angle), record home (h), safe range (< >), direction (r) and
    channel (#); every change is saved to servo_calib.json beside fox_pi.py,
    which overrides the guessed CHANNEL / NEUTRAL_DEG / DIRECTION / LIMIT_DEG at
    import. All servos limp at start and on quit; a servo's first move goes to its
    saved home. Tested with scripted keys on fake hardware and in a pty.
2026-10-07 fox_pi.py: clamp servo commands to 0-180 deg as well as LIMIT_DEG
    A calibrated home of 35 deg (FR_gear) gave a default range down to -15 deg;
    adafruit_motor raises ValueError below 0, which would stop the walk loop.
2026-10-07 fox_pi.py: rear legs have the pivot servo on the first channel, gear second
    Per Thiago's check on the robot: RL pivot = ch 0, RL gear = ch 1, RR pivot =
    ch 3, RR gear = ch 4 (front legs unchanged: gear, pivot). The Pi's
    servo_calib.json was swapped to match, each saved home staying with its
    physical servo (backup servo_calib.json.bak).
    [fox_pi.py]
2026-10-07 fox_calib.py: refuse to save over a servo_calib.json changed by someone else
    A session started before an outside edit (the rear channel swap) saved its
    stale copy and undid that edit. Each save now checks the file's mtime against
    the session's own last load/save and, if it differs, says NOT SAVED and asks to
    restart. Tested: outside edit kept, stale toggle refused.
    [fox_calib.py]
2026-10-07 fox_pi.py --stand SECONDS: all servos to home without the policy, print body tilt
    First on-the-ground check of the calibration: do the homes give a level stance
    and can the servos hold the weight, before the policy runs.
2026-10-07 IMU mount tilt correction: fox_pi.py --level-imu, applied to every reading
    Standing level at home, the IMU read ~15 deg nose-down / 4.6 deg roll: the
    board sits tilted. --level-imu SECONDS holds the stance, averages the gravity
    direction (mount frame) and saves it as imu_level_gravity in servo_calib.json;
    Robot then applies the rotation taking it onto (0, 0, -1) (pitch/roll only).
    fox_calib.py now keeps keys it doesn't edit. Tested: correction maps the level
    reading to (0, 0, -1), proper rotation, loaded and applied in Robot.read,
    preserved by fox_calib saves.
    [fox_calib.py, fox_pi.py]
2026-10-07 fox_pi.py: --check-imu and --level-imu use the IMU only (class Imu)
    They constructed Robot, which resets the PCA9685 and limps every servo on
    exit: run while fox_calib.py holds the robot at home, that dropped it.
    Robot now extends Imu with the servo board.
    [fox_pi.py]
2026-10-07 fox_pi.py --seconds N: timed policy run that ends at home, servos holding
    On the ground a run that ended limp dropped the robot onto its belly. A run
    that reaches its time now commands home and leaves the PCA9685 pulsing;
    Ctrl-C, the 60 deg tilt cutoff and errors still go limp.
    [fox_pi.py]
2026-10-07 fox_pi.py: tilt stop needs 3 readings, IMU mode written only when needed, --log CSV
    The first on-the-ground policy run stopped after 1.4 s on a false 'tilted
    over': a second process (an IMU logger) had rewritten the BNO055 mode, whose
    fusion restart gave bad readings (the servos were unpowered: dead battery).
    Now: one bad reading can't stop a run (3 consecutive needed, 60 ms), Imu only
    sets IMUPLUS if it isn't set, and --log writes time, IMU, command and servo
    targets per step so no second process is needed. Tested both tilt cases.
2026-10-08 fox_pi.py --balance: keep the attitude captured at start within +-tol deg
    No policy: the legs go to the stance (plus per-leg height trims), the IMU
    attitude averaged over the first --capture s (10; the robot held steady the way
    it should stay) becomes the target, then pitch / roll errors beyond --tol (1
    deg) are integrated into leg length changes (front vs rear, left vs right,
    1 mm per deg per s) and turned into pivot / gear targets by 2-link IK on the
    CAD leg geometry. The front legs are nearly straight at the stance (2.2 mm
    reach), so the common height is lowered instead. Ends limp on Ctrl-C / a fall,
    holds its last pose after --seconds. Tested: IK round trip 1e-14 mm; on a fake
    robot stan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
    [fox_pi.py]
2026-10-08 fox_pi.py: define HEIGHT_TRIM_MM before load_calib() runs
    load_calib() runs at import; with a servo_calib.json present it referenced
    HEIGHT_TRIM_MM before its definition (NameError in every mode on the Pi).
    My tests had no calibration file; now tested with the Pi's real one in all
    modes.
2026-10-08 fox_pi.py: stand pose (servo_calib.json stand_deg) as the base of --stand / --balance
    The robot's good standing pose, in servo degrees, separate from the homes
    (the CAD stance the policy needs). Leg length changes and reach are now
    computed from that base pose (leg_ik / leg_reach take pivot0, gear0).
    Tested with the Pi's calibration: --stand reproduces the saved pose exactly,
    IK round trip 4e-14 mm from it, balance levels a fake robot from 5.9 deg roll.
2026-10-08 fox_calib.py: P = all servos to the stand pose, S = save holding servos as the stand pose; calib_last.json
    A stance tuned by hand was lost: h saves homes (must stay the CAD stance for
    the policy), nothing saved stand_deg, and quitting limps the board. Now P /
    S edit the stand pose that --stand / --balance use, the table shows it, and
    every move rewrites calib_last.json with all current angles, so the latest
    positions survive a dead battery or a crash. Tested with the Pi's calibration.
    [fox_calib.py]
2026-10-08 deploy/fox_balance_feb.py: the February balance controller on today's robot
    Port of ~/robofox_balance_controller_v3.py (2026-02-02): same Euler remap,
    PID per axis (1.0 / 0.1 / 0.5), dead zones 0.5 / 1.0 deg, +-25 deg output,
    50 Hz, same per-leg pendulum motion (first channel +c, second -c) and leg
    mapping. Changed: centres = today's homes (servo_calib.json), target captured
    over the first --capture s instead of the fixed Feb targets (absorbs the
    re-mounted IMU's tilt), rear hips held at home, fall cutoff. Tested: remap and
    leg commands equal February's formulas with today's centres; dry run.
    [fox_balance_feb.py]
2026-10-08 v7 design: 2:1 gear-servo drive, rear hips +18.8 mm on a spacer, min-load level stance
    Fusion (new documents, sources untouched):
    * Fox_Prototype_03_v7_RL from tools/fusion/FoxMakeV7: 12T pinion -> 24T crank gear (m1.0, 20 deg,
    shift +0.3/-0.3, 18 mm centres, 0.2 mm backlash; outlines from tools/gear_profile.py), rear module
    20 mm up the rear pelvis screws onto a printed spacer, rear hip brackets un-fused, rear pinions
    phased; 28 checks (tooth overlap 0, exact lift, no new interference, spacer seated).
    * Fox_Prototype_03_v7_RL_Mechanism: 40 joints, motion links 2:1; drive tests gear = -pinion/2.
    Pipeline: scan/build/export add-ins take optional configs (tools/fusion/v7/), screw_graph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
    [FL_calf_reduced.stl, FL_femur.stl, FL_foot.stl, FL_foot_reduced.stl, FL_gear.stl, FL_hip.stl, FL_hip_reduced.stl, FL_link.stl]
2026-10-08 v7 design v2: crank gear turns only with its pinion (623ZZ seat, femur hub relief)
    The gear rides on a 623ZZ (the "disk"), inner ring clamped to the femur hub. The hub's 6 mm end face reached past
    the inner ring onto the shield/outer ring, and the gear's 10.2 mm seat was loose on the 10 mm outer ring, so the
    femur could drag the gear. tools/fusion/FoxV7FreeGear (saved as version 2 of Fox_Prototype_03_v7_RL): 4.4 mm boss +
    0.3 mm relief on all 4 femur hubs, 10.0 mm press-fit seat in both gear bodies (all 4 legs), bearings renamed
    623ZZ. Checks: exact volume changes, gears seated without overlap, gears >= 0.7 mm from the femurs. New print
    STLs for the gear and the 4 femurs; tools/fusion/run_ad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
    [v7_crank_gear_24T.stl, v7_femur_FL.stl, v7_femur_FR.stl, v7_femur_RL.stl, v7_femur_RR.stl]
2026-10-08 v7 print files with Thiago's servo-horn interfaces: 12T pinion and femurs
    * v7_pinion_12T.stl: his v6 pinion's horn interface (4 hooks + cross-horn pocket below a 0.3 mm plate, from
    "Gear modified (1).stl", kept exactly) under the new 12T m1.0 teeth, with his Ø2 hole / Ø6.4 counterbore.
    * v7_femur_front_1/_2, v7_femur_back (+ _mirrored): his modified femurs (horn pocket at the hip) with only the
    v7 bearing relief added on the hip hub (sections identical to his files below it). Replaces the CAD-based
    v7_femur_{FL,FR,RL,RR} files, which still had the spline socket.
    [v7_femur_FL.stl, v7_femur_FR.stl, v7_femur_RL.stl, v7_femur_RR.stl, v7_femur_back.stl, v7_femur_back_mirrored.stl, v7_femur_front_1.stl, v7_femur_front_2.stl]
2026-10-08 v7 print files: M4 clearance holes (Ø4.6) in the middle casing and the rear hip spacer
    * v7_middle_casing.stl: the Pi casing from the v7 export (watertight shell, = CAD volume) with its 4 pelvis
    screw holes opened from Ø2.8 to Ø4.6 along each tilted screw axis, over the casing tab only (ISO M4 medium
    clearance 4.5 + 0.1 for FDM). Checks: exactly the enlargement removed, >= 1 mm wall around every hole,
    measured Ø4.60. Pi deck on the bed.
    * v7_rear_hip_spacer.stl: both through holes Ø3.2 -> Ø4.6.
    Screw stacks: front 13.5 mm (M4x16), rear 33.2 mm with the spacer (M4x35 into the pelvis, or M4x40 + nut).
    [v7_middle_casing.stl, v7_rear_hip_spacer.stl]
2026-10-08 v7 print files for printed bearings: running-fit gear + 10x3x4 bushing
    * v7_crank_gear_24T_printed_bushing.stl: the 24T gear with a Ø10.4 running-fit seat (vs the Ø10.0 press fit for a
    623ZZ) and its inner lip lowered 0.3 mm, so the horn screw clamps only the bushing to the femur and never the gear.
    * v7_bushing_10x3x4.stl: printed stand-in for the 623ZZ, Ø3 x Ø10 x 4 mm, 0.3 mm chamfers.
    README: the two build options, and the spacer trade-off (without it the worst servo is 40 % of stall vs 34 %).
    [v7_bushing_10x3x4.stl, v7_crank_gear_24T_printed_bushing.stl]
2026-10-08 v7 sim model without the rear hip spacer
    The robot will be built without the spacer (no longer screws), so v7/ now models v6 geometry with the v7 drive:
    tools/raw_v7_without_spacer.py makes raw_v7_nospacer/ from the v6 export (base, legs, all joints) plus the v7
    gear and pinion links moved back to their v6 positions (mass/inertia moved with them), the 2:1 motion links
    and the v7 pinion range; build_robot.py --raw raw_v7_nospacer --out v7.
    Stance: front feet 25.5 mm ahead of the hips, rear 34.1 mm behind; worst servo 40 % of stall (trot estimate,
    34 % with the spacer, 72 % v6); standing in MuJoCo 11 %. All MuJoCo checks pass. The spacer build's Fusion
    evidence moved to v7/validation/cad/.
    Co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
    [FL_calf_reduced.stl, FL_femur.stl, FL_foot.stl, FL_foot_reduced.stl, FL_gear.stl, FL_hip.stl, FL_hip_reduced.stl, FL_link.stl]
2026-10-08 v7b: as-built CAD + jointed mechanism (no spacer, 2:1 gears, printed bushing, M4 casing holes)
    FoxMakeV7 reads make.json (name, lift, spacer, bushing, M4 holes); tools/fusion/v7b/ builds
    Fox_Prototype_03_v7b_RL (43 checks OK) and Fox_Prototype_03_v7b_RL_Mechanism (40 joints + 4 motion
    links 2:1, drive tests OK). run_addin.sh: the idle guard parsed '(uint64 N,)' with tr -dc, keeping
    the 64, so it passed after ~1 s of idle; now parsed with sed.
2026-10-08 deploy/fox_leg_modes.py: one leg's pendulum and extension per the servo-role model, to test on RR
    Pendulum a: middle -a, pinion +ratio*a (knee angle fixed); extension dh: fox_pi.leg_ik with the ratio
    (ankle straight down); single-servo moves with the other holding, to compare. Only that leg's 3 servos
    get pulses; ramped moves; out-of-range moves refused; --ratio required; asserts the model at start.
    [fox_leg_modes.py]
2026-10-08 FOX_SERVO_REAL_CFG: gear servo backlash 0.04 -> 0.15 rad, measured on RR
    deploy/fox_leg_modes.py on the robot (1:1 gears): the gear servo turned 10-15 deg before the shin
    moved (~+-6 deg of free play in the gear pair, horn and linkage pins). tools/test_fox_actuator.py passes.
    [fox_cfg.py]
2026-10-09 v7 stance at the foot's real contact; v7 USD for Isaac Lab
    level_stance placed the sole's CAD centre on the ground, but a tilted sole stands on its lower edge,
    ~7 mm away (the rear foot follows the femur, so it tilts with the rear pivot servo). Now each foot is
    solved for three fixed contact points (heel edge, toe edge, whole sole when flat) and a solution
    counts only where that point is really the lowest. servo_load.py applies the force there too.
    v7 stance: front +22.0 mm (heel edge, 6.0 deg), rear -35.1 mm (toe edge, 25.7 deg); worst servo
    41 % (was reported 40 %, really 48 %). MAX_FOOT_TILT caps the tilt (15/20/25 deg -> 66/55/43 %),
    left at 30 deg. No feasible position now raises instea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
    [build_robot.py, servo_load.py]
2026-10-09 Fox-V7-Velocity-Flat-Blind-Straight + policy.json contract between training and the Pi
    Task: v7, forward / backward only (vy = yaw = 0), so the hips always hold the stance; every v7 task
    scales the gear servos' actions 0.25 x ratio (0.5 rad at 2:1).
    fox_play.py writes exported/policy.json: servo order, per-servo scale and offset (the v7 stance is the
    zero action), gear ratio, command ranges. fox_pi.py reads it (no file: the v1-v4 contract): targets =
    offset + scale x output, a per-servo safety clamp, end-of-run hold at the stance, keyboard kept in the
    command ranges, and it refuses a policy whose gear ratio differs from servo_calib.json's gear_ratio
    (fox_calib.py --gear-ratio N). gear_ratio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
2026-10-09 v7: scale the gear servo's reflected inertia with the ratio (fixes 100 Hz chatter)
    FoxServoActuator's damping reaches the crank N^2 times larger at N:1, but the joint armature stayed at
    one servo's 0.0005 kg m^2, so the explicit damping outran the 200 Hz integration: standing still, the
    2:1 gear servo flipped stall torque on 25 % of steps, and the first Fox-V7-Velocity-Flat-Blind-Straight
    run blew up at iteration 1100 (std < 0). fox_cfg.geared() gives the v7 servos the diagonal of the
    reflected inertia (thigh (1 + N^2) I, calf N^2 I): 2.3 % flips, like v6's 0.2 %. v6 is unchanged.
    tools/check_servo_chatter.py is the regression check.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
    [check_servo_chatter.py, fox_cfg.py, fox_tasks.py]
2026-10-09 fox_v7_straight_v1: the 2:1 robot's forward / backward policy, with servo limits and a held stance
    Fox-V7-Velocity-Flat-Blind-Straight now clamps servo targets where the robot can follow (hips +-0.5 rad,
    pivots +-50 deg, gear servos +-90 deg from home) and holds the stance (Spot's joint position penalty,
    5x when told to stand). Without them the policy commanded rear gear servos to -106 deg (past their
    travel) and stood 33 mm crouched with them parked on the clamp. Eval (16 robots, realistic servos):
    0.2 -> 0.175, 0.3 -> 0.247, -0.2 -> -0.219 m/s, 0 falls; stands at 0.143 m (stance 0.151), targets
    2-15 deg from the stance, 0.0 % on a clamp; shuffles in place at zero command (2.4 steps/s, 6 mm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
2026-10-10 deploy/fox_home.py: set leg homes by swinging the leg or extending its knee, then saving both servos
    Instead of driving single servos (fox_calib.py), each leg moves as a leg: swing a (pivot -a, gear +N a:
    the knee angle kept) or knee k (femur and shin each k/2 toward each other, sign flipped front / rear:
    the leg's direction kept). Both are fixed servo ratios, so they behave the same whatever the current
    calibration. h saves the leg's pivot and gear angles as their homes (read-modify-write of
    servo_calib.json, other entries kept). Asserts the two motions at start.
2026-10-10 fox_home.py: knee = the pivot servo alone (as p / P in fox_leg_modes.py)
    Thiago: the swing worked, the knee motion did not. Its gear servo half (N k/2) was lost in the gear path's
    10-15 deg of play; the pivot servo alone drives the femur directly (the shin keeps its angle), which is
    what worked on the robot. e / d now move only the pivot servo, +-k, sign flipped front / rear.
2026-10-10 fox_play.py --on-stand: the robot held in the air by its body, legs free, starting from home (the CAD pose)
    What deploy/fox_pi.py does on the test stand, in Isaac Lab (fix_root_link; the articulation root is then
    /Geometry, the base's parent). v7/validation/on_stand_servos.png: fox_v7_straight_v1 on the stand snaps
    from home into its hold within ~0.1 s, holds with 1-6 deg wiggles at zero command, and cycles the legs
    at ~4.5 Hz (forward 0.2) / ~4.9 Hz (backward 0.2).
2026-10-10 fox_pi.py: check at start that the policy's stance and training ranges fit each servo's 0-180 travel
    On the stand RR's leg barely moved walking forward: its gear servo sat at 0.0-2.3 deg, pinned at the end of
    its travel, because its new home (60) leaves only 60 deg below home and the policy commands down to -60 and
    trains to -90. Now fox_pi.py refuses a policy whose stance a servo can't reach and warns about training
    ranges past 0 / 180 (those targets get clamped). tools/test_fox_pi.py covers both cases.
2026-10-10 fox_pi.py: IMU glitch filter, soft start, W/S in 0.05 m/s steps
    The stand log (2026-10-09) had single BNO055 readings of 35.6 rad/s (full scale) and of exactly (0, 0,
    +9.81) in its frame (its fusion's default after a reset) amid level ones, 4 in 600 at 0.3 m/s; three in
    a row at start-up (12 servos snapping) explain an immediate 'tilted over' stop. Imu.filter holds the
    last good reading for a reading past 15 rad/s or a 30 deg gravity jump, at most twice in a row (a real
    fall still shows in 60 ms), and the run reports the count. walk() waits for 10 steady readings, ramps
    home -> stance over 1 s instead of jumping, and waits again. W/S step 0.05 m/s (sim: 0.05 / 0.1 / 0.15
    -> 0.038 / 0.093 / 0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
2026-10-10 FoxServoActuatorCfg: backlash_min and stiction knobs (defaults 0: behaviour unchanged)
    Per-episode free play is drawn in [backlash_min, backlash]; stiction (N m, drawn in [0, max]) is torque a
    servo spends before its output moves. Used to test the first ground run (2026-10-09) in the sim: play
    pivot 0.03-0.06 / gear 0.09-0.13 rad with stiction up to 0.12 N m, or a 0.18-0.25 N m stall, slow the
    policy but keep its steps; the robot's tiny commands came from its IMU reading 8.8 deg nose-up.
2026-10-10 Fox-V7-Velocity-Flat-Blind-Home: forward / backward around home (the CAD pose)
    Thiago (2026-10-10): on the robot home stands steadier than the load-optimal v7 stance, whose start did
    not hold under the weight. The task resets at home, its servo targets' zero is home (offset 0, so the
    Pi's start ramp is a no-op) and the stance penalty pulls toward home; limits, servos and rewards as in
    -Straight. Chatter check PASS (0.1 % sign flips).
2026-10-10 fox_v7_home_v1: the 2:1 robot's forward / backward policy around home (the CAD pose)
    Fox-V7-Velocity-Flat-Blind-Home, 2000 iterations. Eval (16 robots, realistic servos): 0.2 -> 0.203,
    0.3 -> 0.247, -0.2 -> -0.218 m/s, 0 falls, 0.0 % on a clamp; stands within 3-5 deg of home on the pivots
    (body 0.140 m, home 0.152). From a dead-still level IMU (where the first ground run got stuck) it steps
    at once: 0.05 m/s -> pivots 15-20 deg, gears 25-59 deg peak to peak, mean posture within +-4 deg of home.
    check_policy_io PASS (targets exact, +0.209 / -0.203 m/s). On the Pi in ~/fox/v7_home; dry run there
    with Thiago's calibration: 150 steps, 0 over budget.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
2026-10-10 Fox-V7-Velocity-Flat-Blind-Natural + left-right symmetry + gait quality tools
    Thiago: the fox_v7_home_v1 walk looks awful. tools/gait_report.py measures why: 5 steps/s with 0.1 s
    swings, feet lifted 5-8 mm and sliding 130-180 mm/s while planted, shuffling 3 steps/s at zero command,
    front shins 9-13 deg apart left vs right, the body 19 mm low. -Natural (on -Home): air-time phases 0.25 s,
    a per-foot lift reward (standing height + 25 mm, Spot's clearance kernel), Spot's foot-slip and joint-
    velocity penalties, a stronger trot term, base height at home, tighter speed tracking; the runner trains
    on each batch and its left-right mirror (isaaclab/fox_symmetry.py: FL<->FR, RL<->RR, hips negated, y
    f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
2026-10-10 fox_home.py: e / d extend the leg at a constant angle (2 / 10 mm along the hip-ankle line)
    Thiago: E / D did not extend the leg as much as wanted, and the leg should keep its angle (the direction from
    the crank gear's axis to the foot). e / d now use the leg IK (fox_pi.leg_ik, new radial option: the ankle
    moves along the line from the hip) with both servos, 2 mm per press (E / D 10 mm), refused past the reach
    that keeps 15 deg of knee bend. At home the front legs are ~97 % straight (2 mm of reach), the rear ones
    ~30 mm. The start-up check asserts the angle stays and the length changes by exactly r.
2026-10-10 fox_home.py: 5 / 15 mm extension steps, gear-servo play compensation, extension clamped to the reach
    Thiago: e / d barely moved anything. A 2 mm press was ~1.3 deg of pivot and ~2.5 deg of gear, and the gear
    part vanished in the gear path's 10-15 deg of play. Now e / d step 5 mm (E / D 15 mm); when a gear servo
    reverses it is commanded half the play (--gear-play, default 12 deg total) extra in the new direction, so
    the shin moves at once; shown and saved angles stay the play's centre (the sim's target). A step past the
    reach goes as far as the leg can (front legs: their last ~2 mm at home).
2026-10-10 fox_home.py: extension as a swing, then the pivot alone (the gear servo can't turn its gear against the femur); ramped moves
2026-10-10 Natural-gait iteration: level-body trot terms, slip / height curriculum, walk task with a gait clock (experiment)
    -Natural: +-0.15 m/s, coarse (0.15) + fine (0.05) speed tracking, Spot's base_orientation_penalty
    (-3; flat_orientation_l2 made 10 deg cost 0.07/s), slip -5 and height -1500 brought in at iteration 700
    (from the start they kept every run standing still). Best policy so far: run f1, fine-tuned a -> e2 -> f1
    (orientation -10, height target 0.135): a clean trot, 2.2-2.5 steps/foot/s, planted-foot slip 29-38 mm/s,
    stands level and still, walks 6-7 deg nose-up, forward 55 % of the command, backward 75-84 %.
    Why not better: trotting at home the rear pivot servos sit on their torque lim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
2026-10-12 vio: synthetic MuJoCo camera + IMU dataset (EuRoC), monocular VO baseline scored with evo
2026-10-12 vio: degradation sweep (time offset, extrinsics, foot-strike vibration, bias, noise, blur)
    sweep.py re-runs OpenVINS on modified copies of sim_v1 (no re-render, one seed
    per level, 2x playback). An uncalibrated 20 ms camera-IMU offset diverges and
    online time-offset calibration recovers 40 ms to 0.062 m; 5 deg extrinsic
    error gives 0.073 m (0.028 m with online calibration); a 5 m/s^2 foot-strike
    envelope diverges. Noise, blur and 10x bias walk stay at 0.010-0.029 m.
    run.sh takes a config dir and playback rate.
2026-10-12 vio: robot-in-view check (MuJoCo segmentation, 0.00 % over 40 frames)
